Eight4aWish/eurorack_electronics/docs/analogue_board_journal/images/03_bus_chips_level_with_pins_outward.png

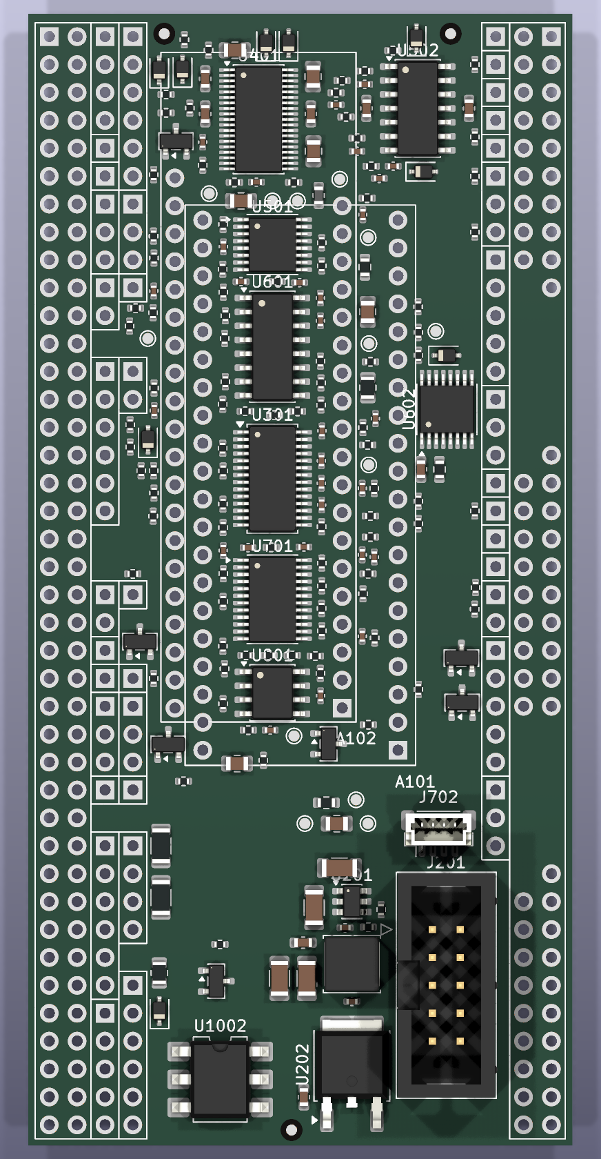
docs/analogue_board_journal/images/03_bus_chips_level_with_pins_outward.png
