Eight4aWish/eurorack_electronics/docs/analogue_board_bringup/holes_outward.png

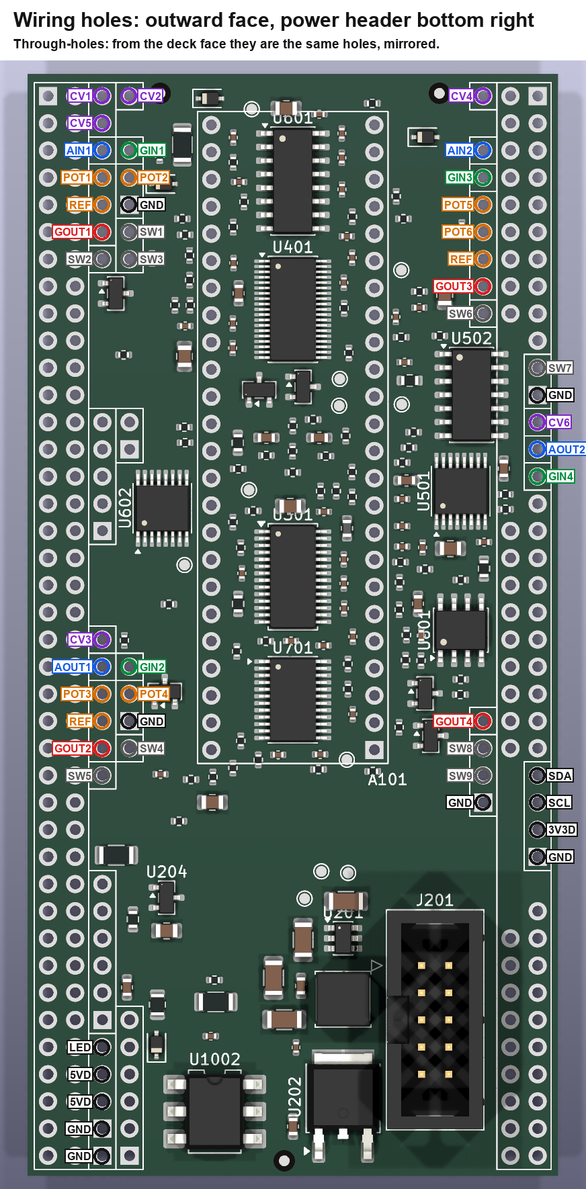
docs/analogue_board_bringup/holes_outward.png
