Eight4aWish/eurorack_electronics/hardware/analogue_board/pico_revb/output/checks.md

# Analogue board Rev B for Pico 2 / ESP32-P4: checkpoint 1 checks

Generated by `tools/analogue_board/build.py pico_revb`. Do not edit by hand.

| Check | Result |
|---|---|
| KiCad ERC | 0 errors, 0 warnings |
| Netlist against the generator's intent | 0 problems (272 nets, 1080 pins) |
| IC pins against datasheets | 0 mismatches in 21 parts |
| Footprint pads against symbol pins | 0 mismatches in 44 symbol/footprint pairs |
| Decoupling on every IC power pin | 0 pins without a capacitor, of 33 |
| Diode orientation | 0 to check, of 23 |
| Components | 361 |

## ERC

No violations.

## Netlist

Every pin KiCad sees is one the generator placed on purpose; every intended net is exactly one KiCad net; no two intended nets touch.

Nets drawn without a label (KiCad names them `Net-(…)`): /CV DAC/CVDAC1_N, /CV DAC/CVDAC2_N, /CV DAC/CVDAC3_N, /CV DAC/CVDAC4_N, /CV DAC/CVDAC5_N, /CV DAC/CVDAC6_N, /CV DAC/CVDAC7_N, /CV DAC/CVDAC7_OUT, /CV jacks & ADC/CV1_SW, /CV jacks & ADC/CV2_SW, /CV jacks & ADC/CV3_SW, /CV jacks & ADC/CV4_SW, /CV jacks & ADC/CV5_SW, /CV jacks & ADC/CV6_SW, /Codec & audio/AIN1_AC, /Codec & audio/AIN1_N, /Codec & audio/AIN1_OUT, /Codec & audio/AIN2_AC, /Codec & audio/AIN2_N, /Codec & audio/AIN2_OUT, /Codec & audio/AOUT1_N, /Codec & audio/AOUT1_NA, /Codec & audio/AOUT1_NB, /Codec & audio/AOUT1_OUT, /Codec & audio/AOUT1_P, /Codec & audio/AOUT2_N, /Codec & audio/AOUT2_NA, /Codec & audio/AOUT2_NB, /Codec & audio/AOUT2_OUT, /Codec & audio/AOUT2_P, /Gate ins/GIN1_CMP, /Gate ins/GIN2_CMP, /Gate ins/GIN3_CMP, /Gate ins/GIN4_CMP, /Power/BOOT, /Power/FB, /Power/FF, /Power/SW, /TRS MIDI/MIDI_DRV, /TRS MIDI/MIDI_LED_A, /TRS MIDI/MIDI_RING_MID, /TRS MIDI/MIDI_RXO, /TRS MIDI/MIDI_TIP_MID, /TRS MIDI/MIDI_TXB.

## IC pins against datasheets

Library pin numbers and names compared with `datasheet_pins.json` (transcribed from each datasheet; sources in `datasheet_pins_README.md`). Renames are pins whose datasheet and library spellings differ but mean the same pin.

| Part | Library symbol | Datasheet entry | Pins | Result | Notes |
|---|---|---|---|---|---|
| PCM3060 | `Audio:PCM3060` | PCM3060PWR | 28 | OK | 27 MS/ADR/IFMD→~{MS}/AD/IFMD |
| ADS8688 | `Analog_ADC:ADS8688` | ADS8688IDBTR | 38 | OK | names match |
| DAC8568 | `analogue_board:DAC8568xPW` | DAC8568IAPWR | 16 | OK | names match |
| MCP3208 | `Analog_ADC:MCP3208` | MCP3208-CI/SL | 16 | OK | names match |
| DG412 | `Analog_Switch:DG412xUE` | DG412DQ-T1-E3 | 16 | OK | unit 1 = switch 1 (pins 2, 1, 3); unit 2 = switch 4 (pins 6, 8, 7); unit 3 = switch 3 (pins 10, 9, 11); unit 4 = switch 2 (pins 15, 16, 14) |
| TL074H | `Amplifier_Operational:TL074` | TL074HIDR | 14 | OK | names match |
| LM393 | `Comparator:LM393` | LM393DR2G | 8 | OK | names match |
| 74HCT595 | `74xx:74HCT595` | 74HCT595PW | 16 | OK | 14 DS→SER; 11 SHCP→SRCLK; 10 MR→~{SRCLR}; 12 STCP→RCLK; 15 Q0→QA; 1 Q1→QB; 2 Q2→QC; 3 Q3→QD; 4 Q4→QE; 5 Q5→QF; 6 Q6→QG; 7 Q7→QH; 9 Q7S→QH' |
| TCA9555 | `Interface_Expansion:TCA9555PWR` | TCA9555PWR | 24 | OK | names match |
| M24C64 | `Memory_EEPROM:M24C01-RMN` | M24C64-RMN6TP | 8 | OK | names match |
| AHCT1G125 | `74xGxx:74AHCT1G125` | SN74AHCT1G125DBVR | 5 | OK | names match |
| XC6206 | `Regulator_Linear:XC6206PxxxMR` | XC6206P332MR | 3 | OK | 3 VIN→VI; 1 VSS→GND; 2 VOUT→VO |
| L78M05 | `Regulator_Linear:LM78M05_TO252` | L78M05ABDT | 3 | OK | 1 INPUT→VI; 3 OUTPUT→VO |
| TPS54308 | `Regulator_Switching:TPS54202DDC` | TPS54308DDCR | 6 | OK | names match |
| BAT54S | `Diode:BAT54S` | BAT54S | 3 | OK | 1 anode (diode 1)→A; 3 cathode (diode 1) / anode (diode 2)→COM; 2 cathode (diode 2)→K |
| BAV99 | `Diode:BAT54S` | BAV99 | 3 | OK | 1 A1→A; 3 K1, A2→COM; 2 K2→K |
| QWIIC | `analogue_board:Qwiic_JST_SH4_Vertical` | SM04B-SRSS-TB | 6 | OK | 1 Circuit No.1→Pin_1; 2 Circuit 2→Pin_2; 3 Circuit 3→Pin_3; 4 Circuit 4→Pin_4 |
| PICO2 | `analogue_board:RaspberryPi_Pico2` | PICO2 | 40 | OK | 36 3V3→3V3_OUT |
| TEENSY41 | `analogue_board:Teensy41` | TEENSY41 | 48 | OK | 2 0→D0; 3 1→D1; 4 2→D2; 5 3→D3; 6 4→D4; 7 5→D5; 8 6→D6; 9 7→D7; 10 8→D8; 11 9→D9; 12 10→D10; 13 11→D11; 14 12→D12; 15 3.3V→3V3; 16 24→D24; 17 25→D25; 18 26→D26; 19 27→D27; 20 28→D28; 21 29→D29; 22 30→D30; 23 31→D31; 24 32→D32; 46 3.3V→3V3; 45 23→D23; 44 22→D22; 43 21→D21; 42 20→D20; 41 19→D19; 40 18→D18; 39 17→D17; 38 16→D16; 37 15→D15; 36 14→D14; 35 13→D13; 33 41→D41; 32 40→D40; 31 39→D39; 30 38→D38; 29 37→D37; 28 36→D36; 27 35→D35; 26 34→D34; 25 33→D33 |
| H11L1 | `Isolator:H11L1` | H11L1M | 6 | OK | names match |
| AO3401A | `Transistor_FET:AO3401A` | AO3401A | 3 | OK | names match |

## Footprint pads

| Symbol | Footprint | Result |
|---|---|---|
| analogue_board:RaspberryPi_Pico2 | analogue_board:Pico2_Socket | 40 pads match |
| Connector_Generic:Conn_01x02 | analogue_board:WiringHoles_1x02_G2 | 2 pads match |
| Connector_Generic:Conn_01x02 | analogue_board:WiringHoles_1x02 | 2 pads match |
| Device:C_Small | Capacitor_SMD:C_1206_3216Metric | 2 pads match |
| Device:C_Small | Capacitor_SMD:C_0603_1608Metric | 2 pads match |
| Device:C_Small | Capacitor_SMD:C_0402_1005Metric | 2 pads match |
| Device:C_Small | Capacitor_SMD:C_0805_2012Metric | 2 pads match |
| Diode:SS34 | Diode_SMD:D_SMA | 2 pads match |
| Device:FerriteBead_Small | Inductor_SMD:L_0603_1608Metric | 2 pads match |
| Connector_Generic:Conn_02x05_Odd_Even | Connector_IDC:IDC-Header_2x05_P2.54mm_Vertical | 10 pads match |
| Jumper:SolderJumper_2_Open | Jumper:SolderJumper-2_P1.3mm_Open_RoundedPad1.0x1.5mm | 2 pads match |
| Device:L_Small | Inductor_SMD:L_Sunlord_SWPA5040S | 2 pads match |
| Transistor_FET:AO3401A | Package_TO_SOT_SMD:SOT-23 | 3 pads match |
| Device:R_Small | Resistor_SMD:R_0603_1608Metric | 2 pads match |
| Device:R_Small | Resistor_SMD:R_0402_1005Metric | 2 pads match |
| Device:R_Small | Resistor_SMD:R_0805_2012Metric | 2 pads match |
| Connector:TestPoint | TestPoint:TestPoint_Pad_D1.0mm | 1 pads match |
| Regulator_Switching:TPS54202DDC | Package_TO_SOT_SMD:SOT-23-6 | 6 pads match |
| Regulator_Linear:LM78M05_TO252 | analogue_board:TO-252-2_PasteShapes | 3 pads match |
| Regulator_Linear:XC6206PxxxMR | Package_TO_SOT_SMD:SOT-23 | 3 pads match |
| Diode:BAT54S | Package_TO_SOT_SMD:SOT-23 | 3 pads match |
| Connector_Generic:Conn_01x01 | analogue_board:WiringHoles_1x01 | 1 pads match |
| Connector_Generic:Conn_01x01 | analogue_board:WiringHoles_1x01_G1 | 1 pads match |
| Device:R_Small | Resistor_SMD:R_1206_3216Metric | 2 pads match |
| Audio:PCM3060 | Package_SO:TSSOP-28_4.4x9.7mm_P0.65mm | 28 pads match |
| Amplifier_Operational:TL074 | Package_SO:SOIC-14_3.9x8.7mm_P1.27mm | 14 pads match |
| Device:D_TVS | Diode_SMD:D_SOD-323 | 2 pads match |
| Analog_ADC:ADS8688 | Package_SO:TSSOP-38_4.4x9.7mm_P0.5mm | 38 pads match |
| Analog_Switch:DG412xUE | Package_SO:TSSOP-16_4.4x5mm_P0.65mm | 16 pads match |
| analogue_board:DAC8568xPW | Package_SO:TSSOP-16_4.4x5mm_P0.65mm | 16 pads match |
| Analog_ADC:MCP3208 | Package_SO:SOIC-16_3.9x9.9mm_P1.27mm | 16 pads match |
| 74xx:74HCT595 | Package_SO:TSSOP-16_4.4x5mm_P0.65mm | 16 pads match |
| Connector_Generic:Conn_01x04 | analogue_board:WiringHoles_1x04_G4 | 4 pads match |
| Connector_Generic:Conn_01x05 | analogue_board:WiringHoles_1x05_G4_5 | 5 pads match |
| Interface_Expansion:TCA9555PWR | Package_SO:TSSOP-24_4.4x7.8mm_P0.65mm | 24 pads match |
| Memory_EEPROM:M24C01-RMN | Package_SO:SOIC-8_3.9x4.9mm_P1.27mm | 8 pads match |
| 74xGxx:74AHCT1G125 | Package_TO_SOT_SMD:SOT-23-5 | 5 pads match |
| Comparator:LM393 | Package_SO:SOIC-8_3.9x4.9mm_P1.27mm | 8 pads match |
| Mechanical:Fiducial | Fiducial:Fiducial_1mm_Mask2mm | 0 pads match |
| analogue_board:EdgeStrip_Left_10HP | analogue_board:EdgeStrip_40_Left_10HP | 57 pads match |
| analogue_board:EdgeStrip_Right | analogue_board:EdgeStrip_40_Right | 57 pads match |
| Diode:1N4148WS | Diode_SMD:D_SOD-323 | 2 pads match |
| Connector_Generic:Conn_01x03 | analogue_board:WiringHoles_1x03 | 3 pads match |
| Isolator:H11L1 | Package_DIP:SMDIP-6_W9.53mm | 6 pads match |

## Decoupling

| Ref | Part | Pin | Net | Capacitors |
|---|---|---|---|---|
| A101 | Raspberry Pi Pico 2 | 39 VSYS | MOD_5V | C222 10u 25V |
| U1001 | SN74AHCT1G125DBVR | 5 VCC | +5VD | C1001 100n 16V |
| U1002 | H11L1SR2M | 6 ~ | +3V3D | C1002 100n 16V |
| U201 | TPS54308DDCR | 3 VIN | /Power/BUCK_VIN | C205 10u 50V, C206 10u 50V, C207 100n 50V |
| U202 | L78M05ABDT-TR | 1 VI | +12V | C214 1u 50V, C215 100n 50V |
| U203 | XC6206P332MR-G | 3 VI | +5VA | C218 1u 25V |
| U204 | XC6206P332MR-G | 3 VI | +5VD | C220 1u 25V |
| U301 | PCM3060PWR | 7 V_{DD} | /Codec & audio/CODEC_VDD | C303 10u 25V, C304 100n 16V |
| U301 | PCM3060PWR | 24 V_{CC} | /Codec & audio/CODEC_VCC | C301 10u 25V, C302 100n 16V |
| U302 | TL074HIDR | 4 V+ | +12V | C319 100n 50V |
| U302 | TL074HIDR | 11 V- | -12V | C320 100n 50V |
| U401 | ADS8688IDBTR | 9 AVDD | +5VA | C401 1u 50V |
| U401 | ADS8688IDBTR | 30 AVDD | +5VA | C402 1u 50V |
| U401 | ADS8688IDBTR | 34 DVDD | +3V3D | C404 10u 25V, C405 100n 16V |
| U402 | DG412DQ-T1-E3 | 13 V+ | +12V | C416 100n 50V |
| U402 | DG412DQ-T1-E3 | 12 VL | +5VD | C418 100n 16V |
| U402 | DG412DQ-T1-E3 | 4 V- | -12V | C417 100n 50V |
| U403 | DG412DQ-T1-E3 | 13 V+ | +12V | C419 100n 50V |
| U403 | DG412DQ-T1-E3 | 12 VL | +5VD | C421 100n 16V |
| U403 | DG412DQ-T1-E3 | 4 V- | -12V | C420 100n 50V |
| U501 | DAC8568IAPWR | 3 AVDD | +3V3A | C501 10u 25V, C502 100n 16V |
| U502 | TL074HIDR | 4 V+ | +12V | C512 100n 50V |
| U502 | TL074HIDR | 11 V- | -12V | C513 100n 50V |
| U504 | TL074HIDR | 4 V+ | +12V | C514 100n 50V |
| U504 | TL074HIDR | 11 V- | -12V | C515 100n 50V |
| U601 | MCP3208-CI/SL | 15 Vref | /Pots & gate outs/POT_REF | C603 10u 25V, C604 100n 16V |
| U601 | MCP3208-CI/SL | 16 Vdd | +3V3A | C601 1u 25V, C602 100n 16V |
| U602 | 74HCT595PW | 16 VCC | +5VD | C611 100n 16V |
| U701 | TCA9555PWR | 24 VCC | +3V3D | C701 100n 16V |
| U702 | M24C64-RMN6TP | 8 VCC | +3V3D | C708 100n 16V |
| U703 | SN74AHCT1G125DBVR | 5 VCC | +5VD | C709 100n 16V |
| U801 | LM393DR2G | 8 V+ | +12V | C801 100n 50V |
| U802 | LM393DR2G | 8 V+ | +12V | C802 100n 50V |

## Diode orientation

| Ref | Part | Pin: net | Rule | Result |
|---|---|---|---|---|
| D1001 | BAT54S | 1: GND, 2: +5VD, 3: Net-(D1001-COM) | BAT54S clamp: anode (1) to GND, cathode (2) to a positive rail, common (3) on the signal | OK |
| D1002 | 1N4148WS | 1: Net-(D1002-K), 2: /TRS MIDI/MI_T | reverse-parallel across the H11L1 LED: cathode on its anode (pin 1), anode on its cathode (pin 2) | OK |
| D201 | SS34 | 1: /Power/+12V_P, 2: /Power/+12V_IN | +12 V reverse-polarity: anode at the header | OK |
| D202 | SS34 | 1: /Power/-12V_IN, 2: /Power/-12V_P | -12 V reverse-polarity: cathode at the header | OK |
| D203 | SS34 | 1: MOD_5V, 2: +5VD | module supply: anode on +5VD, cathode to VSYS/VIN | OK |
| D301 | BAT54S | 1: GND, 2: +5VA, 3: /Codec & audio/VINL | BAT54S clamp: anode (1) to GND, cathode (2) to a positive rail, common (3) on the signal | OK |
| D302 | BAT54S | 1: GND, 2: +5VA, 3: /Codec & audio/VINR | BAT54S clamp: anode (1) to GND, cathode (2) to a positive rail, common (3) on the signal | OK |
| D401 | PESD15VL1BA | 1: GND, 2: /CV jacks & ADC/CV1 | bidirectional TVS: one side on a CV jack, the other on GND | OK |
| D402 | PESD15VL1BA | 1: GND, 2: /CV jacks & ADC/CV2 | bidirectional TVS: one side on a CV jack, the other on GND | OK |
| D403 | PESD15VL1BA | 1: GND, 2: /CV jacks & ADC/CV3 | bidirectional TVS: one side on a CV jack, the other on GND | OK |
| D404 | PESD15VL1BA | 1: GND, 2: /CV jacks & ADC/CV4 | bidirectional TVS: one side on a CV jack, the other on GND | OK |
| D405 | PESD15VL1BA | 1: GND, 2: /CV jacks & ADC/CV5 | bidirectional TVS: one side on a CV jack, the other on GND | OK |
| D406 | PESD15VL1BA | 1: GND, 2: /CV jacks & ADC/CV6 | bidirectional TVS: one side on a CV jack, the other on GND | OK |
| D407 | PESD15VL1BA | 1: GND, 2: /CV jacks & ADC/CVI7 | bidirectional TVS: one side on a CV jack, the other on GND | OK |
| D601 | BAV99 | 1: GND, 2: +5VD, 3: /Pots & gate outs/GOUT1 | BAV99 clamp: anode (1) to GND, cathode (2) to a positive rail, common (3) on the signal | OK |
| D602 | BAV99 | 1: GND, 2: +5VD, 3: /Pots & gate outs/GOUT2 | BAV99 clamp: anode (1) to GND, cathode (2) to a positive rail, common (3) on the signal | OK |
| D603 | BAV99 | 1: GND, 2: +5VD, 3: /Pots & gate outs/GOUT3 | BAV99 clamp: anode (1) to GND, cathode (2) to a positive rail, common (3) on the signal | OK |
| D604 | BAV99 | 1: GND, 2: +5VD, 3: /Pots & gate outs/GOUT4 | BAV99 clamp: anode (1) to GND, cathode (2) to a positive rail, common (3) on the signal | OK |
| D801 | BAT54S | 1: GND, 2: +3V3D, 3: Net-(D801-COM) | BAT54S clamp: anode (1) to GND, cathode (2) to a positive rail, common (3) on the signal | OK |
| D802 | BAT54S | 1: GND, 2: +3V3D, 3: Net-(D802-COM) | BAT54S clamp: anode (1) to GND, cathode (2) to a positive rail, common (3) on the signal | OK |
| D803 | BAT54S | 1: GND, 2: +3V3D, 3: Net-(D803-COM) | BAT54S clamp: anode (1) to GND, cathode (2) to a positive rail, common (3) on the signal | OK |
| D804 | BAT54S | 1: GND, 2: +3V3D, 3: Net-(D804-COM) | BAT54S clamp: anode (1) to GND, cathode (2) to a positive rail, common (3) on the signal | OK |
| Q201 | AO3401A | 1: PICO_VBUS, 2: MOD_5V, 3: +5VD | MOD_5V bypass: drain on +5VD, source on MOD_5V, gate on PICO_VBUS (body diode +5VD → MOD_5V) | OK |
