Eight4aWish/eurorack_electronics/docs/n8synth_platform.md

# n8synth Platform — Verified Reference

**The single source of truth for how the n8synth solderable breadboard and control decks
actually work.** Every claim below carries its evidence. Nothing here may be "re-derived" from
the `.n8layout` templates or the generated board profiles — those are *downstream* of this
document, and where they disagree, this document wins.

**Why this exists:** the row-count question was got wrong three times in a row by reasoning from
template geometry. The templates describe a *drawing*, not the electrical reality, and the
generated profiles hardcode assumptions that were never verified. See "Provenance" at the foot.

---

## Anatomy of a board, outside in

Working inward from either edge:

| # | Feature | Positions | Electrical behaviour |
|---|---|---|---|
| 1 | **Edge connector** | 1–40 | Two adjacent columns of holes. **Each position is a doublet — the two holes are joined to each other**, and to nothing else. |
| 2 | **Power rail** | 1–40 | Single column. **Odd = GND, even = supply.** |
| 3 | **Main area** | see variants | 5 columns. The 5 holes in a row are joined. |

**The left and right main areas are NOT joined to each other.** A row is really two independent
5-hole nodes with a gap between them.

**Power rail polarity:** numbering rows top to bottom, position 1 is GND and position 2 is
**+12V on the left-hand column** and **−12V on the corresponding right-hand column**. So:

- `pwrL` — odd = GND, even = **+12V**
- `pwrR` — odd = GND, even = **−12V**

---

## Two board variants

| | Main-area rows | Power conditioning |
|---|---|---|
| **With power section** | **1–36**, 5 columns left + 5 columns right | Yes |
| **Without** | **1–40**, 5 columns left + 5 columns right | No |

**The power conditioning is 100nF + 10µF-or-larger on each rail.**

- The **100nF caps consume no positions** — they take nothing away from anything described above.
- The **10µF+ electrolytics occupy power-rail positions 37 and 38.**
- **Power-rail positions 39 and 40 remain free**, as do 1 and 2.

⚠️ The 4HP, 6HP and 10HP templates all model the **powered** variant (36 main-area rows). The
10HPS template ships two boards — one powered (36 rows) and one plain (40 rows) — which is why
it contains 76 row zones.

## What the board already provides — do not duplicate it

On a **powered** board the ±12V rails arrive already conditioned: **100nF + 10µF-or-larger on
each rail**. Any module design transcribed from a standalone Eurorack PCB will carry its *own*
rail-entry conditioning, which is then duplicated.

**Drop on transfer:**

- **Rail-entry bulk electrolytics** (typically 47µF or 10µF on VCC and VEE). The board's own
  10µF+ at power-rail positions 37–38 does this job.
- **Rail-entry 100nF bypass**, where the design has one per rail *at the power connector*.

**Never drop:**

- **Per-IC decoupling** — the 100nF sitting at each op-amp's pin 8 / pin 4. The board's single
  bypass at the power entry is not a substitute, and on a breadboard, where wiring inductance is
  far worse than on a PCB, local decoupling matters **more**, not less.
- **Reverse-polarity protection diodes.** The board provides capacitors only — no protection.
- **Series rail filtering** (a small series resistor on each rail), which is a
  different function and doubles as a slow-blow fuse.
- **Regulator conditioning** for anything generated on-board (e.g. a 7805's own input/output
  caps), and decoupling on rails the board does not supply.

⚠️ If a bench test later shows ripple on a long run, adding one bulk cap back near the ICs is a
two-second job on a breadboard. Removing is the low-risk direction.

### Applied to the current dataset

| Build | Duplicated — droppable | Keep |
|---|---|---|
| **MOD2** | C5, C6 (10µF rail bulk) | C7–C10 are per-IC, one per TL072 per rail |
| Dual LPG | C1, C2 (47µF rail bulk) | C3–C10 — already annotated "near IC pin 8/4" |

Only MOD2 has been changed. Apply the same reading to any other design when transferring it:
drop the rail-entry bulk and any entry-point bypass, keep everything per-IC, keep protection
diodes, and keep any series rail filtering.

---

## Naming the two holes of a doublet

Each edge-connector position has **two holes, joined to each other and to nothing else**. Both
are usable, and using both is normal — typically a wire from the panel in one and a component
leg in the other, which is how a panel signal reaches the circuit.

**Convention:**

| Name | Meaning |
|---|---|
| `ctrlLo5` | left edge connector, position 5, **outer** hole (nearer the board edge) |
| `ctrlLi5` | left edge connector, position 5, **inner** hole (nearer the power rail) |
| `ctrlRo5` / `ctrlRi5` | the same for the right edge connector |
| `ctrlL5` / `ctrlR5` | the position, **hole unspecified** — use when it does not matter |

Outer and inner are defined geometrically, so they mean the same thing on either edge
regardless of orientation.

**Two occupants at one position is correct, not a collision.** A collision is two things in the
*same hole*. Any checker must key on the hole, not the position — otherwise every panel
connection that feeds a component looks like an error.

In the dual LPG as documented, **16 of its 32 occupied control-lane positions carry two
things** — a `jpsWire` from the panel plus a component leg — and the rest carry one, leaving a
spare hole that is available for routing.

### Which column does what ✓

| Column | Use |
|---|---|
| **Outer** | **Control deck → first circuit board.** The main deck connection. |
| **Inner** | Smaller headers jumping to a **second circuit board stacked over the first**. |

**A spare doublet has no deck connection at all.** Only positions where a JPS cell terminates
are wired to the control deck. Every other position is an **electrically isolated pair of joined
holes** — nothing else. Using one to jump a signal across or under the board gives you a **tie
point, not a deck connection**.

That is what makes them safe to repurpose, and it is also a rule for any checker: **do not
assume a control-lane position carries a panel net.** Claimed positions do; spare ones carry
only whatever the things plugged into them make. How many are spare depends on the deck's HP —
a 6HP deck claims 36 of 40 positions, a 4HP deck only 18, leaving 22 free.

**Consequence for a single-board module: the inner column is free.** That is the spare capacity
behind the repurposing technique — jump a component leg into an inner hole and route a wire up
or down the board on the back, where both columns are tinned.

So on a single-board build, a control-lane position typically holds the deck connection in its
**outer** hole and, where used, a component leg in its **inner** hole.

---

## Which edge connector to use

**4HP and 6HP designs use one edge connector — by convention the LEFT.** Either edge works, but
**not both**. 10HP designs use both.

---

## Stacking, and how signals actually get between boards

Stacking is for designs that outgrow a single board — in practice 10HP modules.

**Signals can pass between stacked boards** via dedicated stacking connectors. However, those
connectors are **awkward to work with in practice**.

**The technique actually used:** fit **1-to-6-way pin headers on the inside of the connector
rails** and jump the signals along the chain — control deck → first board → second board. The
edge connector is a doublet, so the inner hole of each position is available for exactly this
while the outer hole carries the deck connection.

Power between stacked boards is jumped separately, using power-rail positions 1, 2, 39 and 40.

---

### Positions 1, 2, 39, 40 on the power columns

These are reserved *only* for **jumping power between stacked boards** — needed when a design
outgrows one board (e.g. two stacked 10HP circuit boards).

**For a single-board module they are free to use.** Position 39 (GND) is particularly useful for
grounding something near the bottom of the board.

---

## How control decks connect

**JPS cell pads A, B and C terminate on the outermost columns — the edge connector.** They do
**not** land on main-area rows.

This is the point most easily got wrong. A JPS cell occupies *connector positions*, not
tie-point rows. Getting a panel component's signal into the circuit means running a wire from
its edge-connector doublet to wherever you want it in the main area.

Consequences:

- **Edge positions 37–40 are perfectly usable on a powered board**, even though there is no
  main-area row at 37–40. They are edge-connector doublets like any other. On a powered board
  they sit conveniently close to free power-rail positions 39 and 40.
- Narrow modules use **one** edge connector; **10HP uses both**.
- **Unused edge-connector doublets are free tie points and can be repurposed.** Depending on the
  control deck's HP, a greater or lesser number of them connect to nothing. Jump a component
  leg into one and route a wire up or down the board — routinely used to keep a build tidy.

### Deck pads

- **Two contact points per A, B and C pad.**
- **Every cell also has a D pad, and all D pads across the deck are joined** — a deck-wide
  ground bus.
- **Grounding practice:** tie all the jack grounds to D, then run **one** wire from any grounded
  position back to ground. Any ground will do. Picking one toward the middle of the board leaves
  power-rail position 39 free for grounding something toward the bottom.

---

## What the generated board profiles get wrong

`tools/visualizer/boards/*.json` is produced by `gen_board_profiles.py`, which hardcodes several
values. Against this document:

| Profile field | Status |
|---|---|
| `rows: 40` | ❌ **Wrong.** Conflates three different things. Powered boards have **36 main-area rows**; edge connector and power rail have **40 positions**. |
| `layoutRows: [1, 36]` | ✅ Correct for powered boards — but the name hides that it means *main-area rows only*. |
| `powerSectionRows: [37, 40]` | ❌ **Misleading.** Power-rail 37–38 hold the electrolytics; **39–40 are free**. Edge positions 37–40 are fully usable. |
| `rails` parity and polarity | ✅ **Correct.** |
| `holeCols` a–j, `centreGap` e/f | ✅ Correct — but must also record that left and right are not joined. |
| `padsPerCell {A:2, B:2, C:2, D:1}` | ✅ Correct. |
| edge connector is a **doublet** | ❌ **Missing entirely.** |
| unused doublets are repurposable | ❌ **Missing entirely.** |
| board variant (powered vs plain) | ❌ **Missing entirely.** |

---

## Provenance

**Primary source: the builder (David), 2026-08-28**, describing the physical boards in hand.
This supersedes anything inferred from the `.n8layout` templates.

Independently corroborated where possible:

- Edge connector as two joined columns — `left-edge-conn` in `6HP_Template.n8layout` has two
  hole columns (x = 0.15, 2.69) and each `ec-pad-N` carries two holes per connector ✓
- Rail parity — template zones are named `pr-neg-{odd}` / `pr-pos-{even}`; the n8synth overview
  diagram states *"compact power rails with alternating supply and GND connections"* and its
  colour key marks the left rail +12V, right rail −12V ✓
- 36 vs 40 rows — the overview diagram shows "Bread & Butter A1" numbered 1–36 with a power
  section, and "Bread & Butter B1" numbered 1–40 without ✓
- Main area 5 + 5 with a gap — each `row-N` group holds 10 holes at 2.54mm pitch with a 7.62mm
  gap between the 5th and 6th ✓
- Deck D bus — 6HP quick-start guide: *"the D bus … a common ground on the Control Deck"* ✓
- Cell numbering row-major, odd left / even right — annotated control-deck diagram ✓

**Unverified, still open:**

- Whether a stacked board is conventionally mounted flipped (left/right swapped) so components
  face outward for probing. `gen_board_profiles.py` asserts this; not re-checked here.
