Eight4aWish/eurorack_electronics/docs/analogue_board_review/power.md

# Power block review: analogue board Rev A, checkpoint 1

Reviewed 2026-10-15 against `tools/analogue_board/design.py` (`sheet_power`), `parts.py`, the
generated netlist `hardware/analogue_board/output/analogue_board.net`, schematic page 2, and
spec §2, §4, §5, §8–§10, §15.

**Marks:** **[unverified]** = not confirmed against a primary source in this review.
**[est.]** = my own arithmetic from datasheet figures. **[sub-agent]** = values read from the
file by a sub-agent and not re-read by me; spot checks are noted where I did them.

**Verdict:** the block is sound. Nothing found would stop a board working on the first power-up
with a Pico 2 or Teensy 4.1, so there are **no A findings**. Five B changes are worth making
before the order. All five use Basic parts, add no Extended fee, and cost under $0.50 a board:
1. Give the buck its own ferrite and input capacitance.
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
