Eight4aWish/eurorack_electronics/docs/schematics/phase1_channel.png

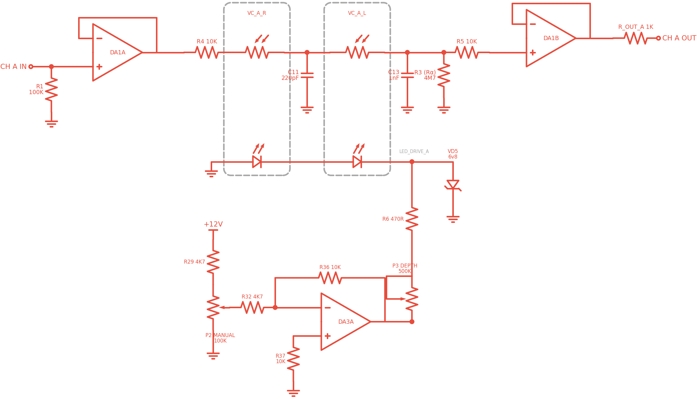
docs/schematics/phase1_channel.png
