Eight4aWish/eurorack_electronics/docs/schematics/phase2_channel.png

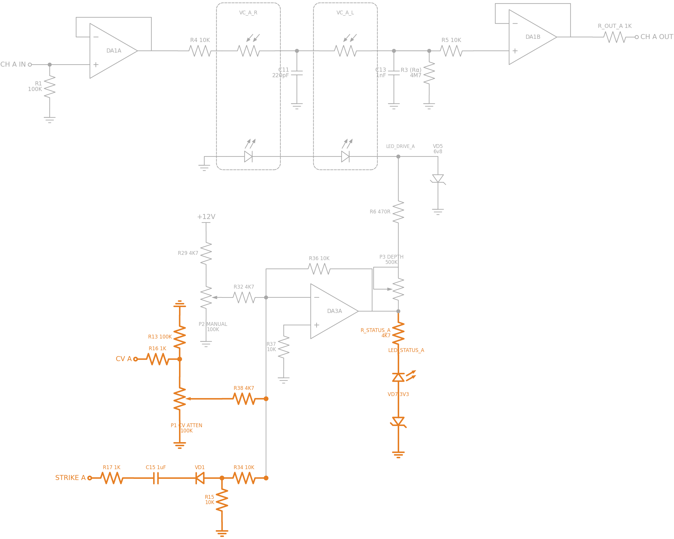
docs/schematics/phase2_channel.png
