Eight4aWish/eurorack_electronics/docs/schematics/phase5_mix.png

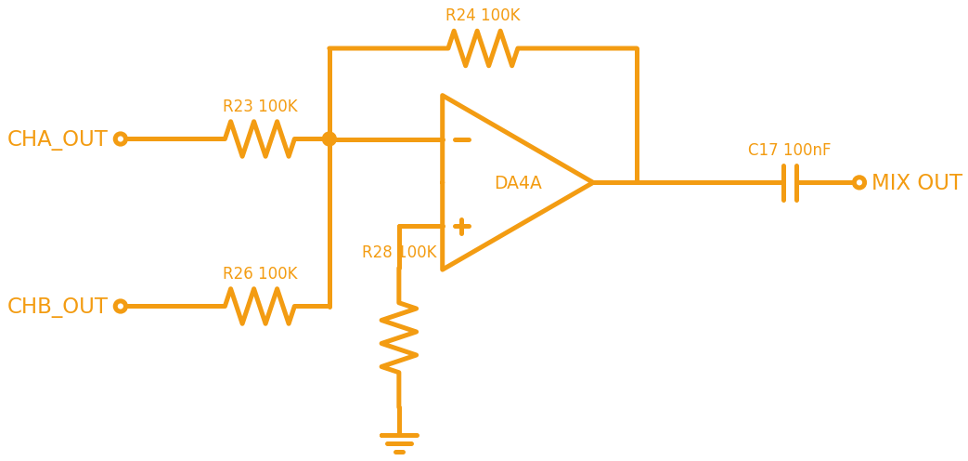
docs/schematics/phase5_mix.png
