Eight4aWish/eurorack_electronics/hardware/analogue_board/pico_core_midi/routed_trial/routed_deck_face.png

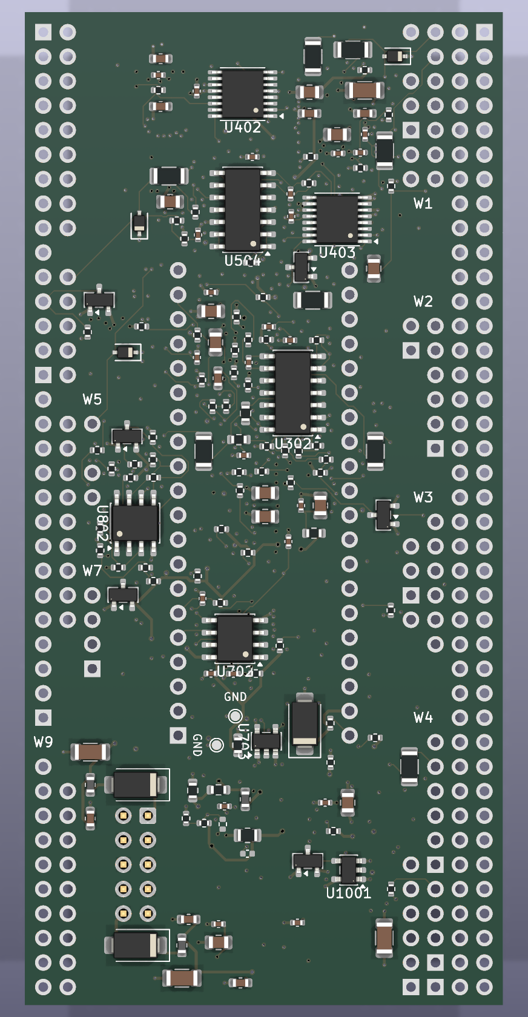
hardware/analogue_board/pico_core_midi/routed_trial/routed_deck_face.png
