Eight4aWish/eurorack_electronics/hardware/analogue_board/pico_revb/output/placement_outward_face.png

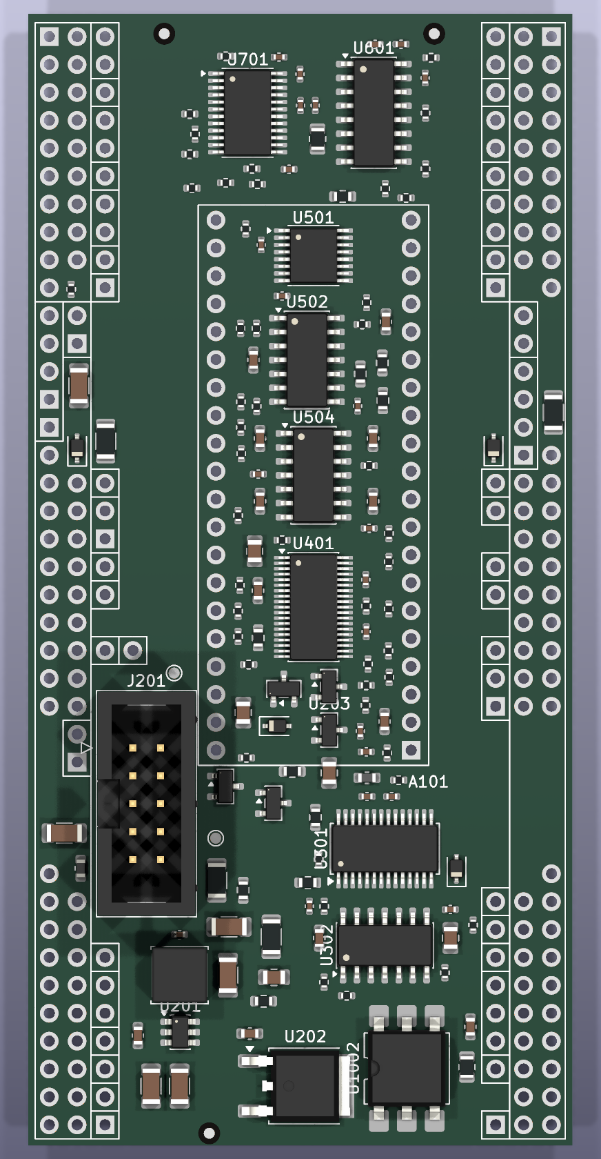
hardware/analogue_board/pico_revb/output/placement_outward_face.png
