Eight4aWish/eurorack_electronics/hardware/analogue_board/shared_core/routed_trial/routed_deck_face.png

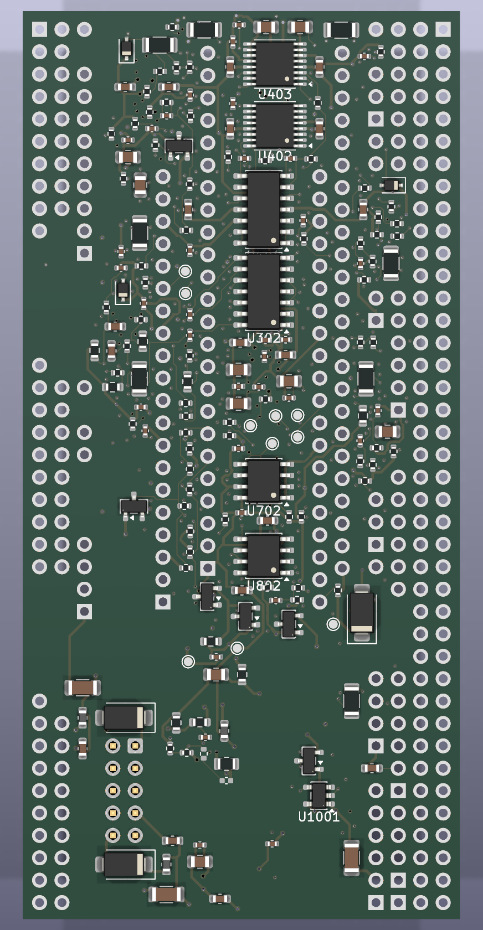
hardware/analogue_board/shared_core/routed_trial/routed_deck_face.png
