Eight4aWish/eurorack_electronics/hardware/analogue_board/output/analogue_board_bom.csv

Refs | Value | Footprint | LCSC | MPN | JLC | Qty
A101 | Raspberry Pi Pico 2 | analogue_board:Pico2_Socket |  | SC1631 on 2x20 female headers | hand-soldered | 1
A102 | Teensy 4.1 | analogue_board:Teensy41_Socket |  | PJRC Teensy 4.1 on 2x24 female headers | hand-soldered | 1
C201,C203,C205,C206 | 10u 50V | Capacitor_SMD:C_1206_3216Metric | C13585 |  | Basic | 4
C202,C204,C207,C215,C319,C320,C417,C418,C420,C421,C513-C518,C801,C802,C1003 | 100n 50V | Capacitor_SMD:C_0603_1608Metric | C14663 |  | Basic | 19
C208,C212,C217,C302,C304,C306,C309,C312,C405,C419,C422,C502,C602,C604-C613,C701-C705,C710-C712,C803,C1001,C1002 | 100n 16V | Capacitor_SMD:C_0402_1005Metric | C1525 |  | Basic | 34
C210,C211,C407 | 22u 25V | Capacitor_SMD:C_1206_3216Metric | C12891 |  | Basic | 3
C213,C216,C219,C221,C222,C301,C303,C305,C403,C404,C408,C501,C603 | 10u 25V | Capacitor_SMD:C_0805_2012Metric | C15850 |  | Basic | 13
C214,C401,C402,C406 | 1u 50V | Capacitor_SMD:C_0603_1608Metric | C15849 |  | Basic | 4
C218,C220,C503,C601 | 1u 25V | Capacitor_SMD:C_0402_1005Metric | C52923 |  | Basic | 4
C307,C310,C313,C314,C316,C317,C505-C512 | 100p 50V | Capacitor_SMD:C_0402_1005Metric | C1546 |  | Basic | 14
C308,C311 | 1u 50V | Capacitor_SMD:C_0805_2012Metric | C28323 |  | Basic | 2
C315,C318 | 1n C0G 50V | Capacitor_SMD:C_0603_1608Metric | C106246 |  | Extended | 2
C409-C416,C504 | 1n 50V | Capacitor_SMD:C_0402_1005Metric | C1523 |  | Basic | 9
C706-C709 | 10n 50V | Capacitor_SMD:C_0402_1005Metric | C15195 |  | Basic | 4
C713 | 47u 10V | Capacitor_SMD:C_1206_3216Metric | C96123 |  | Basic | 1
D201-D203 | SS34 | Diode_SMD:D_SMA | C8678 | SS34 | Basic | 3
D301,D302,D801-D805,D1001 | BAT54S | Package_TO_SOT_SMD:SOT-23 | C408389 | BAT54S | Extended | 8
D401-D408 | PESD15VL1BA | Diode_SMD:D_SOD-323 | C85378 | PESD15VL1BA,115 | Extended | 8
D601-D608 | BAV99 | Package_TO_SOT_SMD:SOT-23 | C2500 | BAV99,215 | Basic | 8
D1002 | 1N4148WS | Diode_SMD:D_SOD-323 | C2128 | 1N4148WS | Basic | 1
FB201-FB203,FB301 | BLM18PG121 | Inductor_SMD:L_0603_1608Metric | C14709 | BLM18PG121SN1D | Basic | 4
J201 | Eurorack power 2x5 shrouded | Connector_IDC:IDC-Header_2x05_P2.54mm_Vertical |  | 2x5 2.54 mm shrouded box header | hand-soldered | 1
J702 | Qwiic BM04B-SRSS-TB | Connector_JST:JST_SH_BM04B-SRSS-TB_1x04-1MP_P1.00mm_Vertical | C160390 | BM04B-SRSS-TB(LF)(SN) | Extended | 1
L201 | 15uH | Inductor_SMD:L_Sunlord_SWPA5040S | C44888 | SWPA5040S150MT | Extended | 1
Q201 | AO3401A | Package_TO_SOT_SMD:SOT-23 | C15127 | AO3401A | Basic | 1
R201 | 510k | Resistor_SMD:R_0603_1608Metric | C23192 |  | Basic | 1
R202 | 75k | Resistor_SMD:R_0603_1608Metric | C23242 |  | Basic | 1
R203,R307,R311 | 15k | Resistor_SMD:R_0402_1005Metric | C25756 |  | Basic | 3
R204 | 2k | Resistor_SMD:R_0402_1005Metric | C4109 |  | Basic | 1
R206 | 0R | Resistor_SMD:R_0805_2012Metric | C17477 |  | Basic | 1
R207-R209 | 0R | Resistor_SMD:R_0603_1608Metric | C21189 |  | Basic | 3
R210 | 680R | Resistor_SMD:R_0603_1608Metric | C23228 |  | Basic | 1
R211,R309,R313,R604,R606,R608,R610,R612,R614,R616,R618 | 1M | Resistor_SMD:R_0402_1005Metric | C26083 |  | Basic | 11
R212,R308,R312,R405,R409,R413,R417,R421,R425,R429,R431,R802,R803,R806,R807,R810,R811,R814,R815,R820-R829 | 100k | Resistor_SMD:R_0402_1005Metric | C25741 |  | Basic | 29
R301-R303,R401-R403,R501,R504,R506,R508,R510,R512,R514,R516,R519,R602,R619,R620,R701,R703,R705,R707,R709,R711,R713,R715,R717,R719,R801,R804,R805,R808,R809,R812,R813,R816-R818,R1002 | 10k | Resistor_SMD:R_0402_1005Metric | C25744 |  | Basic | 39
R304 | 5.1R | Resistor_SMD:R_0603_1608Metric | C25197 |  | Basic | 1
R305,R310,R314,R317,R318,R324,R325,R404,R408,R412,R416,R420,R424,R428,R430,R603,R605,R607,R609,R611,R613,R615,R617,R621-R628,R702,R704,R706,R708,R710,R712,R714,R716,R718,R819,R1001,R1008,R1009 | 1k | Resistor_SMD:R_0402_1005Metric | C11702 |  | Basic | 44
R306 | 220k | Resistor_SMD:R_0603_1608Metric | C22961 |  | Basic | 1
R315,R316,R322,R323,R502 | 12k | Resistor_SMD:R_0402_1005Metric | C25752 |  | Basic | 5
R319,R320,R326,R327 | 30k | Resistor_SMD:R_0603_1608Metric | C22984 |  | Basic | 4
R321,R328,R406,R410,R414,R418,R422,R426,R517,R520 | 1k | Resistor_SMD:R_1206_3216Metric | C4410 |  | Basic | 10
R407,R411,R415,R419,R423,R427 | 4.7k | Resistor_SMD:R_0402_1005Metric | C25900 |  | Basic | 6
R503,R830-R833 | 22k | Resistor_SMD:R_0402_1005Metric | C25768 |  | Basic | 5
R505,R507,R509,R511,R513,R515,R518,R521 | 33k | Resistor_SMD:R_0402_1005Metric | C25779 |  | Basic | 8
R601 | 100R | Resistor_SMD:R_0805_2012Metric | C17408 |  | Basic | 1
R720,R721 | 2.2k | Resistor_SMD:R_0402_1005Metric | C25879 |  | Basic | 2
R722 | 330R | Resistor_SMD:R_0402_1005Metric | C25104 |  | Basic | 1
R1003-R1006 | 100R | Resistor_SMD:R_1206_3216Metric | C17901 |  | Basic | 4
R1007 | 220R | Resistor_SMD:R_0805_2012Metric | C17557 |  | Basic | 1
U201 | TPS54308DDCR | Package_TO_SOT_SMD:SOT-23-6 | C168839 | TPS54308DDCR | Extended | 1
U202 | L78M05ABDT-TR | Package_TO_SOT_SMD:TO-252-2 | C58069 | L78M05ABDT-TR | Basic | 1
U203,U204 | XC6206P332MR-G | Package_TO_SOT_SMD:SOT-23 | C5446 | XC6206P332MR-G | Basic | 2
U301 | PCM3060PWR | Package_SO:TSSOP-28_4.4x9.7mm_P0.65mm | C2651841 | PCM3060PWR | Extended | 1
U302,U502-U504 | TL074HIDR | Package_SO:SOIC-14_3.9x8.7mm_P1.27mm | C2878713 | TL074HIDR | Extended | 4
U401 | ADS8688IDBTR | Package_SO:TSSOP-38_4.4x9.7mm_P0.5mm | C527390 | ADS8688IDBTR | Extended | 1
U402,U403 | DG412DQ-T1-E3 | Package_SO:TSSOP-16_4.4x5mm_P0.65mm | C2651920 | DG412DQ-T1-E3 | Extended | 2
U501 | DAC8568IAPWR | Package_SO:TSSOP-16_4.4x5mm_P0.65mm | C486051 | DAC8568IAPWR | Extended | 1
U601 | MCP3208-CI/SL | Package_SO:SOIC-16_3.9x9.9mm_P1.27mm | C16939 | MCP3208-CI/SL | Extended | 1
U602 | 74HCT595PW | Package_SO:TSSOP-16_4.4x5mm_P0.65mm | C99710 | 74HCT595PW,118 | Extended | 1
U701 | TCA9555PWR | Package_SO:TSSOP-24_4.4x7.8mm_P0.65mm | C465732 | TCA9555PWR | Extended | 1
U702 | M24C64-RMN6TP | Package_SO:SOIC-8_3.9x4.9mm_P1.27mm | C79988 | M24C64-RMN6TP | Extended (Preferred) | 1
U703,U1001 | SN74AHCT1G125DBVR | Package_TO_SOT_SMD:SOT-23-5 | C7484 | SN74AHCT1G125DBVR | Extended | 2
U801,U802 | LM393DR2G | Package_SO:SOIC-8_3.9x4.9mm_P1.27mm | C7955 | LM393DR2G | Basic | 2
U1002 | H11L1SR2M | Package_DIP:SMDIP-6_W7.62mm | C20082 | H11L1SR2M | Extended | 1
