Eight4aWish/eurorack_electronics/hardware/analogue_board/pico_revb/output/wiring_map.md

# Wiring map: Pico 2 / ESP32-P4

Generated by `tools/analogue_board/labels.py`. Each block's label (W1, W2 ...) is on the
board's silkscreen beside the block. Holes count in reading order: row by row from the
top, left column first. Ground holes are square. Rows are the edge strip positions.

## W1: rows 1-10, left side (label on the deck and outward faces)

| Hole | Column | Row | Signal |
|---|---|---|---|
| 1 | LO | 1 | POT_REF |
| 2 | LO | 2 | POT3 |
| 3 | LO | 3 | SW3 |
| 4 | LO | 4 | POT_REF |
| 5 | LO | 5 | POT5 |
| 6 | LO | 6 | SW5 |
| 7 | LO | 7 | POT_REF |
| 8 | LO | 8 | POT6 |
| 9 | LO | 9 | SW6 |
| 10 | LO | 10 | GND |

## W2: rows 17-21, left side (label on the deck and outward faces)

| Hole | Column | Row | Signal |
|---|---|---|---|
| 1 | LO | 17 | CV4 |
| 2 | LO | 18 | GOUT1 |
| 3 | LO | 19 | GND |
| 4 | LO | 20 | CV5 |
| 5 | LO | 21 | GOUT2 |

## W3: rows 23-23, left side (label on the deck and outward faces)

| Hole | Column | Row | Signal |
|---|---|---|---|
| 1 | LO | 23 | CV6 |
| 2 | LI | 23 | GOUT3 |

## W4: rows 34-40, left side (label on the deck and outward faces)

| Hole | Column | Row | Signal |
|---|---|---|---|
| 1 | LO | 34 | AOUT1 |
| 2 | LO | 35 | J1001.1 |
| 3 | LO | 36 | J1001.2 |
| 4 | LO | 37 | GOUT4 |
| 5 | LO | 38 | AOUT2 |
| 6 | LO | 39 | CVO7 |
| 7 | LO | 40 | GND |

## W5: rows 11-15, left strip (label on the deck and outward faces)

| Hole | Column | Row | Signal |
|---|---|---|---|
| 1 | LS | 11 | J704.1 |
| 2 | LSI | 11 | J303.1 |
| 3 | LS | 12 | J704.2 |
| 4 | LSI | 12 | J303.2 |
| 5 | LS | 13 | J704.3 |
| 6 | LS | 14 | J704.4 |
| 7 | LS | 15 | J704.5 |

## W6: rows 26-27, left strip (label on the deck and outward faces)

| Hole | Column | Row | Signal |
|---|---|---|---|
| 1 | LSI | 26 | J101.1 |
| 2 | LSI | 27 | J101.2 |

## W7: rows 1-10, right side (label on the deck and outward faces)

| Hole | Column | Row | Signal |
|---|---|---|---|
| 1 | R | 1 | POT_REF |
| 2 | R | 2 | POT1 |
| 3 | R | 3 | SW1 |
| 4 | R | 4 | POT_REF |
| 5 | R | 5 | POT2 |
| 6 | R | 6 | SW2 |
| 7 | R | 7 | POT_REF |
| 8 | R | 8 | POT4 |
| 9 | R | 9 | SW4 |
| 10 | R | 10 | GND |

## W8: rows 17-18, right side (label on the deck and outward faces)

| Hole | Column | Row | Signal |
|---|---|---|---|
| 1 | R | 17 | CV1 |
| 2 | R | 18 | GIN1 |

## W9: rows 20-21, right side (label on the deck and outward faces)

| Hole | Column | Row | Signal |
|---|---|---|---|
| 1 | R | 20 | CV2 |
| 2 | R | 21 | GIN2 |

## W10: rows 23-25, right side (label on the deck and outward faces)

| Hole | Column | Row | Signal |
|---|---|---|---|
| 1 | R | 23 | CV3 |
| 2 | R | 24 | GIN3 |
| 3 | R | 25 | GND |

## W11: rows 32-38, right side (label on the deck and outward faces)

| Hole | Column | Row | Signal |
|---|---|---|---|
| 1 | R | 32 | AIN1 |
| 2 | R | 33 | GIN4 |
| 3 | R | 34 | CVI7 |
| 4 | R | 35 | J1002.1 |
| 5 | R | 36 | J1002.2 |
| 6 | R | 37 | J1002.3 |
| 7 | R | 38 | AIN2 |

## W12: rows 40-40, right side (no room for a label)

| Hole | Column | Row | Signal |
|---|---|---|---|
| 1 | R | 40 | GND |

## W13: rows 11-16, right strip (label on the deck and outward faces)

| Hole | Column | Row | Signal |
|---|---|---|---|
| 1 | RSI | 11 | J102.1 |
| 2 | RSI | 12 | J102.2 |
| 3 | RSI | 13 | J703.1 |
| 4 | RSI | 14 | J703.2 |
| 5 | RSI | 15 | J703.3 |
| 6 | RSI | 16 | J703.4 |

## Test points

| Test point | Signal | Face | x, y (mm from the top left) | Labelled |
|---|---|---|---|---|
| TP201 | +12V | deck | 1.9, 73.8 | yes |
| TP202 | -12V | outward | 17.1, 75.1 | yes |
| TP205 | +5VD | deck | 22.0, 84.5 | yes |
| TP206 | +5VA | deck | 24.9, 81.9 | yes |
| TP207 | +3V3A | deck | 26.3, 16.3 | yes |
| TP208 | +3V3D | deck | 23.2, 93.3 | yes |
| TP209 | MOD_5V | outward | 13.3, 60.0 | yes |

Board marking (ANALOGUE BOARD REV B / EIGHT4AWISH / CC BY-SA 4.0): outward face, 1 line, turned, centred 38.8, 53.7 mm from the top left.
