Eight4aWish/eurorack_electronics/hardware/analogue_board/boards_printout.pdf

## Rev A: two boards, one module each, to lay real parts on

Outward face, seen from above. Each module is centred on its board; header and edge strips are the same on both.

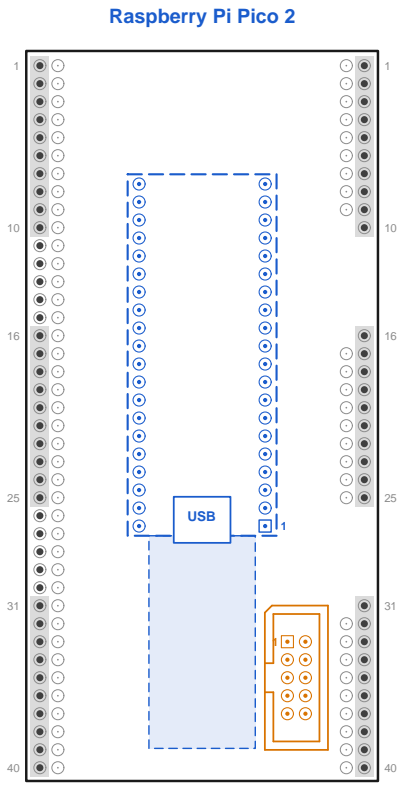
[picture p14: figure]
Raspberry Pi Pico 2; USB

Body 21 x 51 mm, far end 17.4 mm down (room for the P4).
USB edge at 68.4 mm; keep-out to 98.4 mm.

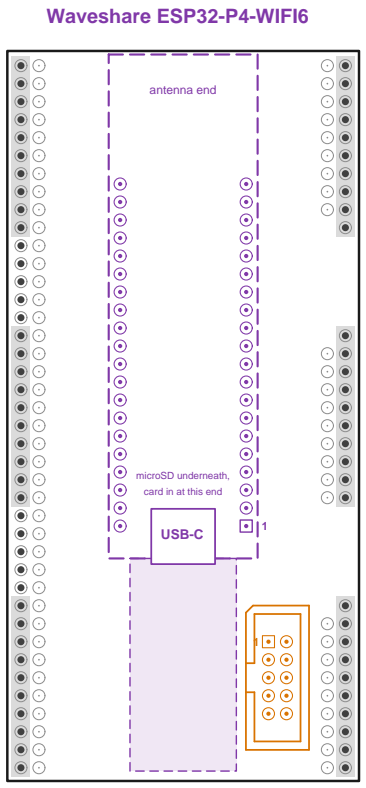
[picture p15: figure]
Waveshare ESP32-P4-WIFI6; USB-C; antenna end; microSD underneath, card in at this end

Body 21 x 71 mm in the Pico's holes. Far (antenna) end 0.5 mm from the top edge. USB-C edge at 71.6 mm; keep-out to 101.6 mm.
USB-C is serial only (CH343). Bridge JP201 when fitted.

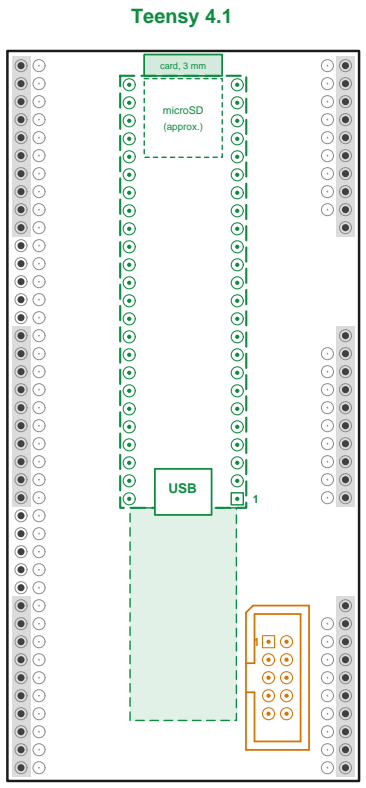
[picture p16: figure]
Teensy 4.1; USB; microSD (approx.); card, 3 mm

Body 17.8 x 61 mm, far end 3.5 mm down, so a microSD card (3 mm) ends 0.5 mm from the top edge. USB edge at 64.5 mm; keep-out to 94.5 mm.
All 48 holes: full-length headers. Centred: 3.8 mm right of the checkpoint 2 print.
Cut the VIN-VUSB pads first.

Laying the parts
- Face up, USB end down, pin 1 (the square hole) at the USB end. The pins should sit on the dots.
- The keep-out is where the plug goes when the module is up on its headers; anything in it taller than about 8 mm stops the plug. Try your real cables: a right-angle plug may need less room.
- The P4's microSD card goes in at the USB end, under the board, and is meant to stay in.
- Edge-strip numbers are on the left-hand board; the grey bands are the deck cells.
- The Pico 2 and the ESP32-P4 share one board (the first two outlines); the Teensy has its own.
0 | 50 | 100

This bar must measure 100 mm. If not, reprint at 100% / Actual size, with fit-to-page and scaling turned off.

Analogue boards Rev A. Generated by tools/analogue_board/printout.py from the KiCad footprints. Eight4aWish, CC BY-SA 4.0. Page 1 of 1
