Eight4aWish/eurorack_electronics/hardware/analogue_board/pico_core_midi/output/wiring_map.md

# Wiring map: Pico 2 / ESP32-P4, core set with MIDI

Generated by `tools/analogue_board/labels.py`. Each block's label (W1, W2 ...) is on the
board's silkscreen beside the block. Holes count in reading order: row by row from the
top, left column first. Ground holes are square. Rows are the edge strip positions.

## W1: rows 1-7, left side (label on the deck face)

| Hole | Column | Row | Signal |
|---|---|---|---|
| 1 | LO | 1 | CV1 |
| 2 | LI | 1 | CV2 |
| 3 | LO | 2 | CV5 |
| 4 | LO | 3 | AIN1 |
| 5 | LI | 3 | GIN1 |
| 6 | LO | 4 | POT1 |
| 7 | LI | 4 | POT2 |
| 8 | LO | 5 | POT_REF |
| 9 | LI | 5 | GND |
| 10 | LO | 6 | GOUT1 |
| 11 | LI | 6 | SW1 |
| 12 | LO | 7 | SW2 |
| 13 | LI | 7 | SW3 |

## W2: rows 13-18, left side (label on the deck and outward faces)

| Hole | Column | Row | Signal |
|---|---|---|---|
| 1 | LO | 13 | J101.1 |
| 2 | LI | 13 | J303.1 |
| 3 | LO | 14 | J101.2 |
| 4 | LI | 14 | J303.2 |
| 5 | LO | 15 | J101.3 |
| 6 | LO | 16 | J101.4 |
| 7 | LO | 17 | J101.5 |
| 8 | LO | 18 | J101.6 |

## W3: rows 21-26, left side (label on the deck and outward faces)

| Hole | Column | Row | Signal |
|---|---|---|---|
| 1 | LO | 21 | CV3 |
| 2 | LO | 22 | AOUT1 |
| 3 | LI | 22 | GIN2 |
| 4 | LO | 23 | POT3 |
| 5 | LI | 23 | POT4 |
| 6 | LO | 24 | POT_REF |
| 7 | LI | 24 | GND |
| 8 | LO | 25 | GOUT2 |
| 9 | LI | 25 | SW4 |
| 10 | LO | 26 | SW5 |

## W4: rows 30-40, left side (label on the deck and outward faces)

| Hole | Column | Row | Signal |
|---|---|---|---|
| 1 | LO | 30 | J1001.1 |
| 2 | LO | 31 | J1001.2 |
| 3 | LO | 32 | J1001.3 |
| 4 | LO | 33 | J1001.4 |
| 5 | LO | 34 | J1001.5 |
| 6 | LO | 35 | J1001.6 |
| 7 | LI | 35 | J603.1 |
| 8 | LO | 36 | J704.1 |
| 9 | LI | 36 | J603.2 |
| 10 | LO | 37 | J704.2 |
| 11 | LI | 37 | J603.3 |
| 12 | LO | 38 | J704.3 |
| 13 | LI | 38 | J603.4 |
| 14 | LO | 39 | J704.4 |
| 15 | LI | 39 | J603.5 |
| 16 | LO | 40 | J704.5 |
| 17 | LI | 40 | J603.6 |

## W5: rows 17-17, right side (label on the deck and outward faces)

| Hole | Column | Row | Signal |
|---|---|---|---|
| 1 | R | 17 | CV6 |

## W6: rows 19-20, right side (label on the no face)

| Hole | Column | Row | Signal |
|---|---|---|---|
| 1 | R | 19 | AOUT2 |
| 2 | R | 20 | GIN4 |

## W7: rows 24-27, right side (label on the deck and outward faces)

| Hole | Column | Row | Signal |
|---|---|---|---|
| 1 | R | 24 | GOUT4 |
| 2 | R | 25 | SW8 |
| 3 | R | 26 | SW9 |
| 4 | R | 27 | GND |

## W8: rows 11-15, right side (label on the no face)

| Hole | Column | Row | Signal |
|---|---|---|---|
| 1 | RSI | 11 | CV4 |
| 2 | RS | 11 | POT_REF |
| 3 | RSI | 12 | AIN2 |
| 4 | RS | 12 | GOUT3 |
| 5 | RSI | 13 | GIN3 |
| 6 | RS | 13 | SW6 |
| 7 | RSI | 14 | POT5 |
| 8 | RS | 14 | SW7 |
| 9 | RSI | 15 | POT6 |
| 10 | RS | 15 | GND |

## W9: rows 26-29, right side (label on the deck and outward faces)

| Hole | Column | Row | Signal |
|---|---|---|---|
| 1 | RS | 26 | J703.1 |
| 2 | RS | 27 | J703.2 |
| 3 | RS | 28 | J703.3 |
| 4 | RS | 29 | J703.4 |

## Test points

| Test point | Signal | Face | x, y (mm from the top left) | Labelled |
|---|---|---|---|---|
| TP201 | +12V | outward | 26.0, 76.5 | no room |
| TP202 | -12V | outward | 28.5, 74.7 | yes |
| TP203 | GND | deck | 29.8, 76.1 | yes |
| TP204 | GND | deck | 27.8, 73.1 | yes |
| TP205 | +5VD | outward | 23.5, 77.1 | yes |
| TP206 | +5VA | outward | 22.6, 15.1 | no room |
| TP207 | +3V3A | outward | 34.4, 23.6 | no room |
| TP208 | +3V3D | outward | 25.1, 72.6 | no room |
| TP209 | MOD_5V | outward | 18.5, 70.4 | no room |
