Eight4aWish/eurorack_electronics/docs/analogue_board_bringup.md

# Analogue board Rev A (Teensy 4.1): bring-up

The plan for the first of the two `teensy_core_midi` boards, from the box to a working
module. Written 2026-10-30, the day the boards arrived. Fill in the readings as you go; what
Rev A needed feeds [Rev B §7](analogue_board_revb.md#7-lessons-from-the-teensy-bring-up).

**Status, 2026-11-01: done for Boy** (built as Boy2). Every function Boy uses passed
on the built module.
For firmware, start from [the firmware notes](analogue_board_reva_firmware.md).

**The rule:** one stage at a time, and stop at the first reading that is off. Every stage
assumes the one before it passed.

**No bench supply.** A current-limited supply would catch a short before it heated anything.
Without one, two things stand in for it: the multimeter checks for shorts before power ever
goes on (stage 3), and the first power-on lasts three seconds (stage 4).

**Film it.** The unboxing, the first power-on and the first sound can't be re-shot for the
hardware video.

**The boards carry no readable labels**, so find things from these pictures, drawn on the
placement renders from the board file:
- test points on the [outward face](analogue_board_bringup/test_points_outward.png) and the
  [deck face](analogue_board_bringup/test_points_deck.png);
- the [wiring holes](analogue_board_bringup/holes_outward.png) the stage 6 blocks use;
- [MIDI](analogue_board_bringup/midi_outward.png): U1002's pin 1, the J101 links, the TRS holes.

## What you need

- Digital multimeter, the rack, and a known-good 10-pin Eurorack power ribbon.
- Soldering kit, flux, and a magnifier or a phone camera for close-ups.
- The hand-soldered parts. J201, A101 and J101 are yours by design (spec §2: you solder
  only headers, sockets and the deck wiring). U1002 is the one JLC left off.

  | Part | What | When |
  |---|---|---|
  | J201 | 2×5 shrouded Eurorack power header | Stage 2, before any power |
  | A101 | Female headers for the Teensy, 2 × 24 outer rows | Stage 2 |
  | U1002 | H11L1 MIDI opto, through-hole in place of the SMD part | Stage 7, before MIDI |
  | J101 | Two wire links: SPARE1–MIDI_TX, SPARE2–MIDI_RX | Stage 7, before MIDI |

  C209 and R205 are empty on purpose: they are the buck's feed-forward, drawn but not fitted.

## Stage 1: look

Unpowered, out of the bag. Check by eye or under the magnifier:

- **Diodes D201, D202, D203** (SS34): cathode bands as the silkscreen shows.
- **Regulators:** U201 buck (SOT-23-6), U202 L78M05 (the large TO-252), U203 and U204 XC6206
  (SOT-23).
- **Pin 1 of every IC**, and no solder bridges on the fine-pitch chips: U301 PCM3060,
  U401 ADS8688, U501 DAC8568, U701 TCA9555, U602 74HCT595.
- **U1002 is empty**, as expected. Anything else missing or lifted, stop.

## Stage 2: solder the power header and the Teensy sockets

1. **J201, the power header.** Before soldering, plug the ribbon into the loose header and
   check that the **red stripe (−12 V) lands on pin 1**, the squared-off pad. J201 pins 1–2 are
   −12 V and 9–10 are +12 V. Then solder it that way round.
2. **A101, the Teensy sockets.** Fit the female headers on the board, using the Teensy (with
   its own male headers) as the jig so the rows line up, then take the Teensy out again. It
   stays out until stage 5.
3. **Cut the Teensy's VIN–VUSB pads** (spec §5). Otherwise the rack's 5 V reaches the
   computer's USB port. Check with the meter's continuity beep that VIN and VUSB no longer
   connect. With the pads cut, the Teensy runs only when the rack is on, USB or not.

## Stage 3: cold checks (unpowered, Teensy out)

Resistance from each rail's test point to ground (TP203 or TP204), red lead on the rail. A
reading that starts low and climbs is the capacitors charging, and is fine. **A steady reading
under about 10 Ω is a short: stop.**

| Rail | Test point | Face | Expect | Reading |
|---|---|---|---|---|
| +12V | TP201 | outward | high, climbing | |
| −12V | TP202 | deck | high, climbing | |
| +5VD | TP205 | deck | kΩ or more | |
| +5VA | TP206 (no label) | outward | **10 kΩ or a little less** | |
| +3V3A | TP207 (no label) | deck | kΩ or more | |
| +3V3D | TP208 | outward | **about 680 Ω or less**: R210, the minimum load, not a short | |
| MOD_5V | TP209 | deck | high (D203 blocks the path back) | |
| +12V to −12V | TP201–TP202 | | high | |
| +12V to +5VD | TP201–TP205 | | high | |

The +5VA reading is the 10 kΩ that keeps the ADS8688's ±20 V input protection working when the
board is unpowered (spec §15). Rev A is the first chance to measure it.

Test point positions, in mm from the top left of each face, are in
[`wiring_map.md`](../hardware/analogue_board/teensy_core_midi/output/wiring_map.md).

## Stage 4: first power (Teensy out, deck not wired)

1. Rack off. Plug in the ribbon, red stripe to −12 V. Board on something non-conductive.
2. **Power on, count three seconds, power off.**
3. Touch U201, U202, U203, U204 and D201–D203. Anything hot or any smell: stop.
4. Power on again and measure, black lead on TP203 or TP204:

| Rail | Test point | Expect | Reading, 2026-10-30 |
|---|---|---|---|
| +12V | TP201 | the rack's +12 V less 0.2–0.5 V (SS34), so about 11.6 V | in range |
| −12V | TP202 | the same, negative: about −11.6 V | in range |
| +5VD | TP205 | 5.07 V (buck, 15k/2k divider) | in range |
| +5VA | TP206 | about 5.0 V (L78M05) | 4.98 V, at U202 with the Teensy in |
| +3V3A | TP207 | 3.3 V, within 2% (XC6206) | 3.29 V, Teensy in |
| +3V3D | TP208 | 3.3 V, within 2% | in range |
| MOD_5V | TP209 | just under +5VD with nothing on it | 4.72 V, Teensy in (stage 5) |

TP206 is under the Teensy once it is fitted. U202's output is the same rail ahead of its link
R207: the right-hand leg of the big regulator beside J201. MOD_5V is also the Teensy's VIN, the
corner pin straight across from socket pin 1.

**If a rail is wrong**, each regulator has a 0 Ω link to its loads: R206 (+5VD), R207 (+5VA),
R208 (+3V3A), R209 (+3V3D). The test points are on the load side. With a link lifted, measure
on its regulator-side pad. Right there means the fault is in the loads; wrong there means the
regulator. The buck only starts once +12 V passes about 9.2 V (its EN divider), so a low +12 V
also shows as a dead +5VD.

A multimeter can't see the buck's 350 kHz ripple; that waits for the noise comparison.

## Stage 5: the Teensy in

1. Rack off. Teensy in, pads cut, the right way round: socket pin 1 (the square pad) is the
   Teensy's GND pin in the USB corner, and socket pins 2 and 3 are its pins 0 and 1. Before
   it goes in, socket pin 1 should beep to TP203.
2. USB to the Mac, rack on. The Teensy should enumerate. A new one runs PJRC's factory program:
   the orange LED blinks slowly and the Mac sees "Teensyduino RawHID". Pin 13 is SPIA_SCK here,
   so the blink only clocks a bus whose chip selects are pulled up.
3. TP209 (MOD_5V) now carries the Teensy, so it drops to about 4.6–4.8 V. Its VIN range is
   3.6–5.5 V.
4. Flash the stage 6 program **in the foreground**: a background upload once half-programmed and
   bricked a module. In `firmware/analogue_board_test`, `pio run -t upload` opens the Teensy
   Loader app, which reboots the Teensy and programs it; it comes back as "USB Serial".

## Stage 6: one block at a time (test firmware)

A single test program with a serial menu, one command per block, each printing what it read:
[`firmware/analogue_board_test`](../firmware/analogue_board_test/src/main.cpp). Open
`pio device monitor` there, type a block number and Enter; `h` lists them, `0` puts everything
back in a safe state. At boot only I2C runs; every other pin stays an input until its block is
asked for. The pass marks below are what the program checks. Pins follow the spec's §6.3 pin
map. The firmware requirements in spec §15 apply throughout, and the DAC start-up order
matters most.

| # | Block | Needs the deck? | Test | Pass |
|---|---|---|---|---|
| 1 | I2C | no | scan the bus | 0x20 (TCA9555) and 0x50 (M24C64) answer |
| 2 | EEPROM | no | write a page, read it back | same bytes |
| 3 | Expander | no | every jack switch off, GATE_OE_N high; read port 1 and EXP_INT | reads settle, INT idles high |
| 4 | ADC | no | read ADS8688 registers back, then all 8 channels | registers echo; an open CV1–6 reads about +0.2 V (its bias); AIN6–7 are tied to ground and read 0 V |
| 5 | DAC to ADC | no | DAC8568 start-up in spec order, then close one switch at a time: CV1–6 are read back by the ADC through the switch | each channel tracks the codes written; note the voltage at the lowest and highest codes |
| 6 | Codec clocks | no | start I2S at 44.1 kHz, the Teensy Audio library's rate | DC average at TP301 (MCLK), TP302 (BCK) and TP303 (LRCK) about 1.65 V, or 11.29 MHz, 2.82 MHz and 44.1 kHz if the meter counts Hz |
| 7 | Gate outs | no | shift a gate word, latch it, then GATE_OE_N low | about 5 V and 0 V at the gate-out holes, as written; with GOUTn wired to GINn the program checks itself |
| 8 | Gate ins | jack or wire | a rack gate into each; `8t N` sweeps CV1, wired to GIN N | trips at about 2.0 V rising, 1.7 V falling |
| 9 | Pots | deck | MCP3208, SPI-B at 1 MHz or less | each pot sweeps 0 to full scale |
| 10 | Audio | deck jacks | sine out; audio in looped back or into the ES-10 | clean sine; the input reads inverted (spec: negate it) |
| 11 | LEDs | deck | short WS2812 chain, capped current | colours as sent |
| 12 | Encoder | deck | A on GIN3, B on GIN1 (QuadEncoder), its common to POT_REF; push through JPS2 to SW6, its other pin to D (stage 8) | counts both ways, push registers |
| 13 | MIDI | after stage 7 | Serial1 at 31 250 baud; loop OUT to IN with a TRS cable, or play notes in | bytes in = bytes out |

This board has six CV jacks, CV1–6, all switchable. The fixed-direction CV7–8 were left out of
its core set (`teensy_core_midi` in `tools/analogue_board/variant.py`), so there is no CV7–8 test.

The encoder needs no parts: with its common on 3.3 V, a closed contact puts 3.3 V on the gate
input and an open one is pulled to 0 V by the input's own 100 kΩ. Gate inputs 1 and 3 belong to
the encoder from block 12 until a restart.

Blocks 9–13 need the control deck wired: stage 8.

**For the Boy build** (the first, stage 8; David, 2026-10-31): test only what Boy uses, and attach
no temporary wires.
- **Before the deck:** blocks 6 and 7, with the meter only.
- **Skipped:** blocks 9 and 11 (no pots or LEDs), block 8t (thresholds need a wire from CV1), and
  MIDI out.
- **After the deck, in this order:**
  1. block 1 again: the screen's address should join 0x20 and 0x50;
  2. block 8: turn the encoder slowly; GIN1 and GIN3 should step between HIGH and low, one after
     the other. Run it before block 12, which holds those pins until a restart;
  3. block 10, through the jacks;
  4. block 12;
  5. block 13, with notes from a real MIDI source.

## Stage 7: MIDI in

1. Rack off. Fit the through-hole H11L1 at U1002: trim the legs short and bend each to sit flat
   on its SMD pad. Pin 1, the dot, goes on the top-left pad with the outward face up and J201
   at the bottom right.
2. Wire the J101 links: SPARE1 to MIDI_TX, SPARE2 to MIDI_RX. Without them, Teensy pins 1 and 0
   stay plain spare GPIO. **Boy receives MIDI only, so it needs just SPARE2 to MIDI_RX**; leave
   SPARE1 free.
3. Run block 13 once the deck is wired, with notes from a real MIDI source into the MIDI-in jack.

## Stage 8: the control deck

The first build is the Boy panel with a push encoder and TRS MIDI in. Agreed 2026-10-31: the deck
is built the n8synth way (JPS1 top left on the front panel) and the board sits upright behind it.
Of the four ways the two boards can meet, this one needs the least hand wire: 24 wires, 800 mm in
all, 6 across the board (the other upright fit needs 889 mm and 10 across). Every wire leaves the
deck through a strip, so nothing runs between the boards outside the headers. Every wire below is
also drawn on the wiring map: turn on its "Show wires" layer, or pick a batch. The live page is
at <https://claude.ai/artifact/RptmC4zktQrcPzZHXxPau4>, and a copy of its final version, which
opens in any browser, is kept at [`analogue_board_bringup/wiring_map.html`](analogue_board_bringup/wiring_map.html).

**The panel**, as the front reads (cells JPS1–18, left to right, top to bottom):

| Row | Left | Middle | Right |
|---|---|---|---|
| 1 | screen (JPS1) | screen; pads borrowed (JPS2) | encoder (JPS3) |
| 2 | gate1 (JPS4) | pitch1 (JPS5) | clk (JPS6) |
| 3 | gate2 (JPS7) | pitch2 (JPS8) | drum1 (JPS9) |
| 4 | gate3 (JPS10) | pitch3 (JPS11) | drum3 (JPS12) |
| 5 | audio in L (JPS13) | rst (JPS14) | audio out L (JPS15) |
| 6 | audio in R (JPS16) | MIDI in (JPS17) | audio out R (JPS18) |

Gates and pitches use CV outputs; drum1, drum3, rst and clk are the four gate outputs. No gate
input is used, so the encoder takes two. The screen sits in the panel over JPS1 and JPS2, so their
six pads are free: JPS1 carries the screen's signals, JPS2 the encoder's push and the deck's ground.

**Wires from the strips**, each from the strip's inner hole level with the pad to the hole named
(net name as in the [wiring holes picture](analogue_board_bringup/holes_outward.png), then its
column and row on the map). A jack's tip is on its cell's pad A.

| Cell | Part | Pad | Hole | Length |
|---|---|---|---|---|
| JPS1 | screen SDA | A | SDA, right edge (RS 26) | 64 mm |
| JPS1 | screen SCL | B | SCL, right edge (RS 27) | 64 mm |
| JPS1 | screen 3V3 | C | 3V3D, right edge (RS 28) | 64 mm |
| JPS2 | (spare) | A | | |
| JPS2 | encoder push | B | SW6 (R 9) | 10 mm |
| JPS2 | deck ground | C | GND below SW7, right edge (RS 12), square | 15 mm |
| JPS3 | encoder A | A | GIN3 (R 4) | 39 mm, across |
| JPS3 | encoder common | B | REF, the top-left one beside POT1 (LO 5) | 8 mm |
| JPS3 | encoder B | C | GIN1 (LI 3) | 5 mm |
| JPS4 | gate1 | A | CV4 (R 1) | 15 mm |
| JPS5 | pitch1 | A | CV5 (LO 2) | 6 mm |
| JPS6 | clk | A | GOUT1 (LO 6) | 4 mm |
| JPS7 | gate2 | A | CV6 (RS 13) | 10 mm |
| JPS8 | pitch2 | A | CV2 (LI 1) | 60 mm, across |
| JPS9 | drum1 | A | GOUT3 (R 8) | 44 mm, across |
| JPS10 | gate3 | A | CV1 (LO 1) | 68 mm, across |
| JPS11 | pitch3 | A | CV3 (LO 21) | 4 mm |
| JPS12 | drum3 | A | GOUT2 (LO 25) | 6 mm |
| JPS13 | audio in L | A | AIN2 (R 3) | 74 mm |
| JPS14 | rst | A | GOUT4 (R 24) | 28 mm |
| JPS15 | audio out L | A | AOUT1 (LO 22) | 26 mm |
| JPS16 | audio in R | A | AIN1 (LO 3) | 97 mm, across |
| JPS17 | MIDI in tip | A | MI_T (LO 32) | 8 mm |
| JPS17 | MIDI in ring | B | MI_R (LO 33) | 8 mm |
| JPS18 | audio out R | A | AOUT2 (RS 14) | 75 mm, across |

Channel names are only firmware labels, so CV4 being gate1 is fine. The six long wires come from
Rev A putting the audio holes at the top of the board and the panel putting audio at the bottom.

**Wire it in batches, and test each before the next** (David, 2026-10-31: wiring mistakes creep in
after about an hour). Before powering after each batch, check with the meter that no newly wired
hole beeps to a GND hole (SW6 beeps only while the encoder is pressed).

| Batch | Wires | Test |
|---|---|---|
| 0. Deck ground | JPS2 C → GND below SW7 | continuity, any jack sleeve to the board's GND (done 2026-10-31) |
| 1. Encoder | JPS3 A → GIN3, B → REF, C → GIN1; JPS2 B → SW6 | block 8: turning slowly steps GIN1 and GIN3 in turn. Then flash the current program and run block 12 (passed 2026-10-31) |
| 2. Gate outs | JPS6 → GOUT1, JPS9 → GOUT3, JPS12 → GOUT2, JPS14 → GOUT4 | block 7, meter on each jack's tip pad (passed 2026-10-31) |
| 3. CV outs | JPS4 → CV4, JPS5 → CV5, JPS7 → CV6, JPS8 → CV2, JPS10 → CV1, JPS11 → CV3 | block 5 (nothing patched), then `c N V` holds jack N's voltage for the meter (passed 2026-10-31) |
| 4. Audio | JPS13 → AIN2, JPS16 → AIN1, JPS15 → AOUT1, JPS18 → AOUT2 | block 10: sine out, then patch the outs into the ins (passed 2026-11-01) |
| 5. MIDI in | JPS17 A → MI_T, B → MI_R | block 13: its loop test fails (no MIDI out on Boy); play notes in and watch the bytes (passed 2026-11-01) |
| 6. Screen | JPS1 A → SDA, B → SCL, C → 3V3D | block 1: the screen's address joins 0x20 and 0x50; block 14 draws on it (passed 2026-11-01) |

**Links on the deck itself.** Every D pad is on one deck-wide ground bus.
- Each mono jack's sleeve to its cell's D: JPS4–16 and JPS18, 14 jacks.
- The encoder (JPS3): pins A, C, B onto pads A, B, C. Of its two push pins, one goes by a short link
  to JPS2's pad B, the other to D.
- The screen: SDA, SCL and 3V3 to JPS1's pads A, B, C; its GND to D.
- **JPS2's pad C bridged to D.** That pad's wire to GND (RS 12) is the deck's only ground
  connection to the board.
- **MIDI in (JPS17): the sleeve stays off D.** Leave it open or wire it to MI_S (LO 34); a sleeve on
  D makes a ground loop through the MIDI cable.

**The encoder** (Bourns PEC11R-4215F-S0024): its row of three pins is A, C, B, and it lines up with
the cell's pads A, B, C. So pad B carries the common. The common must go to 3.3 V, never to D: the
gate inputs detect voltage. It takes **POT_REF** (labelled REF in the pictures), a 3.3 V supply
meant for pot tops, because this panel has no pots and the top-left REF is 8 mm away against 79 mm
to +3V3D. If pots are added later, move the common to +3V3D (RS 28), or the encoder's switching will
reach the pot readings. The push switch's two pins sit on the far side of the body, off the cell's
pads, hence the link to JPS2.

## Log

| Date | Stage | What happened | Bodge or change | For Rev B? |
|---|---|---|---|---|
| 2026-10-30 | 1–2 | Looked over; J201 and A101 soldered; VIN–VUSB cut and checked with the meter | | |
| 2026-10-30 | 1 | Pads copper-coloured: the OSP finish ordered. Solders fine, but the wiring holes are not tinned (the spec assumed HASL) | | Pick HASL or ENIG if boards will wait or be rewired often |
| 2026-10-30 | 3–4 | The silkscreen printed as designed, but the plan names test points by number (TP209) and the board does not: it prints a short net name ("5V MOD") beside 15 of the 27, at 0.8 mm (JLC asks for 1.0 mm); 12 had no room | the pictures above | One name for each test point, printed beside every one at 1.0 mm / 0.15 mm or more, and used by the plan |
| 2026-10-30 | 1 | No Eight4aWish name or licence notice on the silkscreen: both are only in the KiCad title blocks | | A board line: name, revision, Eight4aWish, CC BY-SA 4.0 |
| 2026-10-30 | 4 | +12V, −12V, +5VD and +3V3D in range | | |
| 2026-10-30 | 5 | Teensy in: factory blink, enumerated. MOD_5V 4.72 V, +3V3A 3.29 V, +5VA 4.98 V | | TP206 (+5VA), TP401, TP601 lie under the module; TP605 and TP702 at its ends |
| 2026-10-30 | 5 | PlatformIO's Teensy compiler and teensy_loader_cli are x86_64 only, and this Mac has no Rosetta | `arm64_toolchain.py` (PlatformIO's arm64 GCC) and the Teensy Loader app (`teensy-gui`) | |
| 2026-10-30 | 6 | Blocks 1–5 pass. Open CV inputs +0.206 to +0.209 V (+0.205 predicted). DAC to ADC, uncalibrated: −5.18 to −5.24 V at code 0, +5.28 to +5.30 V at 65535 (−5.22 and +5.30 predicted through the 2 kΩ path), the 0 V code within 13 mV of 0, worst error 34 mV; every switch isolates | | |
| 2026-10-30 | 7 | H11L1 fitted at U1002, dot on pin 1 | | |
| 2026-10-31 | 6 | Block 6 passes: the codec returns samples (AIN1 −198 to 0, AIN2 +72 to +138 codes, inputs open), so MCLK, BCK, LRCK and the data lines all work. DC averages 1.34 V (MCLK), 1.51 V (BCK), 1.64 V (LRCK): all switching; the faster clocks read lower, as edge times take a bigger share of each cycle | | |
| 2026-10-31 | 6 | Block 7 passes: GOUT1–4 read 5.02–5.05 V high and 0.00 V low, each in both patterns | | |
| 2026-10-31 | 7 | J101 link fitted: SPARE2 to MIDI_RX only (Boy receives MIDI; SPARE1 left free) | | See §7's MIDI-link note |
| 2026-10-31 | 8 | Fit agreed: n8synth deck, board upright (24 wires, 800 mm, 6 across; the other upright fit 889 mm, 10 across). Encoder on GIN3 + GIN1, the holes nearest its cell, with its common on POT_REF; block 12 changed to match. The screen's cells lend their pads, so nothing runs between the boards outside the strips: JPS1 for the screen, JPS2 for the encoder's push and the deck ground | | Put each panel zone's channel holes level with it (Rev B's template does); give the encoder a 3.3 V hole beside its cell; plan the deck's ground link and any extra part pins into the strips from the start |
| 2026-10-31 | 8 | Front-panel parts wired to the deck, all but the screen; the encoder's second push pin straight to JPS2's D pad. Wiring then goes in batches, each tested before the next (the table in stage 8; the wiring map shows each batch). Batch 0, the deck ground: continuity from the deck to the board's GND | | |
| 2026-10-31 | 8 | Batch 1, the encoder, passes. Meter, unpowered: GIN3, GIN1, REF and SW6 don't beep to GND, SW6 only while pressed. Block 8: GIN1 and GIN3 each go high and low on their own and rest low between clicks; GIN2 and GIN4 stay low. GIN3 counted about two rises a click, GIN1 one: contact bounce on the encoder's A. Block 12, with the program flashed first: 5 clicks clockwise count 0 to 20 (5 detents), 5 back return to exactly 0, so the input filter takes the bounce; clockwise counts up; both presses read SW6 | | |
| 2026-10-31 | 8 | Batch 2, the gate outs, passes: block 7 metered at each jack's tip, clk (GOUT1), drum1 (GOUT3), drum3 (GOUT2) and rst (GOUT4), each 5 V and 0 V in turn in both patterns | | |
| 2026-10-31 | 8 | Batch 3, the CV outs, passes after one fix. Block 5 passes on all six (−5.18 to −5.24 V at code 0, +5.28 to +5.30 V at full scale, the 0 V code within 13 mV). Each jack then held at its own voltage and metered at its tip: gate1 (CV4) 3.93 of 4, pitch1 (CV5) 4.91 of 5, gate2 (CV6) −1.95 of −2, pitch2 (CV2) 1.96 of 2, pitch3 (CV3) 2.95 of 3, so no wires crossed. gate3 (CV1) read 0.00 V while the board read 0.99 V at CV1: a wiring error on the deck, fixed, then 0.98 V. Every output reads about 1.8% low, the same on all six: the DAC path's gain, for pitch calibration in firmware. `c N V` read the jack number as the voltage when typed with a space after c; fixed | | |
| 2026-10-31 | 8 | Batch 4, audio, wired; the outputs pass. Block 10's 440 Hz sine read nothing at either out jack on the meter, but a new command, `a V`, held both outs at +5 V DC and both jacks read +4.86 V. So the codec's DAC, the output stage and both wires work, and the sine reading was the meter, not the board. The inputs are not yet tested: patch the outs into the ins (block 10) or an oscillator into them (block 6) | | |
| 2026-11-01 | 3 | +3V3D to GND, unpowered, deck off: about 680 Ω, R210 (the minimum load), as expected | | |
| 2026-11-01 | 8 | Batch 4, audio, passes. Block 10 with audio out L patched to audio in R (AOUT1 to AIN1) and out R to in L (AOUT2 to AIN2): both inputs read 9.9 Vpp of the 10 sent, and both invert, as designed | | |
| 2026-11-01 | 8 | Batches 5 (MIDI in) and 6 (the screen) wired. MIDI in waits for a TRS Type A source (block 13) | | |
| 2026-11-01 | 8 | Batch 6, the screen, passes. Block 1 finds it at 0x3C beside 0x20 and 0x50. A new block 14 draws every pixel, then a border and a square. It was first written for a 128x64 screen (the spec's table said so), and the border's top line went missing. A row shift looked like a dead top row, and was logged as one. In fact the screen is Boy's 128x32 (its firmware: Adafruit_SSD1306 at 128 x 32), and a 32-row screen driven as 64 rows shows only every other row. With block 14 set up as the library does for 128x32 (32 rows, sequential COM pins), the whole border shows. `14 64` and `14 sh` cover a 128x64 and an SH1106 | | |
| 2026-11-01 | 8 | Batch 5, MIDI in, passes: every batch is now in and tested. A Befaco TRS-to-DIN cable, red (Type A; their grey is Type B), from a Proton passing MIDI through on channel 1. Block 13 over 30 s: the loop test fails as expected (no MIDI out on Boy); then 15 note-on/note-off pairs (90 3C 64, 80 3C 40), every one complete, and 1,439 clock bytes (F8, 120 BPM), with nothing garbled | | |
