Eight4aWish/eurorack_electronics/tools/noise_test/results/summary.md

# Noise test results

All levels in dB against a 10 Vpp sine; median [min, max] over three takes.

| board | screen | ch | out only, A-wt | through, A-wt | input share | out only less ES-10 in | ES-10 IN 3 floor | hum 50 | hum 100 | 1 kHz | tallest spurs (out only, take 1) | full scale Vpp |
|---|---|---|---|---|---|---|---|---|---|---|---|---|
| boy | off | L | -94.1 [-94.1, -94.1] | -93.0 [-93.0, -93.0] | -99.5 [-99.5, -99.4] | -96.3 [-96.3, -96.2] | -98.1 [-98.1, -98.0] | -118.4 [-118.7, -118.2] | -117.8 [-119.9, -117.8] | -123.5 [-125.9, -120.6] | 4001 Hz -106, 8002 Hz -107, 12003 Hz -109 | 19.3 |
| boy | off | R | -94.1 [-94.1, -94.1] | -93.3 [-93.4, -93.3] | -101.2 [-101.3, -101.0] | -96.4 [-96.4, -96.3] | -98.1 [-98.1, -98.0] | -119.0 [-119.4, -118.5] | -117.9 [-119.0, -117.7] | -122.7 [-126.0, -120.7] | 4001 Hz -106, 8002 Hz -108, 12003 Hz -109 | 19.4 |
| boy | still | L | -92.4 [-92.4, -92.2] | -91.7 [-91.7, -91.6] | -100.1 [-100.1, -99.8] | -93.7 [-93.8, -93.6] | -98.1 [-98.1, -98.1] | -118.4 [-118.8, -118.0] | -117.9 [-118.5, -117.4] | -122.8 [-123.0, -120.1] | 5988 Hz -100, 4001 Hz -107, 8002 Hz -108 | 19.3 |
| boy | still | R | -92.4 [-92.5, -92.3] | -91.9 [-91.9, -91.8] | -101.3 [-101.6, -101.3] | -93.8 [-93.8, -93.6] | -98.1 [-98.1, -98.1] | -118.8 [-118.9, -118.3] | -117.8 [-118.4, -117.2] | -122.4 [-122.9, -120.6] | 5988 Hz -100, 4001 Hz -107, 8002 Hz -108 | 19.4 |
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
| seed | redraw | L | -77.6 [-77.6, -77.5] | -76.7 [-76.7, -76.5] | -83.8 [-84.0, -83.4] | -77.7 [-77.7, -77.5] | -98.0 [-98.1, -98.0] | -91.4 [-91.7, -91.4] | -99.9 [-100.7, -98.8] | -102.2 [-102.3, -102.0] | 6218 Hz -80, 12534 Hz -87, 12437 Hz -87 | 34.6 |
| seed | redraw | R | -82.1 [-82.2, -82.1] | -80.6 [-80.7, -80.6] | -86.1 [-86.1, -85.6] | -82.3 [-82.3, -82.2] | -98.0 [-98.1, -98.0] | -91.7 [-91.8, -91.6] | -100.2 [-100.8, -99.2] | -108.6 [-108.7, -108.5] | 6218 Hz -86, 12534 Hz -92, 12437 Hz -92 | 34.3 |

## Controls

- es10_loop: L -96.2 dB A-wt, -94.3 flat, R -96.2 dB A-wt, -94.2 flat
