Eight4aWish/eurorack_electronics/docs/analogue_board_bringup/midi_outward.png

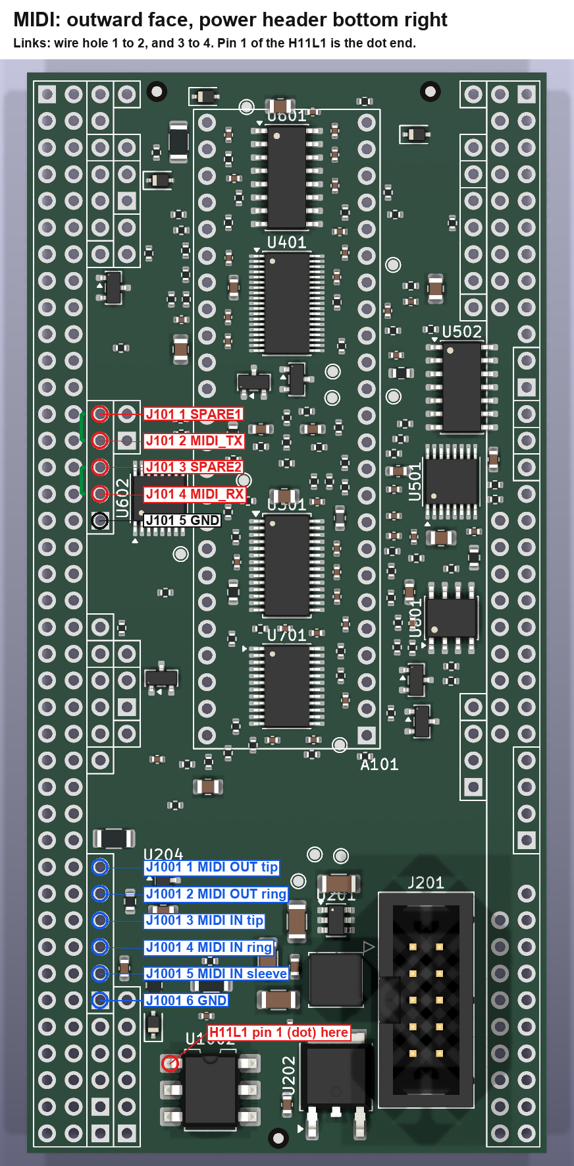
docs/analogue_board_bringup/midi_outward.png
