Eight4aWish/eurorack_electronics/docs/analogue_board_bringup/test_points_outward.png

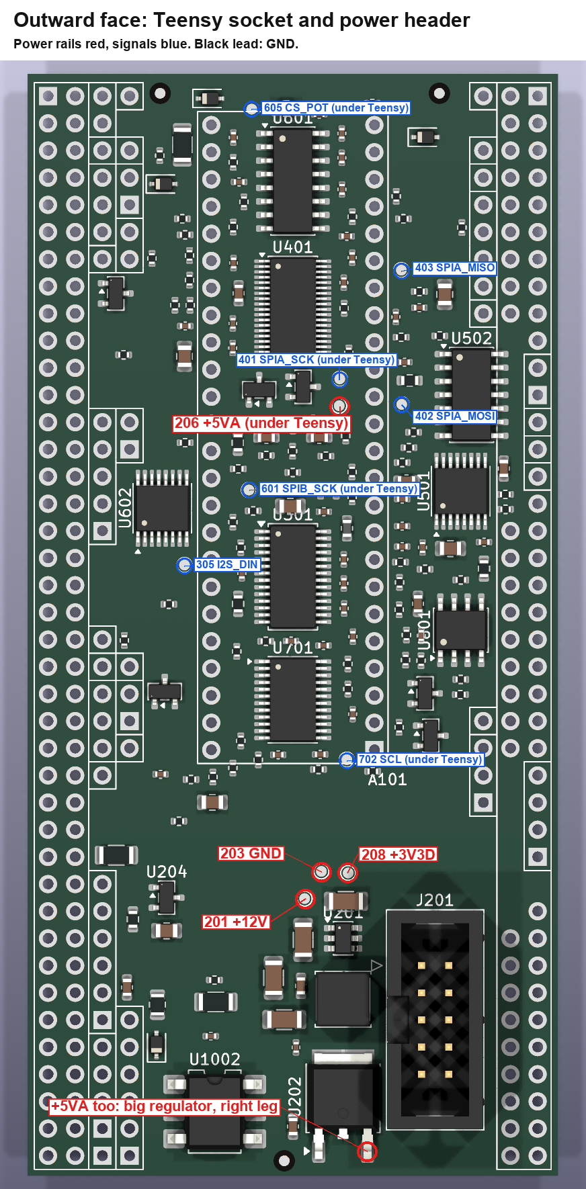
docs/analogue_board_bringup/test_points_outward.png
