Eight4aWish/eurorack_electronics/docs/analogue_board_journal/routing_runs.csv

when | kind | board | stage | layers | settings | rules | pre_route | connections | left | minutes | board_file | log
2026-10-15 23:03 | route |  |  |  |  |  |  | 992 | 196 |  | analogue_board_autoroute_trial.kicad_pcb | bjz4xfpkt.output
2026-10-15 23:39 | route |  |  |  |  |  |  | 992 | 329 |  | analogue_board_autoroute_trial.kicad_pcb | b1d28jpg3.output
2026-10-16 06:17 | route | pico |  |  |  |  |  | 938 | 267 |  | analogue_board_pico_autoroute_trial.kicad_pcb | b68xlw2rg.output
2026-10-16 06:25 | route | teensy |  |  |  |  |  | 929 | 251 |  | analogue_board_teensy_autoroute_trial.kicad_pcb | b2806d9dc.output
2026-10-16 08:15 | route |  |  | 4 |  | (via "Via[0-3]_450:200_um" "Via[0-3]_600:300_um") (width 150) (clearance 150) |  | 885 | 248 | 62.6 | pico_trimmed_autoroute_trial.kicad_pcb | b750fdhx0.output
2026-10-16 08:16 | route |  |  | 6 |  | (via "Via[0-5]_450:200_um" "Via[0-5]_600:300_um") (width 150) (clearance 150) |  | 885 | 168 | 64.1 | pico_trimmed_6L_autoroute_trial.kicad_pcb | b7cx15cn5.output
2026-10-16 08:18 | route |  |  | 4 |  | (via "Via[0-3]_450:200_um" "Via[0-3]_600:300_um") (width 150) (clearance 150) |  | 876 | 240 | 65.9 | teensy_trimmed_autoroute_trial.kicad_pcb | bbwe1jlw0.output
2026-10-16 08:23 | route |  |  | 6 |  | (via "Via[0-5]_450:200_um" "Via[0-5]_600:300_um") (width 150) (clearance 150) |  | 876 | 167 | 70.5 | teensy_trimmed_6L_autoroute_trial.kicad_pcb | bvipgh7hk.output
2026-10-16 08:34 | route | combined |  | 6 |  | (via "Via[0-5]_450:200_um" "Via[0-5]_600:300_um") (width 150) (clearance 150) |  | 965 | 202 | 82.2 | analogue_board_combined_6L_autoroute_trial.kicad_pcb | b60wkbjbg.output
2026-10-16 10:35 | route | shared |  | 4 |  | (via "Via[0-3]_450:200_um" "Via[0-3]_600:300_um") (width 150) (clearance 150) |  | 911 | 277 | 54.0 | analogue_board_shared_autoroute_trial.kicad_pcb | b6093cw4p.output
2026-10-16 10:38 | route | pico |  | 6 |  | (via "Via[0-5]_450:200_um" "Via[0-5]_600:300_um") (width 150) (clearance 150) |  | 885 | 164 | 48.4 | analogue_board_pico_6L_autoroute_trial.kicad_pcb | bitm0a4m4.output
2026-10-16 10:39 | route | shared |  | 6 |  | (via "Via[0-5]_450:200_um" "Via[0-5]_600:300_um") (width 150) (clearance 150) |  | 911 | 214 | 57.2 | analogue_board_shared_6L_autoroute_trial.kicad_pcb | b821g8c1b.output
2026-10-16 11:18 | route | pico_core |  | 6 |  | (via "Via[0-5]_450:200_um" "Via[0-5]_600:300_um") (width 127) (clearance 127) |  | 793 | 81 | 6.7 | analogue_board_pico_core_6L_autoroute_trial.kicad_pcb | b4ro7wqcd.output
2026-10-16 11:29 | route | pico_core |  | 6 | --router.automatic_neckdown=false --router.hole_clearance_um=250 --router.fanout.enabled=false | (via "Via[0-5]_450:200_um" "Via[0-5]_600:300_um") (width 127) (clearance 127) |  | 793 | 240 | 9.3 | analogue_board_pico_core_6L_nofanout_autoroute_trial.kicad_pcb | b1x5m4xe2.output
2026-10-16 11:34 | route | pico_core |  | 6 | --router.automatic_neckdown=false --router.hole_clearance_um=250 --router.fanout.enabled=false --router.scoring.via_costs=20 --router.scoring.plane_via_costs=2 | (via "Via[0-5]_450:200_um" "Via[0-5]_600:300_um") (width 127) (clearance 127) |  | 793 | 224 | 13.6 | analogue_board_pico_core_6L_nofanoutcheap_autoroute_trial.kicad_pcb | brxhnkk2r.output
2026-10-16 11:34 | route | pico_core |  | 6 | --router.automatic_neckdown=false --router.hole_clearance_um=250 --router.scoring.via_costs=20 --router.scoring.plane_via_costs=2 | (via "Via[0-5]_450:200_um" "Via[0-5]_600:300_um") (width 127) (clearance 127) |  | 793 | 83 | 14.2 | analogue_board_pico_core_6L_cheapvia_autoroute_trial.kicad_pcb | b2f99mm1e.output
2026-10-16 11:35 | route | pico_core |  | 6 | --router.automatic_neckdown=false --router.hole_clearance_um=250 | (via "Via[0-5]_450:200_um" "Via[0-5]_600:300_um") (width 127) (clearance 127) |  | 793 | 76 | 15.9 | analogue_board_pico_core_6L_base_autoroute_trial.kicad_pcb | bsboutdx1.output
2026-10-16 11:37 | route | pico_core |  | 6 | --router.automatic_neckdown=false --router.hole_clearance_um=250 --router.scoring.start_ripup_costs=400 | (via "Via[0-5]_450:200_um" "Via[0-5]_600:300_um") (width 127) (clearance 127) |  | 793 | 52 | 16.8 | analogue_board_pico_core_6L_ripup_autoroute_trial.kicad_pcb | b91f0tl1x.output
2026-10-16 11:41 | route | pico_core |  | 6 | --router.automatic_neckdown=false --router.hole_clearance_um=250 | (via "Via[0-5]_450:200_um" "Via[0-5]_600:300_um") (width 127) (clearance 127) |  | 224 | 49 | 6.9 | analogue_board_pico_core_6L_nofanoutcheap_autoroute_trial_6L_stage2_autoroute_trial.kicad_pcb | bl1c1i5qq.output
2026-10-16 11:53 | route | pico_core |  | 6 | --router.automatic_neckdown=false --router.hole_clearance_um=250 --router.scoring.plane_via_costs=1 --router.scoring.start_ripup_costs=400 | (via "Via[0-5]_450:200_um" "Via[0-5]_600:300_um" "Via[0-5]_450:300_um") (width 127) (clearance 127) |  | 49 | 37 | 10.9 | analogue_board_pico_core_6L_nofanoutcheap_autoroute_trial_6L_stage2_autoroute_trial_6L_stage3_autoroute_trial.kicad_pcb | bpwte1kn2.output
2026-10-16 13:34 | route | shared_core | s1 | 6 | --router.automatic_neckdown=false --router.hole_clearance_um=250 --router.fanout.enabled=false --router.scoring.via_costs=20 --router.scoring.plane_via_costs=2 | (via "Via[0-5]_450:200_um" "Via[0-5]_600:300_um") (width 127) (clearance 127) |  | 852 | 234 | 8.5 | analogue_board_shared_core_6L_s1_autoroute_trial.kicad_pcb | buw5syo68.output
2026-10-16 13:34 | route | shared_core | s2 | 6 | --router.automatic_neckdown=false --router.hole_clearance_um=250 | (via "Via[0-5]_450:200_um" "Via[0-5]_600:300_um") (width 127) (clearance 127) |  | 234 | 37 | 7.2 | analogue_board_shared_core_6L_s1_s2_autoroute_trial.kicad_pcb | buw5syo68.output
2026-10-16 13:34 | route | shared_core | s3 | 6 | --router.automatic_neckdown=false --router.hole_clearance_um=250 --router.scoring.plane_via_costs=1 --router.scoring.start_ripup_costs=400 | (via "Via[0-5]_450:200_um" "Via[0-5]_600:300_um" "Via[0-5]_450:300_um") (width 127) (clearance 127) |  | 37 | 36 | 6.7 | analogue_board_shared_core_6L_s1_s2_s3_autoroute_trial.kicad_pcb | buw5syo68.output
2026-10-16 14:09 | route | shared_core | s1 | 6 | --router.automatic_neckdown=false --router.hole_clearance_um=250 --router.copper_to_edge_clearance_um=500 --router.fanout.enabled=false --router.scoring.via_costs=20 --router.scoring.plane_via_costs=2 | (via "Via[0-5]_450:200_um" "Via[0-5]_600:300_um") (width 127) (clearance 127) |  | 852 | 236 | 9.0 | analogue_board_shared_core_6L_s1_autoroute_trial.kicad_pcb | bezj3rtvx.output
2026-10-16 14:09 | route | shared_core | s2 | 6 | --router.automatic_neckdown=false --router.hole_clearance_um=250 --router.copper_to_edge_clearance_um=500 | (via "Via[0-5]_450:200_um" "Via[0-5]_600:300_um") (width 127) (clearance 127) |  | 236 | 48 | 9.6 | analogue_board_shared_core_6L_s1_s2_autoroute_trial.kicad_pcb | bezj3rtvx.output
2026-10-16 14:09 | route | shared_core | s3 | 6 | --router.automatic_neckdown=false --router.hole_clearance_um=250 --router.copper_to_edge_clearance_um=500 --router.scoring.plane_via_costs=1 --router.scoring.start_ripup_costs=400 | (via "Via[0-5]_450:200_um" "Via[0-5]_600:300_um" "Via[0-5]_450:300_um") (width 127) (clearance 127) |  | 48 | 45 | 10.3 | analogue_board_shared_core_6L_s1_s2_s3_autoroute_trial.kicad_pcb | bezj3rtvx.output
2026-10-16 14:30 | route | shared_core | s1 | 6 | --router.automatic_neckdown=false --router.hole_clearance_um=250 --router.copper_to_edge_clearance_um=500 --router.fanout.enabled=false --router.scoring.via_costs=20 --router.scoring.plane_via_costs=2 | (via "Via[0-5]_450:200_um" "Via[0-5]_600:300_um") (width 127) (clearance 127) |  | 852 | 239 | 9.7 | analogue_board_shared_core_6L_low_s1_autoroute_trial.kicad_pcb | b9ht2i8xp.output
2026-10-16 14:30 | route | shared_core | s2 | 6 | --router.automatic_neckdown=false --router.hole_clearance_um=250 --router.copper_to_edge_clearance_um=500 | (via "Via[0-5]_450:200_um" "Via[0-5]_600:300_um") (width 127) (clearance 127) |  | 239 | 54 | 11.6 | analogue_board_shared_core_6L_low_s1_s2_autoroute_trial.kicad_pcb | b9ht2i8xp.output
2026-10-16 14:30 | route | shared_core | s3 | 6 | --router.automatic_neckdown=false --router.hole_clearance_um=250 --router.copper_to_edge_clearance_um=500 --router.scoring.plane_via_costs=1 --router.scoring.start_ripup_costs=400 | (via "Via[0-5]_450:200_um" "Via[0-5]_600:300_um" "Via[0-5]_450:300_um") (width 127) (clearance 127) |  | 54 | 48 | 17.1 | analogue_board_shared_core_6L_low_s1_s2_s3_autoroute_trial.kicad_pcb | b9ht2i8xp.output
2026-10-16 14:50 | route | shared_core |  | 6 | --router.fanout.enabled=false --router.automatic_neckdown=false --router.hole_clearance_um=250 --router.copper_to_edge_clearance_um=500 | (via "Via[0-5]_450:200_um" "Via[0-5]_600:300_um" "Via[0-5]_450:300_um") (width 127) (clearance 127) |  | 48 | 48 | 16.2 | analogue_board_shared_core_6L_low_s1_s2_s3_s4_autoroute_trial.kicad_pcb | bev5qs312.output
2026-10-16 15:49 | route | shared_core | s1 | 6 | --router.automatic_neckdown=false --router.hole_clearance_um=250 --router.copper_to_edge_clearance_um=500 --router.fanout.enabled=false --router.scoring.via_costs=20 --router.scoring.plane_via_costs=2 | (via "Via[0-5]_450:200_um" "Via[0-5]_600:300_um") (width 127) (clearance 127) | Ground vias placed before routing: 207; no room beside 0 pads: [] | 645 | 61 | 29.4 | analogue_board_shared_core_6L_gv_s1_autoroute_trial.kicad_pcb | b9azdum2d.output
2026-10-16 15:49 | route | shared_core | s2 | 6 | --router.automatic_neckdown=false --router.hole_clearance_um=250 --router.copper_to_edge_clearance_um=500 | (via "Via[0-5]_450:200_um" "Via[0-5]_600:300_um") (width 127) (clearance 127) |  | 61 | 28 | 25.9 | analogue_board_shared_core_6L_gv_s1_s2_autoroute_trial.kicad_pcb | b9azdum2d.output
2026-10-16 15:49 | route | shared_core | s3 | 6 | --router.automatic_neckdown=false --router.hole_clearance_um=250 --router.copper_to_edge_clearance_um=500 --router.scoring.plane_via_costs=1 --router.scoring.start_ripup_costs=400 | (via "Via[0-5]_450:200_um" "Via[0-5]_600:300_um" "Via[0-5]_450:300_um") (width 127) (clearance 127) |  | 28 | 26 | 35.2 | analogue_board_shared_core_6L_gv_s1_s2_s3_autoroute_trial.kicad_pcb | b9azdum2d.output
2026-10-16 15:50 | finish | shared_core | finish |  |  |  |  |  | 13 |  | analogue_board_shared_core_6L_gv_s1_s2_autoroute_trial_finished.kicad_pcb | b40qoipzt.output
2026-10-16 16:13 | finish | shared_core | finish |  |  |  |  |  | 12 |  | analogue_board_shared_core_6L_gv_s1_s2_s3_autoroute_trial_finished.kicad_pcb | ba9af4idf.output
2026-10-16 16:20 | finish | shared_core | finish |  |  |  |  |  | 1 |  | analogue_board_shared_core_6L_gv2_s1_s2_autoroute_trial_finished.kicad_pcb | bebnxr9w1.output
2026-10-16 16:27 | finish | shared_core | finish |  |  |  |  |  | 2 |  | analogue_board_shared_core_6L_gv2_s1_s2_autoroute_trial_finished.kicad_pcb | be3j55gr1.output
2026-10-16 16:36 | finish | shared_core | finish |  |  |  |  |  | 2 |  | analogue_board_shared_core_6L_gv2_s1_s2_autoroute_trial_finished.kicad_pcb | bed4z21jn.output
2026-10-16 16:37 | route | shared_core | s1 | 6 | --router.automatic_neckdown=false --router.hole_clearance_um=250 --router.copper_to_edge_clearance_um=500 --router.fanout.enabled=false --router.scoring.via_costs=20 --router.scoring.plane_via_costs=2 | (via "Via[0-5]_450:200_um" "Via[0-5]_600:300_um") (width 127) (clearance 127) | Ground vias placed before routing: 204; no room beside 3 pads: ['D401.1', 'R309.2', 'U401.24'] | 648 | 24 | 23.4 | analogue_board_shared_core_6L_gv2_s1_autoroute_trial.kicad_pcb | b43woe67z.output
2026-10-16 16:37 | route | shared_core | s2 | 6 | --router.automatic_neckdown=false --router.hole_clearance_um=250 --router.copper_to_edge_clearance_um=500 | (via "Via[0-5]_450:200_um" "Via[0-5]_600:300_um") (width 127) (clearance 127) |  | 24 | 16 | 22.7 | analogue_board_shared_core_6L_gv2_s1_s2_autoroute_trial.kicad_pcb | b43woe67z.output
2026-10-16 16:37 | route | shared_core | s3 | 6 | --router.automatic_neckdown=false --router.hole_clearance_um=250 --router.copper_to_edge_clearance_um=500 --router.scoring.plane_via_costs=1 --router.scoring.start_ripup_costs=400 | (via "Via[0-5]_450:200_um" "Via[0-5]_600:300_um" "Via[0-5]_450:300_um") (width 127) (clearance 127) |  | 16 | 14 | 21.5 | analogue_board_shared_core_6L_gv2_s1_s2_s3_autoroute_trial.kicad_pcb | b43woe67z.output
2026-10-16 16:41 | finish | shared_core | finish |  |  |  |  |  | 2 |  | analogue_board_shared_core_6L_gv2_s1_s2_autoroute_trial_finished.kicad_pcb | bcnn0e7fy.output
2026-10-16 16:42 | finish | shared_core | finish |  |  |  |  |  | 2 |  | analogue_board_shared_core_6L_gv2_s1_s2_s3_autoroute_trial_finished.kicad_pcb | bp3fidn71.output
2026-10-16 17:17 | route | shared_core | s1 | 6 | --router.automatic_neckdown=false --router.hole_clearance_um=250 --router.copper_to_edge_clearance_um=500 --router.fanout.enabled=false --router.scoring.via_costs=20 --router.scoring.plane_via_costs=2 | (via "Via[0-5]_450:200_um" "Via[0-5]_600:300_um") (width 127) (clearance 127) | Ground vias placed before routing: 206; no room beside 1 pads: ['U401.24']; Decoupling capacitors wired to their pins before routing: 49; no short path: ['C222->A101.39', 'C312->U302.5', 'C319->U302.4', 'C503->U501.8', 'C601->U601.16', 'C604->U601.15'] | 597 | 26 | 18.3 | analogue_board_shared_core_6L_dec_s1_autoroute_trial.kicad_pcb | by9bter5w.output
2026-10-16 17:17 | route | shared_core | s2 | 6 | --router.automatic_neckdown=false --router.hole_clearance_um=250 --router.copper_to_edge_clearance_um=500 | (via "Via[0-5]_450:200_um" "Via[0-5]_600:300_um") (width 127) (clearance 127) |  | 26 | 9 | 9.6 | analogue_board_shared_core_6L_dec_s1_s2_autoroute_trial.kicad_pcb | by9bter5w.output
2026-10-16 17:19 | finish | shared_core | finish |  |  |  |  |  | 2 |  | analogue_board_shared_core_6L_dec_s1_s2_autoroute_trial_finished.kicad_pcb | b5magchhg.output
2026-10-16 17:43 | route | shared_core | s1 | 6 | --router.automatic_neckdown=false --router.hole_clearance_um=250 --router.copper_to_edge_clearance_um=500 --router.fanout.enabled=false --router.scoring.via_costs=20 --router.scoring.plane_via_costs=2 | (via "Via[0-5]_450:200_um" "Via[0-5]_600:300_um") (width 127) (clearance 127) | Ground vias placed before routing: 205; no room beside 2 pads: ['R503.2', 'U401.24']; Decoupling capacitors wired to their pins before routing: 48; no short path: ['C220->U204.3', 'C222->A101.39', 'C312->U302.5', 'C319->U302.4', 'C503->U501.8', 'C601->U601.16', 'C604->U601.15'] | 599 | 24 | 12.4 | analogue_board_shared_core_6L_dec2_s1_autoroute_trial.kicad_pcb | bzlqqxq0i.output
2026-10-16 17:43 | route | shared_core | s2 | 6 | --router.automatic_neckdown=false --router.hole_clearance_um=250 --router.copper_to_edge_clearance_um=500 | (via "Via[0-5]_450:200_um" "Via[0-5]_600:300_um") (width 127) (clearance 127) |  | 24 | 7 | 7.9 | analogue_board_shared_core_6L_dec2_s1_s2_autoroute_trial.kicad_pcb | bzlqqxq0i.output
2026-10-16 17:48 | finish | shared_core | finish |  |  |  |  |  | 2 |  | analogue_board_shared_core_6L_dec2_s1_s2_autoroute_trial_finished.kicad_pcb | bn5xhwcgi.output
2026-10-16 19:42 | route | shared_core | s1 | 6 | --router.automatic_neckdown=false --router.hole_clearance_um=250 --router.copper_to_edge_clearance_um=500 --router.fanout.enabled=false --router.scoring.via_costs=20 --router.scoring.plane_via_costs=2 | (via "Via[0-5]_450:200_um" "Via[0-5]_600:300_um") (width 100) (clearance 100) | Ground vias placed before routing: 205; no room beside 2 pads: ['R503.2', 'U401.24']; Decoupling capacitors wired to their pins before routing: 48; no short path: ['C220->U204.3', 'C222->A101.39', 'C312->U302.5', 'C319->U302.4', 'C503->U501.8', 'C601->U601.16', 'C604->U601.15'] | 599 | 57 | 28.6 | analogue_board_shared_core_6L_fine_s1_autoroute_trial.kicad_pcb | bxkgl891j.output
2026-10-16 20:27 | route | pico_core_midi | s1 | 6 | --router.automatic_neckdown=false --router.hole_clearance_um=250 --router.copper_to_edge_clearance_um=500 --router.fanout.enabled=false --router.scoring.via_costs=20 --router.scoring.plane_via_costs=2 | (via "Via[0-5]_450:200_um" "Via[0-5]_600:300_um") (width 127) (clearance 127) | Ground vias placed before routing: 204; no room beside 3 pads: ['C409.2', 'C801.2', 'U401.24']; Decoupling capacitors wired to their pins before routing: 51; no short path: ['C221->U204.2', 'C403->U401.9', 'C406->U401.7', 'C513->U504.4'] | 569 | 48 | 20.1 | analogue_board_pico_core_midi_6L_pm3_s1_autoroute_trial.kicad_pcb | b443tf4gg.output
2026-10-16 20:27 | route | pico_core_midi | s2 | 6 | --router.automatic_neckdown=false --router.hole_clearance_um=250 --router.copper_to_edge_clearance_um=500 | (via "Via[0-5]_450:200_um" "Via[0-5]_600:300_um") (width 127) (clearance 127) |  | 48 | 21 | 13.6 | analogue_board_pico_core_midi_6L_pm3_s1_s2_autoroute_trial.kicad_pcb | b443tf4gg.output
2026-10-16 20:43 | route | teensy_core_midi | s1 | 6 | --router.automatic_neckdown=false --router.hole_clearance_um=250 --router.copper_to_edge_clearance_um=500 --router.fanout.enabled=false --router.scoring.via_costs=20 --router.scoring.plane_via_costs=2 | (via "Via[0-5]_450:200_um" "Via[0-5]_600:300_um") (width 127) (clearance 127) | Ground vias placed before routing: 205; no room beside 1 pads: ['U401.22']; Decoupling capacitors wired to their pins before routing: 54; no short path: ['C408->U401.5'] | 558 | 13 | 7.4 | analogue_board_teensy_core_midi_6L_tm_s1_autoroute_trial.kicad_pcb | bgtjk9wnq.output
2026-10-16 20:43 | route | teensy_core_midi | s2 | 6 | --router.automatic_neckdown=false --router.hole_clearance_um=250 --router.copper_to_edge_clearance_um=500 | (via "Via[0-5]_450:200_um" "Via[0-5]_600:300_um") (width 127) (clearance 127) |  | 13 | 9 | 8.1 | analogue_board_teensy_core_midi_6L_tm_s1_s2_autoroute_trial.kicad_pcb | bgtjk9wnq.output
2026-10-16 20:47 | finish | teensy_core_midi | finish |  |  |  |  |  | 1 |  | analogue_board_teensy_core_midi_6L_tm_s1_s2_autoroute_trial_finished.kicad_pcb | bp4yqkcxo.output
2026-10-16 20:52 | finish | teensy_core_midi | finish |  |  |  |  |  | 0 |  | analogue_board_teensy_core_midi_6L_tm_s1_s2_autoroute_trial_finished2.kicad_pcb | b2wx5wj10.output
2026-10-16 23:54 | route | pico_core_midi | s1 | 6 | --router.automatic_neckdown=false --router.hole_clearance_um=250 --router.copper_to_edge_clearance_um=500 --router.fanout.enabled=false --router.scoring.via_costs=20 --router.scoring.plane_via_costs=2 | (via "Via[0-5]_450:200_um" "Via[0-5]_600:300_um") (width 127) (clearance 127) | Ground vias placed before routing: 204; no room beside 3 pads: ['C409.2', 'C801.2', 'U401.22']; Decoupling capacitors wired to their pins before routing: 54; no short path: ['C408->U401.5'] | 549 | 35 | 15.4 | analogue_board_pico_core_midi_6L_pA_s1_autoroute_trial.kicad_pcb | b1r5et0jo.output
2026-10-16 23:54 | route | pico_core_midi | s2 | 6 | --router.automatic_neckdown=false --router.hole_clearance_um=250 --router.copper_to_edge_clearance_um=500 | (via "Via[0-5]_450:200_um" "Via[0-5]_600:300_um") (width 127) (clearance 127) |  | 35 | 17 | 7.2 | analogue_board_pico_core_midi_6L_pA_s1_s2_autoroute_trial.kicad_pcb | b1r5et0jo.output
2026-10-17 00:14 | route | pico_core_midi | s1 | 6 | --router.automatic_neckdown=false --router.hole_clearance_um=250 --router.copper_to_edge_clearance_um=500 --router.fanout.enabled=false --router.scoring.via_costs=20 --router.scoring.plane_via_costs=2 | (via "Via[0-5]_450:200_um" "Via[0-5]_600:300_um") (width 127) (clearance 127) | Plane for +5VD on In4: Plane for +5VD on In4; Ground vias placed before routing: 204; no room beside 3 pads: ['C409.2', 'C801.2', 'U401.22']; +5VD vias placed before routing: 25; no room beside 0 pads: []; Decoupling capacitors wired to their pins before routing: 54; no short path: ['C408->U401.5'] | 528 | 14 | 9.8 | analogue_board_pico_core_midi_6L_pB_s1_autoroute_trial.kicad_pcb | boljfq2dm.output
2026-10-17 00:14 | route | pico_core_midi | s2 | 6 | --router.automatic_neckdown=false --router.hole_clearance_um=250 --router.copper_to_edge_clearance_um=500 | (via "Via[0-5]_450:200_um" "Via[0-5]_600:300_um") (width 127) (clearance 127) |  | 14 | 9 | 9.9 | analogue_board_pico_core_midi_6L_pB_s1_s2_autoroute_trial.kicad_pcb | boljfq2dm.output
2026-10-17 05:46 | finish | pico_core_midi | finish |  |  |  |  |  | 1 |  | analogue_board_pico_core_midi_6L_pB_s1_s2_autoroute_trial_finished.kicad_pcb | pB_finish.log
2026-10-17 05:46 | finish | pico_core_midi | finish |  |  |  |  |  | 2 |  | analogue_board_pico_core_midi_6L_pA_s1_s2_autoroute_trial_finished.kicad_pcb | pA_finish.log
2026-10-17 06:10 | route | pico_core_midi | s1 | 6 | --router.automatic_neckdown=false --router.hole_clearance_um=250 --router.copper_to_edge_clearance_um=500 --router.fanout.enabled=false --router.scoring.via_costs=20 --router.scoring.plane_via_costs=2 | (via "Via[0-5]_450:200_um" "Via[0-5]_600:300_um") (width 127) (clearance 127) | Plane for +5VD on In4: Plane for +5VD on In4; Ground vias placed before routing: 205; no room beside 2 pads: ['C801.2', 'U401.22']; +5VD vias placed before routing: 25; no room beside 0 pads: []; Decoupling capacitors wired to their pins before routing: 54; no short path: ['C408->U401.5'] | 527 | 28 | 11.9 | analogue_board_pico_core_midi_6L_pB2_s1_autoroute_trial.kicad_pcb | pB2_route.log
2026-10-17 06:10 | route | pico_core_midi | s2 | 6 | --router.automatic_neckdown=false --router.hole_clearance_um=250 --router.copper_to_edge_clearance_um=500 | (via "Via[0-5]_450:200_um" "Via[0-5]_600:300_um") (width 127) (clearance 127) |  | 28 | 18 | 11.1 | analogue_board_pico_core_midi_6L_pB2_s1_s2_autoroute_trial.kicad_pcb | pB2_route.log
2026-10-17 06:11 | finish | pico_core_midi | finish |  |  |  |  |  | 1 |  | analogue_board_pico_core_midi_6L_pB2_s1_s2_autoroute_trial_finished.kicad_pcb | pB2_finish.log
2026-10-26 | route | pico_revb | s1 | 6 | 20 passes; --staged --stages=2 --ground-vias --decoupling --plane=+5VD | (width 127) (clearance 127) | ground vias 201, decoupling wired 52 | 517 | 9 |  | rB1_s1 | 20261026-rB1_route.log
2026-10-26 | route | pico_revb | s2 | 6 |  | (width 127) (clearance 127) |  | 9 | 7 |  | rB1_s1_s2 | 20261026-rB1_route.log
2026-10-26 | finish | pico_revb | finish |  |  |  |  |  | 2 |  | rB1_finished | 20261026-rB1_finish.log
2026-10-26 | route | pico_revb | s1 | 6 | 20 passes; --staged --stages=2 --ground-vias --decoupling --plane=+5VD | (width 127) (clearance 127) | ground vias 200, decoupling wired 53 | 517 | 20 |  | rB4_s1 | 20261026-rB4_route.log
2026-10-26 | route | pico_revb | s2 | 6 |  | (width 127) (clearance 127) |  | 20 | 15 |  | rB4_s1_s2 | 20261026-rB4_route.log
2026-10-26 | route | pico_revb | s1 | 6 | 20 passes; --staged --stages=2 --ground-vias --decoupling --plane=+5VD | (width 127) (clearance 127) | ground vias 202, decoupling wired 52 | 515 | 24 |  | rB5_s1 | 20261026-rB5_route.log
2026-10-26 | route | pico_revb | s2 | 6 |  | (width 127) (clearance 127) |  | 24 | 16 |  | rB5_s1_s2 | 20261026-rB5_route.log
2026-10-26 | route | pico_revb | s1 | 6 | 20 passes; --staged --stages=2 --ground-vias --decoupling --plane=+5VD | (width 127) (clearance 127) | ground vias 202, decoupling wired 51 | 517 | 9 |  | rB6_s1 | 20261026-rB6_route.log
2026-10-26 | route | pico_revb | s2 | 6 |  | (width 127) (clearance 127) |  | 9 | 6 |  | rB6_s1_s2 | 20261026-rB6_route.log
2026-10-26 | finish | pico_revb | finish |  |  |  |  |  | 0 |  | rB6_finished | 20261026-rB6_finish.log
2026-10-26 | route | pico_revb | s1 | 6 | 20 passes; --staged --stages=2 --ground-vias --decoupling --plane=+5VD | (width 127) (clearance 127) | ground vias 203, decoupling wired 49 | 518 | 7 |  | rB7_s1 | 20261026-rB7_route.log
2026-10-26 | route | pico_revb | s2 | 6 |  | (width 127) (clearance 127) |  | 7 | 6 |  | rB7_s1_s2 | 20261026-rB7_route.log
2026-10-26 | finish | pico_revb | finish |  |  |  |  |  | 3 |  | rB7_finished | 20261026-rB7_finish.log
2026-10-26 | route | pico_revb | s1 | 6 | 20 passes; --staged --stages=2 --ground-vias --decoupling --plane=+5VD | (width 127) (clearance 127) | ground vias 200, decoupling wired 54 | 518 | 7 |  | rB8_s1 | 20261026-rB8_route.log
2026-10-26 | route | pico_revb | s2 | 6 |  | (width 127) (clearance 127) |  | 7 | 4 |  | rB8_s1_s2 | 20261026-rB8_route.log
2026-10-26 | finish | pico_revb | finish |  |  |  |  |  | 1 |  | rB8_finished | 20261026-rB8_finish.log
2026-10-26 | route | pico_revb | s1 | 6 | 20 passes; --staged --stages=2 --ground-vias --decoupling --plane=+5VD | (width 127) (clearance 127) | ground vias 199, decoupling wired 55 | 518 | 6 |  | rB9_s1 | 20261026-rB9_route.log
2026-10-26 | route | pico_revb | s2 | 6 |  | (width 127) (clearance 127) |  | 6 | 2 |  | rB9_s1_s2 | 20261026-rB9_route.log
2026-10-26 | finish | pico_revb | finish |  |  |  |  |  | 1 |  | rB9_finished | 20261026-rB9_finish.log
2026-10-26 | route | pico_revb | s1 | 6 | 20 passes; --staged --stages=2 --ground-vias --decoupling --plane=+5VD | (width 127) (clearance 127) | ground vias 200, decoupling wired 55 | 517 | 26 |  | rB10_s1 | 20261026-rB10_route.log
2026-10-26 | route | pico_revb | s2 | 6 |  | (width 127) (clearance 127) |  | 26 | 16 |  | rB10_s1_s2 | 20261026-rB10_route.log
2026-10-26 | finish | pico_revb | finish |  |  |  |  |  | 2 |  | rB10_finished | 20261026-rB10_finish.log
2026-10-26 | route | pico_revb | s1 | 6 | 25 passes; --staged --stages=2 --ground-vias --decoupling --plane=+5VD | (width 127) (clearance 127) | ground vias 200, decoupling wired 55 | 517 | 26 |  | rB11_s1 | 20261026-rB11_route.log
2026-10-26 | route | pico_revb | s2 | 6 |  | (width 127) (clearance 127) |  | 26 | 13 |  | rB11_s1_s2 | 20261026-rB11_route.log
2026-10-26 | finish | pico_revb | finish |  |  |  |  |  | 2 |  | rB11_finished | 20261026-rB11_finish.log
2026-10-26 | route | pico_revb | s1 | 6 | 30 passes; --staged --stages=2 --ground-vias --decoupling --plane=+5VD | (width 127) (clearance 127) | ground vias 200, decoupling wired 55 | 517 | 26 |  | rB12_s1 | 20261026-rB12_route.log
2026-10-26 | route | pico_revb | s2 | 6 |  | (width 127) (clearance 127) |  | 26 | 13 |  | rB12_s1_s2 | 20261026-rB12_route.log
2026-10-26 | finish | pico_revb | finish |  |  |  |  |  | 2 |  | rB12_finished | 20261026-rB12_finish.log
2026-10-26 | route | pico_revb | s1 | 6 | 20 passes; --staged --stages=2 --ground-vias --decoupling --plane=+5VD | (width 127) (clearance 127) | ground vias 199, decoupling wired 55 | 518 | 44 |  | rB13_s1 | 20261026-rB13_route.log
2026-10-26 | route | pico_revb | s2 | 6 |  | (width 127) (clearance 127) |  | 44 | 19 |  | rB13_s1_s2 | 20261026-rB13_route.log
2026-10-26 | finish | pico_revb | finish |  |  |  |  |  | 4 |  | rB13_finished | 20261026-rB13_finish.log
2026-10-26 | route | pico_revb | s1 | 6 | 20 passes; --staged --stages=2 --ground-vias --decoupling --plane=+5VD | (width 127) (clearance 127) | ground vias 201, decoupling wired 54 | 517 | 1 |  | vA_s1 | 20261026-vA_route.log
2026-10-26 | route | pico_revb | s2 | 6 |  | (width 127) (clearance 127) |  | 1 | 1 |  | vA_s1_s2 | 20261026-vA_route.log
2026-10-26 | finish | pico_revb | finish |  |  |  |  |  | 0 |  | vA_finished | 20261026-vA_finish.log
2026-10-26 | route | pico_revb | s1 | 6 | 20 passes; --staged --stages=2 --ground-vias --decoupling --plane=+5VD | (width 127) (clearance 127) | ground vias 200, decoupling wired 55 | 517 | 5 |  | vB_s1 | 20261026-vB_route.log
2026-10-26 | route | pico_revb | s2 | 6 |  | (width 127) (clearance 127) |  | 5 | 2 |  | vB_s1_s2 | 20261026-vB_route.log
2026-10-26 | finish | pico_revb | finish |  |  |  |  |  | 0 |  | vB_finished | 20261026-vB_finish.log
2026-10-26 | route | pico_revb | s1 | 6 | 20 passes; --staged --stages=2 --ground-vias --decoupling --plane=+5VD | (width 127) (clearance 127) | ground vias 200, decoupling wired 55 | 517 | 28 |  | vC_s1 | 20261026-vC_route.log
2026-10-26 | route | pico_revb | s2 | 6 |  | (width 127) (clearance 127) |  | 28 | 15 |  | vC_s1_s2 | 20261026-vC_route.log
2026-10-26 | finish | pico_revb | finish |  |  |  |  |  | 0 |  | vC_finished | 20261026-vC_finish.log
