Eight4aWish/eurorack_electronics/docs/analogue_board_journal/images/01_checkpoint3_first_floorplan_outward.png

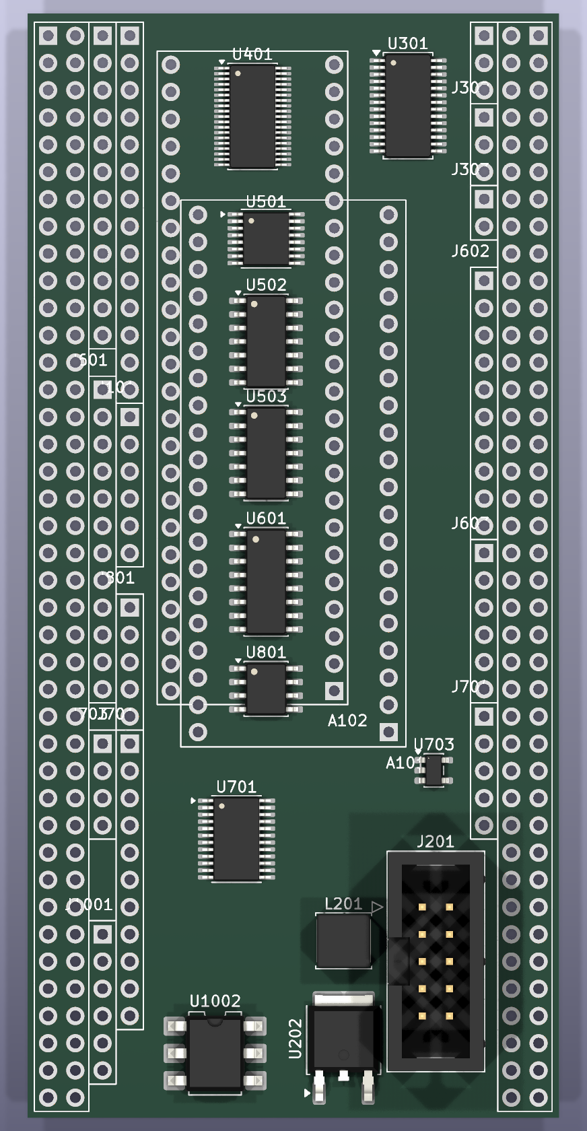
docs/analogue_board_journal/images/01_checkpoint3_first_floorplan_outward.png
