Eight4aWish/eurorack_electronics/docs/analogue_board_journal/images/04_split_pico_board_outward.png

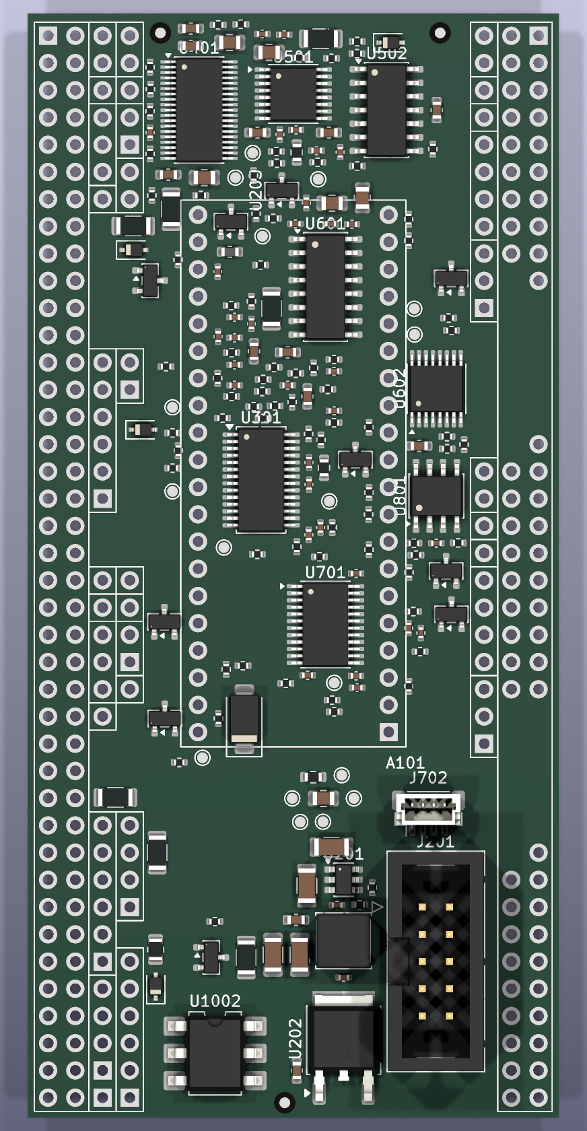
docs/analogue_board_journal/images/04_split_pico_board_outward.png
