Eight4aWish/eurorack_electronics/docs/analogue_board_journal/images/07_shared_core_staged_route_finished_deck.png

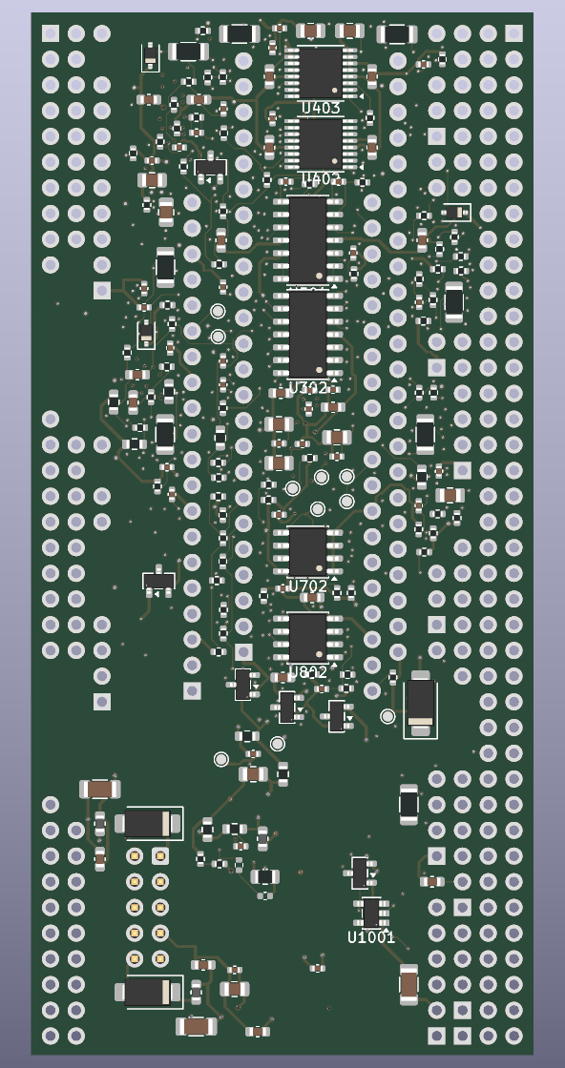
docs/analogue_board_journal/images/07_shared_core_staged_route_finished_deck.png
