Eight4aWish/eurorack_electronics/docs/analogue_board_journal/images/08_shared_core_ground_vias_first_deck.png

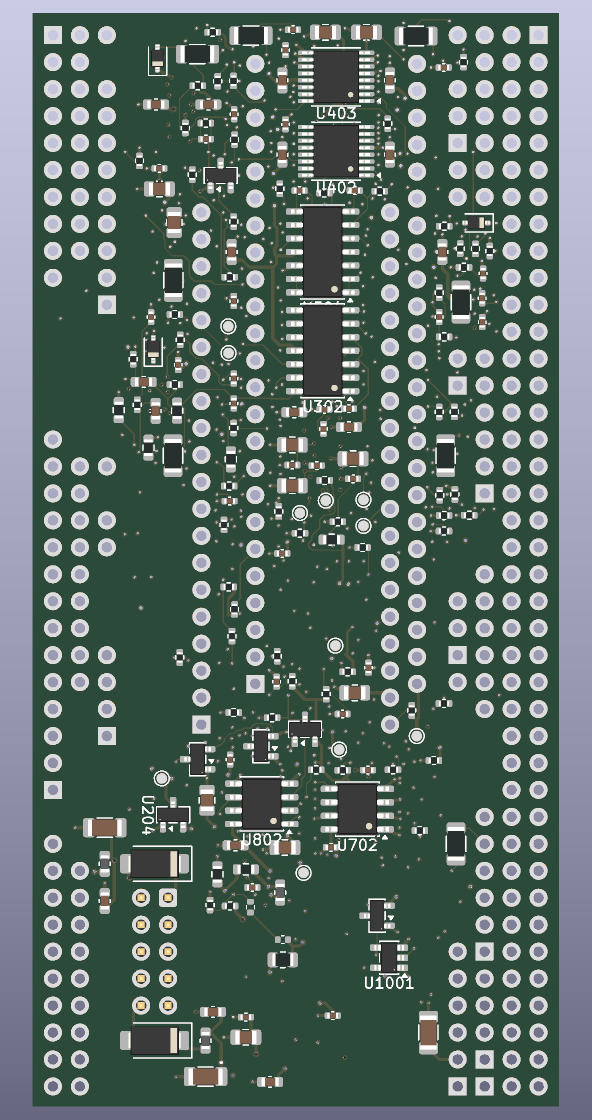
docs/analogue_board_journal/images/08_shared_core_ground_vias_first_deck.png
