Eight4aWish/eurorack_electronics/docs/analogue_board_journal/images/09_shared_core_switch_chips_moved_deck.png

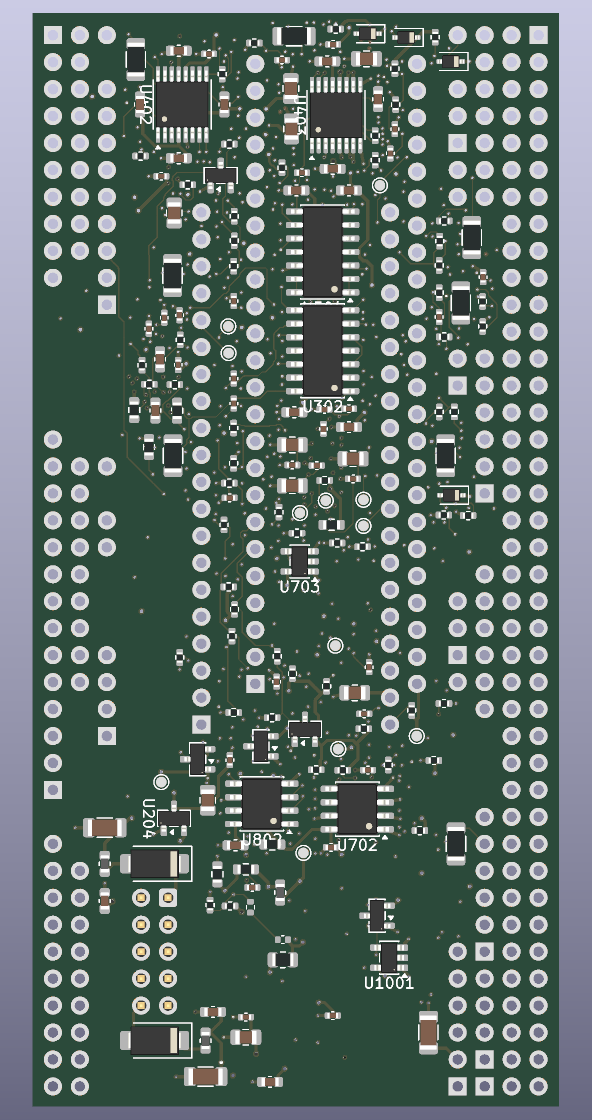
docs/analogue_board_journal/images/09_shared_core_switch_chips_moved_deck.png
