Eight4aWish/eurorack_electronics/docs/analogue_board_journal/images/14_pico_first_route_deck.png

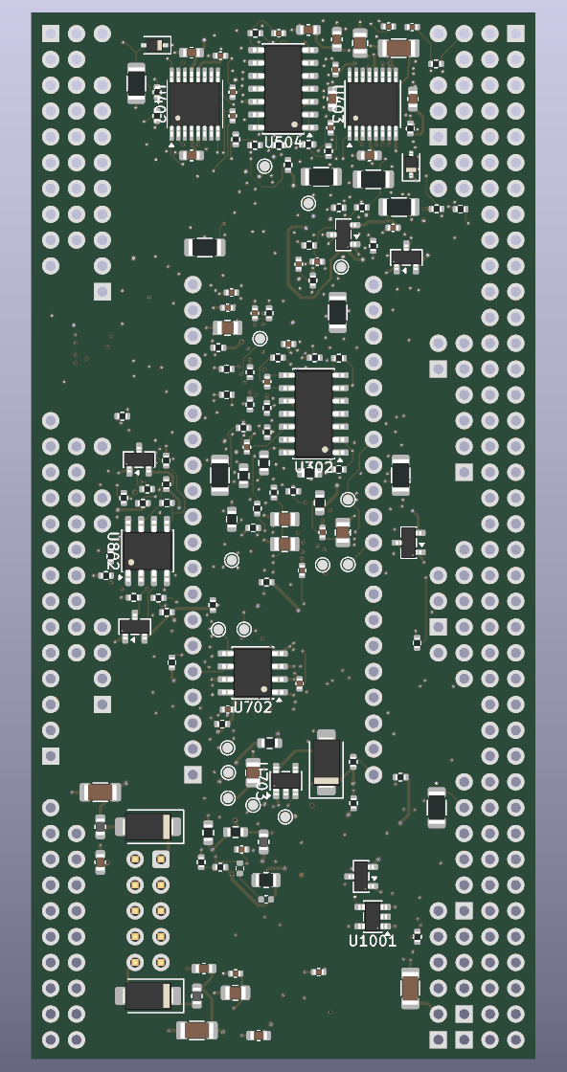
docs/analogue_board_journal/images/14_pico_first_route_deck.png
