Eight4aWish/eurorack_electronics/docs/analogue_board_journal/images/15_pico_standard_finished_2_open_deck.png

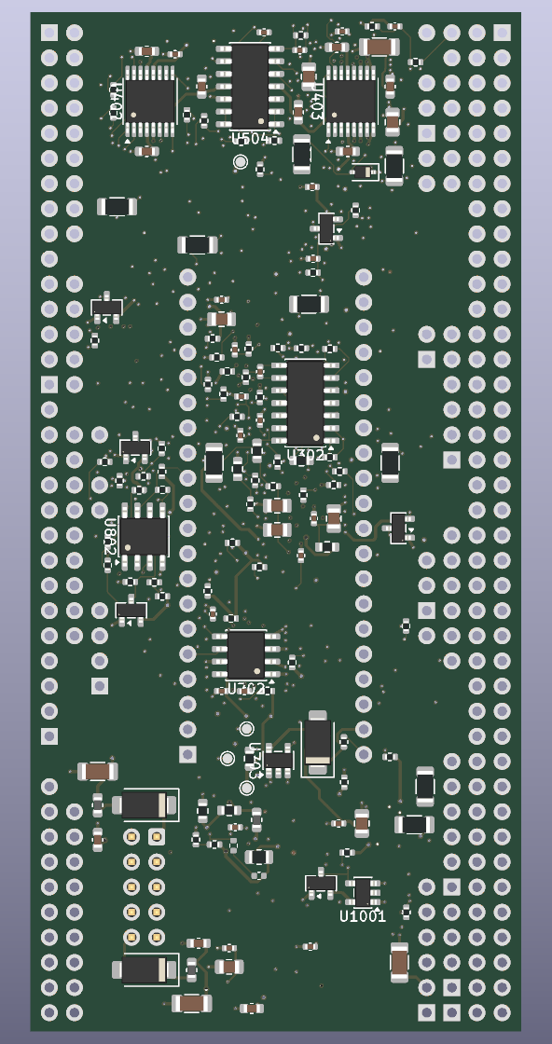
docs/analogue_board_journal/images/15_pico_standard_finished_2_open_deck.png
