Eight4aWish/eurorack_electronics/docs/analogue_board_journal/images/17_pico_top_relaid_fully_routed_outward.png

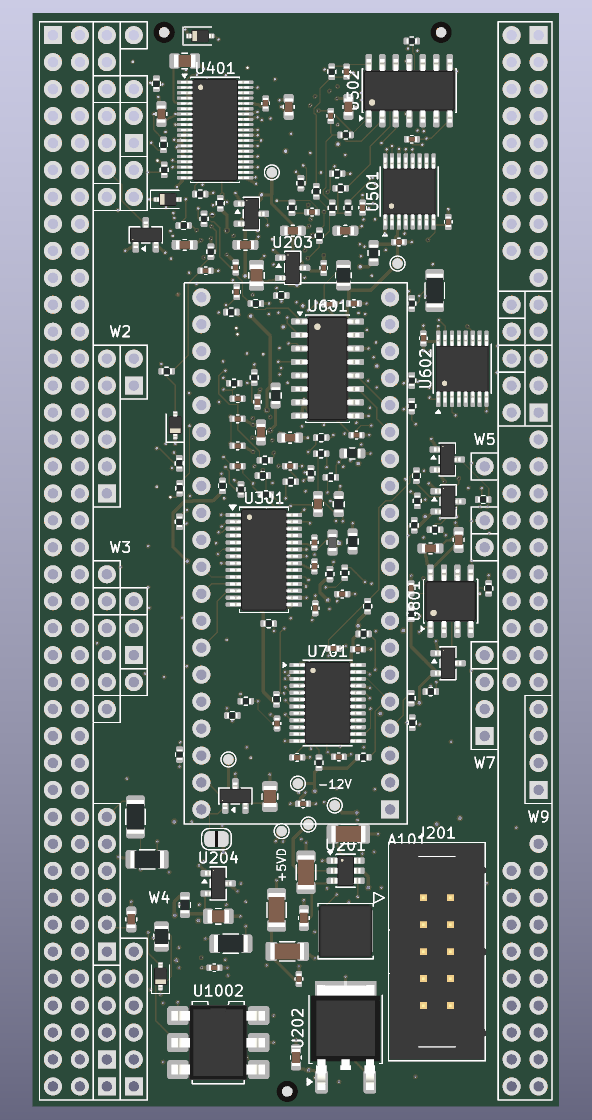
docs/analogue_board_journal/images/17_pico_top_relaid_fully_routed_outward.png
