Eight4aWish/eurorack_electronics/docs/analogue_board_journal/images/18_revb_fully_routed_deck.png

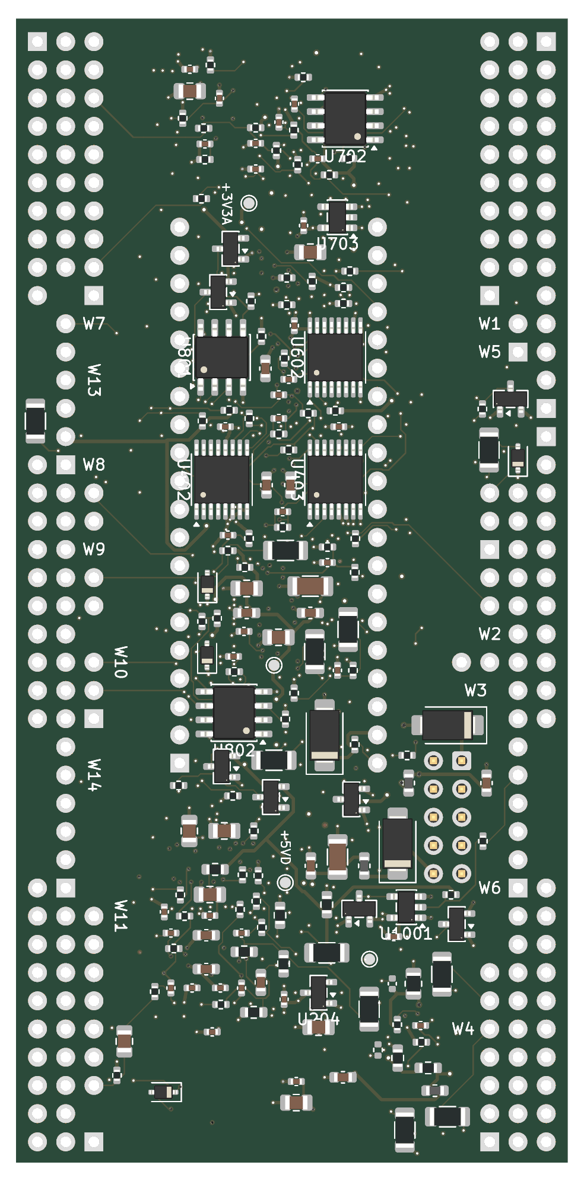
docs/analogue_board_journal/images/18_revb_fully_routed_deck.png
