Eight4aWish/eurorack_electronics/hardware/analogue_board/pico_core/analogue_board_pico_core_schematic.pdf

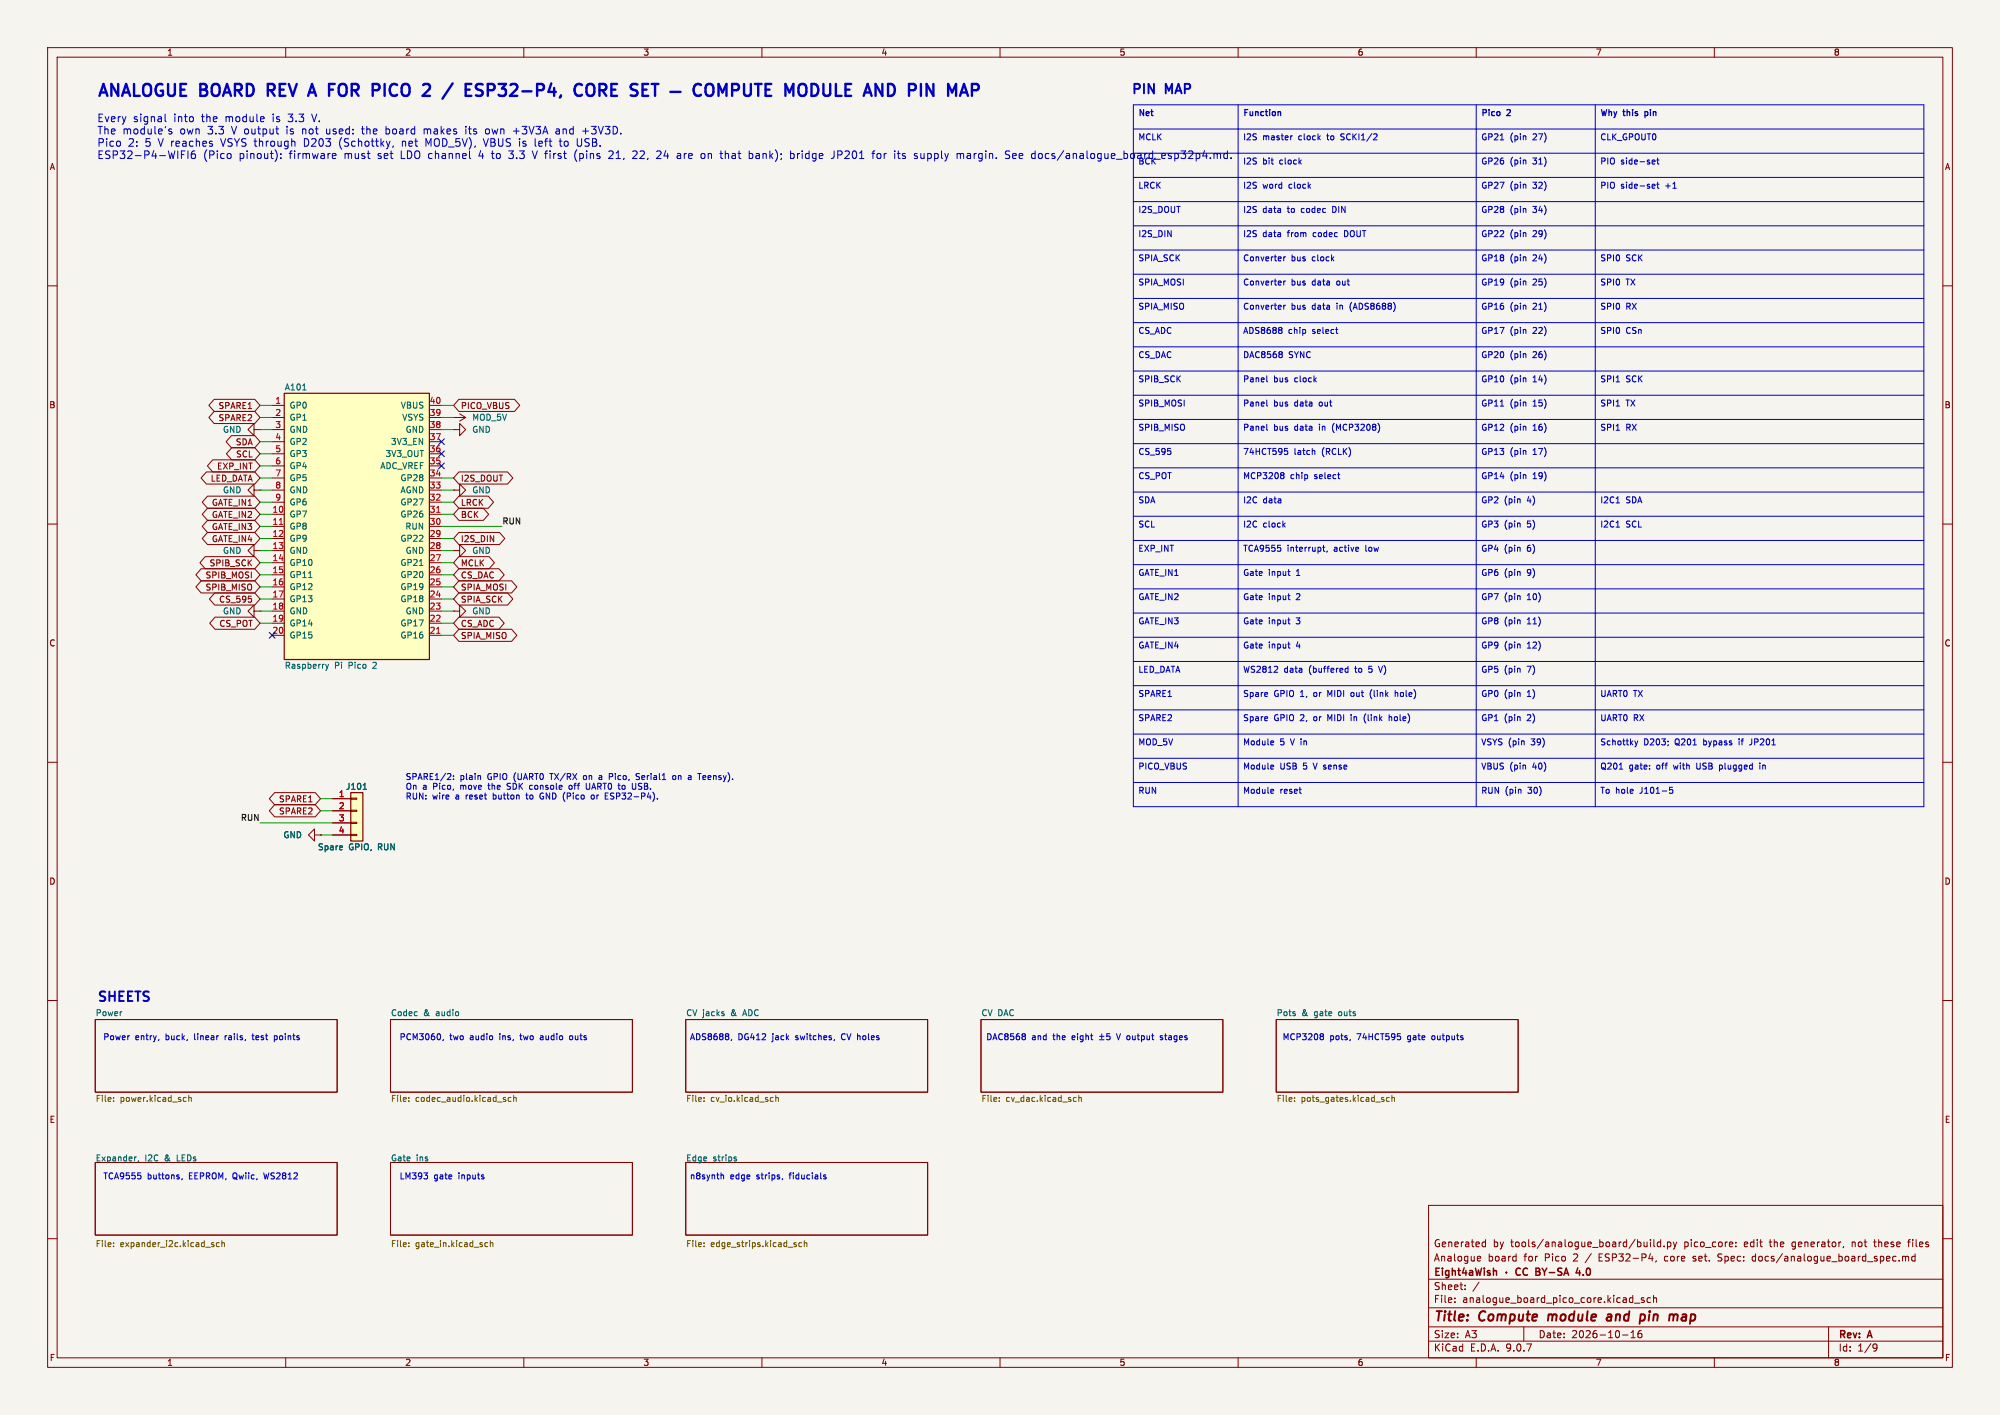
[picture p38: page 1]

Every signal into the module is 3.3 V.

File: cv_dac.kicad_sch CV jacks & ADC

Id: 1/9 Title: Compute module and pin map

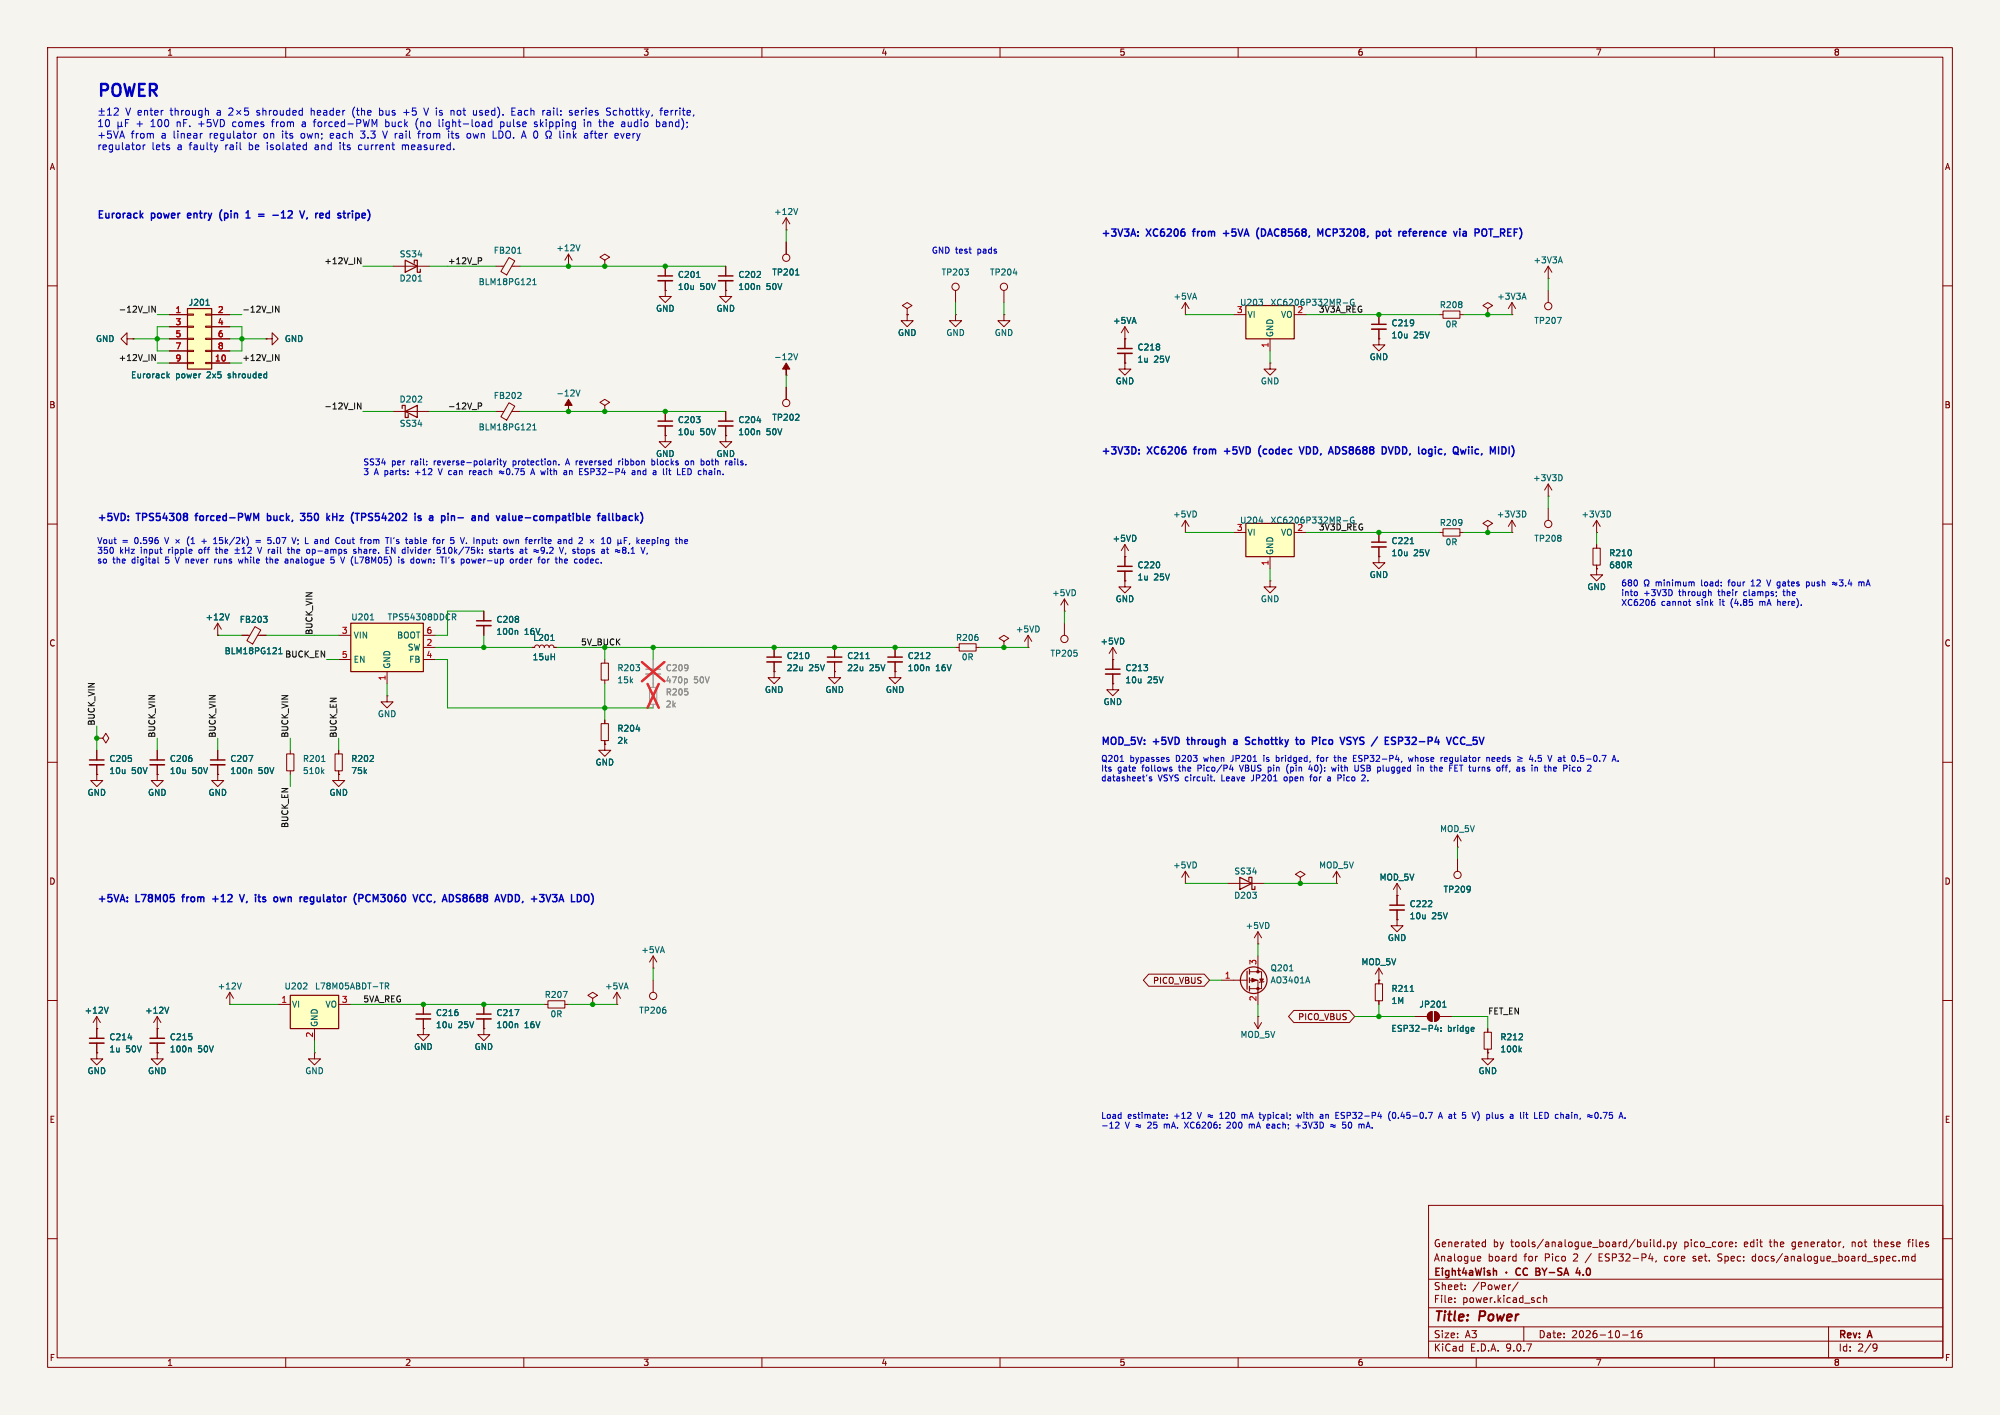
[picture p39: page 2]

1 BOOT 6 SW 2 FB 4 U201 TPS54308DDCR GND

1 VO 2 U204 XC6206P332MR-G MOD_5V GND GND GND MOD_5V

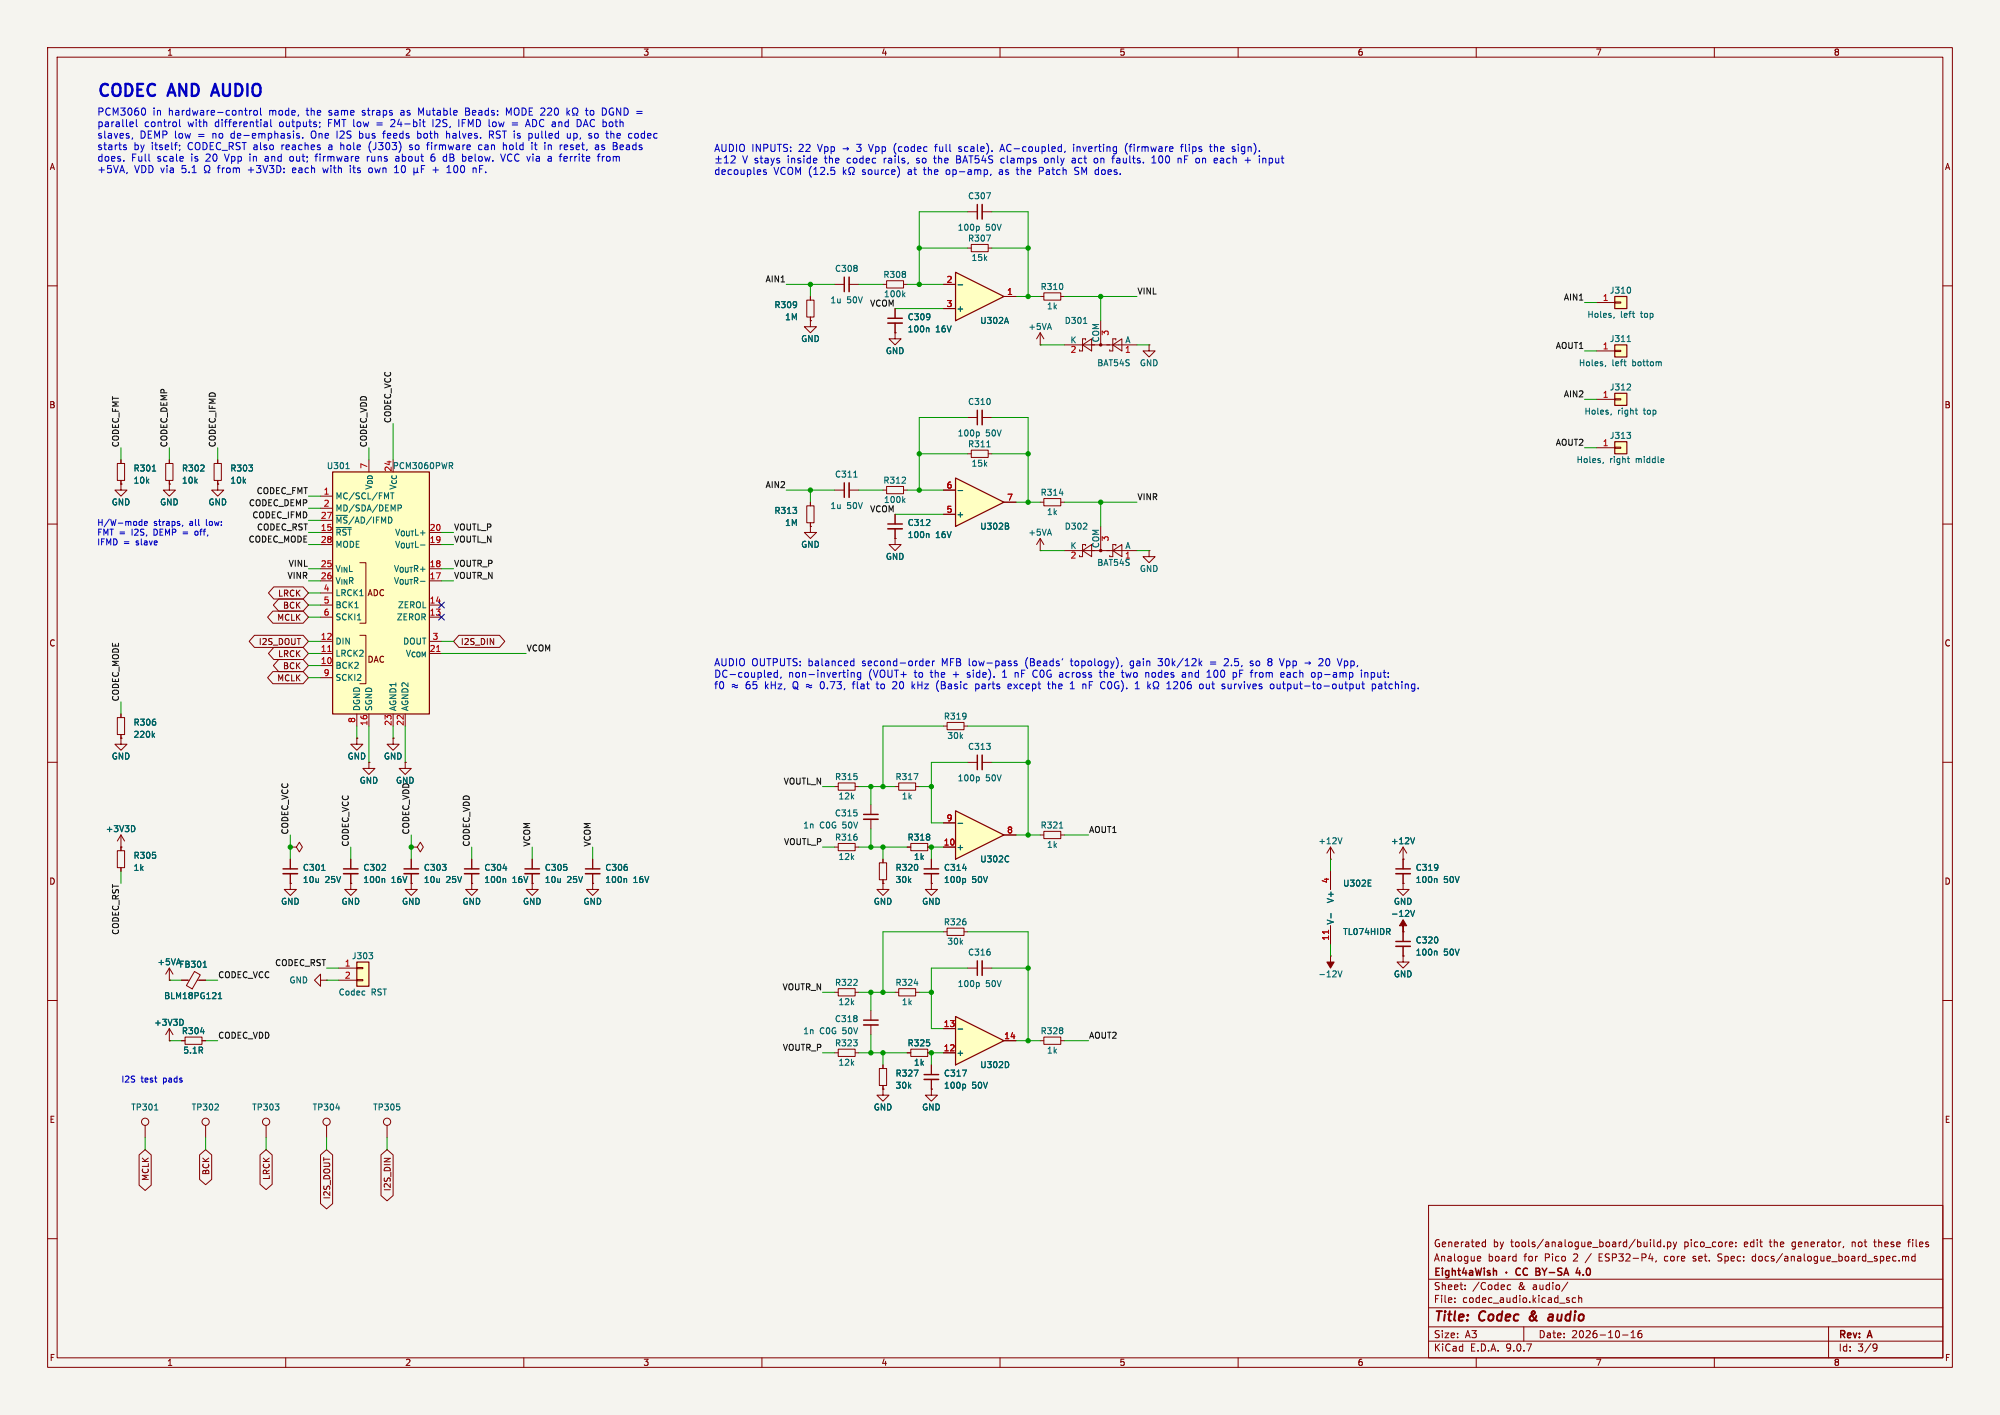
[picture p40: page 3]

+5VA, VDD via 5.1 þÿ©from +3V3D: each with its own 10 þÿµF+ 100 nF. CODEC AND AUDIO

þÿ±12V stays inside the codec rails, so the BAT54S clamps only act on faults. 100 nF on each + input

DAC MC/SCL/FMT 1 MD/SDA/DEMP 2 ~{MS}/AD/IFMD 27 ~{RST} 15 MODE 28 V_{IN}L 25 V_{IN}R 26

I2S_DIN I2S_DIN I2S_DOUT BCK LRCK MCLK MCLK

Id: 3/9 Title: Codec & audio

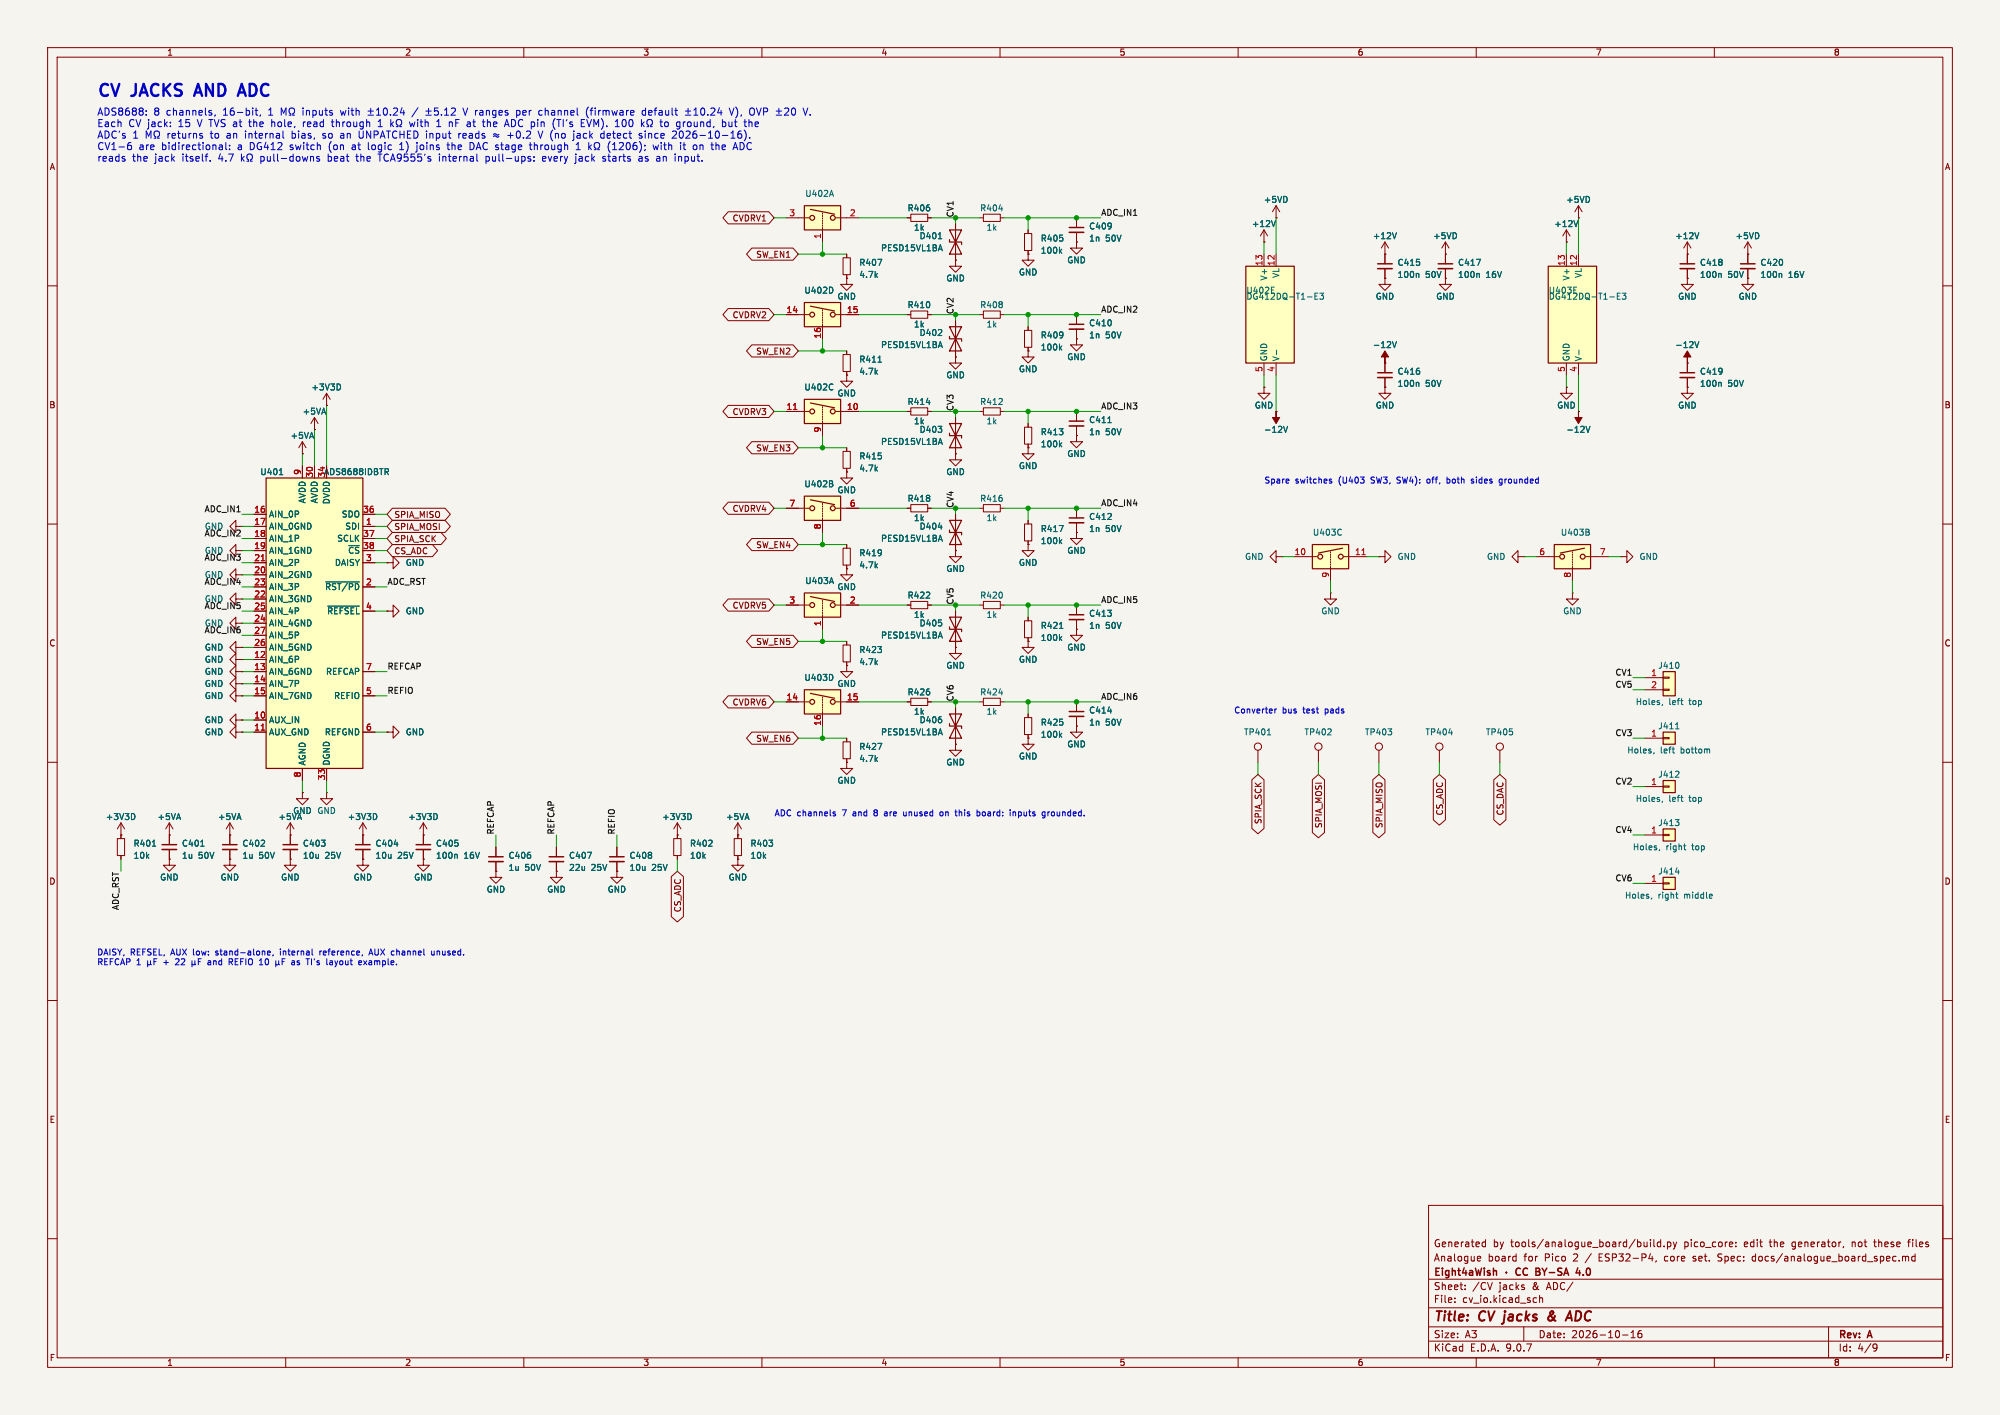
[picture p41: page 4]

CV JACKS AND ADC

J410 Holes, left top GND

8 AVDD 30 DVDD 34 DGND 33 SDO 36 SDI 1 SCLK 37 ~{CS} 38 DAISY 3 ~{RST/PD}2 ~{REFSEL}4 REFCAP 7 REFIO 5 REFGND 6 GND GND GND GND GND GND GND GND GND GND

8 AVDD 30 DVDD 34 DGND 33 SDO 36 SDI 1 SCLK 37 ~{CS} 38 DAISY 3 ~{RST/PD}2 ~{REFSEL}4 REFCAP 7 REFIO 5 REFGND 6 U401 ADS8688IDBTR GND GND

J412 Holes, left top GND

Id: 4/9 Title: CV jacks & ADC

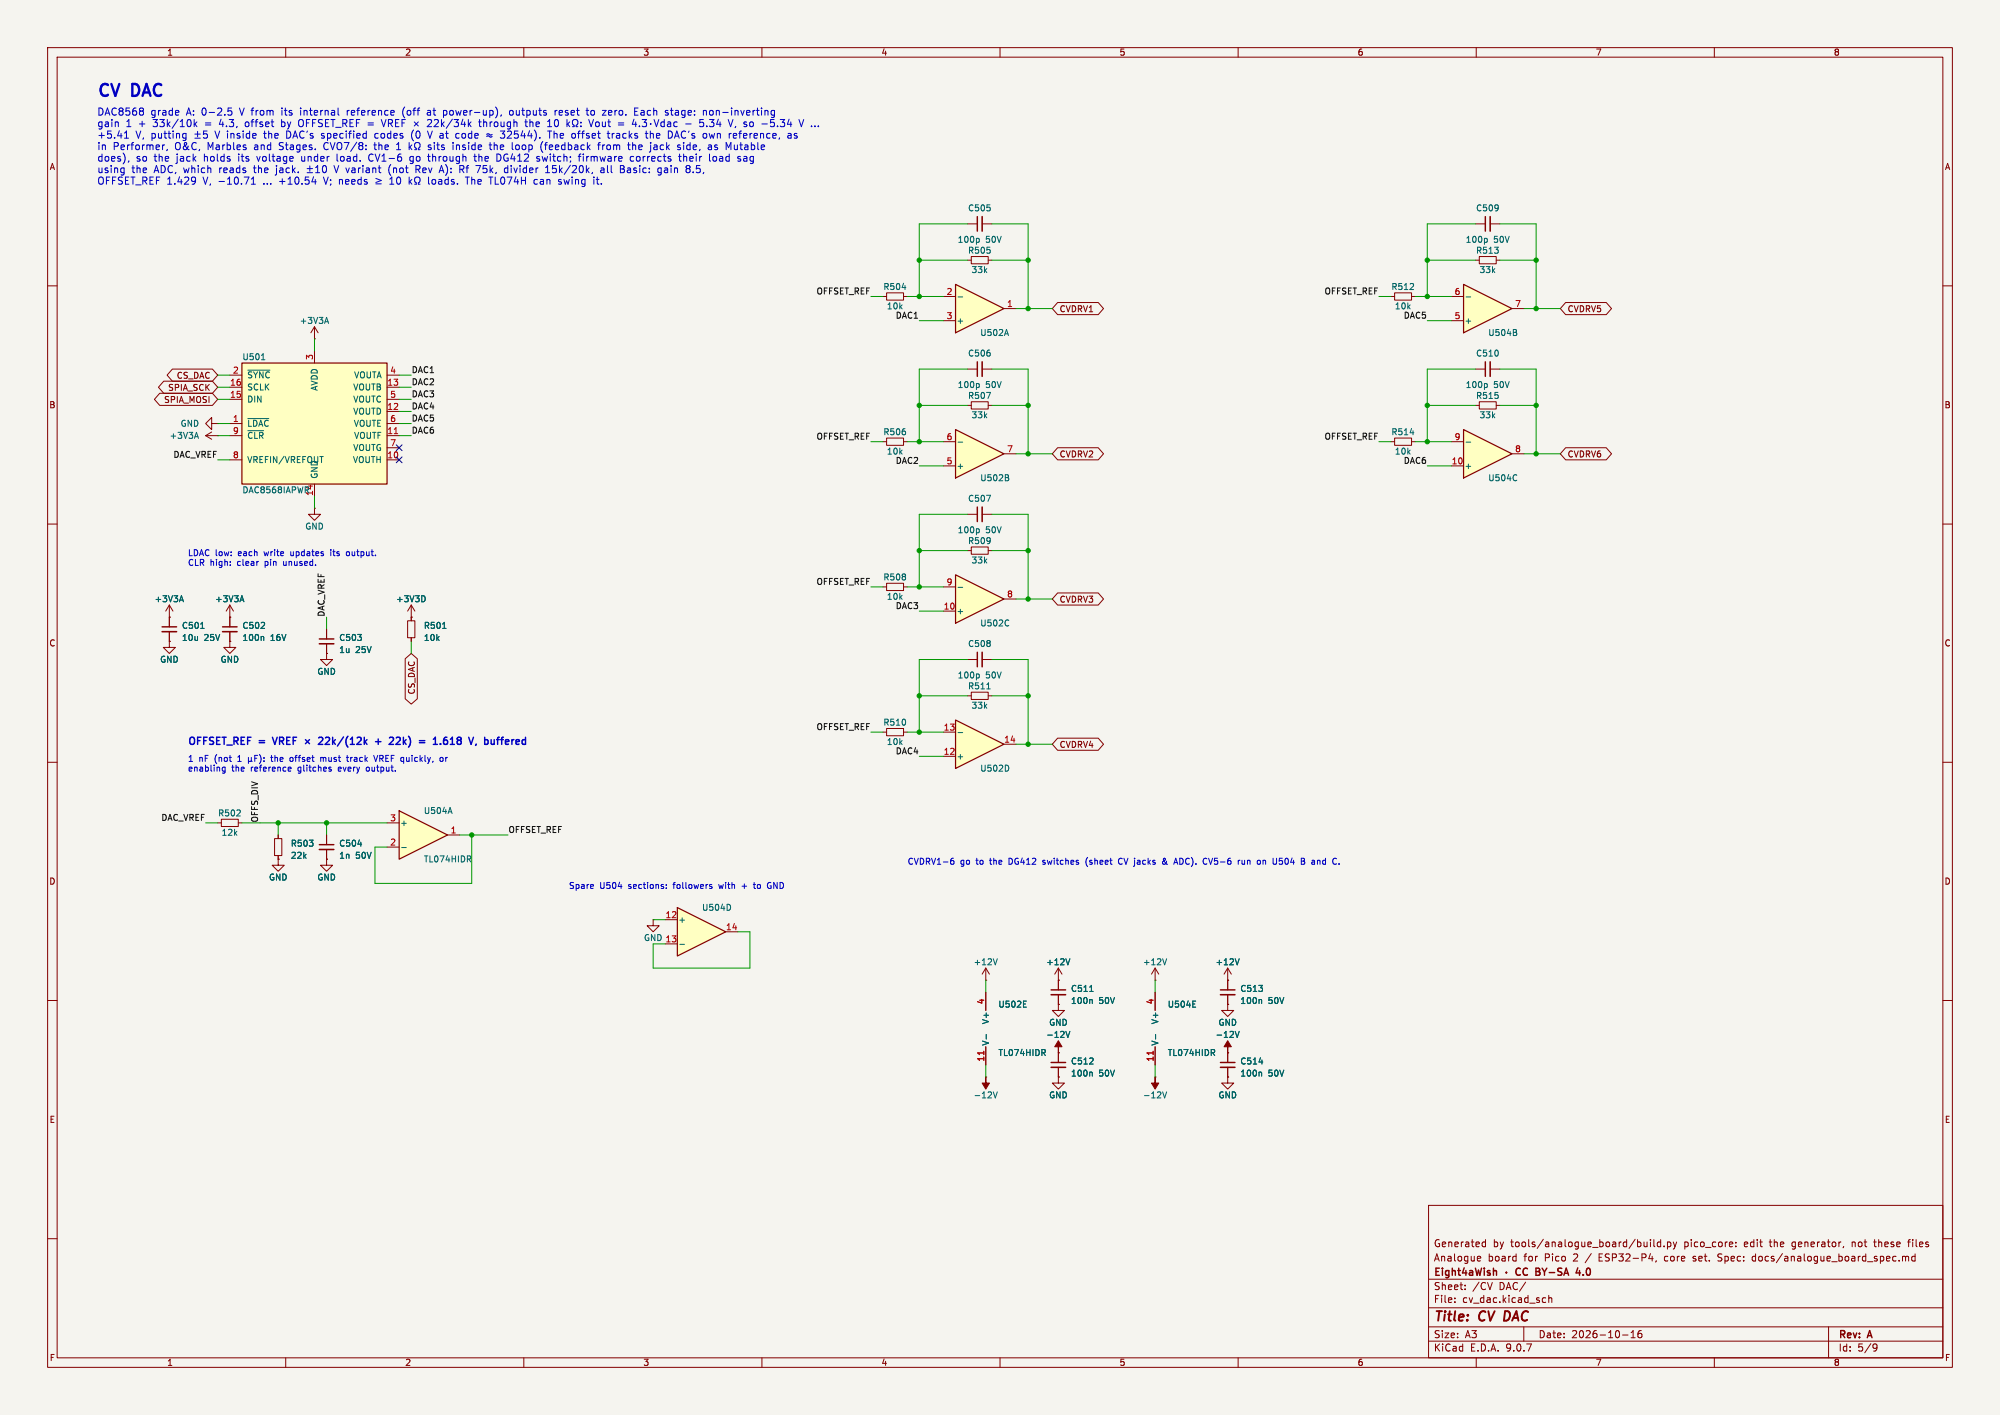
[picture p42: page 5]

3 GND 14 VOUTA 4 VOUTB 13 VOUTC 5 VOUTD 12 VOUTE 6 VOUTF 11 VOUTG 7 VOUTH 10 U501 DAC8568IAPWR

Id: 5/9 Title: CV DAC

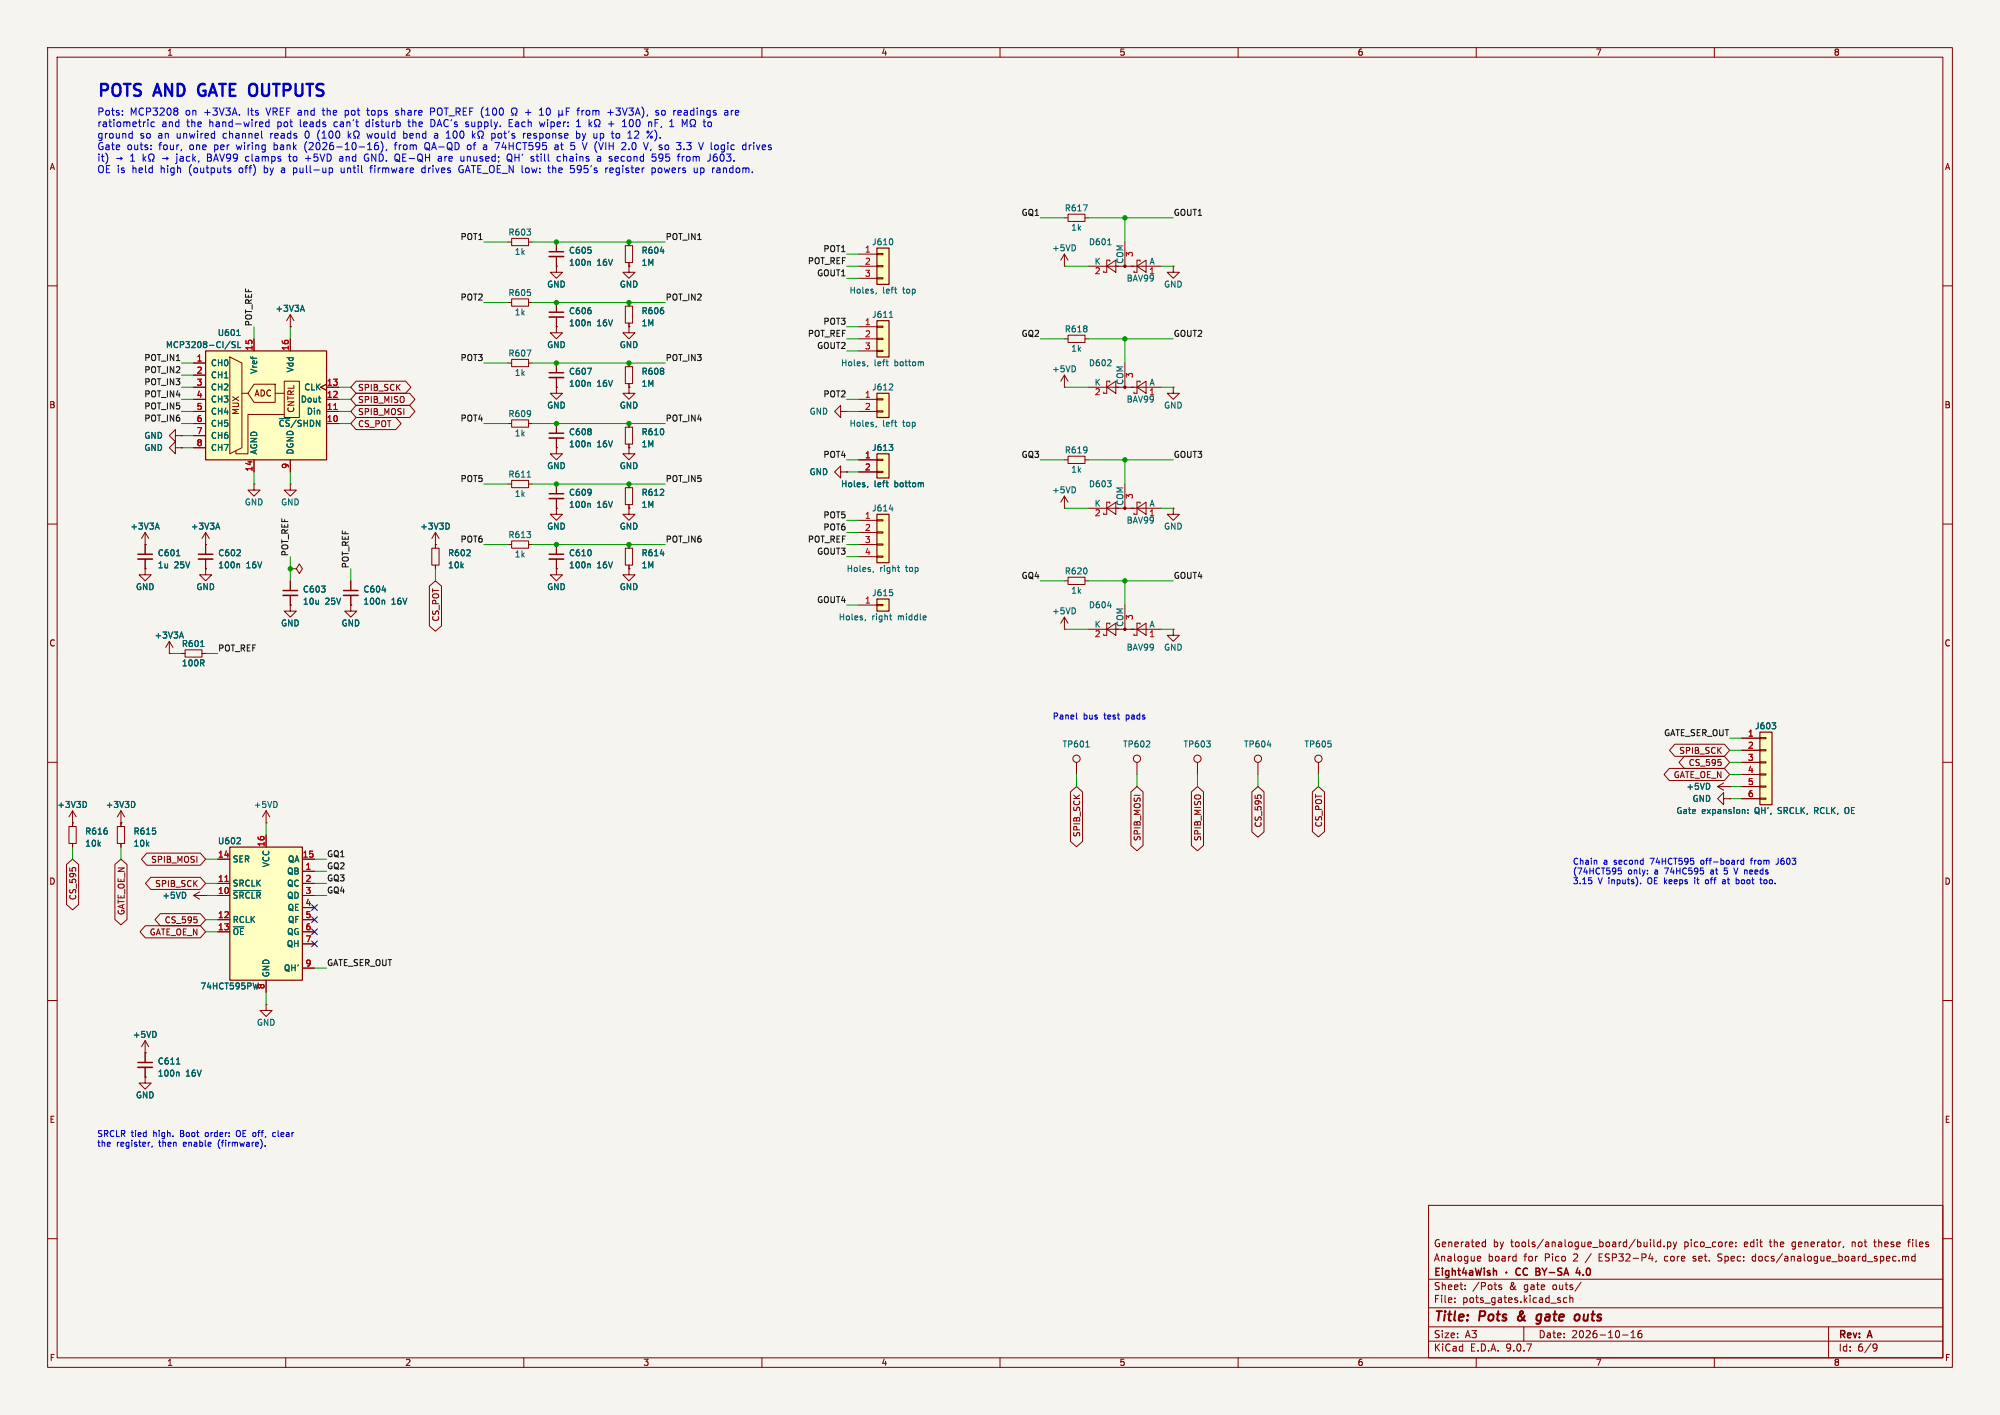
[picture p43: page 6]

POTS AND GATE OUTPUTS
Pots: MCP3208 on +3V3A. Its VREF and the pot tops share POT_REF (100 þÿ©+ 10 þÿµFfrom +3V3A), so readings are

9 CLK 13 Dout 12 Din 11 ~{CS}/SHDN10 U601 MCP3208-CI/SL +3V3A GND GND

9 CLK 13 Dout 12 Din 11 ~{CS}/SHDN10 +3V3A GND GND

J614 Holes, right top GND

Panel bus test pads

SRCLR tied high. Boot order: OE off, clear

Id: 6/9 Title: Pots & gate outs

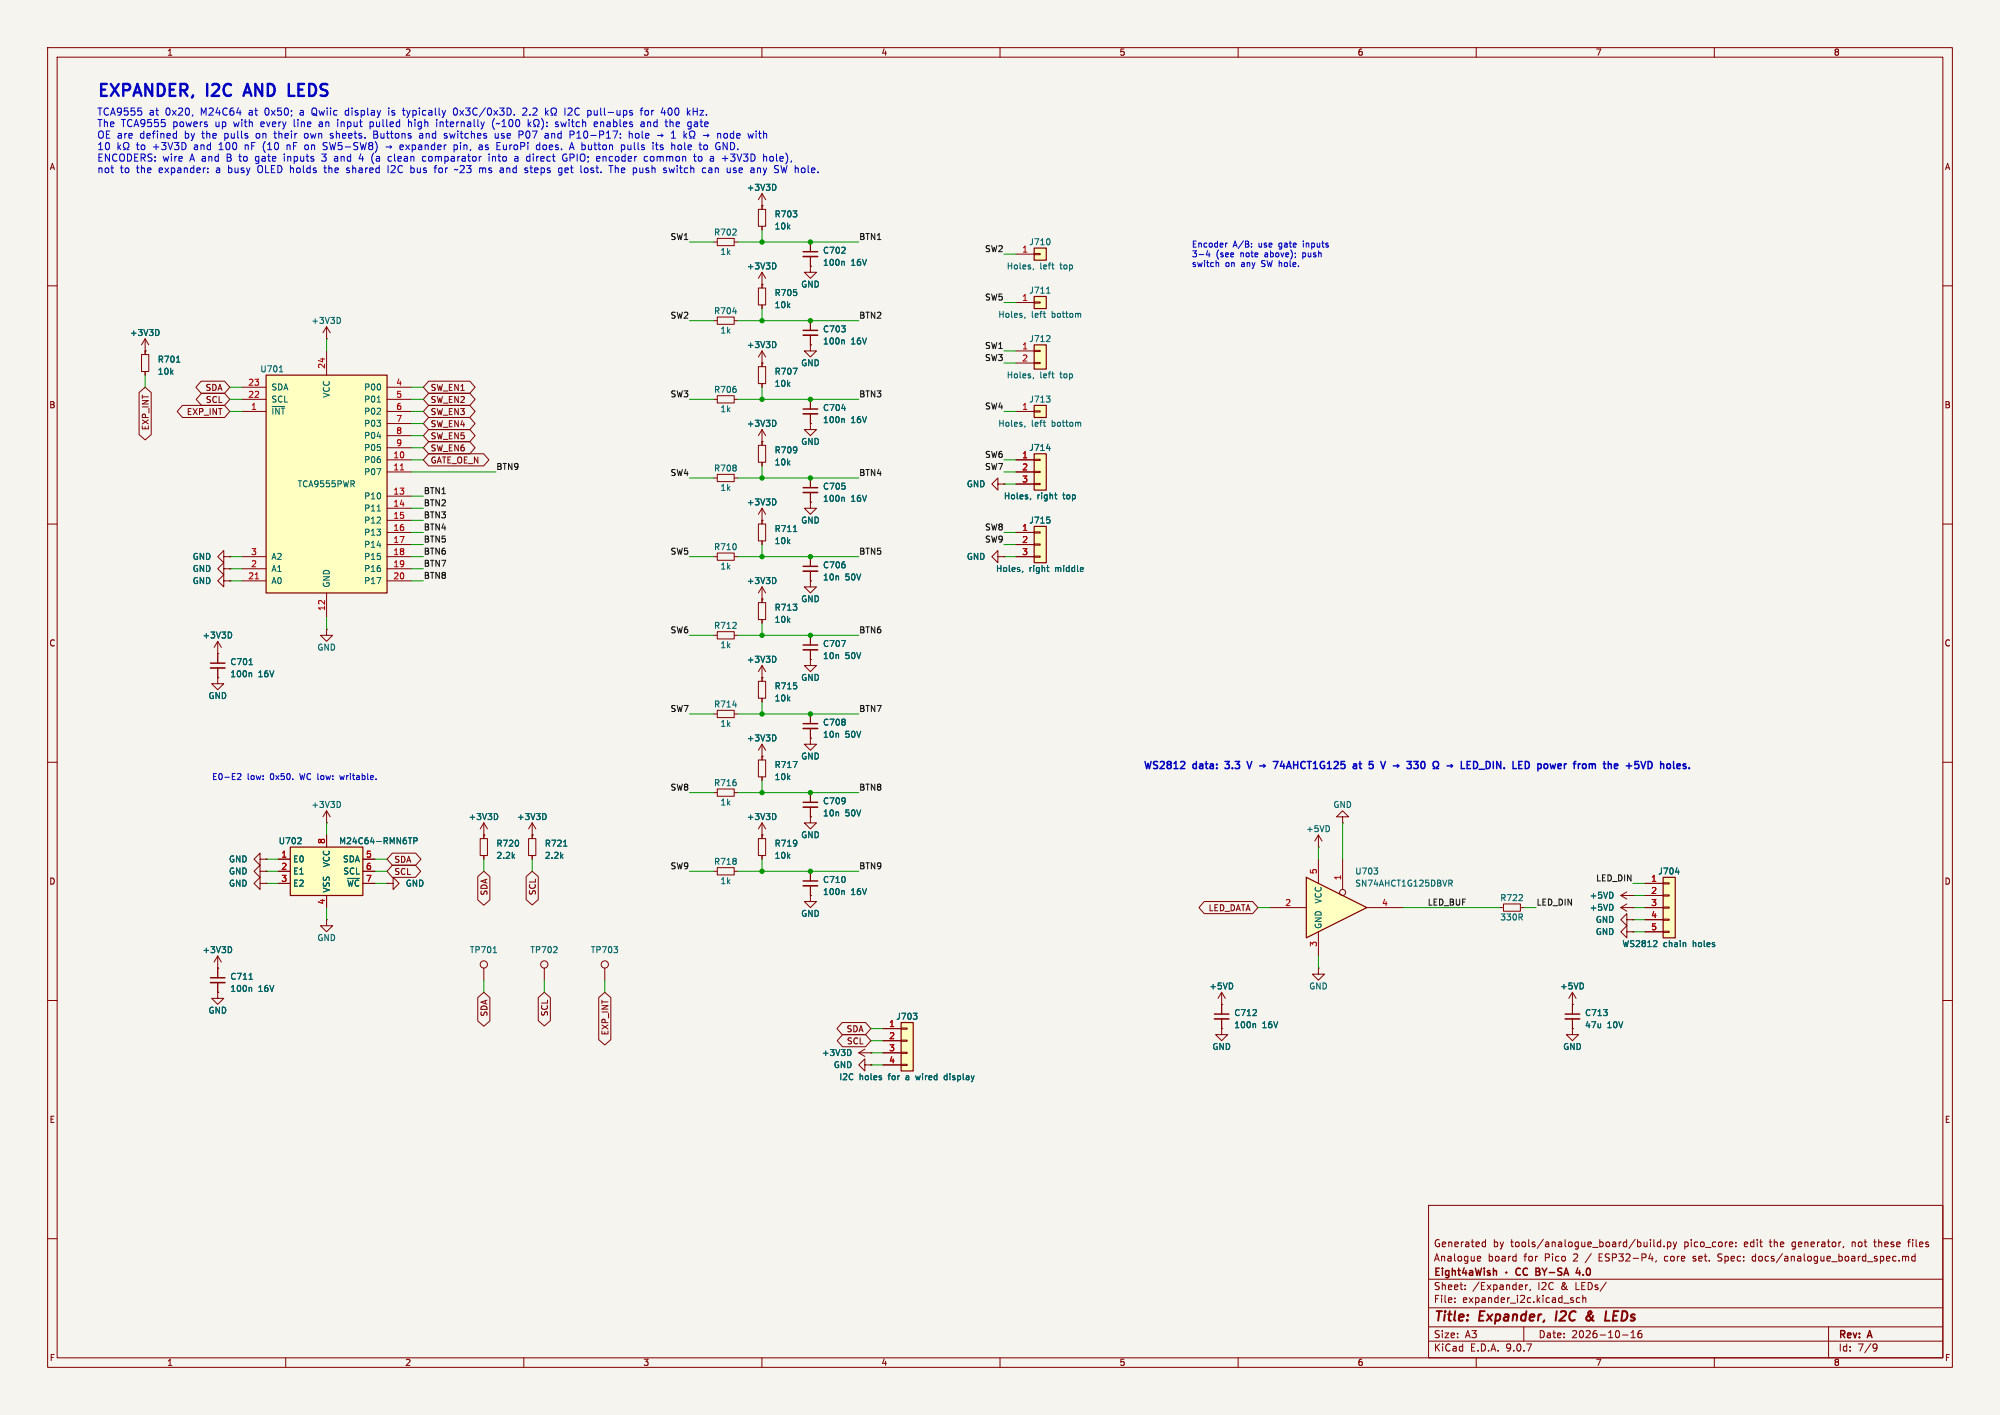
[picture p44: page 7]

J712 Holes, left top GND GND

100n 16V GND GND GND GND

I2C holes for a wired display 1

I2C holes for a wired display +3V3D
4 GND

Id: 7/9 Title: Expander, I2C & LEDs

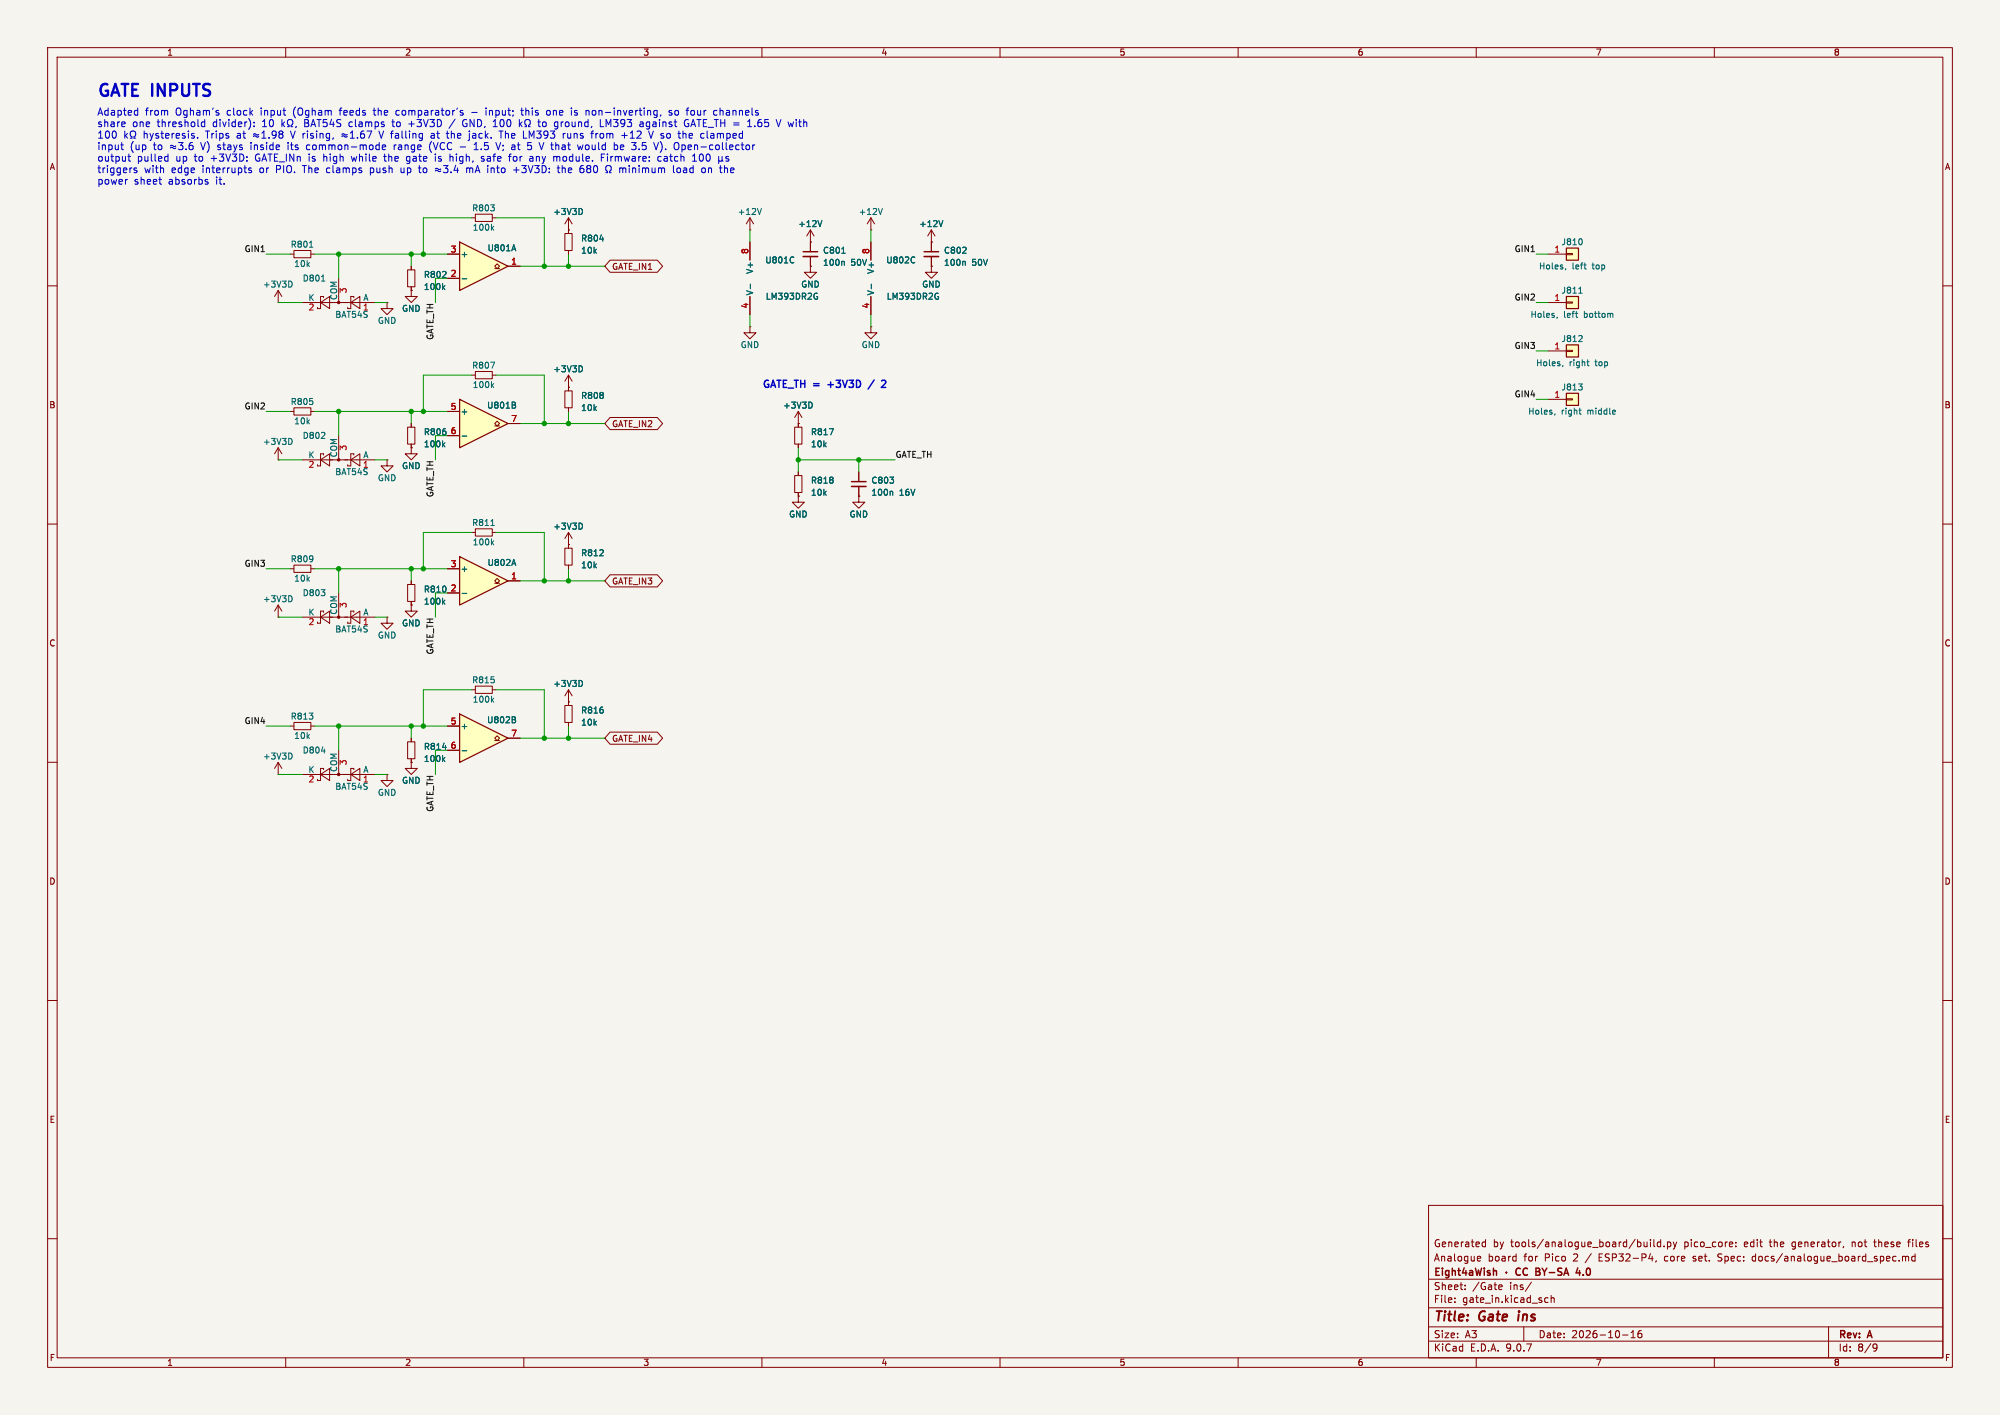
[picture p45: page 8]

output pulled up to +3V3D: GATE_INn is high while the gate is high, safe for any module. Firmware: catch 100 þÿµs

Id: 8/9 Title: Gate ins

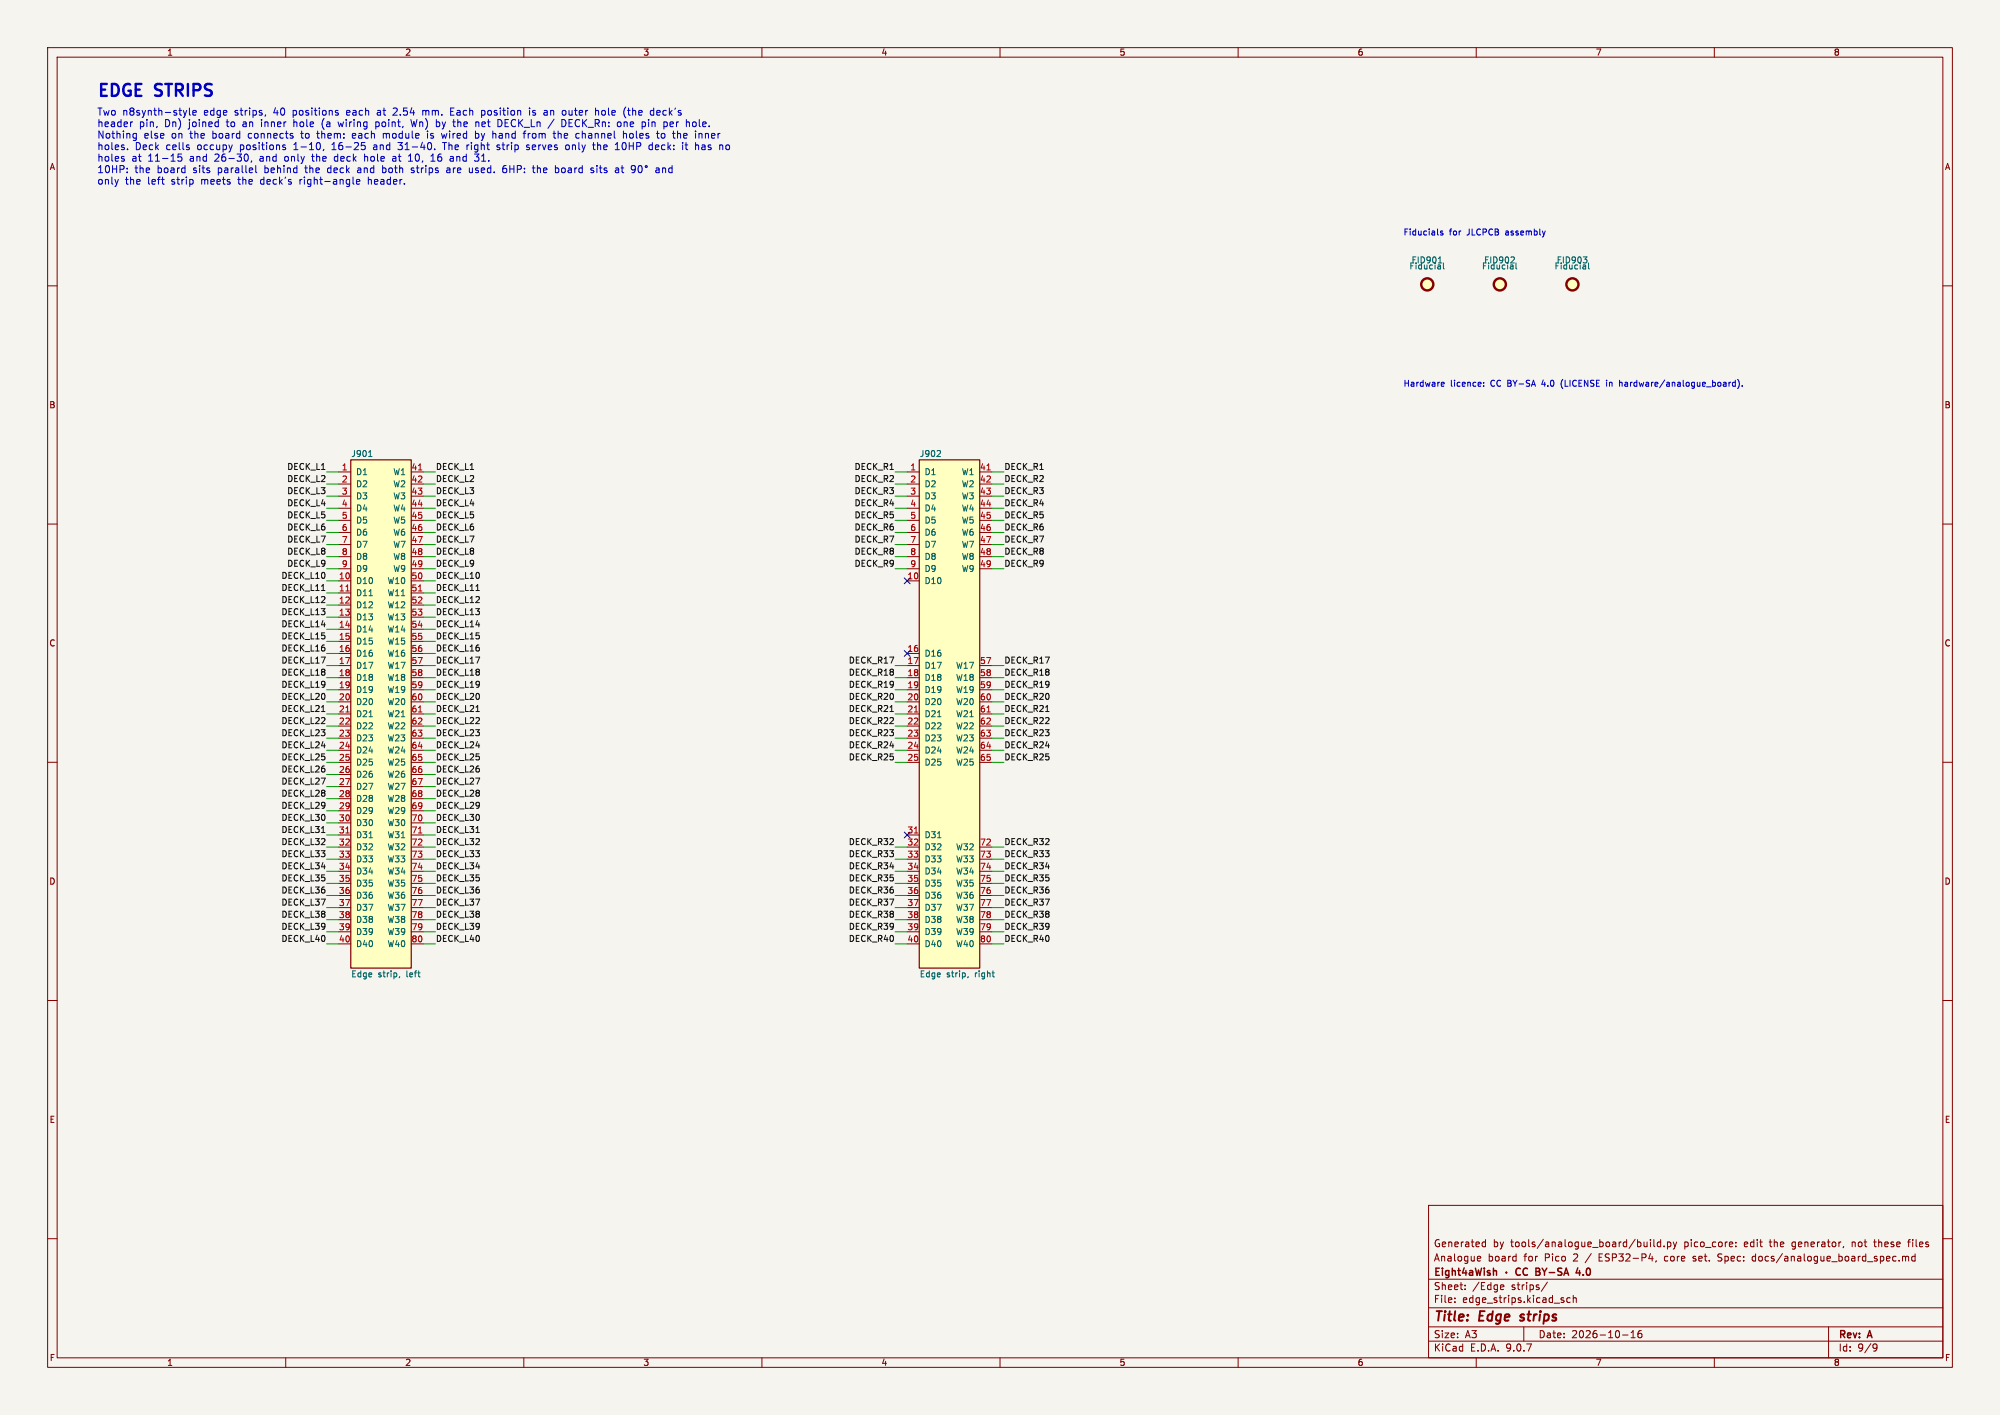
[picture p46: page 9]

File: edge_strips.kicad_sch Sheet: /Edge strips/
Id: 9/9 Title: Edge strips
