Eight4aWish/eurorack_electronics/hardware/analogue_board/pico_revb/output/wiring_map_outward_face.pdf

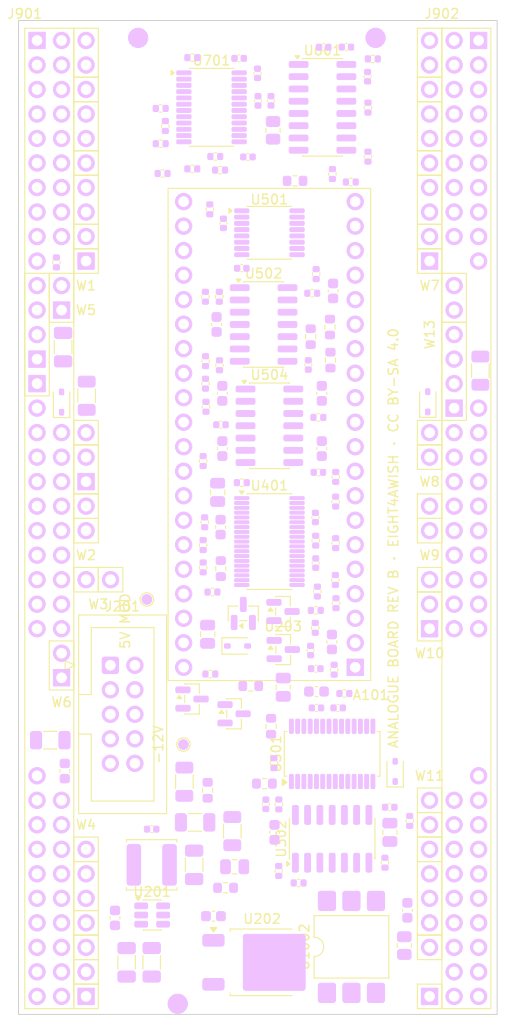
[picture p48: page 1]

Id: 1/1 Title: Analogue board Rev B for Pico 2 / ESP32-P4
