Eight4aWish/eurorack_electronics/hardware/analogue_board/pico_revb/output/placement_deck_face.pdf

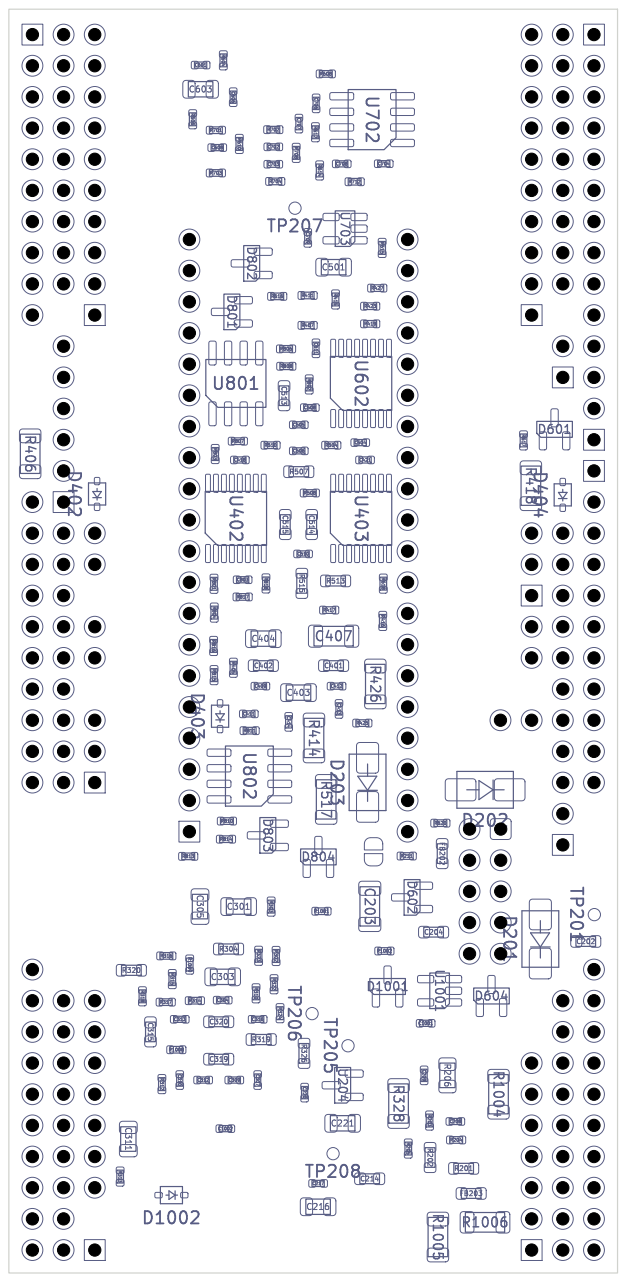
[picture p49: page 1]
