Eight4aWish/eurorack_electronics/hardware/analogue_board/pico_core_midi/output/placement_deck_face.pdf

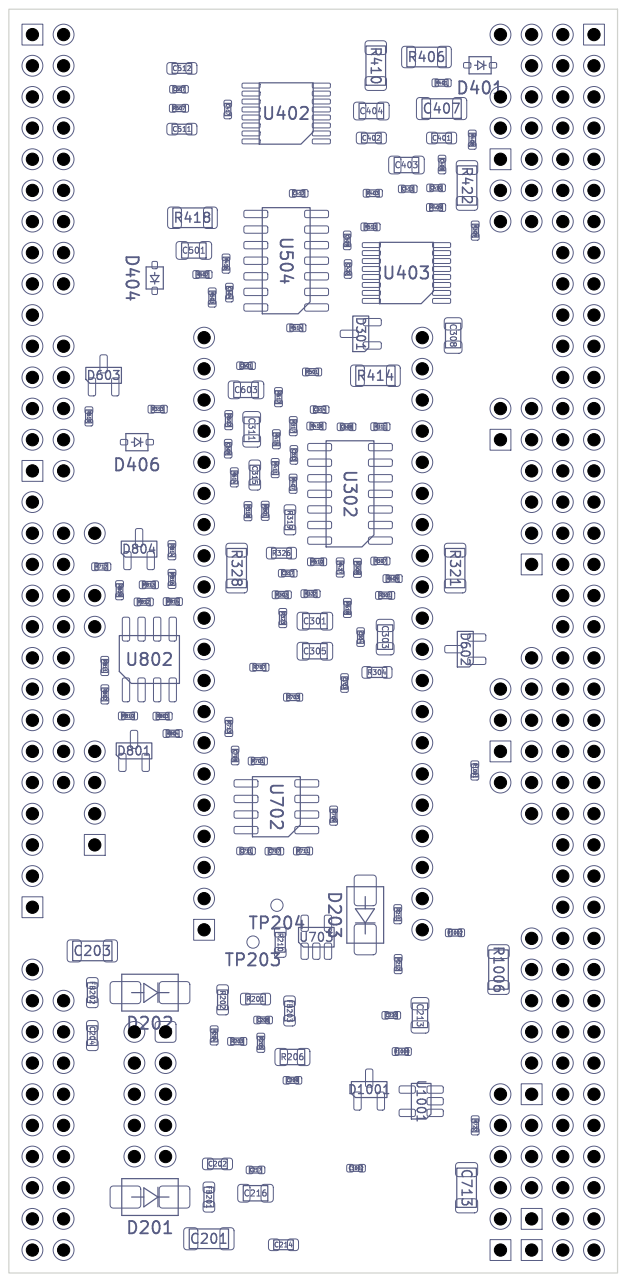
[picture p51: page 1]
