Eight4aWish/eurorack_electronics/hardware/analogue_board/pico_core_midi/output/placement_outward_face.pdf

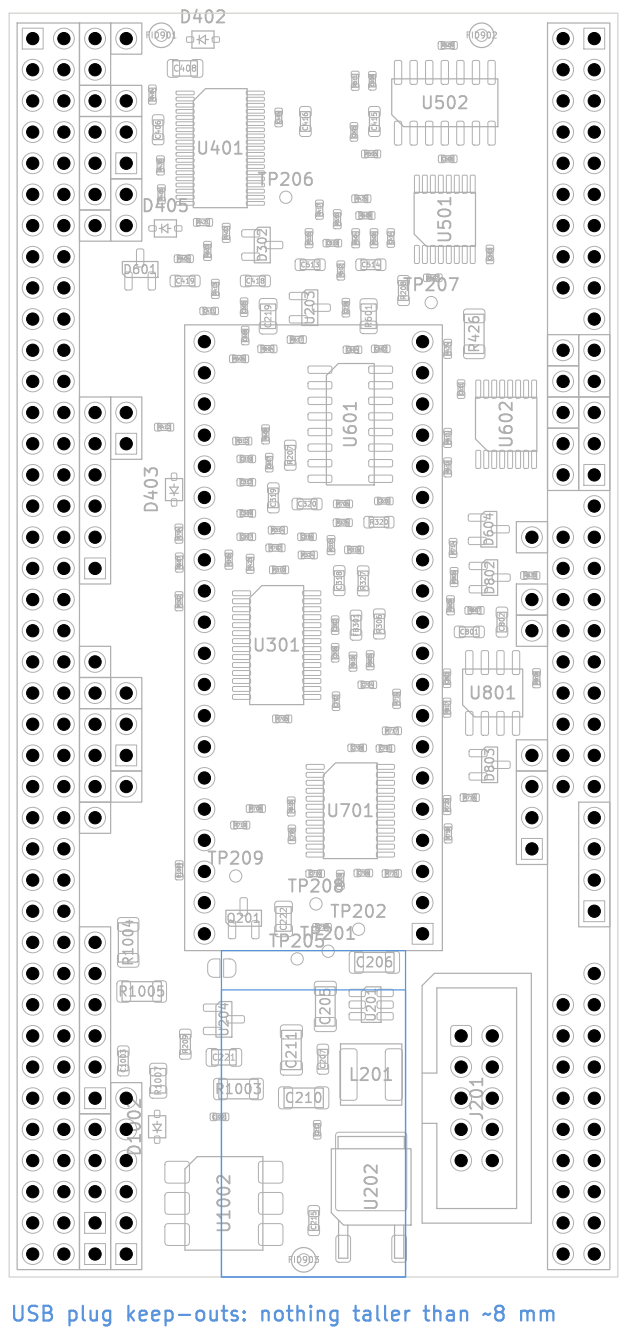
[picture p52: page 1]
