Eight4aWish/eurorack_electronics/hardware/analogue_board/pico_core_midi/output/wiring_map_deck_face.pdf

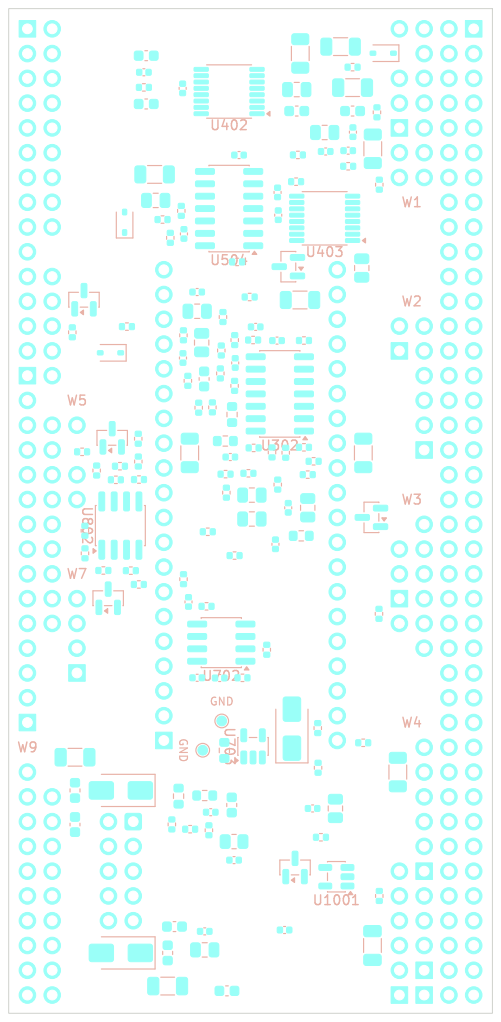
[picture p53: page 1]
