Eight4aWish/eurorack_electronics/hardware/analogue_board/pico_core_midi/output/wiring_map_outward_face.pdf

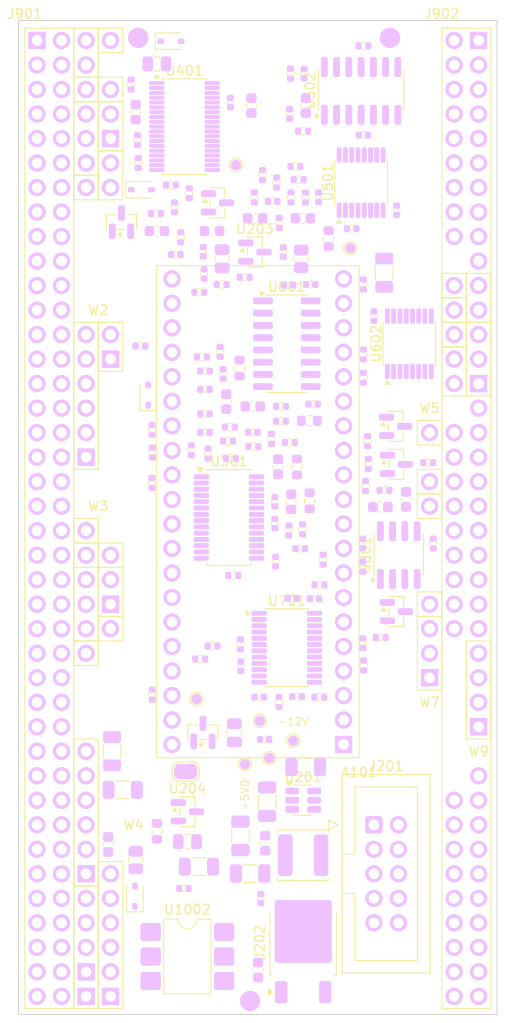
[picture p54: page 1]
