Eight4aWish/eurorack_electronics/hardware/analogue_board/teensy_core_midi/output/wiring_map_deck_face.pdf

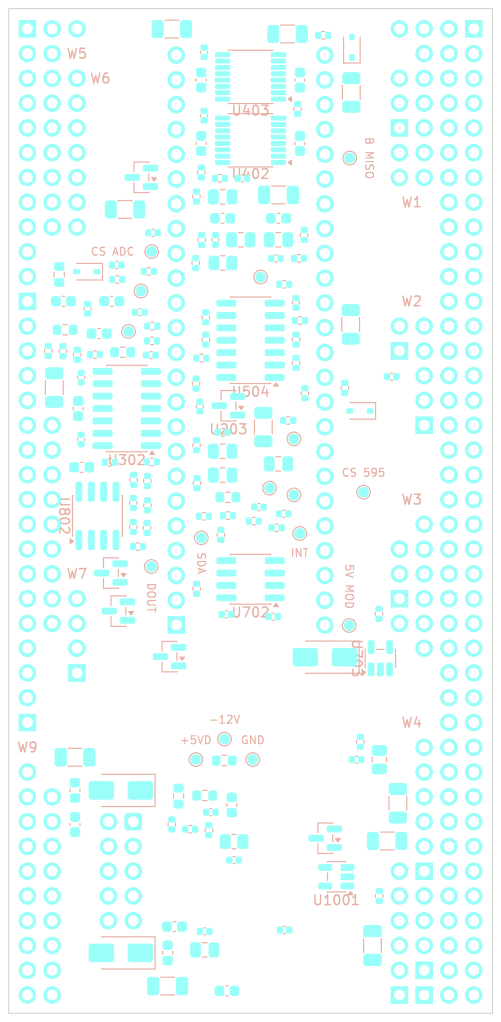
[picture p55: page 1]
