Eight4aWish/eurorack_electronics/hardware/analogue_board/teensy_core_midi/output/wiring_map_outward_face.pdf

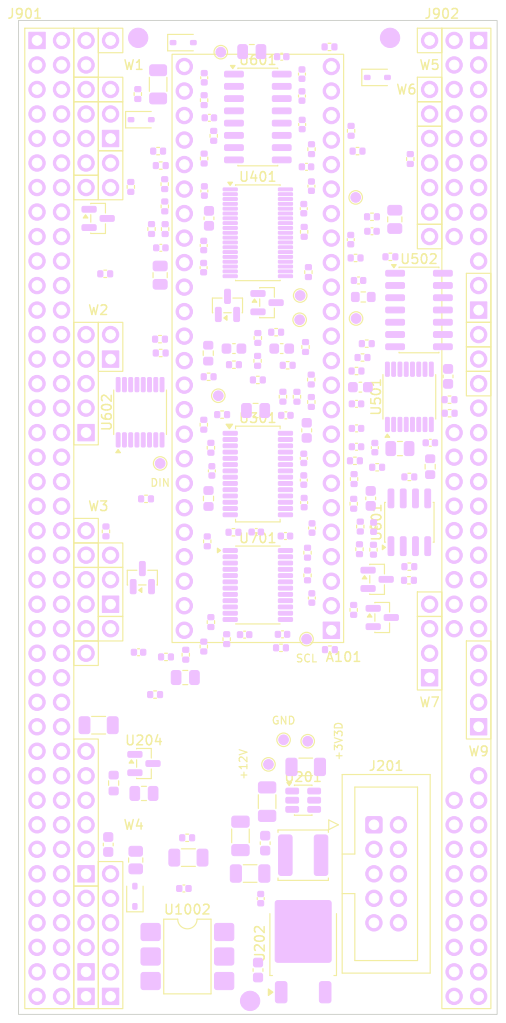
[picture p56: page 1]
