Eight4aWish/eurorack_electronics/hardware/analogue_board/shared_core/output/placement_deck_face.pdf

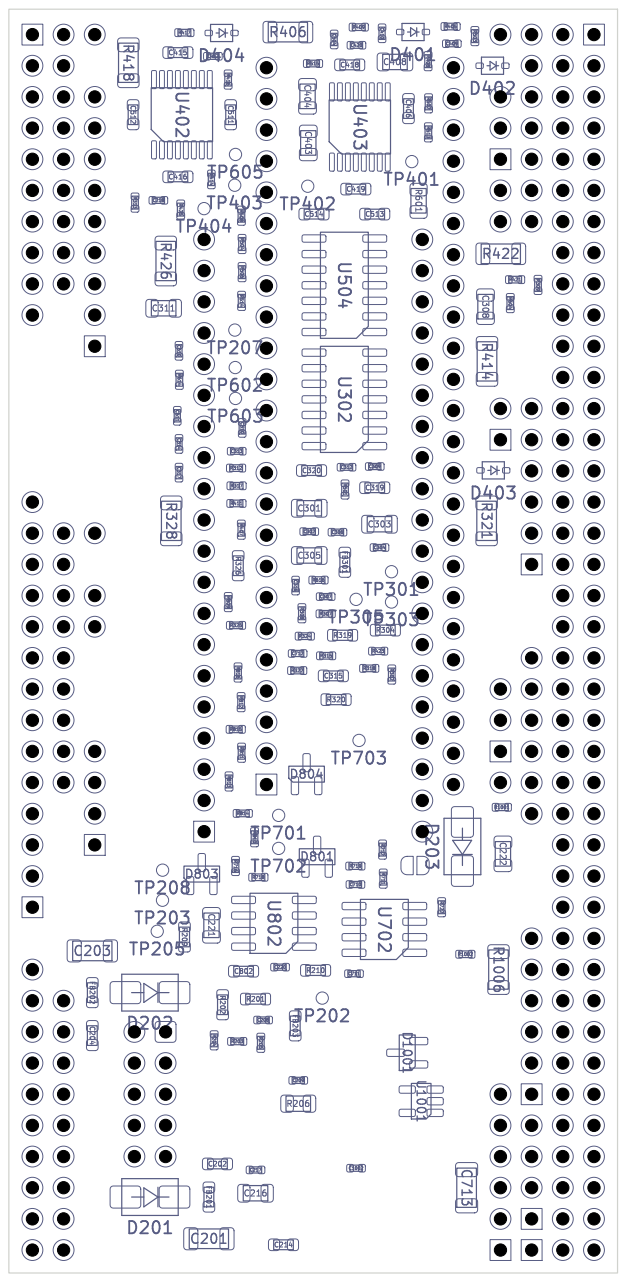
[picture p57: page 1]
