Eight4aWish/eurorack_electronics/hardware/analogue_board/shared_core/output/placement_outward_face.pdf

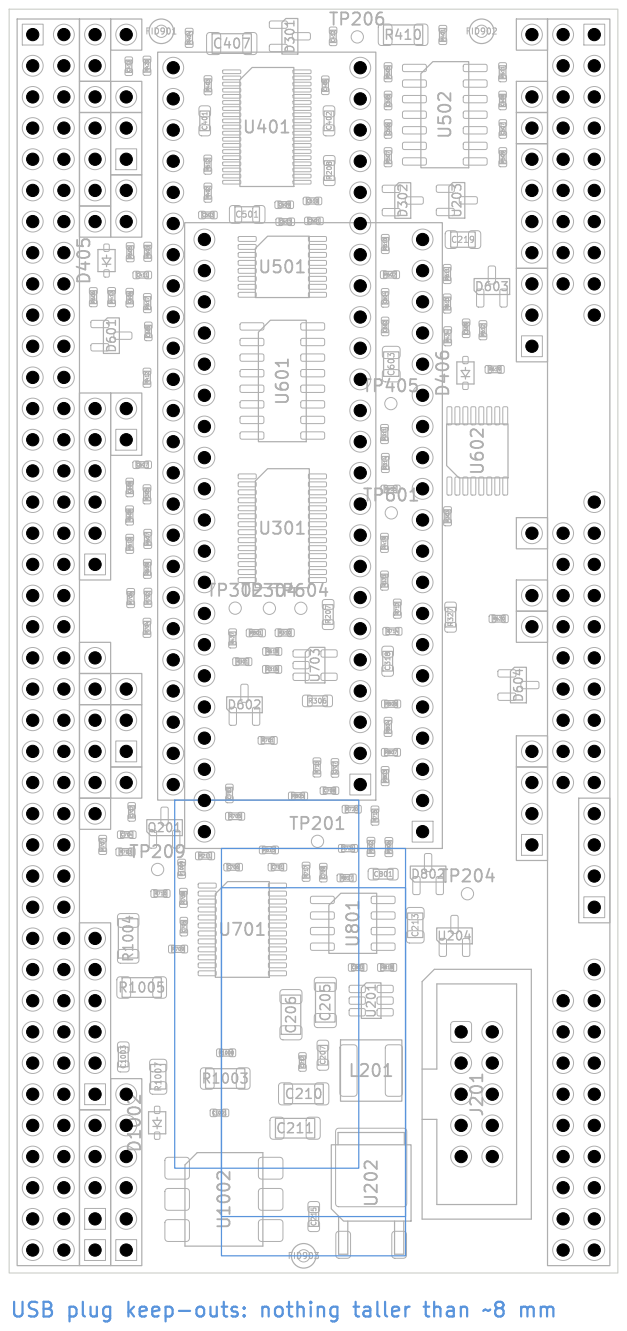
[picture p58: page 1]
