Eight4aWish/eurorack_electronics/hardware/analogue_board/teensy_core_midi/output/placement_deck_face.pdf

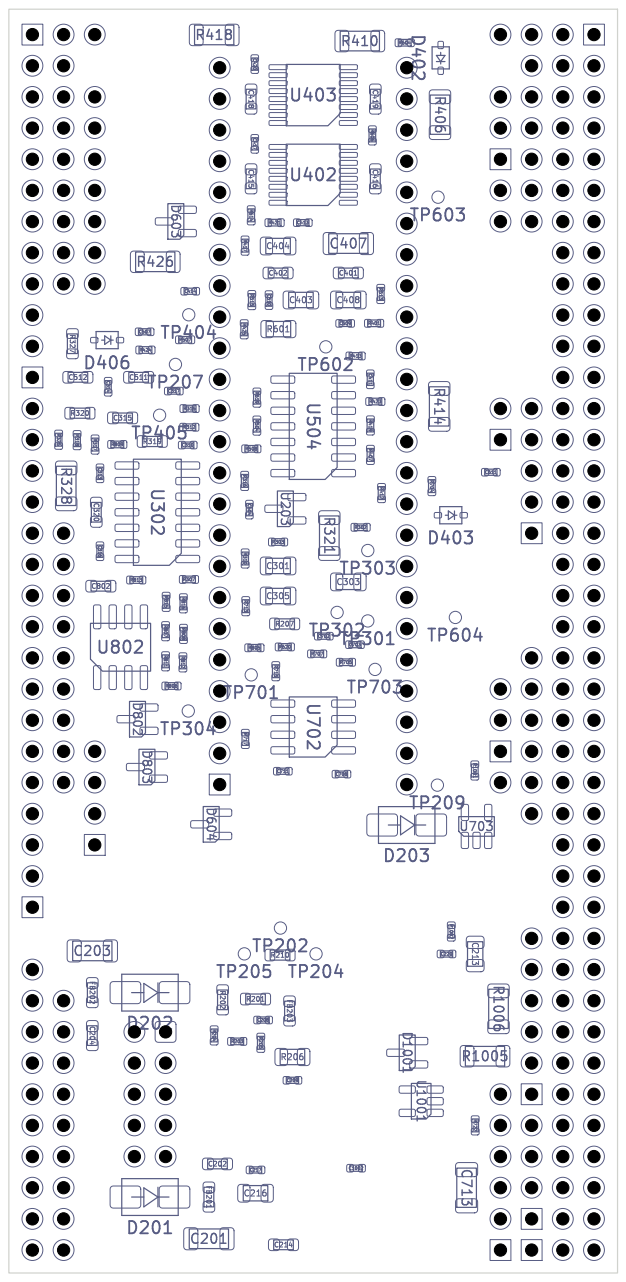
[picture p59: page 1]
