Eight4aWish/eurorack_electronics/hardware/analogue_board/teensy_core_midi/output/placement_outward_face.pdf

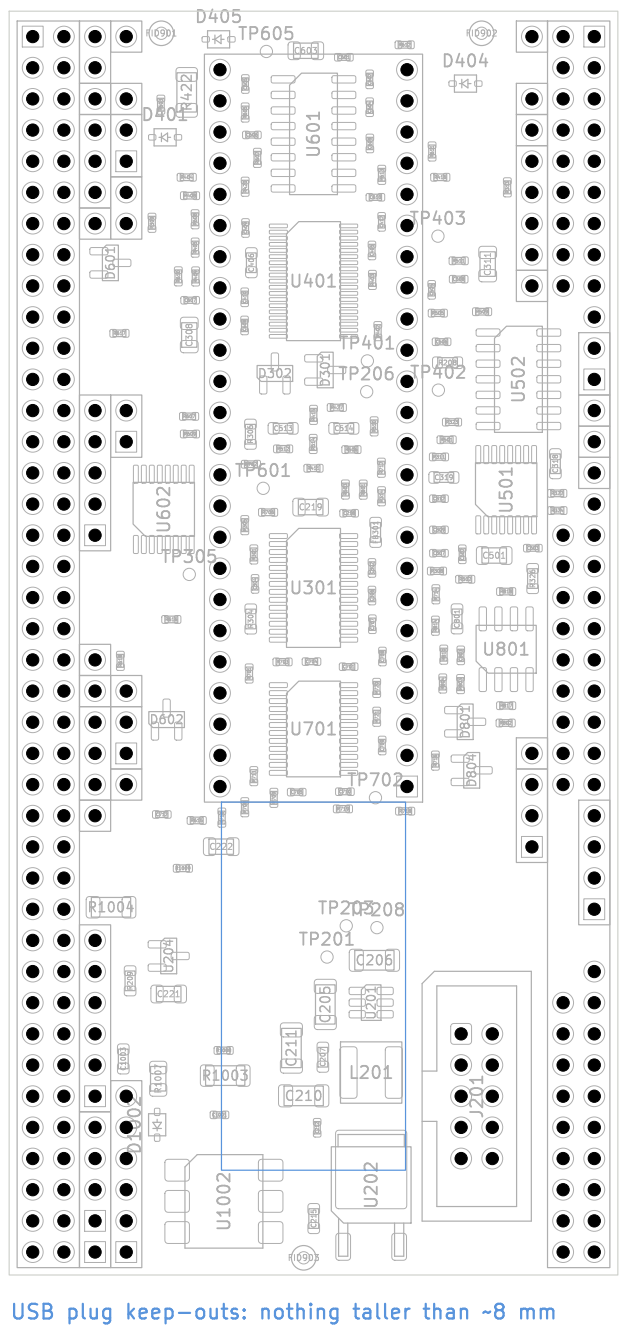
[picture p60: page 1]
