Eight4aWish/eurorack_electronics/hardware/analogue_board/pico/output/placement_deck_face.pdf

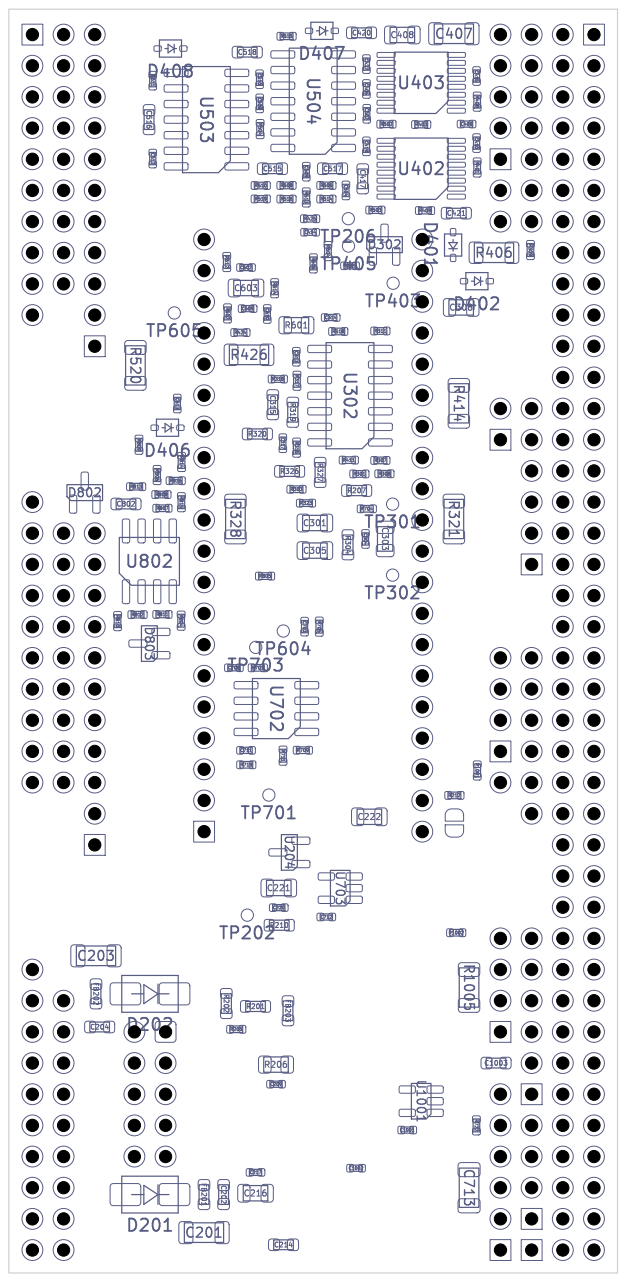
[picture p61: page 1]
