Eight4aWish/eurorack_electronics/hardware/analogue_board/pico/output/placement_outward_face.pdf

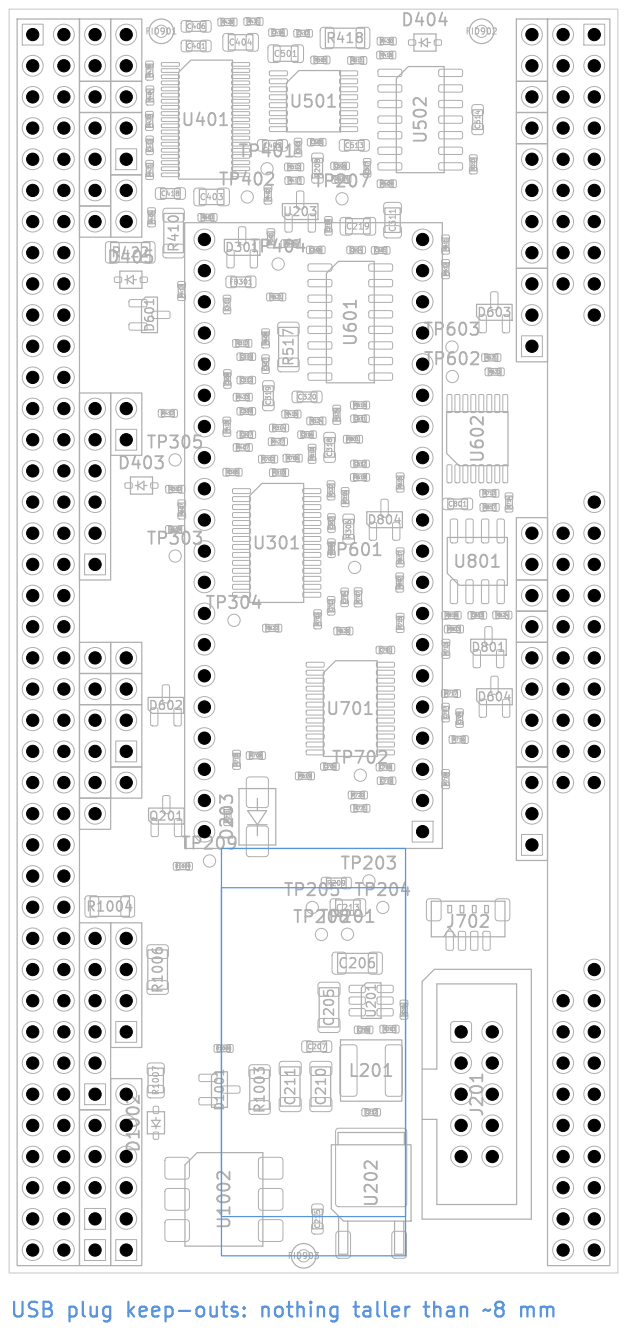
[picture p62: page 1]
