Eight4aWish/eurorack_electronics/hardware/analogue_board/pico_core/output/placement_deck_face.pdf

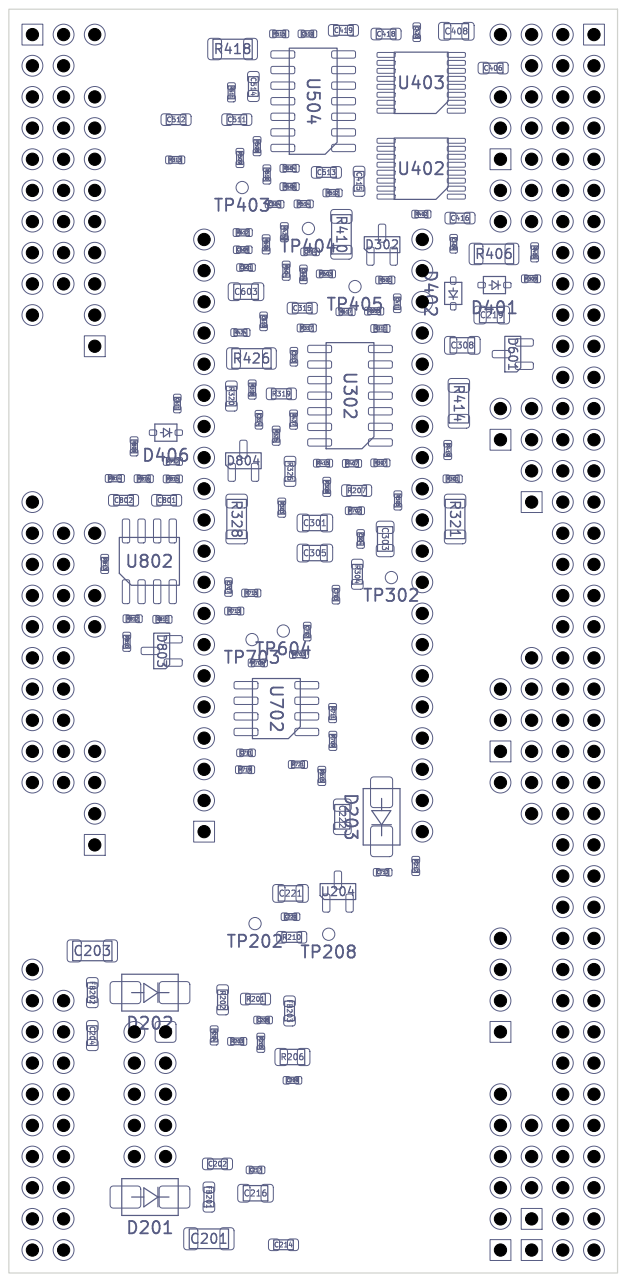
[picture p63: page 1]
