Eight4aWish/eurorack_electronics/hardware/analogue_board/pico_core/output/placement_outward_face.pdf

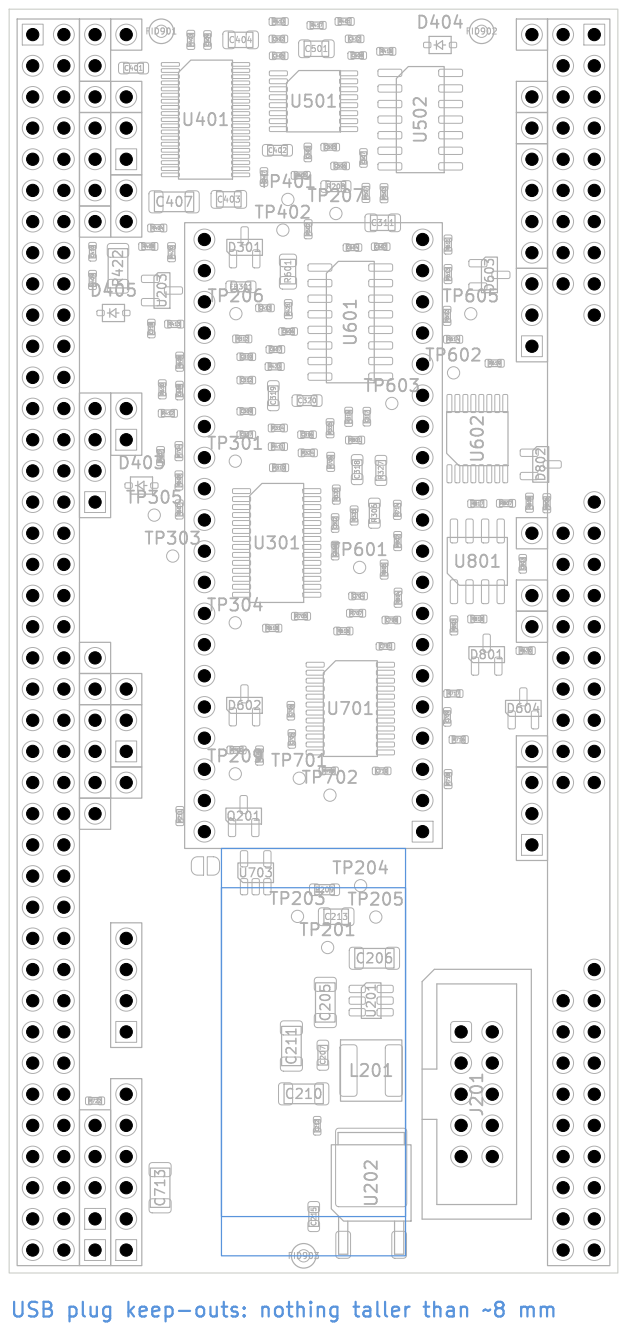
[picture p64: page 1]
