Eight4aWish/eurorack_electronics/hardware/analogue_board/shared/output/placement_deck_face.pdf

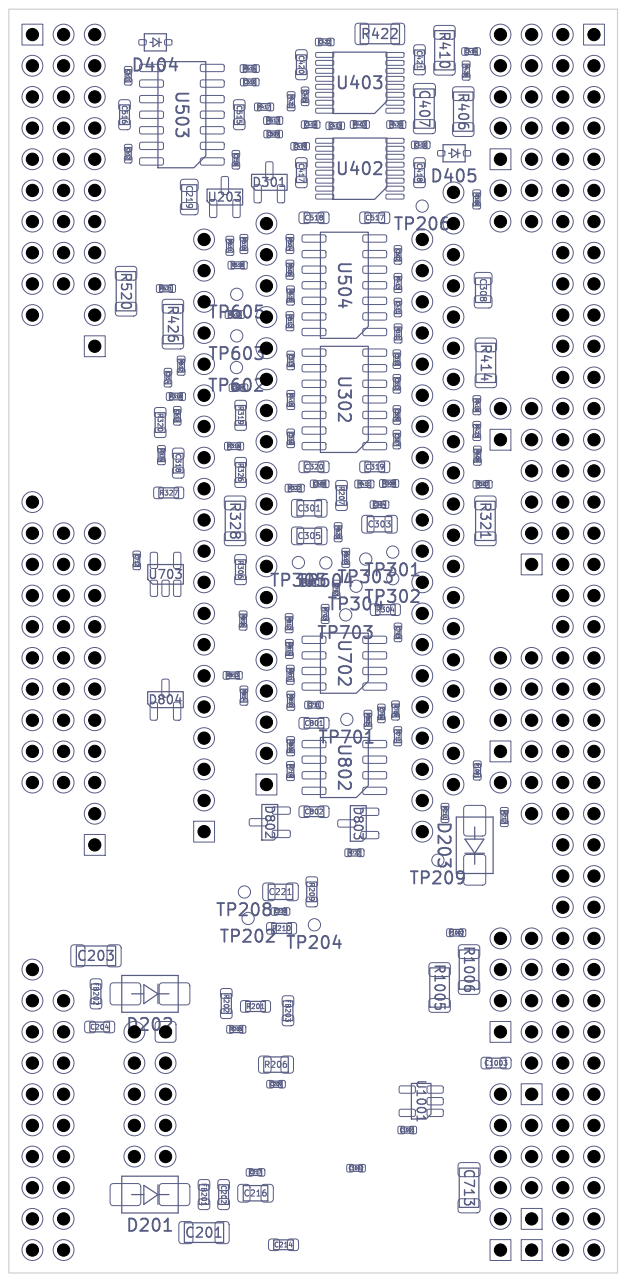
[picture p65: page 1]
