Eight4aWish/eurorack_electronics/hardware/analogue_board/shared/output/placement_outward_face.pdf

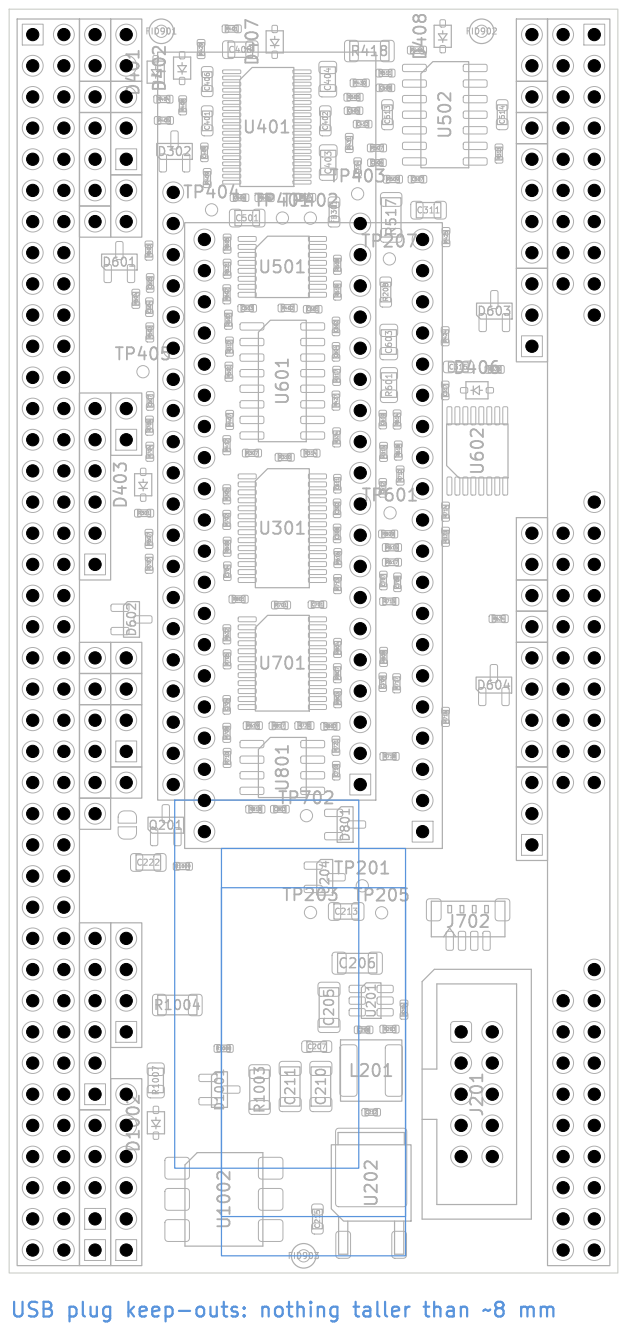
[picture p66: page 1]
