Eight4aWish/eurorack_electronics/hardware/analogue_board/teensy/output/placement_deck_face.pdf

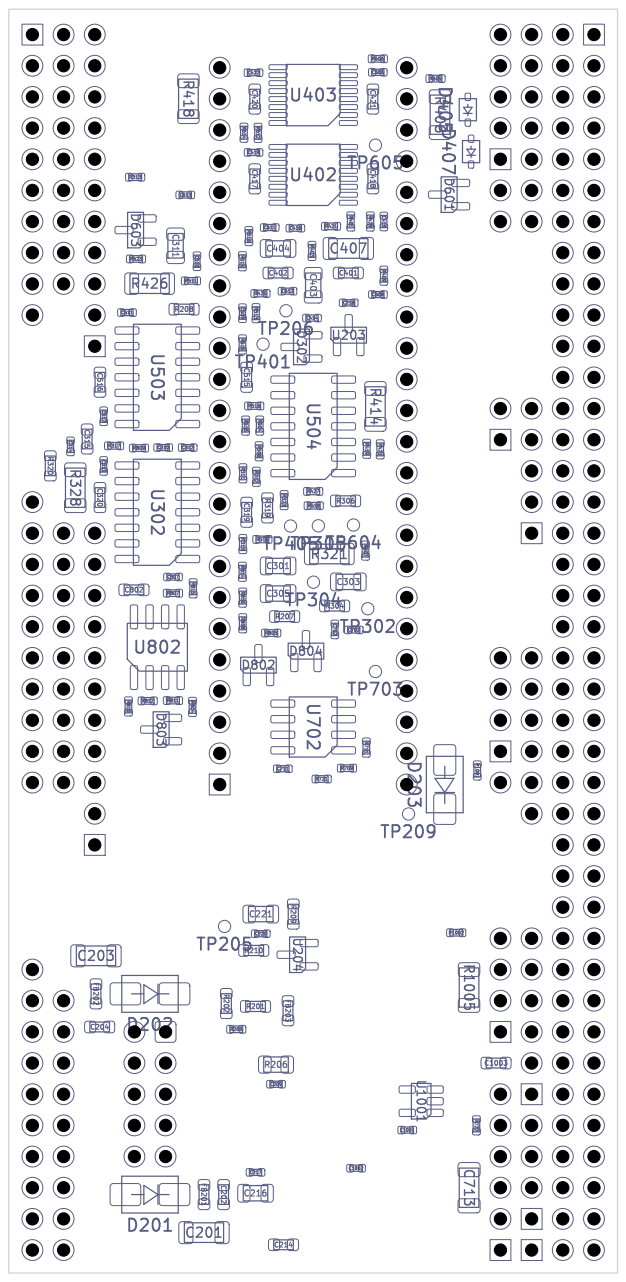
[picture p67: page 1]
