Eight4aWish/eurorack_electronics/hardware/analogue_board/teensy/output/placement_outward_face.pdf

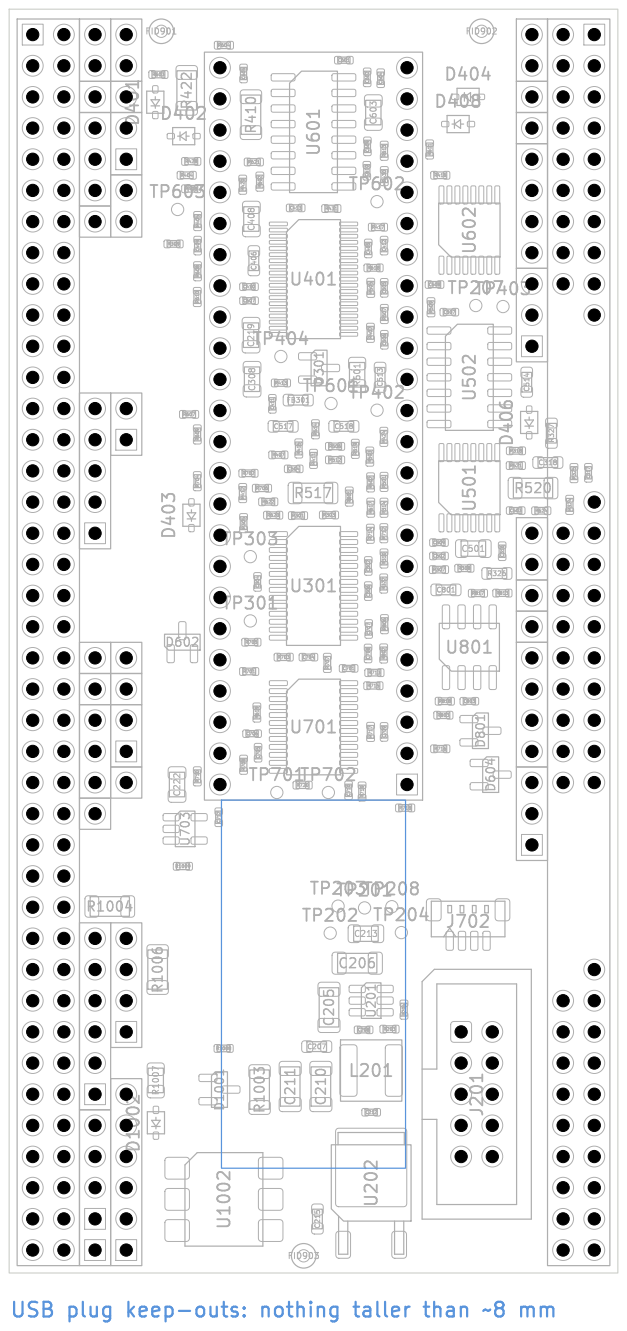
[picture p68: page 1]
