Eight4aWish/eurorack_electronics/(list of files, drawings)

Other design files:
hardware/analogue_board/output/pcb_drc.json
hardware/analogue_board/pico/output/pcb_drc.json
hardware/analogue_board/pico_core/output/pcb_drc.json
hardware/analogue_board/pico_core_midi/output/pcb_drc.json
hardware/analogue_board/pico_revb/output/pcb_drc.json
hardware/analogue_board/shared/output/pcb_drc.json
hardware/analogue_board/shared_core/output/pcb_drc.json
hardware/analogue_board/teensy/output/pcb_drc.json
hardware/analogue_board/teensy_core_midi/output/pcb_drc.json
