Eight4aWish/eurorack_electronics/hardware/analogue_board/pico_revb/analogue_board_pico_revb.kicad_pcb

## KiCad design hardware/analogue_board/pico_revb/analogue_board_pico_revb.kicad_pcb (2026-11-03)

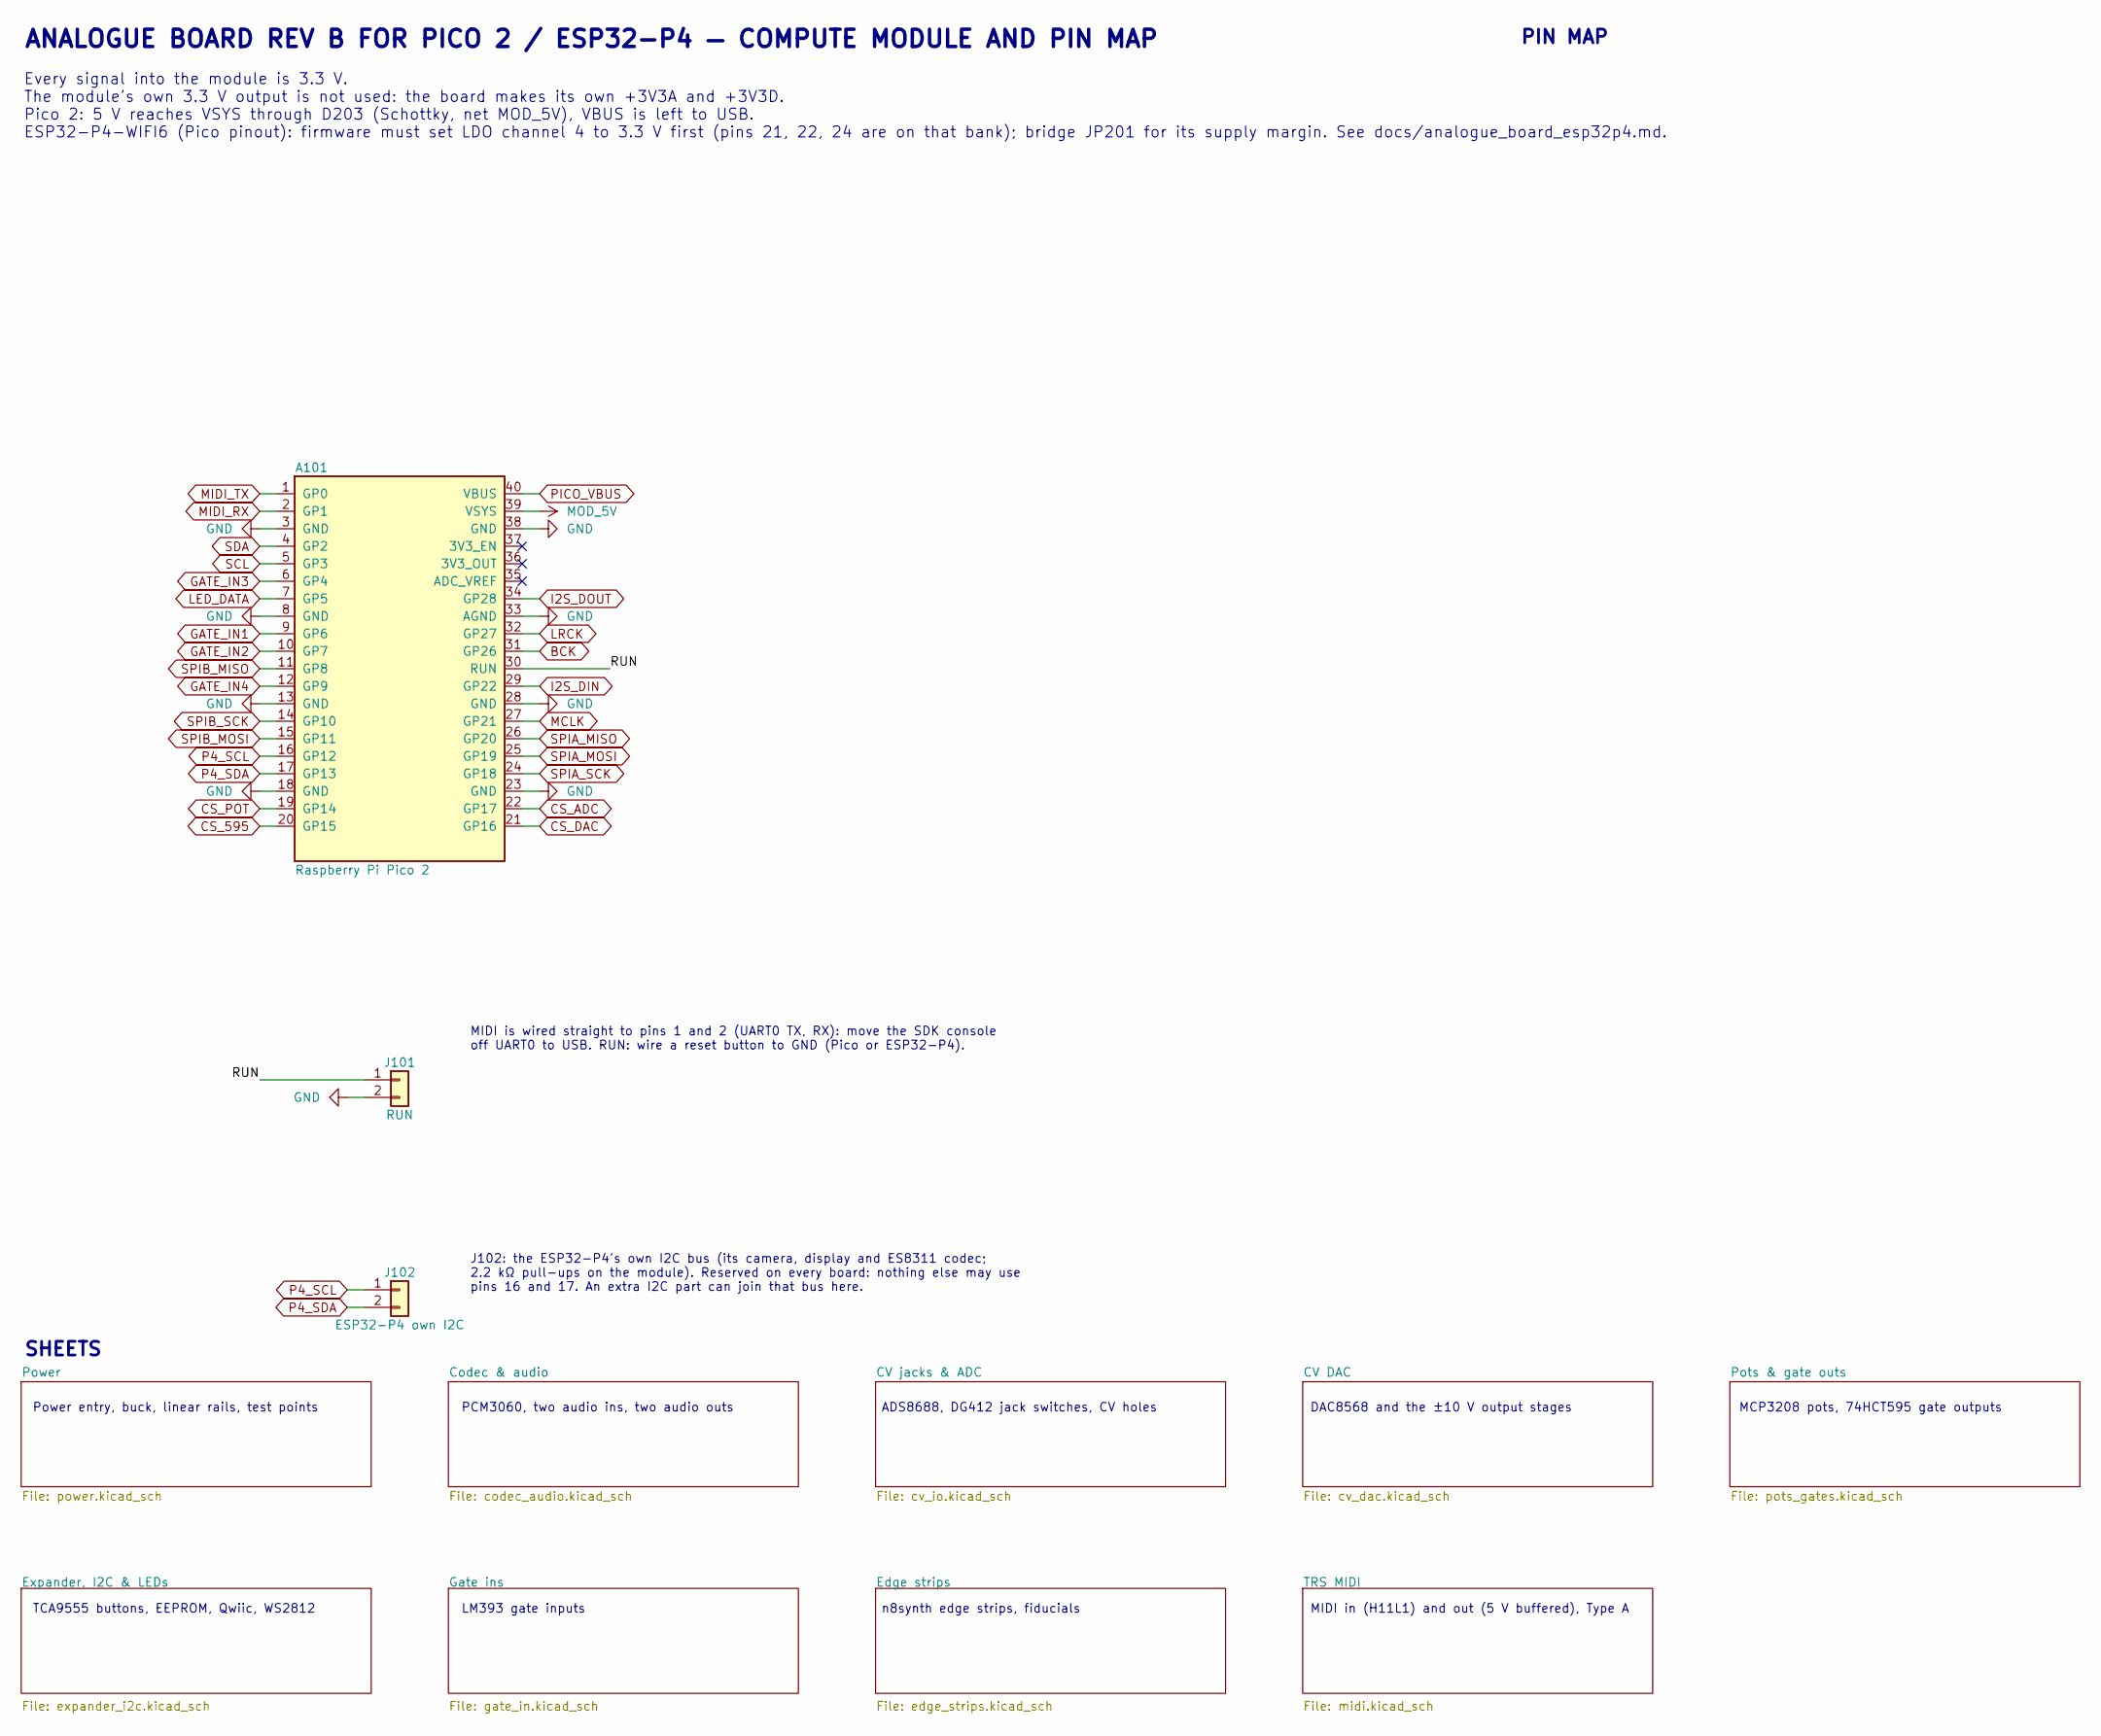
[picture p69: schematic analogue_board_pico_revb.kicad_sch, Compute module and pin map]

Parts:
A101: Raspberry Pi Pico 2; Pico2_Socket; MPN SC1631 on 2x20 female headers; JLC hand-soldered
J101: RUN; WiringHoles_1x02_G2; JLC bare holes
J102: ESP32-P4 own I2C; WiringHoles_1x02; JLC bare holes

Connections:
/RUN: A101.30 (RUN), J101.1
BCK: A101.31 (GP26); also elsewhere on the board
CS_595: A101.20 (GP15); also elsewhere on the board
CS_ADC: A101.22 (GP17); also elsewhere on the board
CS_DAC: A101.21 (GP16); also elsewhere on the board
CS_POT: A101.19 (GP14); also elsewhere on the board
GATE_IN1: A101.9 (GP6); also elsewhere on the board
GATE_IN2: A101.10 (GP7); also elsewhere on the board
GATE_IN3: A101.6 (GP4); also elsewhere on the board
GATE_IN4: A101.12 (GP9); also elsewhere on the board
GND: A101.3 (GND), A101.8 (GND), A101.13 (GND), A101.18 (GND), A101.23 (GND), A101.28 (GND), A101.33 (AGND), A101.38 (GND), J101.2; also elsewhere on the board
I2S_DIN: A101.29 (GP22); also elsewhere on the board
I2S_DOUT: A101.34 (GP28); also elsewhere on the board
LED_DATA: A101.7 (GP5); also elsewhere on the board
LRCK: A101.32 (GP27); also elsewhere on the board
MCLK: A101.27 (GP21); also elsewhere on the board
MIDI_RX: A101.2 (GP1); also elsewhere on the board
MIDI_TX: A101.1 (GP0); also elsewhere on the board
MOD_5V: A101.39 (VSYS); also elsewhere on the board
P4_SCL: A101.16 (GP12), J102.1
P4_SDA: A101.17 (GP13), J102.2
PICO_VBUS: A101.40 (VBUS); also elsewhere on the board
SCL: A101.5 (GP3); also elsewhere on the board
SDA: A101.4 (GP2); also elsewhere on the board
SPIA_MISO: A101.26 (GP20); also elsewhere on the board
SPIA_MOSI: A101.25 (GP19); also elsewhere on the board
SPIA_SCK: A101.24 (GP18); also elsewhere on the board
SPIB_MISO: A101.11 (GP8); also elsewhere on the board
SPIB_MOSI: A101.15 (GP11); also elsewhere on the board
SPIB_SCK: A101.14 (GP10); also elsewhere on the board

Notes on the sheet:
ANALOGUE BOARD REV B FOR PICO 2 / ESP32-P4 — COMPUTE MODULE AND PIN MAP
Every signal into the module is 3.3 V. The module's own 3.3 V output is not used: the board makes its own +3V3A and +3V3D. Pico 2: 5 V reaches VSYS through D203 (Schottky, net MOD_5V), VBUS is left to USB. ESP32-P4-WIFI6 (Pico pinout): firmware must set LDO channel 4 to 3.3 V first (pins 21, 22, 24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
MIDI is wired straight to pins 1 and 2 (UART0 TX, RX): move the SDK console off UART0 to USB. RUN: wire a reset button to GND (Pico or ESP32-P4).
J102: the ESP32-P4's own I2C bus (its camera, display and ES8311 codec; 2.2 kΩ pull-ups on the module). Reserved on every board: nothing else may use pins 16 and 17. An extra I2C part can join that bus here.
PIN MAP
Power entry, buck, linear rails, test points
PCM3060, two audio ins, two audio outs
ADS8688, DG412 jack switches, CV holes
DAC8568 and the ±10 V output stages
MCP3208 pots, 74HCT595 gate outputs
TCA9555 buttons, EEPROM, Qwiic, WS2812
LM393 gate inputs
n8synth edge strips, fiducials
MIDI in (H11L1) and out (5 V buffered), Type A
SHEETS

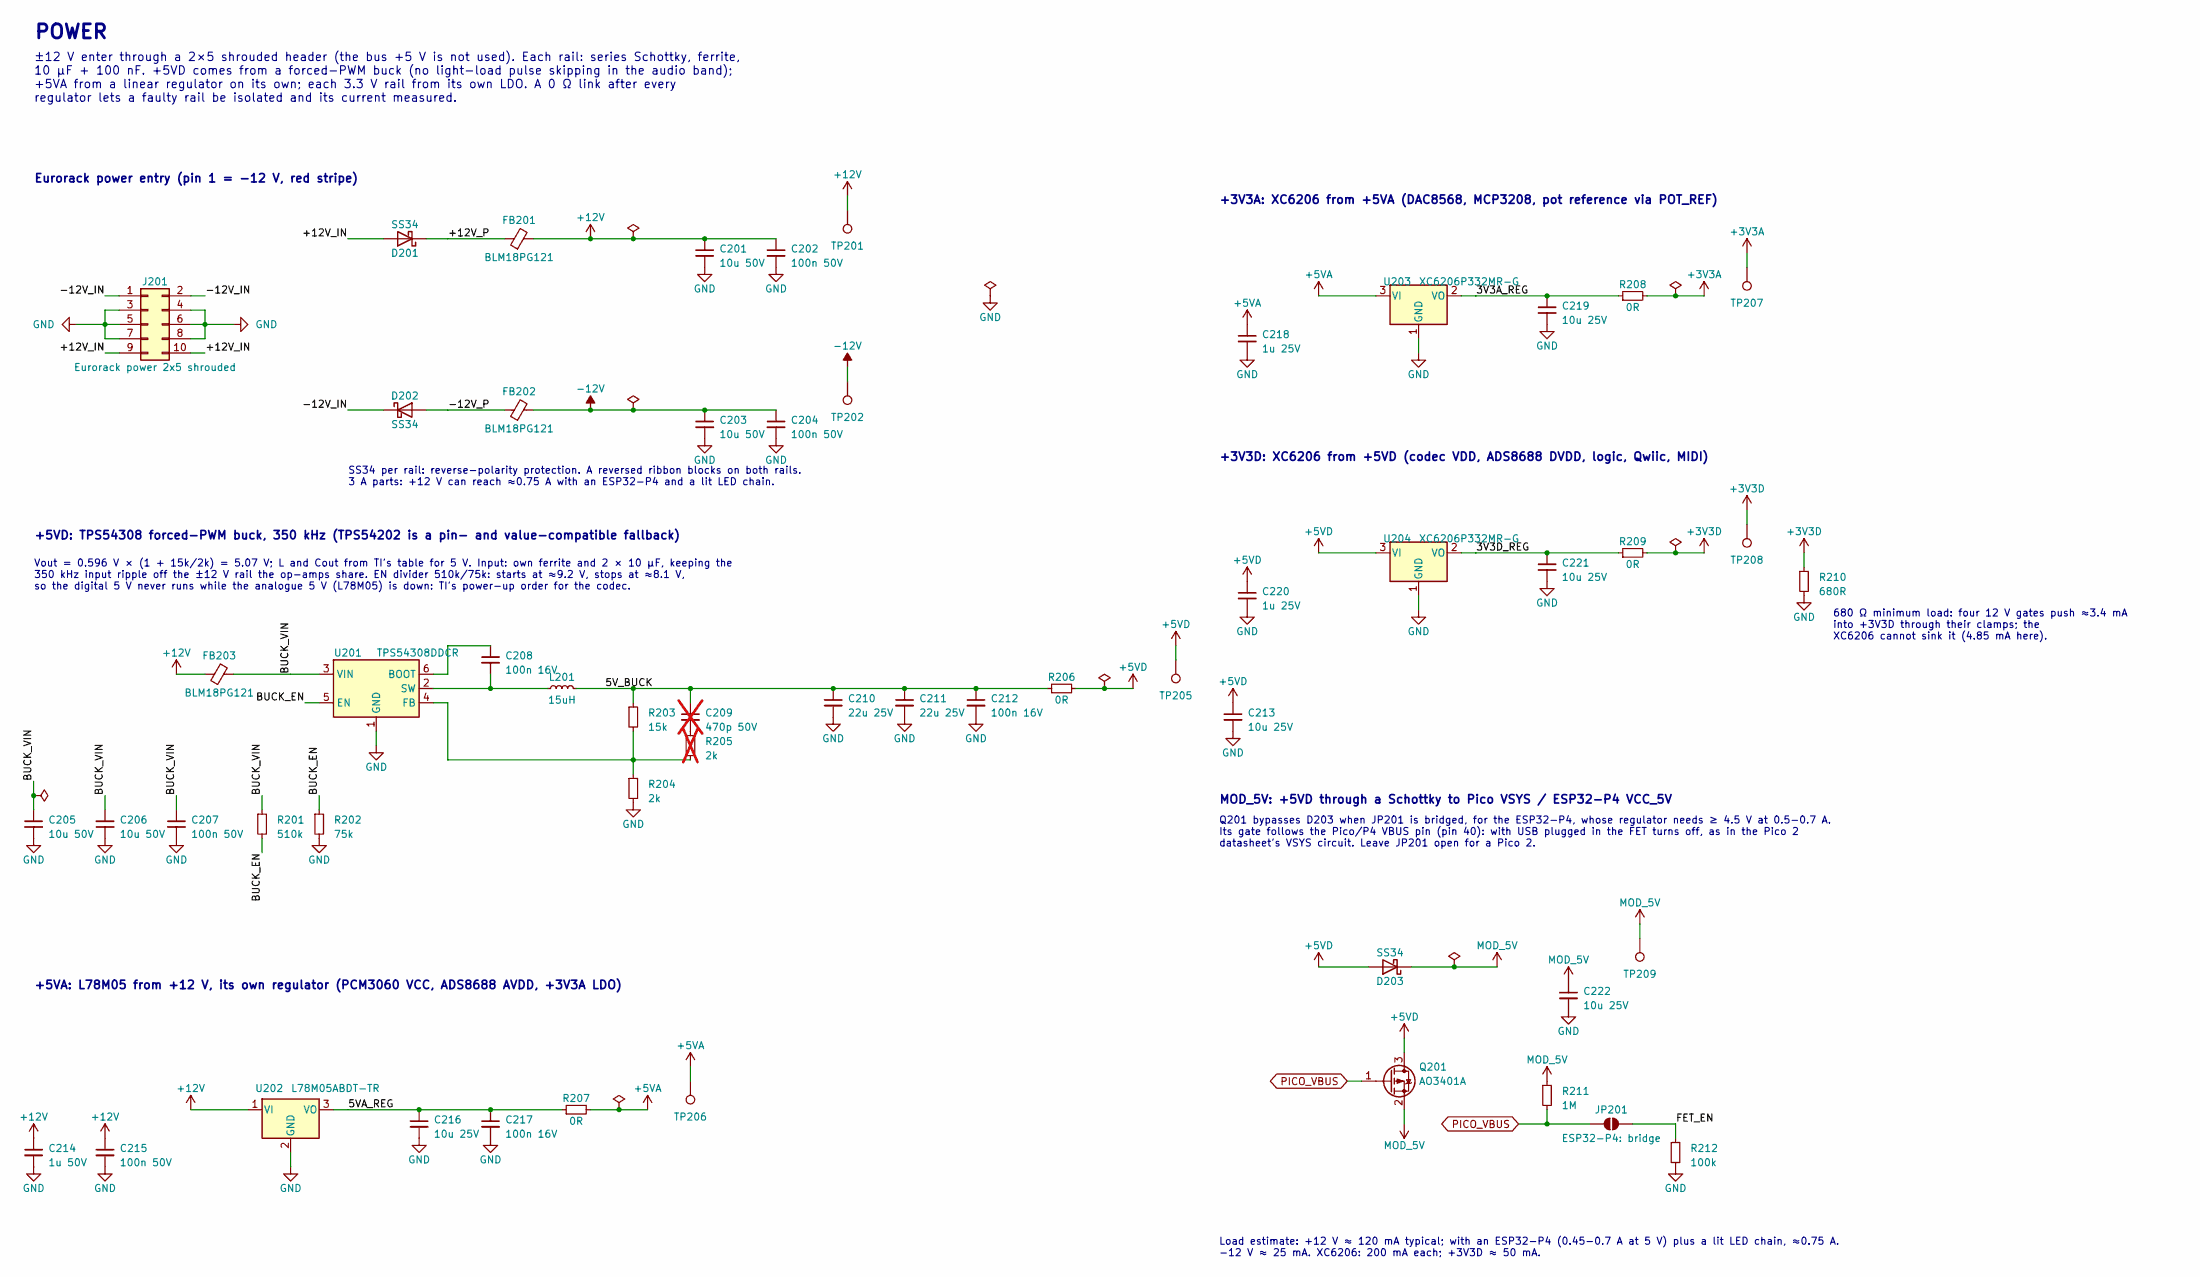
[picture p70: schematic power.kicad_sch]

Parts:
C201, C203, C205, C206: 10u 50V; C_1206_3216Metric; Voltage 50V; LCSC C13585
C202, C204, C207, C215: 100n 50V; C_0603_1608Metric; Voltage 50V; LCSC C14663
C208, C212, C217: 100n 16V; C_0402_1005Metric; Voltage 16V; LCSC C1525
C209: 470p 50V; C_0402_1005Metric; Voltage 50V; JLC not fitted; not fitted
C210, C211: 22u 25V; C_1206_3216Metric; Voltage 25V; LCSC C12891
C213, C216, C219, C221, C222: 10u 25V; C_0805_2012Metric; Voltage 25V; LCSC C15850
C214: 1u 50V; C_0603_1608Metric; Voltage 50V; LCSC C15849
C218, C220: 1u 25V; C_0402_1005Metric; Voltage 25V; LCSC C52923
D201, D202, D203: SS34; D_SMA; MPN SS34; LCSC C8678
FB201, FB202, FB203: BLM18PG121; L_0603_1608Metric; MPN BLM18PG121SN1D; LCSC C14709
J201: Eurorack power 2x5 shrouded; IDC-Header_2x05_P2.54mm_Vertical; MPN 2x5 2.54 mm shrouded box header; JLC hand-soldered
JP201: ESP32-P4: bridge; SolderJumper-2_P1.3mm_Open_RoundedPad1.0x1.5mm; JLC bare pad
L201: 15uH; L_Sunlord_SWPA5040S; MPN SWPA5040S150MT; LCSC C44888
Q201: AO3401A; SOT-23; MPN AO3401A; LCSC C15127
R201: 510k; R_0603_1608Metric; Tolerance 1%; LCSC C23192
R202: 75k; R_0603_1608Metric; Tolerance 1%; LCSC C23242
R203: 15k; R_0402_1005Metric; Tolerance 1%; LCSC C25756
R204: 2k; R_0402_1005Metric; Tolerance 1%; LCSC C4109
R205: 2k; R_0402_1005Metric; Tolerance 1%; LCSC C4109; not fitted
R206: 0R; R_0805_2012Metric; Tolerance 1%; LCSC C17477
R207, R208, R209: 0R; R_0603_1608Metric; Tolerance 1%; LCSC C21189
R210: 680R; R_0603_1608Metric; Tolerance 1%; LCSC C23228
R211: 1M; R_0402_1005Metric; Tolerance 1%; LCSC C26083
R212: 100k; R_0402_1005Metric; Tolerance 1%; LCSC C25741
TP201: +12V; TestPoint_Pad_D1.0mm; JLC bare pad
TP202: -12V; TestPoint_Pad_D1.0mm; JLC bare pad
TP205: +5VD; TestPoint_Pad_D1.0mm; JLC bare pad
TP206: +5VA; TestPoint_Pad_D1.0mm; JLC bare pad
TP207: +3V3A; TestPoint_Pad_D1.0mm; JLC bare pad
TP208: +3V3D; TestPoint_Pad_D1.0mm; JLC bare pad
TP209: MOD_5V; TestPoint_Pad_D1.0mm; JLC bare pad
U201: TPS54308DDCR; SOT-23-6; MPN TPS54308DDCR; LCSC C168839
U202: L78M05ABDT-TR; TO-252-2_PasteShapes; MPN L78M05ABDT-TR; LCSC C58069
U203, U204: XC6206P332MR-G; SOT-23; MPN XC6206P332MR-G; LCSC C5446

Connections:
+3V3A: R208.2, TP207.1; also elsewhere on the board
+3V3D: R209.2, R210.1, TP208.1; also elsewhere on the board
+5VA: C218.1, R207.2, TP206.1, U203.3 (VI); also elsewhere on the board
+5VD: C213.1, C220.1, D203.2 (A), Q201.3 (D), R206.2, TP205.1, U204.3 (VI); also elsewhere on the board
+12V: C201.1, C202.1, C214.1, C215.1, FB201.2, FB203.1, TP201.1, U202.1 (VI); also elsewhere on the board
-12V: C203.1, C204.1, FB202.2, TP202.1; also elsewhere on the board
/Power/3V3A_REG: C219.1, R208.1, U203.2 (VO)
/Power/3V3D_REG: C221.1, R209.1, U204.2 (VO)
/Power/5VA_REG: C216.1, C217.1, R207.1, U202.3 (VO)
/Power/5V_BUCK: C209.1, C210.1, C211.1, C212.1, L201.2, R203.1, R206.1
/Power/+12V_IN: D201.2 (A), J201.9, J201.10
/Power/+12V_P: D201.1 (K), FB201.1
/Power/-12V_IN: D202.1 (K), J201.1, J201.2
/Power/-12V_P: D202.2 (A), FB202.1
/Power/BUCK_EN: R201.2, R202.1, U201.5 (EN)
/Power/BUCK_VIN: C205.1, C206.1, C207.1, FB203.2, R201.1, U201.3 (VIN)
/Power/FET_EN: JP201.2 (B), R212.1
GND: C201.2, C202.2, C203.2, C204.2, C205.2, C206.2, C207.2, C210.2, C211.2, C212.2, C213.2, C214.2, C215.2, C216.2, C217.2, C218.2, C219.2, C220.2, C221.2, C222.2, J201.3, J201.4, J201.5, J201.6, J201.7, J201.8, R202.2, R204.2, R210.2, R212.2, U201.1 (GND), U202.2 (GND), U203.1 (GND), U204.1 (GND); also elsewhere on the board
MOD_5V: C222.1, D203.1 (K), Q201.2 (S), R211.1, TP209.1; also elsewhere on the board
unnamed: C209.2, R205.1
unnamed: C208.1, U201.6 (BOOT)
unnamed: R203.2, R204.1, R205.2, U201.4 (FB)
unnamed: C208.2, L201.1, U201.2 (SW)
PICO_VBUS: JP201.1 (A), Q201.1 (G), R211.2; also elsewhere on the board

Notes on the sheet:
POWER
±12 V enter through a 2×5 shrouded header (the bus +5 V is not used). Each rail: series Schottky, ferrite, 10 µF + 100 nF. +5VD comes from a forced-PWM buck (no light-load pulse skipping in the audio band); +5VA from a linear regulator on its own; each 3.3 V rail from its own LDO. A 0 Ω link after 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
Eurorack power entry (pin 1 = -12 V, red stripe)
SS34 per rail: reverse-polarity protection. A reversed ribbon blocks on both rails. 3 A parts: +12 V can reach ≈0.75 A with an ESP32-P4 and a lit LED chain.
+5VD: TPS54308 forced-PWM buck, 350 kHz (TPS54202 is a pin- and value-compatible fallback)
Vout = 0.596 V × (1 + 15k/2k) = 5.07 V; L and Cout from TI's table for 5 V. Input: own ferrite and 2 × 10 µF, keeping the 350 kHz input ripple off the ±12 V rail the op-amps share. EN divider 510k/75k: starts at ≈9.2 V, stops at ≈8.1 V, so the digital 5 V never runs while the analogue 5 V (L78M05) 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
+5VA: L78M05 from +12 V, its own regulator (PCM3060 VCC, ADS8688 AVDD, +3V3A LDO)
+3V3A: XC6206 from +5VA (DAC8568, MCP3208, pot reference via POT_REF)
+3V3D: XC6206 from +5VD (codec VDD, ADS8688 DVDD, logic, Qwiic, MIDI)
680 Ω minimum load: four 12 V gates push ≈3.4 mA into +3V3D through their clamps; the XC6206 cannot sink it (4.85 mA here).
MOD_5V: +5VD through a Schottky to Pico VSYS / ESP32-P4 VCC_5V
Q201 bypasses D203 when JP201 is bridged, for the ESP32-P4, whose regulator needs ≥ 4.5 V at 0.5-0.7 A. Its gate follows the Pico/P4 VBUS pin (pin 40): with USB plugged in the FET turns off, as in the Pico 2 datasheet's VSYS circuit. Leave JP201 open for a Pico 2.
Load estimate: +12 V ≈ 120 mA typical; with an ESP32-P4 (0.45-0.7 A at 5 V) plus a lit LED chain, ≈0.75 A. -12 V ≈ 25 mA. XC6206: 200 mA each; +3V3D ≈ 50 mA.

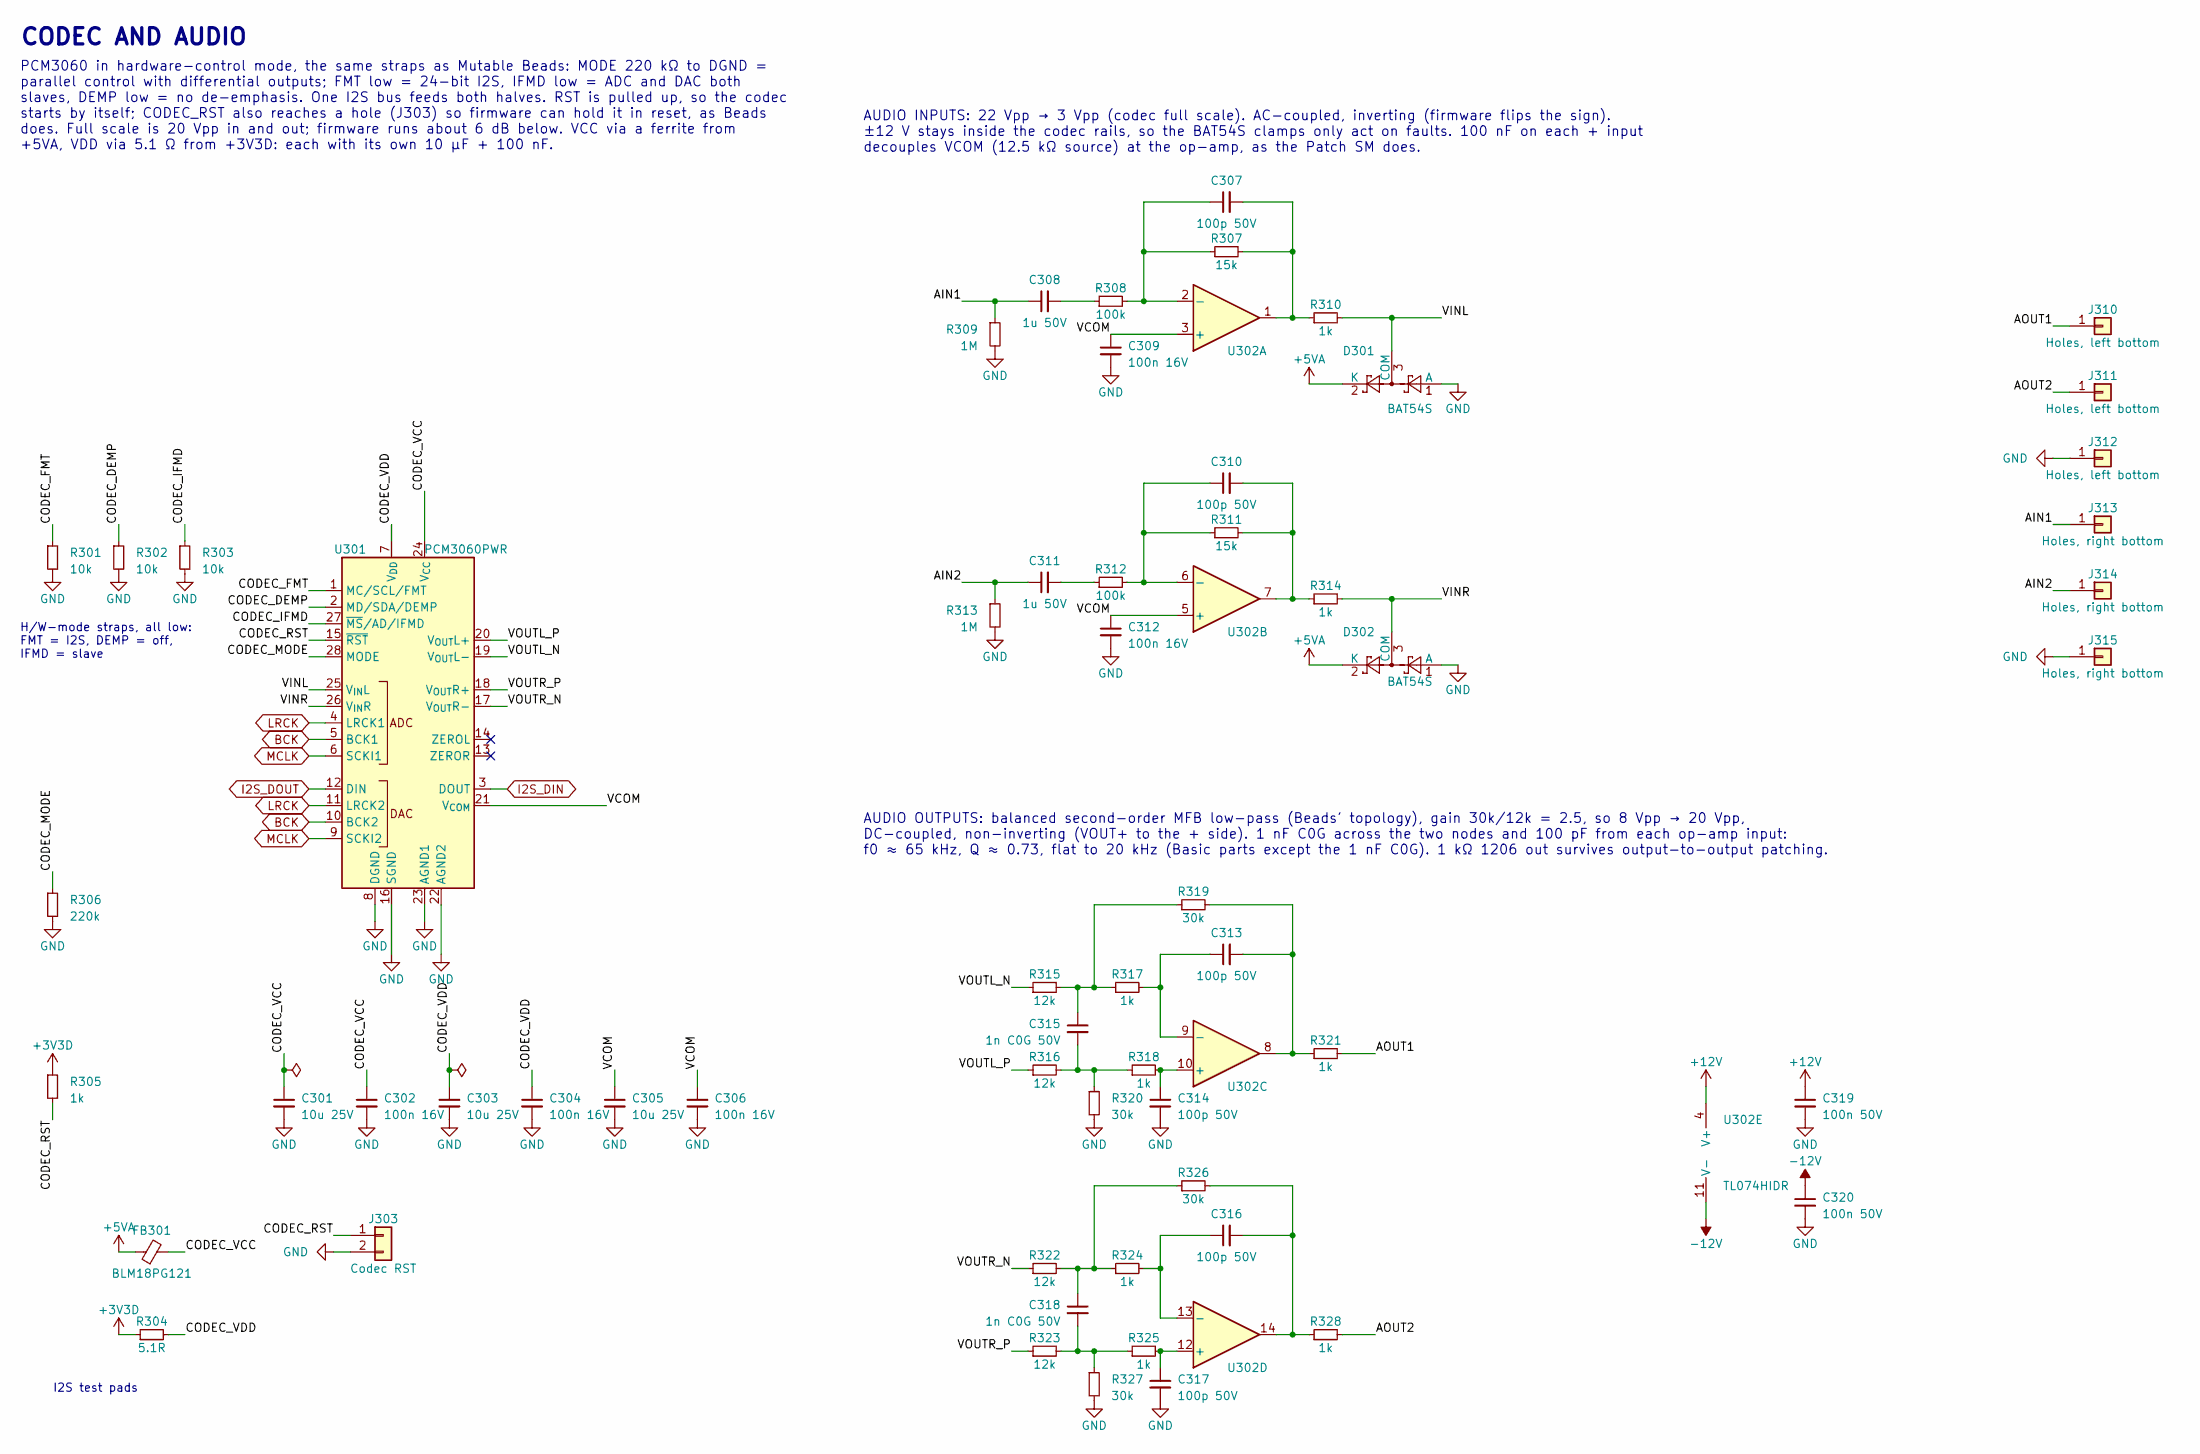
[picture p71: schematic codec_audio.kicad_sch, Codec & audio]

Parts:
C301, C303, C305: 10u 25V; C_0805_2012Metric; Voltage 25V; LCSC C15850
C302, C304, C306, C309, C312: 100n 16V; C_0402_1005Metric; Voltage 16V; LCSC C1525
C307, C310, C313, C314, C316, C317: 100p 50V; C_0402_1005Metric; Voltage 50V; LCSC C1546
C308, C311: 1u 50V; C_0805_2012Metric; Voltage 50V; LCSC C28323
C315, C318: 1n C0G 50V; C_0603_1608Metric; Voltage 50V; LCSC C106246
C319, C320: 100n 50V; C_0603_1608Metric; Voltage 50V; LCSC C14663
D301, D302: BAT54S; SOT-23; MPN BAT54S; LCSC C408389
FB301: BLM18PG121; L_0603_1608Metric; MPN BLM18PG121SN1D; LCSC C14709
J303: Codec RST; WiringHoles_1x02_G2; JLC bare holes
J310, J311: Holes, left bottom; WiringHoles_1x01; JLC bare holes
J312: Holes, left bottom; WiringHoles_1x01_G1; JLC bare holes
J313, J314: Holes, right bottom; WiringHoles_1x01; JLC bare holes
J315: Holes, right bottom; WiringHoles_1x01_G1; JLC bare holes
R301, R302, R303: 10k; R_0402_1005Metric; Tolerance 1%; LCSC C25744
R304: 5.1R; R_0603_1608Metric; Tolerance 1%; LCSC C25197
R305, R310, R314, R317, R318, R324, R325: 1k; R_0402_1005Metric; Tolerance 1%; LCSC C11702
R306: 220k; R_0603_1608Metric; Tolerance 1%; LCSC C22961
R307, R311: 15k; R_0402_1005Metric; Tolerance 1%; LCSC C25756
R308, R312: 100k; R_0402_1005Metric; Tolerance 1%; LCSC C25741
R309, R313: 1M; R_0402_1005Metric; Tolerance 1%; LCSC C26083
R315, R316, R322, R323: 12k; R_0402_1005Metric; Tolerance 1%; LCSC C25752
R319, R320, R326, R327: 30k; R_0603_1608Metric; Tolerance 1%; LCSC C22984
R321, R328: 1k; R_1206_3216Metric; Tolerance 1%; LCSC C4410
U301: PCM3060PWR; TSSOP-28_4.4x9.7mm_P0.65mm; MPN PCM3060PWR; LCSC C2651841
U302: TL074HIDR; SOIC-14_3.9x8.7mm_P1.27mm; MPN TL074HIDR; LCSC C2878713

Connections:
+3V3D: R304.1, R305.1; also elsewhere on the board
+5VA: D301.2 (K), D302.2 (K), FB301.1; also elsewhere on the board
+12V: C319.1, U302.4 (V+); also elsewhere on the board
-12V: C320.1, U302.11 (V-); also elsewhere on the board
/Codec & audio/AIN1: C308.1, J313.1, R309.1
/Codec & audio/AIN2: C311.1, J314.1, R313.1
/Codec & audio/AOUT1: J310.1, R321.2
/Codec & audio/AOUT2: J311.1, R328.2
/Codec & audio/CODEC_DEMP: R302.1, U301.2 (MD/SDA/DEMP)
/Codec & audio/CODEC_FMT: R301.1, U301.1 (MC/SCL/FMT)
/Codec & audio/CODEC_IFMD: R303.1, U301.27 (~MS/AD/IFMD)
/Codec & audio/CODEC_MODE: R306.1, U301.28 (MODE)
/Codec & audio/CODEC_RST: J303.1, R305.2, U301.15 (~RST)
/Codec & audio/CODEC_VCC: C301.1, C302.1, FB301.2, U301.24 (V_{CC})
/Codec & audio/CODEC_VDD: C303.1, C304.1, R304.2, U301.7 (V_{DD})
/Codec & audio/VCOM: C305.1, C306.1, C309.1, C312.1, U301.21 (V_{COM}), U302.3 (+), U302.5 (+)
/Codec & audio/VINL: D301.3 (COM), R310.2, U301.25 (V_{IN}L)
/Codec & audio/VINR: D302.3 (COM), R314.2, U301.26 (V_{IN}R)
/Codec & audio/VOUTL_N: R315.1, U301.19 (V_{OUT}L-)
/Codec & audio/VOUTL_P: R316.1, U301.20 (V_{OUT}L+)
/Codec & audio/VOUTR_N: R322.1, U301.17 (V_{OUT}R-)
/Codec & audio/VOUTR_P: R323.1, U301.18 (V_{OUT}R+)
BCK: U301.5 (BCK1), U301.10 (BCK2); also elsewhere on the board
GND: C301.2, C302.2, C303.2, C304.2, C305.2, C306.2, C309.2, C312.2, C314.2, C317.2, C319.2, C320.2, D301.1 (A), D302.1 (A), J303.2, J312.1, J315.1, R301.2, R302.2, R303.2, R306.2, R309.2, R313.2, R320.2, R327.2, U301.8 (DGND), U301.16 (SGND), U301.22 (AGND2), U301.23 (AGND1); also elsewhere on the board
I2S_DIN: U301.3 (DOUT); also elsewhere on the board
I2S_DOUT: U301.12 (DIN); also elsewhere on the board
LRCK: U301.4 (LRCK1), U301.11 (LRCK2); also elsewhere on the board
MCLK: U301.6 (SCKI1), U301.9 (SCKI2); also elsewhere on the board
unnamed: C307.2, R307.2, R310.1, U302.1
unnamed: C308.2, R308.1
unnamed: C310.2, R311.2, R314.1, U302.7
unnamed: C311.2, R312.1
unnamed: C313.2, R319.2, R321.1, U302.8
unnamed: C315.1, R315.2, R317.1, R319.1
unnamed: C315.2, R316.2, R318.1, R320.1
unnamed: C316.2, R326.2, R328.1, U302.14
unnamed: C318.1, R322.2, R324.1, R326.1
unnamed: C318.2, R323.2, R325.1, R327.1
unnamed: C307.1, R307.1, R308.2, U302.2 (-)
unnamed: C310.1, R311.1, R312.2, U302.6 (-)
unnamed: C314.1, R318.2, U302.10 (+)
unnamed: C313.1, R317.2, U302.9 (-)
unnamed: C317.1, R325.2, U302.12 (+)
unnamed: C316.1, R324.2, U302.13 (-)

Notes on the sheet:
CODEC AND AUDIO
PCM3060 in hardware-control mode, the same straps as Mutable Beads: MODE 220 kΩ to DGND = parallel control with differential outputs; FMT low = 24-bit I2S, IFMD low = ADC and DAC both slaves, DEMP low = no de-emphasis. One I2S bus feeds both halves. RST is pulled up, so the codec starts by itself; 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
H/W-mode straps, all low: FMT = I2S, DEMP = off, IFMD = slave
AUDIO INPUTS: 22 Vpp → 3 Vpp (codec full scale). AC-coupled, inverting (firmware flips the sign). ±12 V stays inside the codec rails, so the BAT54S clamps only act on faults. 100 nF on each + input decouples VCOM (12.5 kΩ source) at the op-amp, as the Patch SM does.
AUDIO OUTPUTS: balanced second-order MFB low-pass (Beads' topology), gain 30k/12k = 2.5, so 8 Vpp → 20 Vpp, DC-coupled, non-inverting (VOUT+ to the + side). 1 nF C0G across the two nodes and 100 pF from each op-amp input: f0 ≈ 65 kHz, Q ≈ 0.73, flat to 20 kHz (Basic parts except the 1 nF C0G). 1 kΩ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
I2S test pads

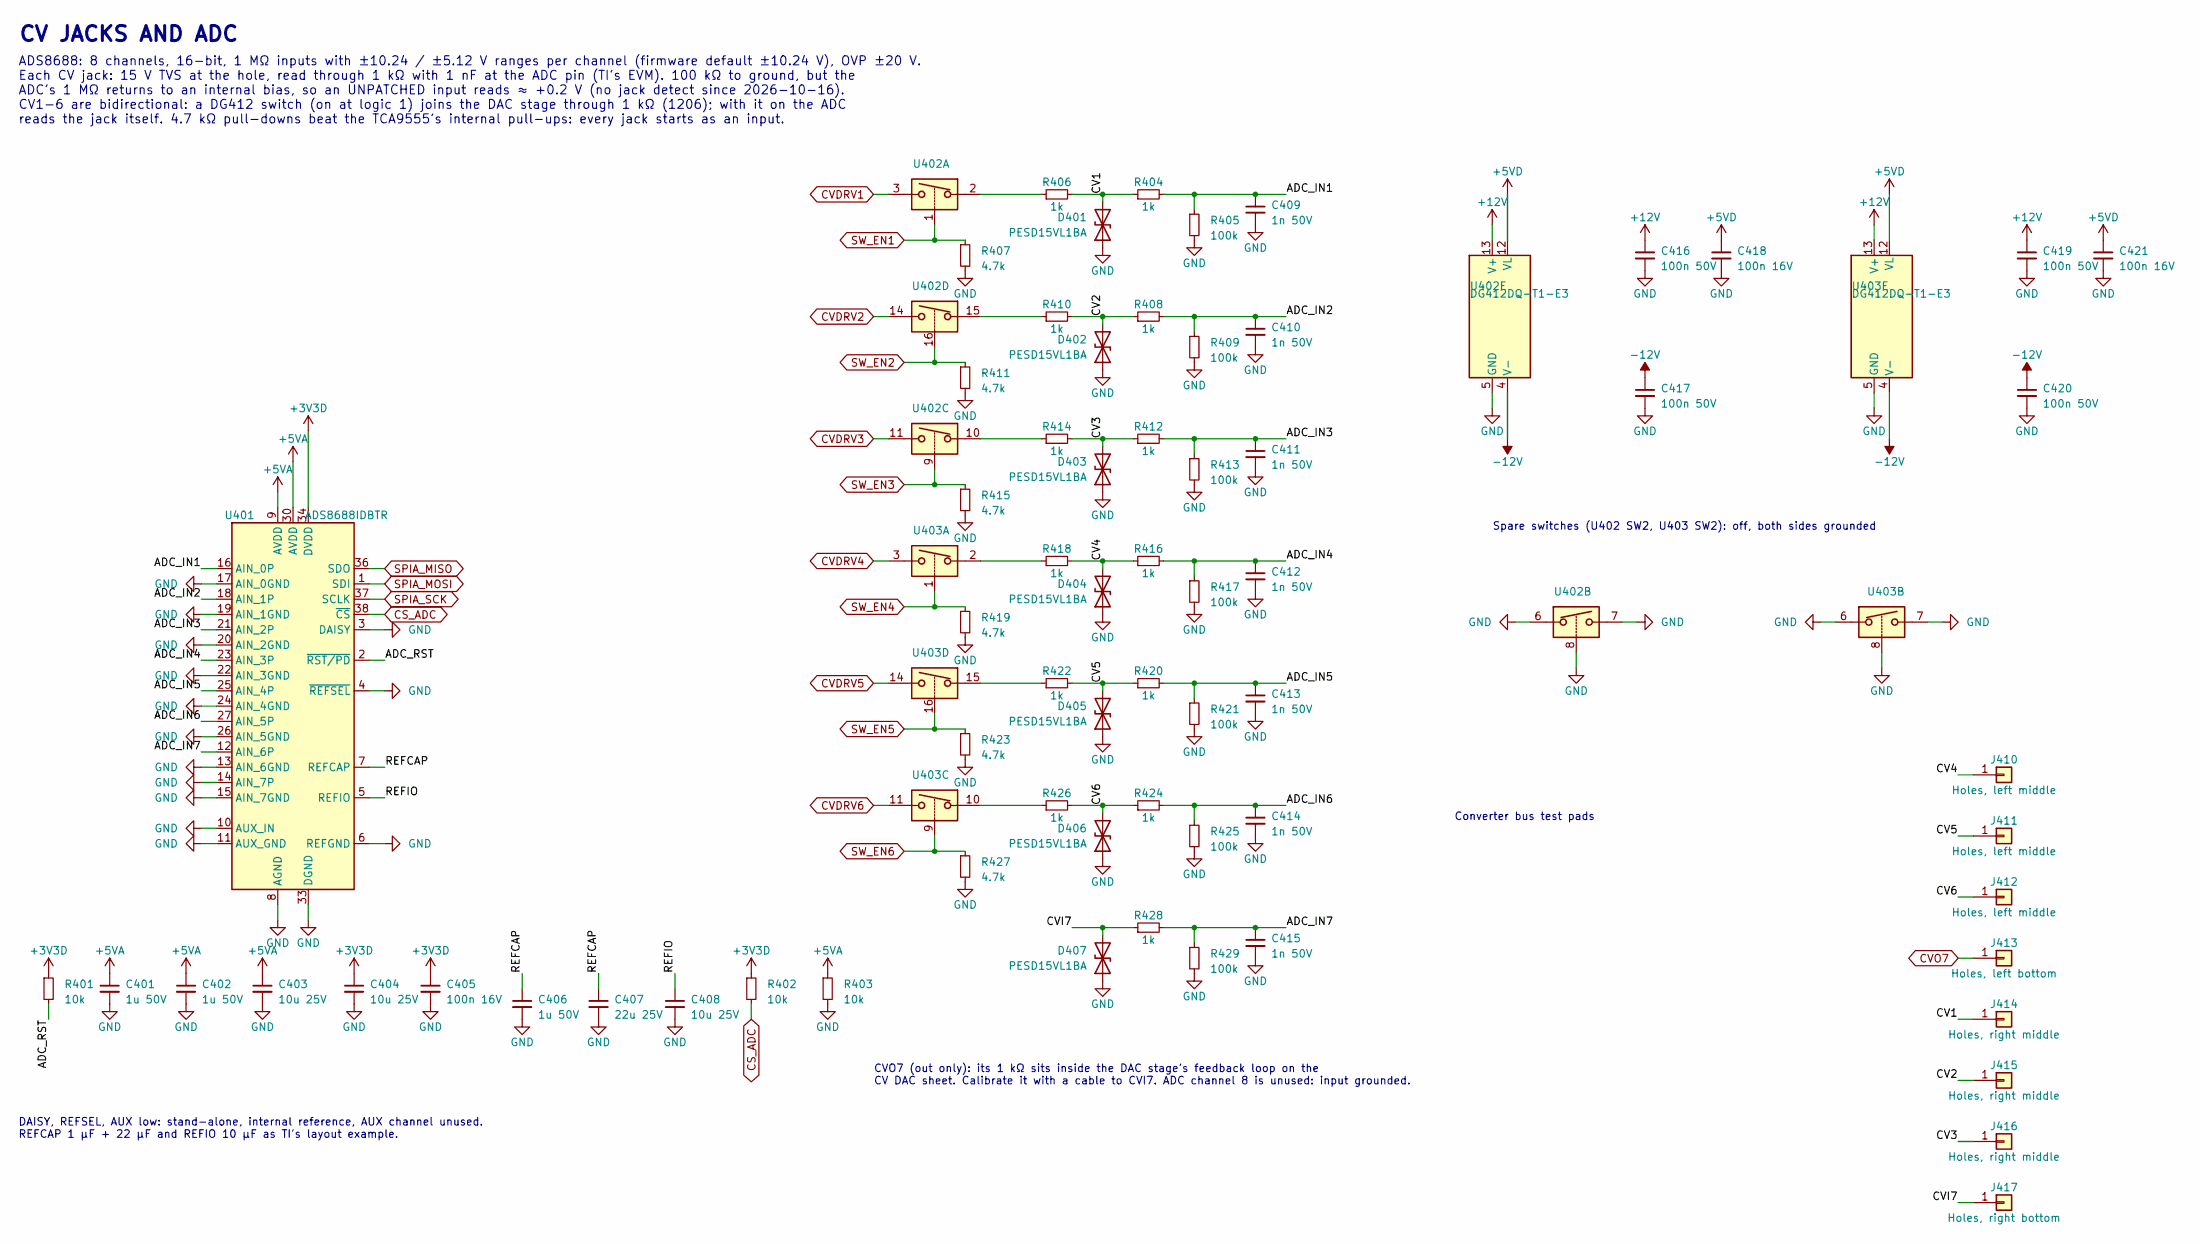
[picture p72: schematic cv_io.kicad_sch, CV jacks & ADC]

Parts:
C401, C402, C406: 1u 50V; C_0603_1608Metric; Voltage 50V; LCSC C15849
C403, C404, C408: 10u 25V; C_0805_2012Metric; Voltage 25V; LCSC C15850
C405, C418, C421: 100n 16V; C_0402_1005Metric; Voltage 16V; LCSC C1525
C407: 22u 25V; C_1206_3216Metric; Voltage 25V; LCSC C12891
C409, C410, C411, C412, C413, C414, C415: 1n 50V; C_0402_1005Metric; Voltage 50V; LCSC C1523
C416, C417, C419, C420: 100n 50V; C_0603_1608Metric; Voltage 50V; LCSC C14663
D401, D402, D403, D404, D405, D406, D407: PESD15VL1BA; D_SOD-323; MPN PESD15VL1BA,115; LCSC C85378
J410, J411, J412: Holes, left middle; WiringHoles_1x01; JLC bare holes
J413: Holes, left bottom; WiringHoles_1x01; JLC bare holes
J414, J415, J416: Holes, right middle; WiringHoles_1x01; JLC bare holes
J417: Holes, right bottom; WiringHoles_1x01; JLC bare holes
R401, R402, R403: 10k; R_0402_1005Metric; Tolerance 1%; LCSC C25744
R404, R408, R412, R416, R420, R424, R428: 1k; R_0402_1005Metric; Tolerance 1%; LCSC C11702
R405, R409, R413, R417, R421, R425, R429: 100k; R_0402_1005Metric; Tolerance 1%; LCSC C25741
R406, R410, R414, R418, R422, R426: 1k; R_1206_3216Metric; Tolerance 1%; LCSC C4410
R407, R411, R415, R419, R423, R427: 4.7k; R_0402_1005Metric; Tolerance 1%; LCSC C25900
U401: ADS8688IDBTR; TSSOP-38_4.4x9.7mm_P0.5mm; MPN ADS8688IDBTR; LCSC C527390
U402, U403: DG412DQ-T1-E3; TSSOP-16_4.4x5mm_P0.65mm; MPN DG412DQ-T1-E3; LCSC C2651920

Connections:
+3V3D: C404.1, C405.1, R401.1, R402.1, U401.34 (DVDD); also elsewhere on the board
+5VA: C401.1, C402.1, C403.1, R403.1, U401.9 (AVDD), U401.30 (AVDD); also elsewhere on the board
+5VD: C418.1, C421.1, U402.12 (VL), U403.12 (VL); also elsewhere on the board
+12V: C416.1, C419.1, U402.13 (V+), U403.13 (V+); also elsewhere on the board
-12V: C417.1, C420.1, U402.4 (V-), U403.4 (V-); also elsewhere on the board
/CV jacks & ADC/ADC_IN1: C409.1, R404.2, R405.1, U401.16 (AIN_0P)
/CV jacks & ADC/ADC_IN2: C410.1, R408.2, R409.1, U401.18 (AIN_1P)
/CV jacks & ADC/ADC_IN3: C411.1, R412.2, R413.1, U401.21 (AIN_2P)
/CV jacks & ADC/ADC_IN4: C412.1, R416.2, R417.1, U401.23 (AIN_3P)
/CV jacks & ADC/ADC_IN5: C413.1, R420.2, R421.1, U401.25 (AIN_4P)
/CV jacks & ADC/ADC_IN6: C414.1, R424.2, R425.1, U401.27 (AIN_5P)
/CV jacks & ADC/ADC_IN7: C415.1, R428.2, R429.1, U401.12 (AIN_6P)
/CV jacks & ADC/ADC_RST: R401.2, U401.2 (~RST/PD)
/CV jacks & ADC/CV1: D401.2 (A2), J414.1, R404.1, R406.2
/CV jacks & ADC/CV2: D402.2 (A2), J415.1, R408.1, R410.2
/CV jacks & ADC/CV3: D403.2 (A2), J416.1, R412.1, R414.2
/CV jacks & ADC/CV4: D404.2 (A2), J410.1, R416.1, R418.2
/CV jacks & ADC/CV5: D405.2 (A2), J411.1, R420.1, R422.2
/CV jacks & ADC/CV6: D406.2 (A2), J412.1, R424.1, R426.2
/CV jacks & ADC/CVI7: D407.2 (A2), J417.1, R428.1
/CV jacks & ADC/REFCAP: C406.1, C407.1, U401.7 (REFCAP)
/CV jacks & ADC/REFIO: C408.1, U401.5 (REFIO)
CS_ADC: R402.2, U401.38 (~CS); also elsewhere on the board
CVDRV1: U402.3; also elsewhere on the board
CVDRV2: U402.14; also elsewhere on the board
CVDRV3: U402.11; also elsewhere on the board
CVDRV4: U403.3; also elsewhere on the board
CVDRV5: U403.14; also elsewhere on the board
CVDRV6: U403.11; also elsewhere on the board
CVO7: J413.1; also elsewhere on the board
GND: C401.2, C402.2, C403.2, C404.2, C405.2, C406.2, C407.2, C408.2, C409.2, C410.2, C411.2, C412.2, C413.2, C414.2, C415.2, C416.2, C417.2, C418.2, C419.2, C420.2, C421.2, D401.1 (A1), D402.1 (A1), D403.1 (A1), D404.1 (A1), D405.1 (A1), D406.1 (A1), D407.1 (A1), R403.2, R405.2, R407.2, R409.2, R411.2, R413.2, R415.2, R417.2, R419.2, R421.2, R423.2, R425.2, R427.2, R429.2, U401.3 (DAISY), U401.4 (~REFSEL), U401.6 (REFGND), U401.8 (AGND), U401.10 (AUX_IN), U401.11 (AUX_GND), U401.13 (AIN_6GND), U401.14 (AIN_7P), U401.15 (AIN_7GND), U401.17 (AIN_0GND), U401.19 (AIN_1GND), U401.20 (AIN_2GND), U401.22 (AIN_3GND), U401.24 (AIN_4GND), U401.26 (AIN_5GND), U401.28 (AGND), U401.29 (AGND), U401.31 (AGND), U401.32 (AGND), U401.33 (DGND), U402.5 (GND), U402.6, U402.7, U402.8, U403.5 (GND), U403.6, U403.7, U403.8; also elsewhere on the board
unnamed: R406.1, U402.2
unnamed: R410.1, U402.15
unnamed: R414.1, U402.10
unnamed: R418.1, U403.2
unnamed: R422.1, U403.15
unnamed: R426.1, U403.10
SPIA_MISO: U401.36 (SDO); also elsewhere on the board
SPIA_MOSI: U401.1 (SDI); also elsewhere on the board
SPIA_SCK: U401.37 (SCLK); also elsewhere on the board
SW_EN1: R407.1, U402.1; also elsewhere on the board
SW_EN2: R411.1, U402.16; also elsewhere on the board
SW_EN3: R415.1, U402.9; also elsewhere on the board
SW_EN4: R419.1, U403.1; also elsewhere on the board
SW_EN5: R423.1, U403.16; also elsewhere on the board
SW_EN6: R427.1, U403.9; also elsewhere on the board

Notes on the sheet:
CV JACKS AND ADC
ADS8688: 8 channels, 16-bit, 1 MΩ inputs with ±10.24 / ±5.12 V ranges per channel (firmware default ±10.24 V), OVP ±20 V. Each CV jack: 15 V TVS at the hole, read through 1 kΩ with 1 nF at the ADC pin (TI's EVM). 100 kΩ to ground, but the ADC's 1 MΩ returns to an internal bias, so an UNPATCHED inpu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
DAISY, REFSEL, AUX low: stand-alone, internal reference, AUX channel unused. REFCAP 1 µF + 22 µF and REFIO 10 µF as TI's layout example.
CVO7 (out only): its 1 kΩ sits inside the DAC stage's feedback loop on the CV DAC sheet. Calibrate it with a cable to CVI7. ADC channel 8 is unused: input grounded.
Spare switches (U402 SW2, U403 SW2): off, both sides grounded
Converter bus test pads
