Eight4aWish/eurorack_electronics/hardware/analogue_board/pico_revb/analogue_board_pico_revb.kicad_pcb

## KiCad design hardware/analogue_board/pico_revb/analogue_board_pico_revb.kicad_pcb (continued)

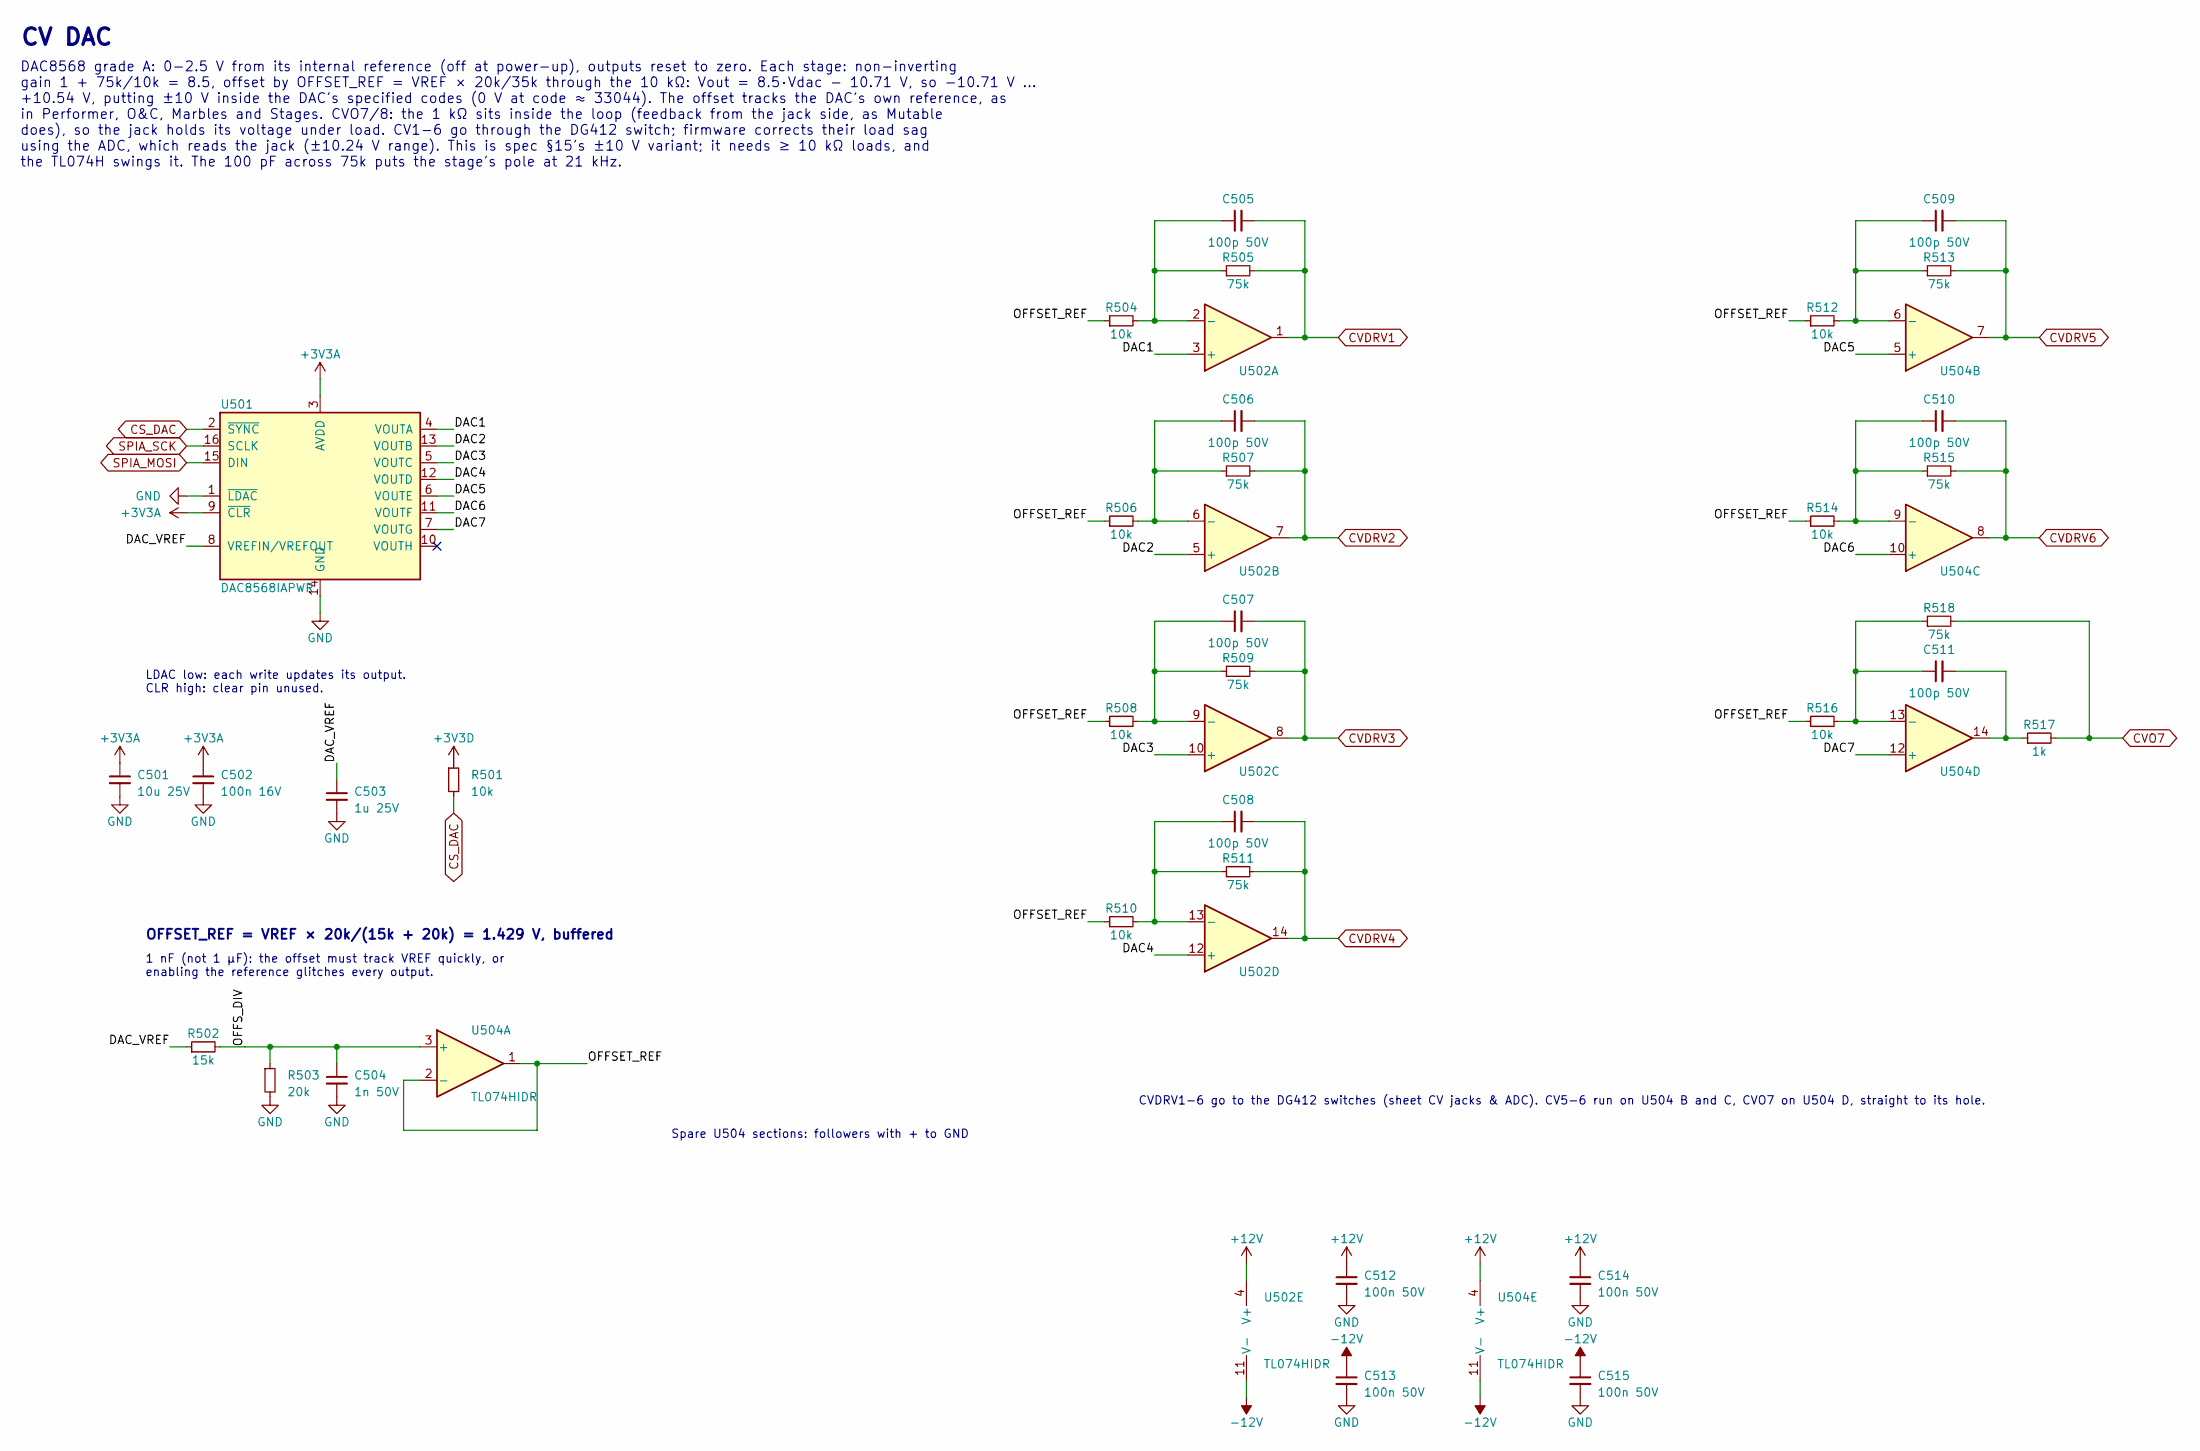
[picture p73: schematic cv_dac.kicad_sch, CV DAC]

Parts:
C501: 10u 25V; C_0805_2012Metric; Voltage 25V; LCSC C15850
C502: 100n 16V; C_0402_1005Metric; Voltage 16V; LCSC C1525
C503: 1u 25V; C_0402_1005Metric; Voltage 25V; LCSC C52923
C504: 1n 50V; C_0402_1005Metric; Voltage 50V; LCSC C1523
C505, C506, C507, C508, C509, C510, C511: 100p 50V; C_0402_1005Metric; Voltage 50V; LCSC C1546
C512, C513, C514, C515: 100n 50V; C_0603_1608Metric; Voltage 50V; LCSC C14663
R501, R504, R506, R508, R510, R512, R514, R516: 10k; R_0402_1005Metric; Tolerance 1%; LCSC C25744
R502: 15k; R_0402_1005Metric; Tolerance 1%; LCSC C25756
R503: 20k; R_0402_1005Metric; Tolerance 1%; LCSC C25765
R505, R507, R509, R511, R513, R515, R518: 75k; R_0603_1608Metric; Tolerance 1%; LCSC C23242
R517: 1k; R_1206_3216Metric; Tolerance 1%; LCSC C4410
U501: DAC8568IAPWR; TSSOP-16_4.4x5mm_P0.65mm; MPN DAC8568IAPWR; LCSC C486051
U502, U504: TL074HIDR; SOIC-14_3.9x8.7mm_P1.27mm; MPN TL074HIDR; LCSC C2878713

Connections:
+3V3A: C501.1, C502.1, U501.3 (AVDD), U501.9 (~CLR); also elsewhere on the board
+3V3D: R501.1; also elsewhere on the board
+12V: C512.1, C514.1, U502.4 (V+), U504.4 (V+); also elsewhere on the board
-12V: C513.1, C515.1, U502.11 (V-), U504.11 (V-); also elsewhere on the board
/CV DAC/DAC1: U501.4 (VOUTA), U502.3 (+)
/CV DAC/DAC2: U501.13 (VOUTB), U502.5 (+)
/CV DAC/DAC3: U501.5 (VOUTC), U502.10 (+)
/CV DAC/DAC4: U501.12 (VOUTD), U502.12 (+)
/CV DAC/DAC5: U501.6 (VOUTE), U504.5 (+)
/CV DAC/DAC6: U501.11 (VOUTF), U504.10 (+)
/CV DAC/DAC7: U501.7 (VOUTG), U504.12 (+)
/CV DAC/DAC_VREF: C503.1, R502.1, U501.8 (VREFIN/VREFOUT)
/CV DAC/OFFSET_REF: R504.1, R506.1, R508.1, R510.1, R512.1, R514.1, R516.1, U504.1, U504.2 (-)
/CV DAC/OFFS_DIV: C504.1, R502.2, R503.1, U504.3 (+)
CS_DAC: R501.2, U501.2 (~SYNC); also elsewhere on the board
CVDRV1: C505.2, R505.2, U502.1; also elsewhere on the board
CVDRV2: C506.2, R507.2, U502.7; also elsewhere on the board
CVDRV3: C507.2, R509.2, U502.8; also elsewhere on the board
CVDRV4: C508.2, R511.2, U502.14; also elsewhere on the board
CVDRV5: C509.2, R513.2, U504.7; also elsewhere on the board
CVDRV6: C510.2, R515.2, U504.8; also elsewhere on the board
CVO7: R517.2, R518.2; also elsewhere on the board
GND: C501.2, C502.2, C503.2, C504.2, C512.2, C513.2, C514.2, C515.2, R503.2, U501.1 (~LDAC), U501.14 (GND); also elsewhere on the board
unnamed: C511.2, R517.1, U504.14
unnamed: C505.1, R504.2, R505.1, U502.2 (-)
unnamed: C506.1, R506.2, R507.1, U502.6 (-)
unnamed: C507.1, R508.2, R509.1, U502.9 (-)
unnamed: C508.1, R510.2, R511.1, U502.13 (-)
unnamed: C509.1, R512.2, R513.1, U504.6 (-)
unnamed: C510.1, R514.2, R515.1, U504.9 (-)
unnamed: C511.1, R516.2, R518.1, U504.13 (-)
SPIA_MOSI: U501.15 (DIN); also elsewhere on the board
SPIA_SCK: U501.16 (SCLK); also elsewhere on the board

Notes on the sheet:
CV DAC
DAC8568 grade A: 0-2.5 V from its internal reference (off at power-up), outputs reset to zero. Each stage: non-inverting gain 1 + 75k/10k = 8.5, offset by OFFSET_REF = VREF × 20k/35k through the 10 kΩ: Vout = 8.5·Vdac − 10.71 V, so −10.71 V … +10.54 V, putting ±10 V inside the DAC's specified codes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
LDAC low: each write updates its output. CLR high: clear pin unused.
OFFSET_REF = VREF × 20k/(15k + 20k) = 1.429 V, buffered
1 nF (not 1 µF): the offset must track VREF quickly, or enabling the reference glitches every output.
CVDRV1-6 go to the DG412 switches (sheet CV jacks & ADC). CV5-6 run on U504 B and C, CVO7 on U504 D, straight to its hole.
Spare U504 sections: followers with + to GND

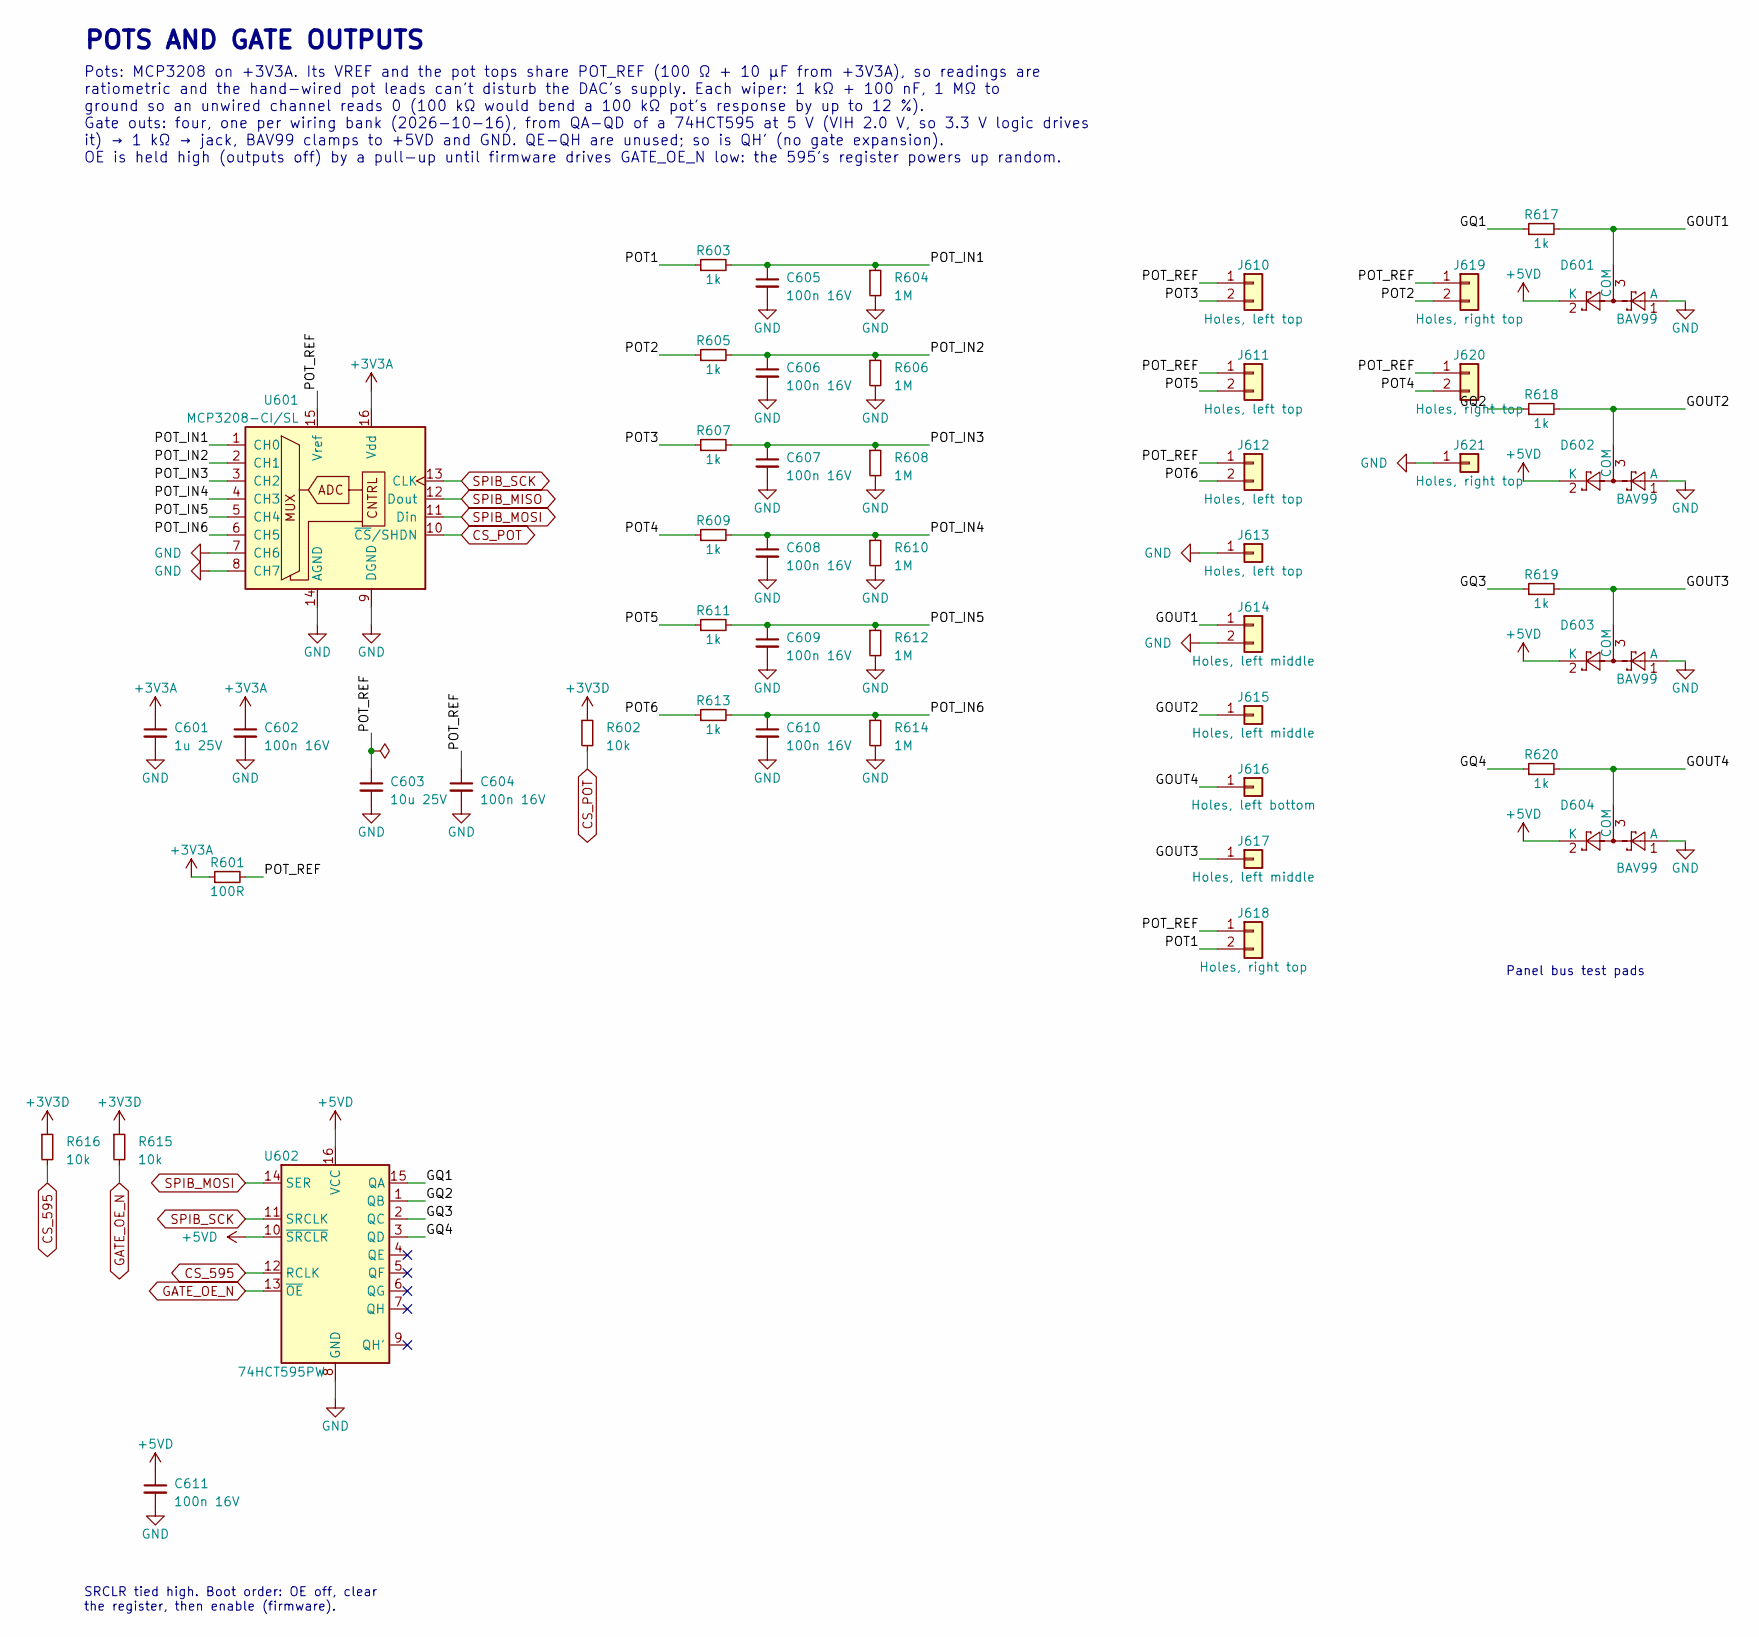
[picture p74: schematic pots_gates.kicad_sch, Pots & gate outs]

Parts:
C601: 1u 25V; C_0402_1005Metric; Voltage 25V; LCSC C52923
C602, C604, C605, C606, C607, C608, C609, C610, C611: 100n 16V; C_0402_1005Metric; Voltage 16V; LCSC C1525
C603: 10u 25V; C_0805_2012Metric; Voltage 25V; LCSC C15850
D601, D602, D603, D604: BAV99; SOT-23; MPN BAV99,215; LCSC C2500
J610, J611, J612: Holes, left top; WiringHoles_1x02; JLC bare holes
J613: Holes, left top; WiringHoles_1x01_G1; JLC bare holes
J614: Holes, left middle; WiringHoles_1x02_G2; JLC bare holes
J615, J617: Holes, left middle; WiringHoles_1x01; JLC bare holes
J616: Holes, left bottom; WiringHoles_1x01; JLC bare holes
J618, J619, J620: Holes, right top; WiringHoles_1x02; JLC bare holes
J621: Holes, right top; WiringHoles_1x01_G1; JLC bare holes
R601: 100R; R_0805_2012Metric; Tolerance 1%; LCSC C17408
R602, R615, R616: 10k; R_0402_1005Metric; Tolerance 1%; LCSC C25744
R603, R605, R607, R609, R611, R613, R617, R618, R619, R620: 1k; R_0402_1005Metric; Tolerance 1%; LCSC C11702
R604, R606, R608, R610, R612, R614: 1M; R_0402_1005Metric; Tolerance 1%; LCSC C26083
U601: MCP3208-CI/SL; SOIC-16_3.9x9.9mm_P1.27mm; MPN MCP3208-CI/SL; LCSC C16939
U602: 74HCT595PW; TSSOP-16_4.4x5mm_P0.65mm; MPN 74HCT595PW,118; LCSC C99710

Connections:
+3V3A: C601.1, C602.1, R601.1, U601.16 (Vdd); also elsewhere on the board
+3V3D: R602.1, R615.1, R616.1; also elsewhere on the board
+5VD: C611.1, D601.2 (K), D602.2 (K), D603.2 (K), D604.2 (K), U602.10 (~SRCLR), U602.16 (VCC); also elsewhere on the board
/Pots & gate outs/GOUT1: D601.3 (COM), J614.1, R617.2
/Pots & gate outs/GOUT2: D602.3 (COM), J615.1, R618.2
/Pots & gate outs/GOUT3: D603.3 (COM), J617.1, R619.2
/Pots & gate outs/GOUT4: D604.3 (COM), J616.1, R620.2
/Pots & gate outs/GQ1: R617.1, U602.15 (QA)
/Pots & gate outs/GQ2: R618.1, U602.1 (QB)
/Pots & gate outs/GQ3: R619.1, U602.2 (QC)
/Pots & gate outs/GQ4: R620.1, U602.3 (QD)
/Pots & gate outs/POT1: J618.2, R603.1
/Pots & gate outs/POT2: J619.2, R605.1
/Pots & gate outs/POT3: J610.2, R607.1
/Pots & gate outs/POT4: J620.2, R609.1
/Pots & gate outs/POT5: J611.2, R611.1
/Pots & gate outs/POT6: J612.2, R613.1
/Pots & gate outs/POT_IN1: C605.1, R603.2, R604.1, U601.1 (CH0)
/Pots & gate outs/POT_IN2: C606.1, R605.2, R606.1, U601.2 (CH1)
/Pots & gate outs/POT_IN3: C607.1, R607.2, R608.1, U601.3 (CH2)
/Pots & gate outs/POT_IN4: C608.1, R609.2, R610.1, U601.4 (CH3)
/Pots & gate outs/POT_IN5: C609.1, R611.2, R612.1, U601.5 (CH4)
/Pots & gate outs/POT_IN6: C610.1, R613.2, R614.1, U601.6 (CH5)
/Pots & gate outs/POT_REF: C603.1, C604.1, J610.1, J611.1, J612.1, J618.1, J619.1, J620.1, R601.2, U601.15 (Vref)
CS_595: R616.2, U602.12 (RCLK); also elsewhere on the board
CS_POT: R602.2, U601.10 (~CS/SHDN); also elsewhere on the board
GATE_OE_N: R615.2, U602.13 (~OE); also elsewhere on the board
GND: C601.2, C602.2, C603.2, C604.2, C605.2, C606.2, C607.2, C608.2, C609.2, C610.2, C611.2, D601.1 (A), D602.1 (A), D603.1 (A), D604.1 (A), J613.1, J614.2, J621.1, R604.2, R606.2, R608.2, R610.2, R612.2, R614.2, U601.7 (CH6), U601.8 (CH7), U601.9 (DGND), U601.14 (AGND), U602.8 (GND); also elsewhere on the board
SPIB_MISO: U601.12 (Dout); also elsewhere on the board
SPIB_MOSI: U601.11 (Din), U602.14 (SER); also elsewhere on the board
SPIB_SCK: U601.13 (CLK), U602.11 (SRCLK); also elsewhere on the board

Notes on the sheet:
POTS AND GATE OUTPUTS
Pots: MCP3208 on +3V3A. Its VREF and the pot tops share POT_REF (100 Ω + 10 µF from +3V3A), so readings are ratiometric and the hand-wired pot leads can't disturb the DAC's supply. Each wiper: 1 kΩ + 100 nF, 1 MΩ to ground so an unwired channel reads 0 (100 kΩ would bend a 100 kΩ pot's response by 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
SRCLR tied high. Boot order: OE off, clear the register, then enable (firmware).
Panel bus test pads

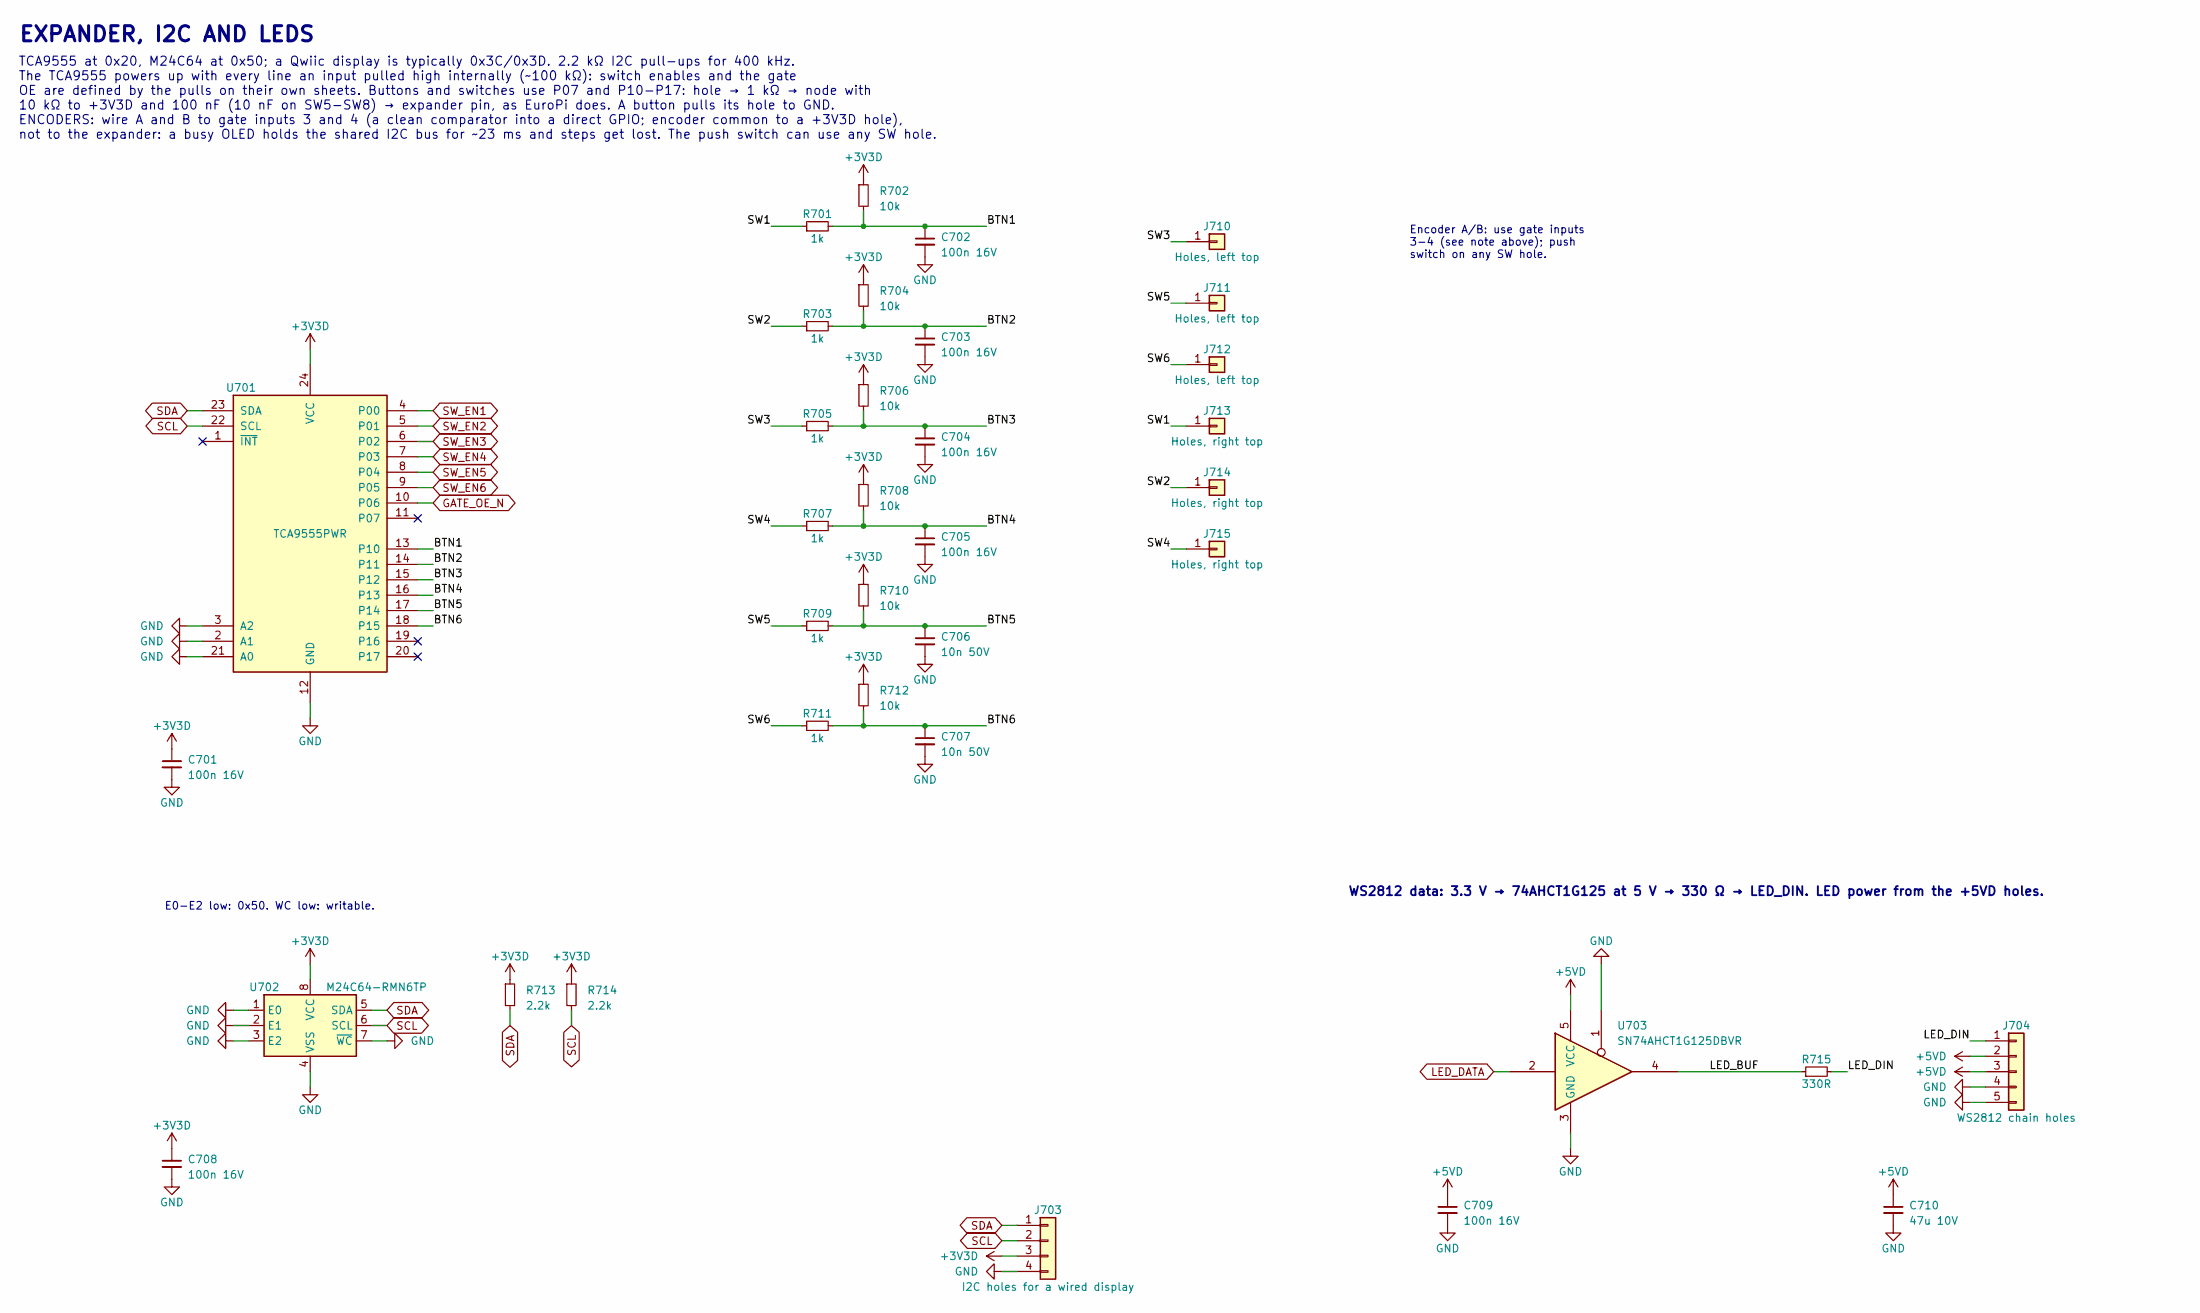
[picture p75: schematic expander_i2c.kicad_sch, Expander, I2C & LEDs]

Parts:
C701, C702, C703, C704, C705, C708, C709: 100n 16V; C_0402_1005Metric; Voltage 16V; LCSC C1525
C706, C707: 10n 50V; C_0402_1005Metric; Voltage 50V; LCSC C15195
C710: 47u 10V; C_1206_3216Metric; Voltage 10V; LCSC C96123
J703: I2C holes for a wired display; WiringHoles_1x04_G4; JLC bare holes
J704: WS2812 chain holes; WiringHoles_1x05_G4_5; JLC bare holes
J710, J711, J712: Holes, left top; WiringHoles_1x01; JLC bare holes
J713, J714, J715: Holes, right top; WiringHoles_1x01; JLC bare holes
R701, R703, R705, R707, R709, R711: 1k; R_0402_1005Metric; Tolerance 1%; LCSC C11702
R702, R704, R706, R708, R710, R712: 10k; R_0402_1005Metric; Tolerance 1%; LCSC C25744
R713, R714: 2.2k; R_0402_1005Metric; Tolerance 1%; LCSC C25879
R715: 330R; R_0402_1005Metric; Tolerance 1%; LCSC C25104
U701: TCA9555PWR; TSSOP-24_4.4x7.8mm_P0.65mm; MPN TCA9555PWR; LCSC C465732
U702: M24C64-RMN6TP; SOIC-8_3.9x4.9mm_P1.27mm; MPN M24C64-RMN6TP; LCSC C79988
U703: SN74AHCT1G125DBVR; SOT-23-5; MPN SN74AHCT1G125DBVR; LCSC C7484

Connections:
+3V3D: C701.1, C708.1, J703.3, R702.1, R704.1, R706.1, R708.1, R710.1, R712.1, R713.1, R714.1, U701.24 (VCC), U702.8 (VCC); also elsewhere on the board
+5VD: C709.1, C710.1, J704.2, J704.3, U703.5 (VCC); also elsewhere on the board
/Expander, I2C & LEDs/BTN1: C702.1, R701.2, R702.2, U701.13 (P10)
/Expander, I2C & LEDs/BTN2: C703.1, R703.2, R704.2, U701.14 (P11)
/Expander, I2C & LEDs/BTN3: C704.1, R705.2, R706.2, U701.15 (P12)
/Expander, I2C & LEDs/BTN4: C705.1, R707.2, R708.2, U701.16 (P13)
/Expander, I2C & LEDs/BTN5: C706.1, R709.2, R710.2, U701.17 (P14)
/Expander, I2C & LEDs/BTN6: C707.1, R711.2, R712.2, U701.18 (P15)
/Expander, I2C & LEDs/LED_BUF: R715.1, U703.4
/Expander, I2C & LEDs/LED_DIN: J704.1, R715.2
/Expander, I2C & LEDs/SW1: J713.1, R701.1
/Expander, I2C & LEDs/SW2: J714.1, R703.1
/Expander, I2C & LEDs/SW3: J710.1, R705.1
/Expander, I2C & LEDs/SW4: J715.1, R707.1
/Expander, I2C & LEDs/SW5: J711.1, R709.1
/Expander, I2C & LEDs/SW6: J712.1, R711.1
GATE_OE_N: U701.10 (P06); also elsewhere on the board
GND: C701.2, C702.2, C703.2, C704.2, C705.2, C706.2, C707.2, C708.2, C709.2, C710.2, J703.4, J704.4, J704.5, U701.2 (A1), U701.3 (A2), U701.12 (GND), U701.21 (A0), U702.1 (E0), U702.2 (E1), U702.3 (E2), U702.4 (VSS), U702.7 (~WC), U703.1, U703.3 (GND); also elsewhere on the board
LED_DATA: U703.2; also elsewhere on the board
SCL: J703.2, R714.2, U701.22 (SCL), U702.6 (SCL); also elsewhere on the board
SDA: J703.1, R713.2, U701.23 (SDA), U702.5 (SDA); also elsewhere on the board
SW_EN1: U701.4 (P00); also elsewhere on the board
SW_EN2: U701.5 (P01); also elsewhere on the board
SW_EN3: U701.6 (P02); also elsewhere on the board
SW_EN4: U701.7 (P03); also elsewhere on the board
SW_EN5: U701.8 (P04); also elsewhere on the board
SW_EN6: U701.9 (P05); also elsewhere on the board

Notes on the sheet:
EXPANDER, I2C AND LEDS
TCA9555 at 0x20, M24C64 at 0x50; a Qwiic display is typically 0x3C/0x3D. 2.2 kΩ I2C pull-ups for 400 kHz. The TCA9555 powers up with every line an input pulled high internally (~100 kΩ): switch enables and the gate OE are defined by the pulls on their own sheets. Buttons and switches use P07 and P1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
Encoder A/B: use gate inputs 3-4 (see note above); push switch on any SW hole.
E0-E2 low: 0x50. WC low: writable.
WS2812 data: 3.3 V → 74AHCT1G125 at 5 V → 330 Ω → LED_DIN. LED power from the +5VD holes.

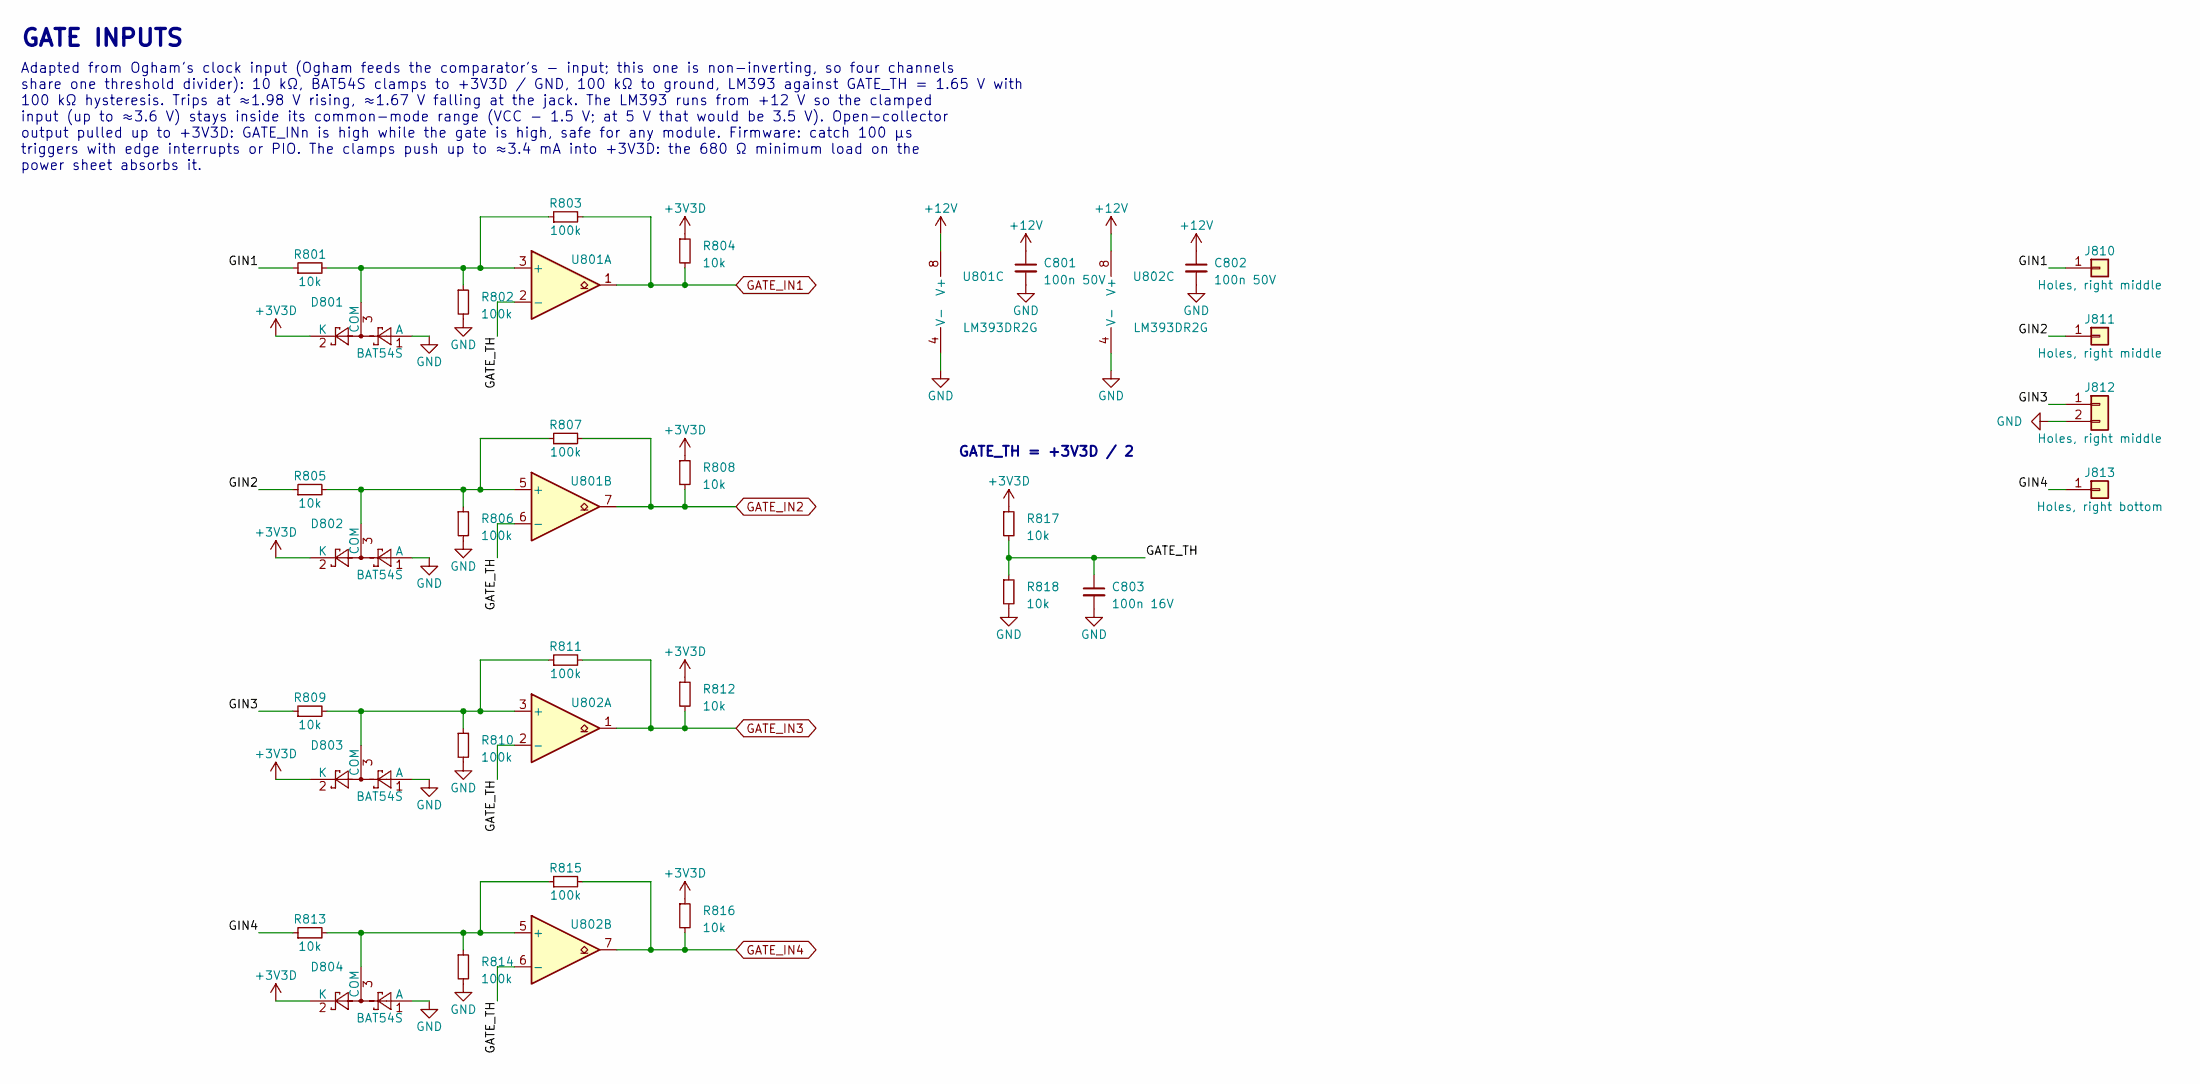
[picture p76: schematic gate_in.kicad_sch, Gate ins]

Parts:
C801, C802: 100n 50V; C_0603_1608Metric; Voltage 50V; LCSC C14663
C803: 100n 16V; C_0402_1005Metric; Voltage 16V; LCSC C1525
D801, D802, D803, D804: BAT54S; SOT-23; MPN BAT54S; LCSC C408389
J810, J811: Holes, right middle; WiringHoles_1x01; JLC bare holes
J812: Holes, right middle; WiringHoles_1x02_G2; JLC bare holes
J813: Holes, right bottom; WiringHoles_1x01; JLC bare holes
R801, R804, R805, R808, R809, R812, R813, R816, R817, R818: 10k; R_0402_1005Metric; Tolerance 1%; LCSC C25744
R802, R803, R806, R807, R810, R811, R814, R815: 100k; R_0402_1005Metric; Tolerance 1%; LCSC C25741
U801, U802: LM393DR2G; SOIC-8_3.9x4.9mm_P1.27mm; MPN LM393DR2G; LCSC C7955

Connections:
+3V3D: D801.2 (K), D802.2 (K), D803.2 (K), D804.2 (K), R804.1, R808.1, R812.1, R816.1, R817.1; also elsewhere on the board
+12V: C801.1, C802.1, U801.8 (V+), U802.8 (V+); also elsewhere on the board
/Gate ins/GATE_TH: C803.1, R817.2, R818.1, U801.2 (-), U801.6 (-), U802.2 (-), U802.6 (-)
/Gate ins/GIN1: J810.1, R801.1
/Gate ins/GIN2: J811.1, R805.1
/Gate ins/GIN3: J812.1, R809.1
/Gate ins/GIN4: J813.1, R813.1
GATE_IN1: R803.2, R804.2, U801.1; also elsewhere on the board
GATE_IN2: R807.2, R808.2, U801.7; also elsewhere on the board
GATE_IN3: R811.2, R812.2, U802.1; also elsewhere on the board
GATE_IN4: R815.2, R816.2, U802.7; also elsewhere on the board
GND: C801.2, C802.2, C803.2, D801.1 (A), D802.1 (A), D803.1 (A), D804.1 (A), J812.2, R802.2, R806.2, R810.2, R814.2, R818.2, U801.4 (V-), U802.4 (V-); also elsewhere on the board
unnamed: D801.3 (COM), R801.2, R802.1, R803.1, U801.3 (+)
unnamed: D802.3 (COM), R805.2, R806.1, R807.1, U801.5 (+)
unnamed: D803.3 (COM), R809.2, R810.1, R811.1, U802.3 (+)
unnamed: D804.3 (COM), R813.2, R814.1, R815.1, U802.5 (+)

Notes on the sheet:
GATE INPUTS
Adapted from Ogham's clock input (Ogham feeds the comparator's − input; this one is non-inverting, so four channels share one threshold divider): 10 kΩ, BAT54S clamps to +3V3D / GND, 100 kΩ to ground, LM393 against GATE_TH = 1.65 V with 100 kΩ hysteresis. Trips at ≈1.98 V rising, ≈1.67 V falling at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
GATE_TH = +3V3D / 2
