Eight4aWish/eurorack_electronics/hardware/analogue_board/pico_revb/analogue_board_pico_revb.kicad_pcb

## KiCad design hardware/analogue_board/pico_revb/analogue_board_pico_revb.kicad_pcb (continued)

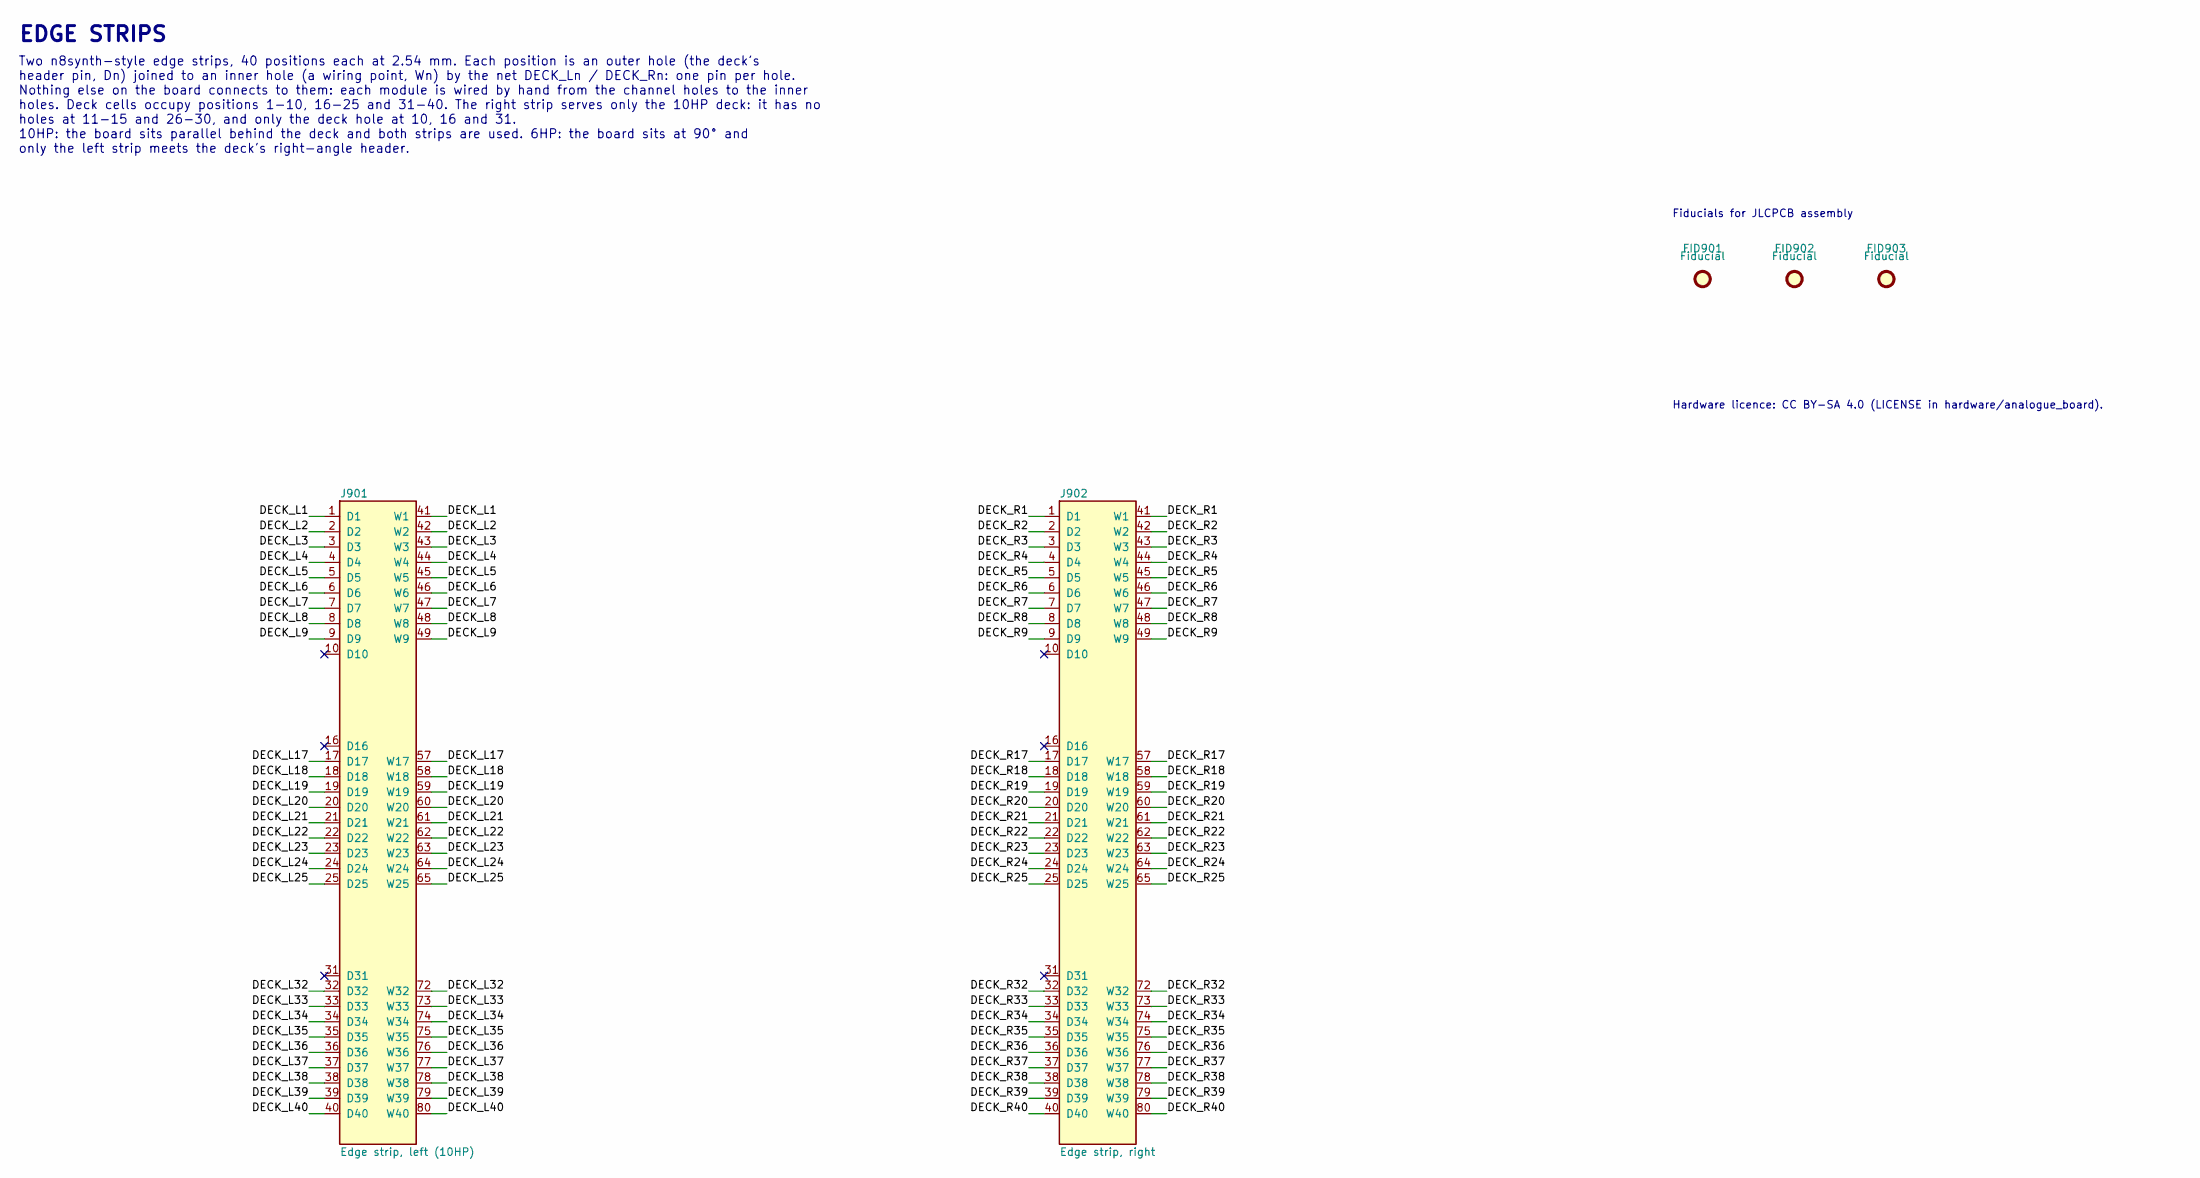
[picture p77: schematic edge_strips.kicad_sch, Edge strips]

Parts:
FID901, FID902, FID903: Fiducial; Fiducial_1mm_Mask2mm; JLC bare pad
J901: Edge strip, left (10HP); EdgeStrip_40_Left_10HP; JLC bare holes
J902: Edge strip, right; EdgeStrip_40_Right; JLC bare holes

Connections:
/Edge strips/DECK_L1: J901.1 (D1), J901.41 (W1)
/Edge strips/DECK_L2: J901.2 (D2), J901.42 (W2)
/Edge strips/DECK_L3: J901.3 (D3), J901.43 (W3)
/Edge strips/DECK_L4: J901.4 (D4), J901.44 (W4)
/Edge strips/DECK_L5: J901.5 (D5), J901.45 (W5)
/Edge strips/DECK_L6: J901.6 (D6), J901.46 (W6)
/Edge strips/DECK_L7: J901.7 (D7), J901.47 (W7)
/Edge strips/DECK_L8: J901.8 (D8), J901.48 (W8)
/Edge strips/DECK_L9: J901.9 (D9), J901.49 (W9)
/Edge strips/DECK_L17: J901.17 (D17), J901.57 (W17)
/Edge strips/DECK_L18: J901.18 (D18), J901.58 (W18)
/Edge strips/DECK_L19: J901.19 (D19), J901.59 (W19)
/Edge strips/DECK_L20: J901.20 (D20), J901.60 (W20)
/Edge strips/DECK_L21: J901.21 (D21), J901.61 (W21)
/Edge strips/DECK_L22: J901.22 (D22), J901.62 (W22)
/Edge strips/DECK_L23: J901.23 (D23), J901.63 (W23)
/Edge strips/DECK_L24: J901.24 (D24), J901.64 (W24)
/Edge strips/DECK_L25: J901.25 (D25), J901.65 (W25)
/Edge strips/DECK_L32: J901.32 (D32), J901.72 (W32)
/Edge strips/DECK_L33: J901.33 (D33), J901.73 (W33)
/Edge strips/DECK_L34: J901.34 (D34), J901.74 (W34)
/Edge strips/DECK_L35: J901.35 (D35), J901.75 (W35)
/Edge strips/DECK_L36: J901.36 (D36), J901.76 (W36)
/Edge strips/DECK_L37: J901.37 (D37), J901.77 (W37)
/Edge strips/DECK_L38: J901.38 (D38), J901.78 (W38)
/Edge strips/DECK_L39: J901.39 (D39), J901.79 (W39)
/Edge strips/DECK_L40: J901.40 (D40), J901.80 (W40)
/Edge strips/DECK_R1: J902.1 (D1), J902.41 (W1)
/Edge strips/DECK_R2: J902.2 (D2), J902.42 (W2)
/Edge strips/DECK_R3: J902.3 (D3), J902.43 (W3)
/Edge strips/DECK_R4: J902.4 (D4), J902.44 (W4)
/Edge strips/DECK_R5: J902.5 (D5), J902.45 (W5)
/Edge strips/DECK_R6: J902.6 (D6), J902.46 (W6)
/Edge strips/DECK_R7: J902.7 (D7), J902.47 (W7)
/Edge strips/DECK_R8: J902.8 (D8), J902.48 (W8)
/Edge strips/DECK_R9: J902.9 (D9), J902.49 (W9)
/Edge strips/DECK_R17: J902.17 (D17), J902.57 (W17)
/Edge strips/DECK_R18: J902.18 (D18), J902.58 (W18)
/Edge strips/DECK_R19: J902.19 (D19), J902.59 (W19)
/Edge strips/DECK_R20: J902.20 (D20), J902.60 (W20)
/Edge strips/DECK_R21: J902.21 (D21), J902.61 (W21)
/Edge strips/DECK_R22: J902.22 (D22), J902.62 (W22)
/Edge strips/DECK_R23: J902.23 (D23), J902.63 (W23)
/Edge strips/DECK_R24: J902.24 (D24), J902.64 (W24)
/Edge strips/DECK_R25: J902.25 (D25), J902.65 (W25)
/Edge strips/DECK_R32: J902.32 (D32), J902.72 (W32)
/Edge strips/DECK_R33: J902.33 (D33), J902.73 (W33)
/Edge strips/DECK_R34: J902.34 (D34), J902.74 (W34)
/Edge strips/DECK_R35: J902.35 (D35), J902.75 (W35)
/Edge strips/DECK_R36: J902.36 (D36), J902.76 (W36)
/Edge strips/DECK_R37: J902.37 (D37), J902.77 (W37)
/Edge strips/DECK_R38: J902.38 (D38), J902.78 (W38)
/Edge strips/DECK_R39: J902.39 (D39), J902.79 (W39)
/Edge strips/DECK_R40: J902.40 (D40), J902.80 (W40)

Notes on the sheet:
EDGE STRIPS
Two n8synth-style edge strips, 40 positions each at 2.54 mm. Each position is an outer hole (the deck's header pin, Dn) joined to an inner hole (a wiring point, Wn) by the net DECK_Ln / DECK_Rn: one pin per hole. Nothing else on the board connects to them: each module is wired by hand from the chan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
Fiducials for JLCPCB assembly
Hardware licence: CC BY-SA 4.0 (LICENSE in hardware/analogue_board).

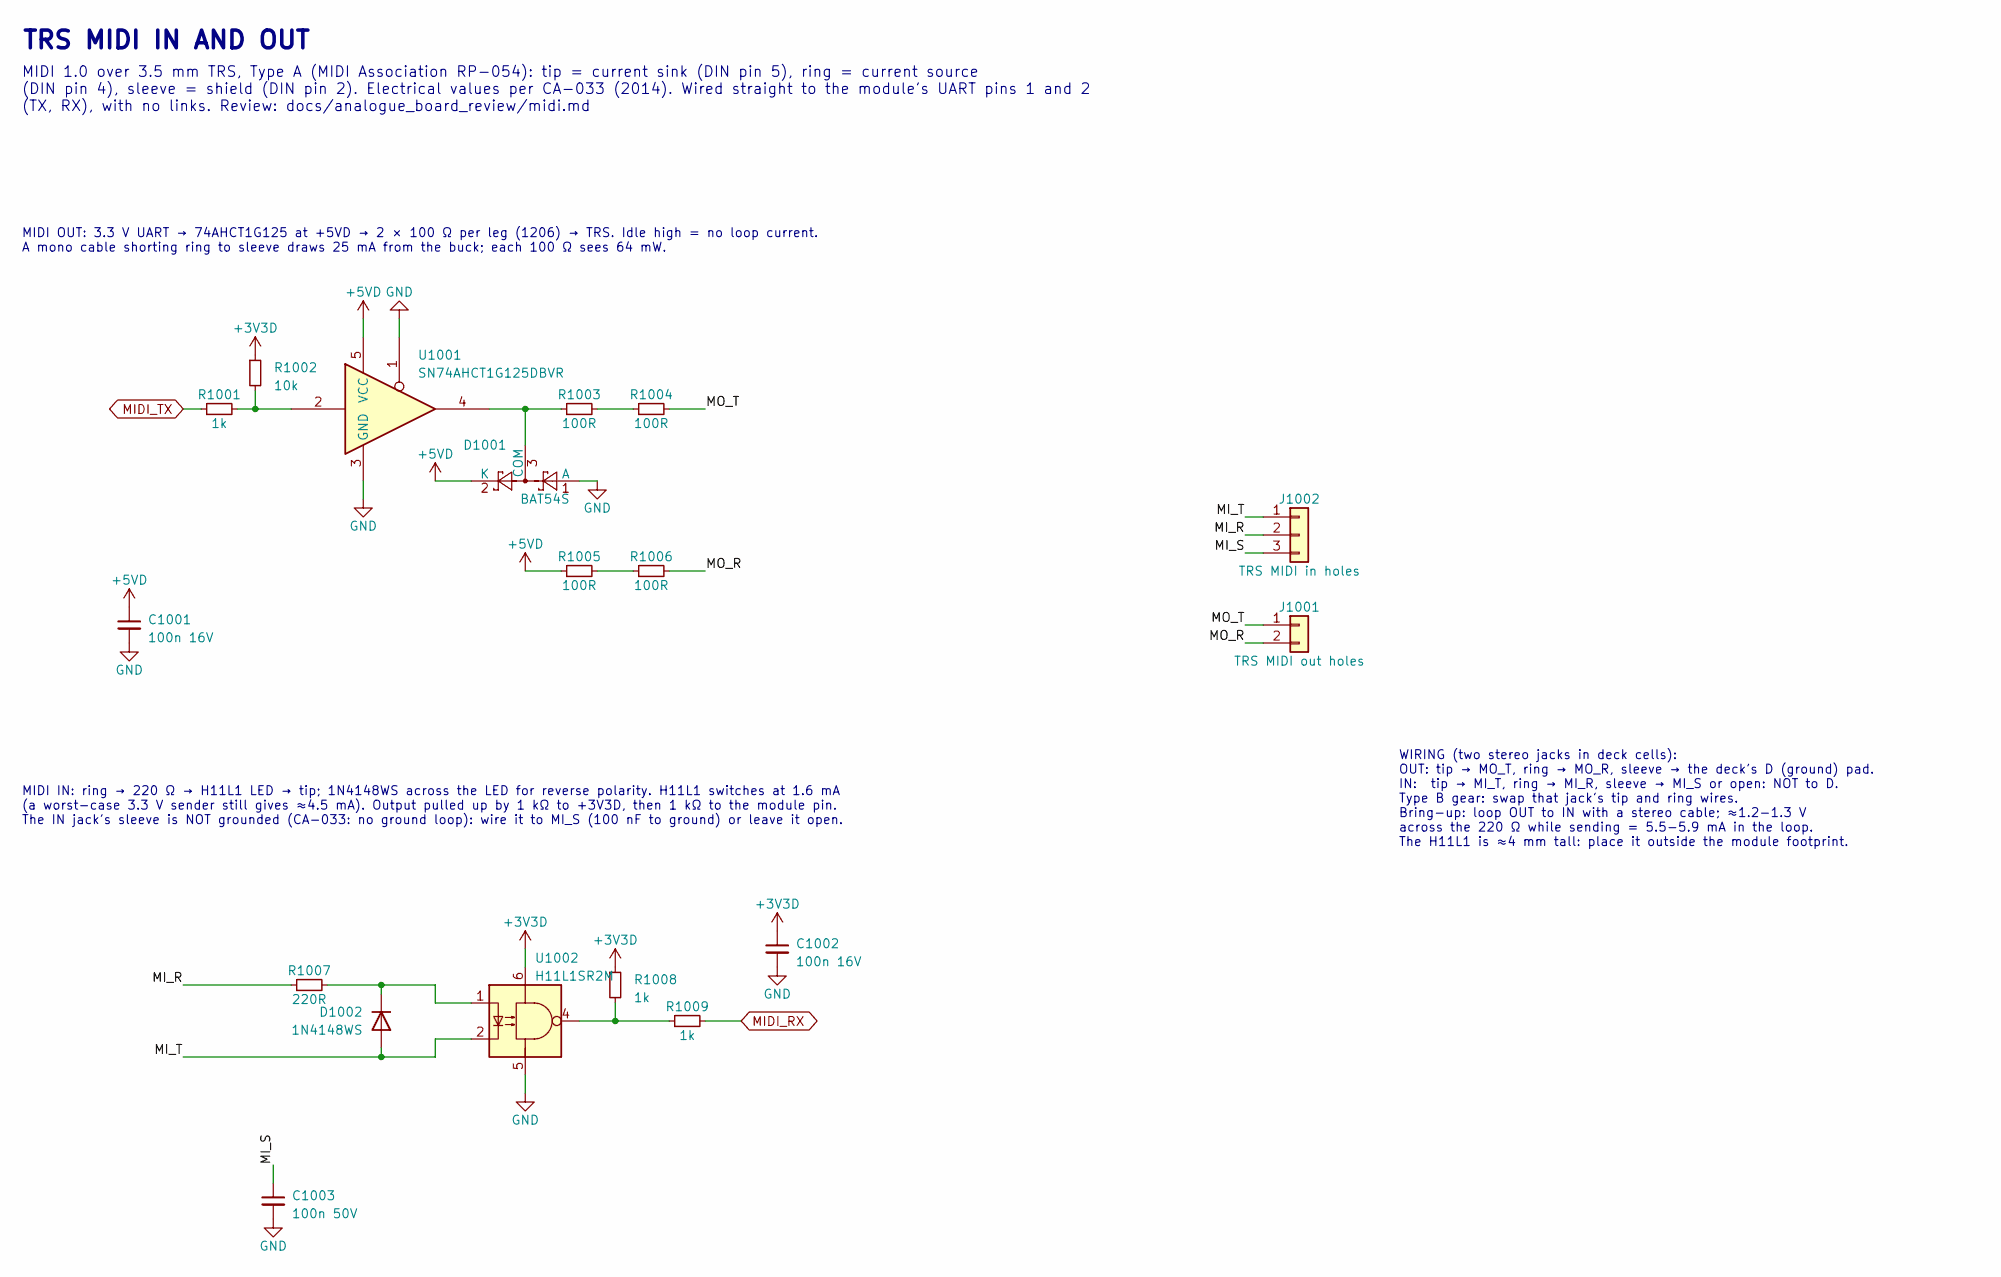
[picture p78: schematic midi.kicad_sch, TRS MIDI]

Parts:
C1001, C1002: 100n 16V; C_0402_1005Metric; Voltage 16V; LCSC C1525
C1003: 100n 50V; C_0603_1608Metric; Voltage 50V; LCSC C14663
D1001: BAT54S; SOT-23; MPN BAT54S; LCSC C408389
D1002: 1N4148WS; D_SOD-323; MPN 1N4148WS; LCSC C2128
J1001: TRS MIDI out holes; WiringHoles_1x02; JLC bare holes
J1002: TRS MIDI in holes; WiringHoles_1x03; JLC bare holes
R1001, R1008, R1009: 1k; R_0402_1005Metric; Tolerance 1%; LCSC C11702
R1002: 10k; R_0402_1005Metric; Tolerance 1%; LCSC C25744
R1003, R1004, R1005, R1006: 100R; R_1206_3216Metric; Tolerance 1%; LCSC C17901
R1007: 220R; R_0805_2012Metric; Tolerance 1%; LCSC C17557
U1001: SN74AHCT1G125DBVR; SOT-23-5; MPN SN74AHCT1G125DBVR; LCSC C7484
U1002: H11L1SR2M; SMDIP-6_W9.53mm; MPN H11L1SR2M; LCSC C20082

Connections:
+3V3D: C1002.1, R1002.1, R1008.1, U1002.6; also elsewhere on the board
+5VD: C1001.1, D1001.2 (K), R1005.1, U1001.5 (VCC); also elsewhere on the board
/TRS MIDI/MI_R: J1002.2, R1007.1
/TRS MIDI/MI_S: C1003.1, J1002.3
/TRS MIDI/MI_T: D1002.2 (A), J1002.1, U1002.2
/TRS MIDI/MO_R: J1001.2, R1006.2
/TRS MIDI/MO_T: J1001.1, R1004.2
GND: C1001.2, C1002.2, C1003.2, D1001.1 (A), U1001.1, U1001.3 (GND), U1002.5; also elsewhere on the board
MIDI_RX: R1009.2; also elsewhere on the board
MIDI_TX: R1001.1; also elsewhere on the board
unnamed: D1001.3 (COM), R1003.1, U1001.4
unnamed: D1002.1 (K), R1007.2, U1002.1
unnamed: R1001.2, R1002.2, U1001.2
unnamed: R1003.2, R1004.1
unnamed: R1005.2, R1006.1
unnamed: R1008.2, R1009.1, U1002.4

Notes on the sheet:
TRS MIDI IN AND OUT
MIDI 1.0 over 3.5 mm TRS, Type A (MIDI Association RP-054): tip = current sink (DIN pin 5), ring = current source (DIN pin 4), sleeve = shield (DIN pin 2). Electrical values per CA-033 (2014). Wired straight to the module's UART pins 1 and 2 (TX, RX), with no links. Review: docs/analogue_board_revi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
MIDI OUT: 3.3 V UART → 74AHCT1G125 at +5VD → 2 × 100 Ω per leg (1206) → TRS. Idle high = no loop current. A mono cable shorting ring to sleeve draws 25 mA from the buck; each 100 Ω sees 64 mW.
MIDI IN: ring → 220 Ω → H11L1 LED → tip; 1N4148WS across the LED for reverse polarity. H11L1 switches at 1.6 mA (a worst-case 3.3 V sender still gives ≈4.5 mA). Output pulled up by 1 kΩ to +3V3D, then 1 kΩ to the module pin. The IN jack's sleeve is NOT grounded (CA-033: no ground loop): wire it to 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
WIRING (two stereo jacks in deck cells): OUT: tip → MO_T, ring → MO_R, sleeve → the deck's D (ground) pad. IN: tip → MI_T, ring → MI_R, sleeve → MI_S or open: NOT to D. Type B gear: swap that jack's tip and ring wires. Bring-up: loop OUT to IN with a stereo cable; ≈1.2-1.3 V across the 220 Ω while 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

Board: 4 copper layers, 361 parts (177 on the bottom side), 249 nets, no tracks yet.
