Eight4aWish/eurorack_electronics/(commit log)

2026-04-15 Snare drum: complete layout with IC placement and component positions
    - 3x TL072 at rows 4-7, 15-18, 28-31 (all rotated 180deg)
    - 56 two-pin components + 7 transistors placed across 36 rows
    - 12 build stages with test points following signal flow
    - 11 jumper wires, 8 power wires, 16 JPS connections
    - 34 net labels for debugging
    - Challenges list for tricky routing (long spans, centre-gap crossings)
    - Registered in index.html visualizer
2026-04-17 FM Drum: two-board layout with alternating power/ground rails
    Netlist from PDF with 20 functional blocks, 2 ICs (TL074 + TL072),
    13 transistors. Board 1: both VCOs, waveshaper, pitch env. Board 2:
    gate-to-trigger, accent, decay, XOR gate, HPF, VCA, tune CV.
    Visualizer updated: single rail column per side with even=power,
    odd=GND pattern. Legacy aliases preserve kick/snare rendering.
2026-04-17 Fix FM drum rendering: normalize IC pin format + transistor fields
    drawICs() expected pins as array of objects (kick/snare format) but
    FM drum used compact format (pins as number + topRow). Added
    normalizeLayout() that generates pin arrays from compact format and
    swaps transistor type/subtype fields. Also robustified IC body bounds
    calculation and guarded against undefined pin.net.
2026-05-23 Add LPG schematic generator, visualizer tooling, and design docs
    - tools/schematic: build-phase schematic generator (Schemdraw) producing
    Phase 1/2 channel sheets + Phase 5 mix, driven by lpg.json values
    - tools/visualizer: netlist->layout, cross-check, validate, sync scripts + lpg layout
    - docs: LPG netlist (rev 0.19), BOM, breadboard placement, reference review,
    published-schematic comparison, and reference source material
    - .gitignore for macOS/Python clutter
    [lpg_bom.csv]
2026-06-16 Untrack docs/refs/ third-party material; link sources in README
    The DAFx 2013 paper, Doepfer manual, and community LPG schematics are
    copyrighted by their respective authors and shouldn't be redistributed
    from this repo. Keep the refs/ folder local-only (.gitignore) and point
    the README Credits section to each source's original home instead.
2026-07-14 Add n8synth board profiles from official templates; unify layout checks
    - tools/n8layout: add official 4HP / 10HP / 10HPS blank templates
    (joining the existing 6HP) as the source of truth for board geometry
    - gen_board_profiles.py: parse the templates into boards/*.json profiles —
    JPS control-deck cell inventory, breadboard-strip <-> deck connector maps
    (validated 54/54 against the LPG layout's control-hole endpoints),
    gap rows (free feed-through tie points), pads-per-cell, and the D
    ground bus with its grounding recipe. Builder-confirmed facts encoded:
    4HP/6HP have a single 40-pin strip on the LEFT (ctrlL) edge; stacking
    extra breadboards works on any deck size (boards usual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
2026-08-09 Add MOD2 breadboard build docs: reference review, netlist, design journal
    n8synth 6HP breadboard build of the HAGIWO MOD2 (CC0), specified as a
    dual-firmware-compatible board rather than a single-voice module.
    Key finding: the HAGIWO/modulove MOD2 firmwares and the WGD Modular Melon
    firmwares use identical pin assignments — verified by diffing matched pairs.
    The Melon sources are the MOD2 sources with the LED block swapped for an
    Adafruit_NeoPixel driver on GPIO5. GPIO5 is therefore the entire hardware
    delta, so populating both indicator types yields one board that runs ~30
    published voices with no firmware modification.
    Three departures from stock, each argued with numbers in the refere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
2026-08-09 Confirm XIAO RP2350 pinout from board silkscreen
    Resolves the highest-risk open item in the netlist. The physical pin order
    was previously assumed from the XIAO RP2040 convention and flagged as
    unverified; it is now read directly from the board.
    Numbering is DIP-style: right side pins 1-7 top to bottom, left side 8-14
    bottom to top. Viewed from above, component side, USB at top:
    left (top->bottom): VBUS, GND, 3V3, D10, D9, D8, D7
    right (top->bottom): D0, D1, D2, D3, D4, D5, D6
    This also corroborates the D<->GPIO mapping. The schematic uses exactly
    eight pins (A0, A1, A2, GPIO5, GPIO6, GPIO7, GPIO0, GPIO1) and marks GPIO2,
    GPIO3 and GPIO4 unused - which lands as the contiguous D0-D7 b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
2026-08-09 Lock panel layout and JPS-to-breadboard row mapping
    Resolves the last two unknowns blocking breadboard placement.
    Cell numbering is ROW-MAJOR - odd cells down the LEFT column, even down the
    RIGHT. Confirmed from the n8synth annotated control-deck diagram in the 6HP
    quick-start guide, and corroborated by the footprint x-coordinates in
    6HP_Template.n8layout alternating 0.71 / 17.22 mm. The 4-pin gap between
    JPS6 and JPS7 is a connector feature, not a column boundary - the
    column-major reading it suggested was wrong.
    All 40 breadboard rows are usable tie points, confirmed against the physical
    board. The profile's powerSectionRows [37,40] describes the board's power
    area, not a restriction on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
2026-08-09 Fix pot pin orientation and jack pad allocation after full-sheet audit
    Re-read the Rev A schematic in six overlapping zoomed regions rather than
    relying on the first pass, prompted by having missed JP2 earlier. Two real
    errors found.
    1. Pot pin orientation was backwards. The schematic shows RV1/RV2/RV3 with
    pin 3 to +3.3V and pin 1 to GND; the netlist had pin 1 as the 3.3V end.
    This inverts the direction of travel on all three knobs - every pot would
    have run backwards on the finished module. Corrected in the BOM wiring
    column and in Blocks 4 and 5, with a warning note.
    2. All four jacks have their switch contact unused. J2, J3, J4 and J6 all
    show TN marked with an X, so the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
2026-08-28 Correct tides finding, add voice coverage survey, generate MOD2 BOM
    Doc corrections
    ---------------
    Strikes the `tides` pin-map concern, which was wrong. tides uses Arduino
    D-aliases rather than raw GPIO numbers: PWMOUT D7 = GPIO1, TRIG_PIN D5 =
    GPIO7, MOD_PIN D6 = GPIO0, BUTTON_PIN D4 = GPIO6, LED_PIN D3 = GPIO5.
    Against the confirmed silkscreen pinout that is an exact match to the
    standard MOD2 map; the earlier concern conflated D-number with GPIO-number.
    Removed from the netlist open items, the reference review headline section
    and the design journal.
    Voice coverage survey (2026-08-27)
    ----------------------------------
    Listed both repos and diffed every .ino. 25 unique voices:
    MOD2 o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
    [mod2_bom.csv]
2026-08-28 Establish n8synth platform reference as ground truth; correct board profiles
    The row-count question was got wrong three times running by reasoning from
    template geometry. Root cause: the main area, the edge connector and the
    power rail are three DIFFERENT things with three different extents, and both
    the generated profiles and my earlier notes collapsed them into a single
    "rows" count.
    Adds docs/n8synth_platform.md, sourced from the builder describing the
    physical boards, as the single source of truth. Every claim carries its
    evidence; templates and generated profiles are explicitly downstream of it.
    Verified anatomy, working inward from either edge:
    1. Edge connector, positions 1-40. T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
2026-08-29 Record stacking signal path and edge-connector convention
    Closes the two items left unverified in the platform reference.
    Edge connector choice: 4HP and 6HP designs use ONE edge connector, by
    convention the left. Either edge works but never both. 10HP uses both.
    Stacking: signals DO pass between stacked boards, so passThroughConfirmed
    becomes true. But the dedicated stacking connectors are awkward to work
    with, and the method actually used is 1-to-6-way pin headers fitted to the
    INSIDE of the connector rails, jumping control deck -> board 1 -> board 2.
    This works because each edge-connector position is a doublet: the outer hole
    carries the deck connection while the inner hole stays free fo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
2026-08-29 Drop rail conditioning already provided by the n8synth board
    The powered n8synth board arrives with both +/-12V rails already
    conditioned: 100nF plus 10uF-or-larger on each. Any design transcribed from
    a standalone Eurorack PCB carries its own rail-entry conditioning, which is
    then duplicated.
    MOD2: removes C5 and C6, the stock 10uF rail bulk on +12V and -12V. Two
    electrolytics saved, and with them a chunk of breadboard space.
    Deliberately NOT removed, since each does a job the board does not:
    C7-C10 per-IC decoupling, one 100nF per TL072 per rail at the chip's
    own power pins. The board's single bypass at the power entry is
    not a substitute, and breadboard wiring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
    [mod2_bom.csv]
2026-08-29 Add public tool plan; flag LPG as-built reconciliation
    Plan for a third-party-usable version of the placement and visualisation
    tooling, with the dual LPG and the MOD2/Melon hybrid as the two flagship
    examples. They were picked to be licence-clean and to cover the platform
    between them: 10HP two-strip vs 6HP one-strip, analog vs mixed-signal,
    original design vs CC0.
    Records that the MKI x ES kick, snare and FM drum layouts must not ship.
    Moritz Klein and Erica Synths sell those as kits, and the 109-page manual
    carries no licence statement at all, so default all-rights-reserved applies
    (verified 2026-08-28; the Circuit Design Guide is a separate paid product).
    index.html currently hardcodes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
2026-08-29 Add edit_layout.py — hand-edit a layout to match the board
    Reconciling a documented layout against the board actually on the bench
    meant hand-editing JSON. This adds a text command language so a position
    read off a photo becomes one line.
    b10 > g12 move whichever endpoint sits at b10
    C15 = g12 g13 set a component's two ends
    C15.1 = g12 set one end
    mirror C15 C16 flip left<->right (a<->j ... e<->f, pwrL<->pwrR,
    ctrlL<->ctrlR)
    shift C15 +2 move a component's rows
    shift rows 12-20 +1 move every endpoint in a row range, twoPins and ICs
    IC DA3 = 15 set an IC's pin-1 row, all pins follow
    IC DA3 shift +1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
2026-08-29 Name the two holes of an edge-connector doublet
    Each edge-connector position has two holes joined to each other and to
    nothing else, and using both is normal - a wire from the panel in one, a
    component leg in the other. The layout schema addressed the position but not
    the hole, so which physical hole each occupant used was unrepresentable, as
    was "this doublet still has a spare".
    Convention added:
    ctrlLo5 / ctrlLi5 left edge connector, outer / inner hole
    ctrlRo5 / ctrlRi5 right edge connector
    ctrlL5 / ctrlR5 the position, hole unspecified (still valid)
    Outer means nearer the board edge and inner nearer the power rail, defined
    geometrically so they mean the same on either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
2026-08-29 Confirm doublet column roles; spare pairs carry no deck connection
    Builder-confirmed convention for the two holes of an edge-connector
    doublet:
    OUTER control deck -> first circuit board (the main deck connection)
    INNER smaller headers jumping to a second circuit board stacked over
    the first
    So on a single-board module the inner column is free, which is the spare
    capacity behind the repurposing technique. This is the opposite of what I
    had inferred from the stacking remark - recorded as fact rather than
    inference.
    Second and more consequential: a spare doublet has NO deck connection.
    Only positions where a JPS cell terminates are wired to the control deck.
    Every other positi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
2026-08-29 Draw the board as it actually is: doublet connectors, main area ends at 36
    The visualiser predated the corrected platform model and rendered three
    things wrong, all from the same collapse fixed earlier in the data model.
    1. Edge connectors were drawn as a SINGLE column each side. They are
    doublets - two joined holes per position. Now drawn as a pair per side
    (ctrlLo/ctrlLi, ctrlRi/ctrlRo) with a hairline joining each pair to show
    they are one node, and small out/in column headers.
    2. Main-area holes were drawn for rows 1-40. A powered board has main-area
    rows 1-36 only; holes past 36 do not exist. Now drawn to MAIN_ROWS, with
    row numbers still running to 40 (dimmed past 36)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
2026-08-29 Fix row-number overlap; replace palette with a validated accessible set
    Two fixes to the visualiser, both reported from looking at it.
    Overlap: row numbers sat at x=4 while the outer control column was at x=16,
    so two-digit numbers ran into the holes. All columns shifted right by 18px
    and the SVG widened 452 -> 476, giving 17px clearance on the left and 19px
    on the right.
    Colour: the original palette was measured rather than judged, using the
    dataviz validator, and failed four of five checks.
    Lightness band 3 of 8 outside
    Chroma floor 2 read as grey (#c4956a, #666666)
    CVD separation worst adjacent pair dE 5.1 protan
    Normal-vision floor worst pair dE 11.9, below th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
2026-08-29 Add light mode as a selected palette, not a flip of dark
    Light is stepped for a light surface and validated on its own, per the rule
    that dark/light are each selected rather than one being derived from the
    other. Both were run against the surface actually used:
    dark --surface #242426 all five checks PASS
    light --surface #e4e4de PASS, with a contrast WARN on orange, aqua,
    yellow and magenta (1.7-2.5:1)
    That WARN is not dismissable - it carries a relief obligation. So whenever
    light mode is on, component labels are forced visible and the Values toggle
    is disabled, which stops the relief being switched off while the low-contrast
    hues are showing. Dark mode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
2026-08-29 Theme every colour; restore per-type component hues
    Three reports in a row - illegible test text, an unreadable sidebar, pale
    yellow net labels on white - all had one cause: colour was scattered as
    hardcoded hex across the CSS and the drawing functions, so each fix only
    covered what I happened to look at. This does the sweep.
    Zero hardcoded hex now remains in the CSS or in the drawing code. Every
    colour resolves through a named theme role, so there is one place to change
    and no way to half-theme a render.
    Measured, not judged. In light mode the sidebar was not merely dim:
    test-point 1.08:1
    stage name 1.01:1
    h3 heading 1.31:1
    parts list 1.73:1
    All text roles now clear WCAG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
2026-08-29 Fix load-time crash that emptied the layout picker; add a smoke test
    A blanket find-and-replace while theming the drawing code also rewrote the
    PALETTES definition itself, producing rBody:TH.rBody - a self-reference
    evaluated before TH exists. That threw a ReferenceError at load, which killed
    the entire first script block, so registerLayout was never defined and none
    of the built-in layouts registered. The picker came up empty with no visible
    error.
    Neither node --check nor the div-balance check caught it: the syntax was
    valid and the HTML was well-formed. It only fails at execution.
    So this also adds smoke_test.py, which assembles the page's inline scripts
    and its layout .js files against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
2026-08-29 One standard for every net label
    Reported: net names sat sometimes on the row, sometimes below it, sometimes
    half and half, with the font varying too.
    The cause was that net names are drawn in two places that had drifted apart:
    drawNetLabels row labels 6.5px, centred on the row
    drawICs IC pin nets 5.5px, centred on the row, different colour
    Both now use one standard, defined once as NET_LABEL_SIZE and NET_LABEL_DY so
    the two call sites cannot drift again:
    - one colour for all net labels (TH.netInk)
    - one size
    - always BELOW the row, never centred on it
    - full opacity for the current stage rather than 0.7, so they are not
    competing with earlier-stage parts f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
2026-08-29 Remove jumper wire labels
    They added text density without carrying much: a dashed line between two
    holes already reads as a jumper on sight, and the id and label are still on
    the hover tooltip, which makeCG() attaches as data attributes.
    The jumpInk palette role is removed with them rather than left as dead
    config.
2026-08-29 De-duplicate net labels and clear them of the row bars
    Two separate causes of repeated labels, both in the data rather than the
    drawing:
    1. Net names were drawn twice on 17 rows - once by drawNetLabels from
    layout.netLabels and once by drawICs as an IC pin net, same name, same
    row, same side. drawICs now skips a pin net that a row label already
    shows: 48 IC pin labels drop to 31.
    2. Two rows carry two different names on the same side (row 5 L has
    LED_DRIVE_A and V_p_A, row 23 L has the B pair). A row half is a single
    electrical node, so those are aliases for one node - and they were being
    drawn at identical coordinates, exactly on top of each other. Row labels
    are now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
2026-08-29 Start row net labels outside the part they sit on; shorten the zener label
    Net labels were inconsistent about parts: an IC's own pin labels sit at
    pinX -/+ 22, which clears the body (drawn from pinX -/+ 8), so
    V_OUT_A_PRE_BUF at left 1 started outside DA1. But row labels from
    layout.netLabels always hugged the gap at colX('e')+4, which is INSIDE that
    same body - so CHA_OUT at left 3 ran underneath the IC.
    Row labels now hug the gap by default and, where a part covers the row, start
    outside it instead, using the same 14px clearance the pin labels get. The
    span map covers ICs and SIP sockets alike, so vactrol positions get it too.
    CHA_OUT row 3 L was under DA1 now ends x=190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
2026-08-29 Fix two mislabelled net labels; add a check so it cannot recur
    The doubled name was not cosmetic and not a circuit error - it was two net
    labels transcribed onto the wrong row.
    Row 5 left is one electrical node carrying R3 (4M7 Rα to GND), C13, R5 and
    vactrol A pin 1, whose IC-pin net is V_p_A. That node is correct. But a
    second label there claimed LED_DRIVE_A, and LED_DRIVE_A's actual components
    - R6 470R ending at b7 and VD5 zener at c7 - sit on row SEVEN. Row 7 had no
    label at all. Channel B is the same slip mirrored: LED_DRIVE_B labelled on
    row 23 while R12 and VD6 sit on row 25.
    Both moved (5->7, 23->25); layout is now rev 0.21. Components were never
    wrong, so no rewiring is implied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
2026-08-29 Draw the notch at the pin-1 end, so flipped SIPs differ from unflipped
    Reported: the 4-pin SIP and its flipped pair showed the half-moon notch at
    the same end, which cannot be right if one is installed the other way round.
    The pin data was already correct - VC_A_L runs pin 1 at the top (r5) through
    pin 4 at r8, and VC_A_R runs pin 4 at r5 down to pin 1 at r8. But the notch
    was drawn from a separate `rotation` field, and both vactrol sockets carried
    rotation 0, so both got a top notch. The drawing disagreed with the pinout it
    was drawn from.
    The notch marks the pin-1 end - that is how all four TL072s already behave
    (rotation 180, pin 1 at the bottom, notch at the bottom). It is now DERIVED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
2026-08-29 Put the notch on the body edge, curving into the part
    Two faults in one mark, both visible on the flipped SIPs.
    The arc always used sweep-flag 1, which in SVG's y-down coordinates draws
    through the TOP - so it bulged upward regardless of which end it was on. And
    the bottom-end notch was positioned at endY+P/2-6, four pixels inside the
    body rather than on its edge. Together that gave a dome floating inside the
    part instead of an indent cut into its end.
    Now the notch sits exactly on the body edge at the pin-1 end, and the sweep
    flag is chosen so the curve always goes INTO the body: 0 for a top-edge
    notch (arcs through the bottom), 1 for a bottom-edge notch (arcs through the
    top). Unflipped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
2026-08-29 Stop publishing a licence analysis of third-party kit designs
    The plan doc set out, in public, that the third-party manual carries no
    licence statement and that default all-rights-reserved therefore applies,
    naming the parties and a paid product. That is a written record of knowing we
    have no rights, sitting in the same repo as transcribed material from those
    designs - which makes the position worse, not better.
    The exclusion decision is what the plan needs to carry, not the reasoning
    behind it. Reduced to: these are someone else's commercial product, they are
    not ours to redistribute, and index.html hardcodes them so removal has to be
    an explicit step.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
2026-08-30 Catch a net named on both row halves with nothing bridging the gap
    The left and right halves of a row are separate nodes. If both carry the SAME
    net name, something must cross the centre gap - a jumper, a component, or an
    IC straddling it. If nothing does, they are two isolated nodes pretending to
    be one node: an open circuit that reads as correctly wired in both the
    diagram and the netlist.
    Nothing detected that. cross_check_nets validates component endpoints against
    EXPECTED_NETS, so a net split into two disconnected halves still matches on
    both. The net labels agree with each other. Only the missing bridge gives it
    away, and nothing was looking.
    validate_layout now flags it. The dual LP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
2026-08-30 Show where the 6 ten-pin headers land, and which positions are spare
    The board-to-deck connection is six 10-pin headers, three per edge. Each
    spans ten positions but only nine carry JPS pads (three cells at three pads
    each), so every header has one spare pin. Nothing in the diagram showed any
    of this, so it was not possible to see which edge positions were available
    for landing a component and routing under the board.
    Now drawn: a header footprint on the OUTER lane for each span, and a marker
    on every position that carries no JPS pad, distinguishing the two kinds of
    spare because they are not equivalent.
    dashed ring inside a header - the outer hole holds an unused header pin,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
2026-08-30 Route R6 and R32 via spare edge positions; distinguish back-of-board wires
    Worked example of using the spare edge positions as routing tie points, and
    of the doublet doing two jobs at one pad - the wire in one hole, the
    component leg in the other.
    R6 an above-board wire runs b8 -> 11R OUTER; R6 itself then spans
    11R INNER -> 5R INNER (DEPTH_WIPER_A)
    R32 jumps to 15R OUTER; a wire on the BACK of the board connects
    15R INNER -> 5L INNER (MAN_WIPER_A)
    Both use positions outside any header, where both holes are free - 11 and 15
    are in the 11-16 gap. Neither disturbs a JPS pad.
    Jumpers gain a `side` field. A wire on the back is drawn finer, fainter and
    with a tight dash so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
2026-08-30 Put the under-board wire in phase 1; catch wires scheduled after both ends
    JW_R32_MAN_A was stage 2 while R32 and the MANUAL A wiper it joins are both
    stage 1, so phase 1 drew two live ends with nothing between them. I picked
    the stage with no reason to; it should have followed the parts it connects.
    Fixed, and added a validator check for the general case: a wire whose stage
    is later than both nodes it joins. That phase reads as complete while the
    circuit is open, so its bench test cannot pass and there is nothing on screen
    to say why.
    The check resolves control-lane columns to their lane, so a wire landing on
    an inner hole is compared against whatever else shares that pad. Verified
    both w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
2026-08-30 Route R_STATUS_A via spare position 13
    R_STATUS_A now runs h17 -> 13R OUTER, with an under-board wire from 13R INNER
    to the Status LED A cathode at 8L INNER. Same pattern as R32: the component
    leg in one hole of the doublet, the routing wire in the other, one pad.
    The wire is stage 2 to match R_STATUS_A and the LED connection it reaches -
    the check added in the previous commit would have caught it otherwise.
    Spare edge positions now in use: 11 (R6), 13 (R_STATUS_A), 15 (R32) - all in
    the 11-16 gap outside any header, with 12, 14 and 16 still free between them.
    cross_check_nets gains (13,'ctrlR') = LED_STATUS_A. Third hand-added entry
    from this routing work, each an assertion about intent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
2026-08-30 Channel B: vactrol up a row, C16 block across, diode jumps the gap
    Mirrors the channel A rework.
    vactrols rows 23-26 -> 22-25, opening a gap at row 26 before DA2.
    Dragged along: R9, C14, R11 to row 22; R10 to h22; R12 and
    VD6 to row 24; C12 to b25; both gap jumpers; five net labels.
    CV_PROT_B 20R -> 21R (R19 h21, R22 j21) to clear room for C16
    C16 block C16 g20-g18, R25 h20, R31 h18
    VD2 jumps the centre gap on row 18, f18 <-> e18, which keeps
    STRIKE_PULSE_B on the LEFT half where R35 already reaches it
    at d18 - so 19R is not needed at all
    R31 grounds at pwrR19 rather than reaching across to pwr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
2026-08-30 Row 26 left becomes a local ground, mirroring row 10
    VD6 now sits in its socket at c24-c26 with its cathode on a local ground row,
    exactly as VD5 does at c8-c10 on channel A. Row 26 left is fed from b26 to
    pwrL27, mirroring the b10 -> pwrL9 feed on channel A.
    Same reason as before: local returns rather than stretching to a distant
    point on the rail. Both channels now have the same arrangement - vactrol
    block, then a ground row immediately below it carrying the zener.
    cross_check_nets gains (26,'L') = GND alongside the existing (10,'L').
2026-08-30 Audit the left-hand gap positions; rework the mix output
    Walked the left edge-connector gap positions one by one and implemented what
    each carries. Each holds a component in one hole of the doublet and its
    routing wire in the other, both on the same pad.
    10, 12, 16, 26-29 spare
    11 JW_CHA_OUT_BUS front to inner; JW_CHA_OUT_X back from outer to 28R
    inner, leaving 28R OUTER for R23. CHA_OUT now runs 11L -> 28R rather
    than down the left half to row 31.
    13 R39 inner; back wire outer -> 33R inner (CV ATTEN B wiper)
    14 R_STATUS_B inner; back wire outer -> 33L inner (Status LED B K)
    15 short front wire from b15 to inner; long back wire outer -> 30R OUTER;
    R33 then r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
2026-08-30 Correct header positions to 16-25; audit the right-hand gap positions
    The centre header on this board is at 16-25, not 17-26. That shifts which
    positions are spare and, more importantly, which are USABLE.
    Each header leaves one unused pin - now 10, 16 and 31. Those are not
    available for routing: the header pin physically occupies the hole, and
    freeing it means trimming the header, which is fiddly and was not done here.
    The drawing no longer offers them as routing candidates; only positions
    outside every header are marked, and those have both holes free:
    usable 11-15 and 26-30
    blocked 10, 16, 31
    Right-hand assignments, completing the audit:
    11 R6 inner, front wire outer
    12 R1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
2026-08-30 R17 runs from row 13; route R25 via spare 26R
    R17 is the resistor that runs from row 13, with the wire completing the
    journey - I had it the other way round. R17 is now h13 -> 12R and
    JW_R17_IN carries CHA_STRIKE from 12R to the pad at 20R underneath, so
    position 12 holds CHA_STRIKE rather than C15_a.
    R25 was the last component still crossing the board, 15 rows from ctrlLi35 to
    h20. It now runs h20 -> 26R with JW_R25_STRB completing to ctrlLi35 under the
    board, so position 26R carries CHB_STRIKE.
    With that, nothing crosses the board except VD2, which does so deliberately -
    it jumps the centre gap on row 18 and spans no rows at all. No component
    reaches across for a rail, and nothing sits o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
2026-08-30 Stop restating placement by hand in the LPG doc
    Positions were living in three places: the generated row maps, a hand-written
    ASCII layer in the placement doc, and the stage descriptions rendered in the
    visualiser's side panel. Only the generated maps were current. The other two
    still described the rev-0.17 board, so the tool was showing correct geometry
    next to a caption naming the wrong rows.
    Removed from the doc (~84 lines): the channel socket arrangement ASCII and
    its row-by-row table, the centre-gap bridge row numbers, and the entire Phase
    1 build checklist, which named specific rows and columns for nearly every
    part and was stale in almost all of them.
    Removed from lpg.json: position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
2026-08-30 Cross-check hand-written doc positions against the layout
    The off-board interconnect tables name 31 control positions by hand. They are
    worth keeping as prose - they carry pot leg conventions, LED polarity and
    rheostat wiring that no JSON records - but naming positions makes them a
    second source for something the layout already holds, and that is what has
    drifted repeatedly.
    Rather than generate them and lose the context, check.sh now verifies them:
    every control position the doc names must exist in the layout. Positions
    inside the GEN:MAPS block are skipped, being generated already.
    All 31 currently agree. Verified the check bites: altering one to a position
    the layout does not have fails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
2026-08-30 Capture what the LPG reconciliation taught the tooling
    Extends the design journal with part two: reconciling lpg.json against the
    built board, and the tooling changes that came out of it. Retitled, since it
    no longer covers only MOD2.
    The substance is one pattern seen six times - a fact stated in two places
    with nothing forcing them to agree, and one copy going stale:
    which net a node carries netLabels vs IC pin net
    the layout layouts/*.json vs the .js wrapper
    which end pin 1 is rotation field vs the pins themselves
    component placement generated maps vs hand-written ASCII
    build-phase content stage.desc vs the placeme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
2026-08-30 Add the last two validator checks; record the GC decision
    Two defect classes that were found by eye during the LPG rework and never
    codified. Both currently have zero violations, so these lock in a clean state
    rather than fixing anything.
    reaching across for a rail A right-half part grounding on pwrL passes
    every net check - both rails carry GND - while
    being a needlessly long wire. R15 and R31 both
    did this. VCC is exempted: it exists only on
    pwrL even rows, so a right-half part needing it
    has no choice, which is why R30 is not flagg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
2026-08-30 Name the tool-plan items instead of coding them
    The plan used invented labels - B1, B2a, B4 and so on - and I then referred to
    them in conversation as though they were shared vocabulary. They were not: they
    carried no meaning to anyone who had not just read the list, which made the
    status of the work harder to follow rather than easier.
    Each item is now named by what it actually is:
    the answer key is typed by hand
    the browser copy of a layout goes stale without warning
    adding a module means editing the app's own HTML
    board profiles exist but almost nothing reads them
    the layout format predates the corrected platform model
    no install instructions and no getting-started guide
    t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
2026-08-30 Record the three-input design for the tool
    Working through the LPG rework settled what the tool actually needs, and it is
    simpler than the structured circuit file I proposed - that was over-
    engineering.
    Three inputs: the netlist, the front panel layout, and the board rules.
    Everything else is derived.
    The netlist docs already state component-to-nets directly, so EXPECTED_NETS
    is a hand transcription of something already written down. What the parser
    needs is a spec and two validity rules: every component must have both
    terminals on a named net, and nothing may be silently dropped. The current
    parser fails the second badly - it lost all five MOD2 jacks, LED1 and every
    connection while repo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
2026-09-05 Ignore private/, where the reference repo now lives
    eurorack_electronics_private has been cloned in at private/ rather than sitting
    as a sibling. It holds the third-party material this repo deliberately links
    rather than redistributes — published schematics, the MKI x ES derivations, the
    board photos — and having it inside means the tools and the material they refer
    to are one tree and one workspace folder.
    Ignored, so it cannot reach the public side by accident, including via a
    `git add -A`.
2026-09-18 Point Claude at the module inventory from this repo The list existed but nothing pointed at it, so a session opening in any repo never saw it. CLAUDE.md is the mechanism that loads context automatica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
    Each CLAUDE.md says what its repo is and points at one canonical inventory, so
    there is a single copy to keep current rather than nine that drift.
    Claude-Session: https://claude.ai/code/session_014vBeddB9HPQe68snsvq7pq
2026-09-24 Let sessions started in the daisy repo work here too
    additionalDirectories points at eurorack_daisy_patch_init, whose settings
    point back here. The LPG spans both: the circuit and layout live here, the
    neural capture that models it lives there, and a session in one kept having
    to stop at the boundary. Relative paths, so it holds on either Mac.
2026-09-24 Re-range DEPTH and MANUAL, which barely used their travel
    In use almost none of either control's rotation does anything audible.
    Working from the netlist, the two have different causes.
    DEPTH is taper orientation. Shorting CCW to the wiper and feeding CW puts
    the c-to-b track in circuit, and on an A taper that track sits near full
    resistance for most of the rotation, so the whole audible LED-current span
    (about 7.7mA down to 0.1mA, roughly 0.5K to 72K in series with R6) lands in
    the first few percent of travel from full CW. Shorting CW instead and
    feeding CCW puts the log track itself in circuit. It reverses the knob -
    unavoidably, since travel and direction are set by the same choice of
    sh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
2026-10-14 Analogue board spec v0.2, checked against datasheets and JLC stock
    Takes the cloud session's Rev A handoff and checks it: every part against
    its datasheet and live JLCPCB stock, an I/O audit of the existing modules,
    the deck interface from David's answers, and layout lessons from the
    patch.init carrier, Ogham and reDIP-SID boards. DG411 and 74HCT595 are in
    stock after all; the DAC settles on a DAC8568 grade A on a 3.3 V rail; one
    board outline serves 10HP (parallel) and 6HP (at 90 degrees).
2026-10-14 Analogue board spec: Workshop Computer and EuroPi review, layout rules
    Adds a function-by-function comparison of the Workshop System Computer,
    EuroPi, Patch SM and Ogham against this board's choices (CV in and out,
    gates, pots, buttons, LEDs, jack detect, calibration, power), with what
    was not adopted and why. Five more layout rules from the reference boards.
2026-10-14 Analogue board spec: module on headers over the logic, all on one face
    David confirms the modules sit on headers, so low-profile SMT can go
    under them. SMT, module, power header and wiring now share the outward
    face (n8synth mounts components outward); the deck face carries only
    the deck's header pins.
2026-10-14 Analogue board spec: David's decisions, DAC comparison, licence survey
    Records the answers: one breadboard for 6HP and 10HP (6HP connects only
    the left 40), EYESPI dropped, four gate ins, Pico 2 and Teensy 4.1 only,
    no TRS MIDI (its pins become spare GPIO). Adds a DAC8568 vs MCP4822
    comparison against what O&C, Performer, Marbles, the Workshop Computer
    and others use (from their firmware drivers), and a survey of the
    hardware licences comparable open projects chose.
2026-10-14 Analogue board spec: DAC8568 and CC BY-SA 4.0 decided
2026-10-14 Analogue board spec: board geometry, JLCPCB costs, 2x5 power header
    Takes the board geometry from the n8synth web tool's vector (outline,
    both edge strips, mounting holes, power-header position). Records
    David's wiring method (channel holes beside their circuits, tinned both
    faces) and the 2x5 header with no bus +5 V. Adds JLCPCB's current
    Economic PCBA rules and fees: 4-layer accepted, 2-50 assembled, and
    $3.07 per Extended part type (v0.1's $1.50 was the Standard figure).
2026-10-14 Analogue board spec: no mounting holes, 3.3 V logic rule for the modules
    Nothing stacks on this board, so the breadboard's centre-line mounting
    holes and the stacking pads go. Records both modules' logic levels from
    their datasheets (Pico 2: 3.3 V, 5 V-tolerant while powered; Teensy 4.1:
    3.3 V, not 5 V-tolerant) and the rule that every signal into the module
    is 3.3 V.
2026-10-14 Analogue board spec: gate inputs follow Ogham's comparator input
    David's question about 3.3 V gates: a 74HC14's switching point at 3.3 V
    is loosely specified (~1.2-2.3 V), leaving about 0.5 V of margin. Ogham's
    clock input sets the threshold instead: 10k series, BAT54S clamps, an
    LM393 against 1.65 V with hysteresis, open-collector output pulled up to
    3.3 V. Trips at ~1.8 V at the jack. Two LM393s are JLC Basic parts.
2026-10-14 Analogue board: toolchain and checkpoints to the JLCPCB order
    Ignore the PCB tooling virtualenv. The spec records the installed
    toolchain (KiCad 9 + JLC plugin, Freerouting 2.5 on Java 21, kiutils,
    easyeda2kicad) and the five checkpoints from schematic to order.
2026-10-14 Analogue board: checkpoint 1 schematic, generated and checked
    Nine A3 sheets in a KiCad 9 project under hardware/analogue_board,
    generated by tools/analogue_board/build.py: sheet 1 is the Pico 2 /
    Teensy 4.1 pin map, then power, codec and audio, CV jacks and ADC, CV
    DAC, pots and gate outs, expander/I2C/LEDs, gate ins and jack detect,
    edge strips. 300 placed parts, every one with an LCSC number except the
    hand-soldered modules and power header; 14 Extended part types.
    The build runs KiCad's ERC (0 errors, 0 warnings) and its own checks,
    written to output/checks.md:
    - the netlist KiCad computes against the generator's intended pin-to-net
    map, so shorts, missed pins and stray connections fa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
2026-10-14 Analogue board spec v0.3: schematic decisions, USB placement, ESP32-P4
    New section 15 records what the schematic decided, marked [proposed]:
    - a TPS54308 forced-PWM buck in place of the TPS54202 / AP63205, which
    both pulse-skip at light load into the audio band;
    - XC6206 LDOs in place of AMS1117s, which need a 22 uF tantalum that
    JLC has no Basic part for;
    - the LM393s on +12 V, so the clamped inputs stay in common-mode range;
    - 4.7 kOhm switch-enable pull-downs to beat the TCA9555's pull-ups;
    - the LM4040 dropped;
    - the CV offset taken from the DAC8568's own reference;
    - pull-ups on the converter chip-selects.
    USB: module USB ends now point toward the board centre, as on commercial
    boa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
2026-10-15 Analogue board: block review applied, TRS MIDI, ESP32-P4 support
    Checkpoint 1 schematic rebuilt after a block-by-block prior-art review
    (docs/analogue_board_review/, seven reports and an index).
    Schematic:
    - Codec: 20 Vpp in and out (15k input feedback; balanced MFB output,
    gain 2.5, 1 nF C0G); ferrite and 5.1 ohm on the codec supplies; VCOM
    decoupled at each input; CODEC_RST to a hole.
    - Power: 680 ohm minimum load on +3V3D; buck input ferrite and EN
    divider; SS34 at D201-D203; Q201/JP201 MOD_5V bypass for the ESP32-P4.
    - CV in: 15 V TVS at each jack, 1 nF at each ADC input, 1206 outputs.
    - CV out: 12k/22k offset with 1 nF, 33k gain; CV7-8 feedback from the
    jack side of the 1k.
    - G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
2026-10-15 Analogue board: checkpoint 2 printout
    A 1:1 A4 printout to lay real parts on, generated from the KiCad
    footprints by tools/analogue_board/printout.py (no dependencies).
    - Page 1: outline, edge strips with deck cells, Pico 2, ESP32-P4 and
    Teensy 4.1 sockets and bodies, USB plug keep-outs, J201, checklist.
    - Page 2: one module per outline.
    - Page 3: the shared-holes arrangement for comparison; 7 of its 17
    shared holes would join different nets in today's netlist.
    placement.py holds the proposed positions: Pico socket 17.4 mm down so
    an ESP32-P4 ends at the top margin; J201 bottom right, clear of every
    USB keep-out. Scale verified at 1:1 on a 254 dpi render.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
2026-10-15 Analogue board: checkpoint 2 passed; Teensy 3 mm down for its SD card
    David laid the real parts on the printout: every measurement agrees.
    A card in the Teensy's microSD socket stands just under 3 mm past its
    far end, about 2.5 mm past the board edge, so the Teensy socket moves
    3 mm down (far end 3.5 mm from the top; keep-out to 94.5 mm, clear of
    J201). Printout regenerated with the card drawn; spec records the result.
2026-10-15 Analogue board: checkpoint 3 started; double-sided, floorplan placed
    - pcb.py generates analogue_board.kicad_pcb from the netlist: outline,
    JLC 4-layer stack-up, every footprint with nets and schematic links
    (KiCad schematic parity: 0 differences), parked parts beside the board,
    courtyard area budget, DRC and 3D renders of both faces.
    - Area budget: the courtyards need 104% of one face before routing, so
    David chose double-sided assembly (JLC Standard PCBA, about $100 more
    per order, to confirm on a quote).
    - Floorplan in placement.py: analogue ICs at the top under the modules,
    furthest from the buck; logic below; power bottom right around J201;
    MIDI bottom left; 99 wiring-fiel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
2026-10-15 Analogue board: first-pass placement; space reclaimed; four wiring banks
    - autoplace.py places every unanchored part as close as it fits to the
    pins it connects to: decoupling capacitors at their pin, chains growing
    from their ICs, the buck's loop kept on one face. All 430 parts placed;
    DRC courtyards clean, schematic parity clean, heights checked (<= 2.5 mm
    under the modules, <= 8 mm in the USB keep-outs).
    - Space reclaimed (David): Teensy socket without holes for its unused
    far-end pins 20-28 (headers 1x19 + 1x20); right strip (10HP only) without
    holes at 11-15 and 26-30, and outer hole only at 10, 16, 31. checks.py
    lets a project footprint omit only pins the netlist leaves u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
2026-10-15 Analogue board: bus chips level with their module pins; design rules; trial autoroute
    Re-floorplan the centre channel in the order of the module's buses (SPI-A,
    SPI-B, I2S, I2C), so the codec is 6 mm from the Pico's I2S pins instead of
    38 mm; CV output op-amps move to the top-right corner.
    Net classes (0.15/0.15 default, 0.3 power) and an In1 ground plane are
    written into the project. autoroute.py runs Freerouting on a copy of the
    board to measure routability. Schematic hole groups no longer overlap.
2026-10-16 Analogue board: two boards, trims, and a two-stage route that works
    Rev A becomes two boards from one generator (variant.py): one for the
    Pico 2 / ESP32-P4 and one for the Teensy 4.1, with all 48 Teensy holes.
    Each board has its own floorplan. Trims: four gate outs and no jack
    detect. Every part now matches pin for pin (edge strips, Qwiic, DPAK);
    square holes mean ground. Placement PDFs, a per-board printout, and a
    Quilter export.
    Routing trials (spec section 14): Freerouting stalled on every board
    until its fan-out stage was switched off. pico_core (six switchable CV
    jacks, six pots, no MIDI or Qwiic, 0.4 mm spacing, 0.127 mm rules) then
    routed every signal in two stages, signals first and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
2026-10-16 Analogue board: one board for both modules routes every signal
    shared_core is both module sockets (the Teensy on full-length headers),
    TRS MIDI, the display on I2C holes, six switchable CV jacks, six pots and
    four gates each way: 372 parts. It is placed 0.4 mm apart with 0.127 mm
    signal rules and routed in three stages (autoroute.py --staged). That
    leaves no signals, 7 +5VD and 29 ground connections. Rails are at
    0.3 mm, with the power entry beside J201. The routed board is in
    shared_core/routed_trial.
    The auto-placer now falls back to tight spacing, then to the nearest
    free spot on the board, for parts with no room near their target.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
2026-10-16 Analogue board: the Teensy core board routes completely
    teensy_core_midi (Teensy 4.1 alone, the shared core feature set with TRS MIDI) routes with no
    unconnected item and no copper fault in KiCad's DRC. Its routed board is kept in
    teensy_core_midi/routed_trial/.
    The route is scripted end to end:
    - autoroute.py --ground-vias gives every surface-mount ground pad its own via to the plane
    before routing (Freerouting alone joined 207 ground pads through 38 vias and 567 mm of track)
    - autoroute.py --decoupling wires each decoupling capacitor to the pin it serves first
    - Freerouting stages 1 and 2 (--stages=2); stage 3 was dropped
    - finish.py: via drills, narrow tracks, copper faults taken up, l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
2026-10-16 Analogue board: Teensy core board labelled, order files for JLCPCB
    - labels.py: block numbers (W1, W2 ...) beside the wiring blocks and names beside the test
    points, on both faces where they fit; output/wiring_map.md lists every block's holes and
    signals and every test point, with 1:1 PDFs of each face to print
    - fab.py run on the routed board: teensy_core_midi/fab/ holds the Gerber zip, JLC BOM and CPL
    (300 placements, 59 part types); the loose Gerbers are ignored
    - finish.py: a closing step adds a direct capacitor-to-pin track where the routed one is over
    4 mm (crossing other nets if need be, never another reference capacitor's); ground vias
    joined only to the plane are removed;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
2026-10-17 Analogue board: design journal, milestone images, routing runs and logs
    docs/analogue_board_journal.md tells how the board was arrived at, wrong turns included, in
    the MOD2 journal's form, as source material for a possible video: thirteen dated turns from
    the spec (14 Oct) to the Teensy order and the Pico board's re-laid top (17 Oct), the errors and
    the pattern behind them, and what came from David looking at the board.
    docs/analogue_board_journal/ holds 28 milestone images (renders from git history, and from the
    trial boards that exist only locally), routing_runs.csv (65 stages and finishing runs) and the
    raw logs behind every figure.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
2026-10-17 Analogue board: the Pico board routes completely
    pico_core_midi (Pico 2 / ESP32-P4, the core set with MIDI) routes with no unconnected item
    and no copper fault, and every IC supply pin within 4 mm of its capacitor. Routed board in
    pico_core_midi/routed_trial/, labels and wiring map, JLC files in pico_core_midi/fab/. Held:
    David orders it after the Teensy board's bring-up.
    What got it there:
    - David's re-laid top: no chip over another on the opposite face (ADC lowered, DAC and CV
    op-amp turned and stacked, DG412s and U504 where nothing is above them, U203 moved out);
    the right-top wiring bank into the right strip's gap; no bus test points; U204 out from
    under the module
    - autoroute.py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
2026-10-17 Analogue board: diagnostic scripts kept; trial routes archived out of the repo
    tools/analogue_board/diag/ keeps the scripts used while routing (DRC summaries, decoupling
    review, where a board keeps failing, header-row crossings, chip-move scoring, KiCad dead-end
    removal) for bring-up and the next board. The routing trial boards are archived outside the
    repo; the journal says where.
2026-10-23 Analogue board: Rev B planning notes
    P4 camera and display I2C (pins 16/17) and the separate-bus plan, a
    standard wiring bank, silkscreen and footprint fixes, items carried over
    from the P4 review.
2026-10-25 Analogue board: Rev B plan for the Pico 2 / ESP32-P4 board
    Panel-first approach and David's six layout rules, a patch.Init()-based
    channel set with two-way CV kept, module USB end down, power header in
    the lower gap, and the pin map: P4 I2C on pins 16/17, CS_595 on pin 20,
    EXP_INT dropped so the pots ADC keeps its own SPI bus (spec 6.1).
2026-10-26 Analogue board Rev B: the Pico 2 / ESP32-P4 board, panel first, fully routed
    Generator: Rev B is its own board, pico_revb (variant.py); the Rev A boards build unchanged.
    - Wiring field: one template level with the deck's cells, one column a side, utility holes in
    the strips' empty positions (wiring.PLAN_REVB); both strips 10HP only.
    - Pin map: the ESP32-P4's own I2C on pins 16/17 to reserved holes (J102); CS_595 on pin 20;
    EXP_INT dropped so the pots ADC keeps its own SPI bus; only module outputs on the P4's
    programmable bank.
    - Six switch inputs; two-way CV kept, one DG412 a side; one fixed CV each way.
    - Floorplan: module 1.2 mm right of centre, power header in the lower gap, the lan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
2026-10-29 Analogue board: journal chapter 14 (Rev B) and the ESP32-P4 bench tests
    The journal gains chapter 14: Rev B laid out panel first, the routing turns from rB1
    to vB, and the variant that routed completely.
    The ESP32-P4 note gains bench tests on David's Waveshare ESP32-P4-WIFI6:
    - the OV5647 camera works;
    - HDMI out works through Olimex's LT8912B at true 1280x720p60 (APLL pixel clock);
    - the live camera goes to HDMI at about 22 frames/s, with lines sometimes jumping
    sideways (likely PSRAM bandwidth).
    What follows for the module: pins 16 and 17 carry the camera's and the bridge's I2C,
    which confirms reserving them. One APLL can't serve both the codec's MCLK and an
    exact video clock, so that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
2026-10-30 Analogue board Rev A: the bring-up plan
    The Teensy boards arrived 2026-10-30. The plan takes the first one from the box to a working
    module in seven stages: look; hand-solder the power header and the Teensy sockets, and cut
    the Teensy's VIN-VUSB pads; cold resistance checks for shorts; a three-second first power
    with the Teensy out; the Teensy in; one block at a time from a serial-menu test program;
    then the hand-fitted H11L1 and the MIDI links.
    There is no bench supply, so the multimeter checks and the three-second first power stand
    in for a current limit. Expected readings come from the netlist and the spec, including
    the two that look like faults and are not: +3V3D's 680 ohm minimum load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
2026-10-30 Rev A bring-up: the stage 6 test program, and blocks 1-5 pass
    firmware/analogue_board_test: a Teensy 4.1 PlatformIO project with one serial
    command per block of the bring-up plan. Only I2C runs at boot; each bus starts
    when its block is asked for. It builds on this arm64 Mac through PlatformIO's
    arm64 GCC (arm64_toolchain.py) and flashes through the Teensy Loader app, as
    the Teensy package's own compiler and loader are x86_64 only.
    The bench, 2026-10-30: every rail in range, the Teensy on 4.72 V, blocks 1-5
    pass (I2C, EEPROM, expander, ADC, DAC through all six switches, within 34 mV
    of the design uncalibrated). Logged in the bring-up plan, with marked-up
    pictures for the test points and wir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
2026-10-30 Rev A log: the test points carry names, not numbers; no maker's mark
    David, 2026-10-30: the silkscreen printed as designed. The plan's TP numbers
    appear nowhere on the board, which prints short net names beside 15 of 27
    test points at 0.8 mm. There is no Eight4aWish name or licence notice either.
    Both go on Rev B's silkscreen list as open items.
2026-10-31 Rev A bring-up: the control deck stage, and the encoder on GIN3 + GIN1
    Stage 8 of the bring-up plan is the first build's deck wiring (the Boy panel with a push
    encoder and TRS MIDI in):
    - the fit agreed on 31 October: the deck built the n8synth way, the board upright;
    - all 24 wires with their pads and holes, named as the bring-up pictures label them;
    - the links made on the deck itself.
    The screen sits in the panel over JPS1 and JPS2, so their pads are borrowed:
    - JPS1 carries the screen's SDA, SCL and 3V3;
    - JPS2 carries the encoder's push and the deck's one ground link.
    No wire runs between the boards outside the strips.
    To shorten the wires, the encoder takes GIN3 and GIN1, the gate in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
2026-10-31 Rev A bring-up: blocks 6 and 7 pass; the Boy2 test focus; MIDI links noted for Rev B
    Blocks 6 and 7 both pass:
    - block 6: the codec returns samples, and the meter shows all three clocks switching;
    - block 7: the gate outputs read 5.0 V high and 0.00 V low in both patterns.
    The plan now tests only what the Boy2 build uses, with no temporary wires. Block 8 moves
    after the deck, where turning the encoder toggles GIN1 and GIN3. Boy2 needs only J101's
    SPARE2 to MIDI_RX link.
    Rev B section 7 notes, for consideration only: the serial pins could reach MIDI through
    solder jumpers that come closed, instead of link holes.
2026-10-31 Rev A bring-up: deck wiring in batches; batch 1, the encoder, passes
    The deck-to-board wires go in seven batches, each tested before the next.
    The encoder counts 4 per detent, clockwise up, and its push reads SW6.
    The test program gains c N V, which holds a CV jack at a voltage for the
    meter (batch 3).
2026-10-31 Rev A bring-up: batch 3, the CV outs, passes; c N V parses its voltage
    Every CV jack metered at its own voltage after one wiring fix on the
    deck (gate3). The outputs read about 1.8% low, alike on all six: gain,
    for pitch calibration later. c N V took the jack number as the voltage
    when typed with a space after c; it now parses both numbers with strtol
    and strtof.
2026-10-31 Rev A bring-up: batch 4's audio outs pass at DC; a V holds them
    The 440 Hz sine read nothing on the meter, so a new command, a V, holds
    both audio outs at a DC level through the waveform's offset (the library
    sends nothing at amplitude 0). +5 V read +4.86 V at both jacks. The
    inputs are still to test.
2026-11-01 Rev A bring-up: batch 6, the screen, passes; block 14 draws on it
    Block 14 drives the 128x64 OLED at 0x3C with page addressing, so it
    suits an SSD1306 or (14 sh) an SH1106: every pixel, then a border and
    a square. 14 d shifts the picture down a row, which showed the screen's
    top row of pixels is dead. MIDI in is wired and waits for a source.
2026-11-01 Rev A: firmware notes for Boy2 and the board, and pointers to them
    docs/analogue_board_reva_firmware.md gathers what a firmware session
    needs: building and flashing on this Mac, the pin map, each chip's
    registers and frames, Boy2's panel-to-channel wiring, the values
    measured on the built module, and what changes when porting Boy. The
    CLAUDE.md, the bring-up plan's status line and the spec's encoder
    requirement now point to it.
2026-11-01 Journal chapter 15, the bring-up and Boy2; the two claude.ai pages kept
    The design journal runs on from the order to the first module: the
    bring-up and Boy2, 27 Oct to 1 Nov, with the bring-up's errors, David's
    bench catches, and a table of the video's moments and what can show
    each one. Its Still open list is brought up to date.
    The wiring map and the Rev B panel plan lived only as claude.ai pages.
    Copies of their final versions are now in docs/, and the docs that
    linked the pages link the copies.
2026-11-01 Rev A firmware notes: correct the Boy port table, add Boy's dropped features
    Checked against eurorack_modules src/teensy_move, its pins.h and spi_bus,
    and the Teensy Expander panel:
    - Boy has four MCP4822s and eight CV outs (pitch and mod for four voices),
    not two: the Expander's pair is selected through its 595's Q6 and Q7.
    - Only gates 1-2, clock and reset are direct pins (40, 38, 39, 37), all
    through 74HCT14 inverters; gates 3-4 are on the Expander's 595.
    - Boy2 has no mod outputs and no voice 4, and Boy's four pots also set the
    FX; the table now says so, with the pitch range each module covers.
    - USB MIDI is Boy's only MIDI input and its link to the Move, so Boy2
    keeps it; it isn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
2026-11-01 Rev A firmware notes: drums 1 and 2, firmware home, Boy2's given job
    David, 2026-11-01:
    - Boy2's two drum jacks are drum1 and drum2, as the panel prints them;
    "drum3" was a leftover from development. The bring-up record keeps its
    old name, and the wiring table says so.
    - Boy2's firmware goes in eurorack_modules and replaces teensy_move; Boy is
    decommissioned once it has taken over.
    - Its given job is the Move companion: three gate and pitch voices, two
    drum triggers, clock and reset. Move audio doesn't come in through it,
    so the line-level gain point is dropped.
    - Boy's chord mode and drone saw little use because its audio path was too
    noisy, not because they weren't wanted; neit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
2026-11-01 Rev A firmware notes: the menu of ideas for the rest of Boy2's Teensy
    The brainstorm of 2026-11-01, with the ideas left out and why, so a later
    session doesn't offer them as new. Nothing in it is decided.
2026-11-01 Rev A firmware notes: Boy2 as a firmware with modes, and mode 2's menu
    David's direction: mode 1 the Move companion, mode 2 a two-input processor
    that starts from Warps and goes further. Records what the board gives modes
    (bidirectional CV jacks as inputs, gate outs, MIDI) and the ideas for mode 2.
2026-11-01 Rev A firmware notes: three modes, with mode 2 a straight Warps port
    David decided: mode 1 the Move companion, mode 2 straight Warps, mode 3
    weirder two-input ideas. Warps has four CV ins, not five (cv_scaler.cc).
    Adds what the port has to settle: sample rate, knobs, patch detection,
    jack order.
2026-11-01 Boy2 is now just Boy; its firmware took over teensy_move
    David, 2026-11-01: the name Boy2 was never used outside these repos, so the
    module is Boy, and the earlier one is the old Boy (teensy_move_old). The
    build records keep a note of the old name.
    The firmware notes also record the decisions of the day: Boy's firmware is
    in eurorack_modules src/teensy_move (env teensy41), with mode 1 built; the
    mode is chosen at power-on and holds for the session; a 2 s hold returns to
    the chooser; the Move can't send CCs; mode 3 starts with spectral morphing
    and sidechain ducking; the Teensy Audio library isn't tied to the audio
    shield; and the SSD1306 library's clkAfter must be 400 kHz.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
2026-11-01 Boy's mode 1 works on the bench
    David flashed it on 2026-11-01: voices, drums, clock and reset, the encoder
    and the chooser all work. TRS MIDI in isn't tried yet.
2026-11-02 Rev A firmware notes: the Warps port settles its open points; PCM3060 datasheet is SLAS533B
    - The codec at 96 kHz: the Teensy Audio library's rate is one constant and
    the PCM3060 takes 256 fS there (SLAS533B p.15, Table 2), so Boy needs no
    I2S driver of its own. The 1 Nov note favoured one; that was wrong.
    - What the hardware-mode straps fix, and what only the serial modes reach.
    - Patch detection from the ADS8688's open-input bias, jack order, levels.
    - The spec and gates.md cited the PCM3060 datasheet as SBAS437. TI's
    document is SLAS533B (the codec review and power.md already said so);
    the values quoted (VDD max 4 V, 150 uA full power-down) are in it.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
2026-11-03 Rev B for the order: six layers routed, MIDI direct, ±10 V CV, named test points
    - MIDI wired straight to the module's UART pins (David); J101 keeps RUN and GND
    - J603, the gate expansion, removed (David)
    - CV outputs at spec §15's ±10 V variant (David): Rf 75k in 0603, divider 15k/20k
    - Ground test points dropped; the rail test points aim at their rail's source,
    keep room for a 1.0 mm name and stay out from under the module (TP209 anchored)
    - labels.py: 1.0 mm test-point names and the board marking line
    - fab.py: SMDIP's rotation offset; the H11L1 would have gone to JLC turned 90°
    - diag/lcsc_footprints.py: every placed part against LCSC's own footprint
    - Four layers tried five ways (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
2026-11-03 Gate review: the RP2350 pad pull-down is 36-113 kΩ, not ≈50k (datasheet Table 1683)
    The conclusion holds: against the 10k pull-up, CS_595 sits at 2.6-3.0 V, above VIH.
2026-11-03 Rev B: the nine 1k output resistors take 0.66 W (Panasonic ERJ-P08F1001V)
    At ±10 V an output patched into a stiff one puts up to ≈0.5 W in its 1k
    series resistor, past the 0.25 W of the plain 1206 (C4410). R321, R328,
    R406-R426 and R517 are now Panasonic's anti-surge ERJ-P08F1001V, C4261071
    (Extended, 0.66 W at 70 °C; Panasonic ERJ P datasheet, 29-Sep-23).
    - parts.py / blocks.py: a resistor entry can carry its JLC class, as CAP does
    - Rev B rebuilt: 0 ERC, netlist, datasheet-pin and decoupling problems; only
    the nine parts' LCSC and JLC fields change
    - Order files: the JLC BOM line moves; the gerbers regenerate identical apart
    from timestamps, so the committed zip stays; routing unt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
2026-11-03 Rev B notes: Health, the gesture module's panel, decided
    David's layout for the faceplate going in the same JLC basket as the board:
    encoder, BTN1, BTN2; X, Y, Z pots; both hands' X, Y, Z outs; audio, RST and
    CLK. Each cell's Rev B channel, the encoder's common on 3.3 V digital, pot
    tops chainable on the deck, and SW4-SW6 left free for footswitches.
2026-11-04 Spec §6.2: an unpatched CV input reads about +0.2 V, not 0 V
    The CV input review (A1) found this in October, and requirement 8 and the bench (+0.206 to +0.209 V) agree, but the signal-flow drawing still said 0 V.
2026-11-04 Visualiser: each analogue-board block's channel 1 on the n8synth breadboard
    For the Boy video's netlist slides. boy_blocks.py writes eleven layouts in the
    tool's own format (layouts/boy_*), so they open in the viewer, and checks each
    two ways: validate_layout.py, and every pin's breadboard node against Rev A's
    KiCad netlist, so a row joining the wrong pins fails and so does a missing wire.
    Drawn, not built: the board went from netlist straight to PCB. Parts that only
    come in SMD sit on a breakout at their real pin count.
2026-11-04 Rev A firmware notes: CV in from another module works
    By ear, V/oct into Warps' internal oscillator (David, 2026-11-04). Tracking and calibration are for later.
2026-11-04 diag/jlc_placement.py: check JLC's placement, order files and preview
    The order files against the routed board and schematic, rotation offsets
    against a built board, then JLC's preview pictures: pin 1 marks, diode
    polarity, enlarged pictures of each part.
    Corrects the Rev B note: the routed board carries no LCSC numbers, so the
    earlier check of them against it tested nothing. They're now checked against
    the schematic, and all match. David confirmed the placement at JLCPCB.
2026-11-04 Layout tool: MIT, a net-by-net check, and the LPG's two wires put right
    tools/visualizer is now MIT. layouts/boy_* draw the analogue board, so they
    keep its CC BY-SA 4.0.
    check_netlist.py checks any layout against a netlist, following its wires. It
    agrees with boy_blocks.py on all eleven Boy blocks, against Rev A's KiCad
    netlist.
    It found a real fault in layouts/lpg.json: the wires for VC_A_R and VC_B_R pin 2
    each sat one row off, grounding LED_CHAIN_MID_A and V_x_B. cross_check_nets.py
    follows parts, not wires, so never saw them. Both now land on pin 2's row, as the
    placement doc's row table has it.
    validate_layout.py: panel wires are now read from the right fields, so they're
    checked fo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
2026-11-11 Noise test: method, record and analyse tools
    Five boards (the old Boy, Boy Rev A, stock and OLED patch.inits, the Seed module), screen off,
    still and redrawing, decided with David 2026-11-11. analyse.py checked on a synthetic run with
    known levels before any recording.
2026-11-11 Noise test: the ES-10 control (-96.2 dB A-wt), and IN 3 recorded with every board
    The interface's floor is only 4 dB under the earlier patch.init figure, so record.py now records the
    empty ES-10 IN 3 beside each board and analyse.py takes it out of the output-only figure.
2026-11-11 Noise test: the stock patch.init recorded; sync detection robust to the tone
    The first real run's 997 Hz tone, at full level and scaled to volts, leaked past an absolute
    1500 Hz threshold and was taken for the sync. Frames now need 1500 Hz within 10 dB of the loudest
    sync and 12 dB over 997 Hz.
2026-11-11 Noise test: all five boards recorded and analysed
    Rev A is the quietest input-to-output (-93.0 dB A-wt, its input ~5 dB quieter than the patch.init's);
    the Seed module's screen costs 6-11 dB (a 6.2 kHz line at -80 dB with the panel powered, redrawing
    or not), and its hum is ~27 dB over the patch.inits'.
2026-11-11 Noise test: the gains, and the boards compared per signal in
    The patch.init has +2.9 dB from input to output, Boy and the Seed unity; per signal in, Boy Rev A's
    path is on a par with the patch.init (1.3 dB behind, far below hearing), its input stage the quietest.
    Boy and the Seed have left and right swapped; the old Boy's left input is miswired. A sync now needs
    0.05 V, so noise can't pass for one.
2026-11-11 Noise test: the Teensy Chaos, -85.5 dB A-wt screen off, about 11 dB worse with it on
2026-11-13 analogue_board_revb: the two Rev B boards are Health and Wealth; Boy is Rev A only
    Claude-Session: https://claude.ai/code/session_01RRjgui8Tk8PUz6o4zhu866
2026-11-13 Rev B names are working names: David hasn't decided between Health and Wealth and Boy's name for every board
